takushio2525/2026-hackathon-team23/docs/src/content/docs/intro/overview.md

---
title: プロジェクト概要
description: タクトーンの目的、構成、現在できること
---

## 一言でいうと

**指揮棒を振る速さでテンポを操作し、5台の楽器マイコンとPCで合奏するシステム**です。
音楽経験がなくても、指揮を振るという直感的な操作で演奏に参加できます。

## 現在の構成

- 指揮者 `node_01`：XIAO ESP32-S3 Sense + GY-521（MPU6050）
- 金管 `node_02〜05`：Arduino UNO R4 WiFi × 4
- ドラム `node_06`：Arduino UNO R4 WiFi × 1
- PCアプリ：Processing 4 + Minim
- 曲：かえるのうた（32拍）を4声で輪唱、ドラムは56拍の全サイクルを担当

## できること

1. IMUの向きに依存しにくい拍検出
2. 指揮の拍間隔からBPMを推定し、演奏速度へ反映
3. UDPマルチキャストとマスタ時刻指定による同期演奏
4. 自由演奏と、100 BPMを維持して得点を競うゲームモード
5. 倍音JSONを使った金管の加算合成と、専用ドラム合成
6. 指揮者の状態に追従するメニュー・演奏・結果画面

## 評価と現在地

目標は、楽器間の発音タイミング差を20 ms以内に抑えることです。最終構成では中央値 **7 ms**、平均 **10.8 ms** を確認しました。一方で、デバイス内部の周期的な停止と見られるまれな外れ値（最大65 ms）も確認しています。

通信は「生の遅延が短いか」ではなく、**予約した発音時刻までに届くか**で評価します。予約に間に合わない受信は、対策前の45.4%から最終構成では3.1%まで減りました。詳しい数値と限界は[評価・検証](/guide/verification/)にまとめています。

## 次に読む

- 操作の流れ：[演奏体験と状態遷移](/system/experience/)
- 技術構成：[システム全体](/system/overview/)
- 実際に動かす：[クイックスタート](/intro/quickstart/)
