takushio2525/2026-hackathon-team23/work/shiozawa/work-0422/design_draft/sections/14_limitations.md

# 14. 制限事項・今後の課題

## 14.1 本原案で未確定の項目

実機検証を経ないと値を固定できない項目は、設計書上では「候補 + 推奨 + 初期値」で記し、
実装フェーズで確定させる。確定作業は対応するタスク（第 7.2 章）で実施する。

| 項目 | 初期値 | 確定タイミング | 担当 |
|---|---|---|---|
| IMU サンプリング周波数 | 200 Hz | TP-6 後 | 塩澤 |
| LPF カットオフ（α） | 0.1 | TP-1 前の実機キャリブレーション | 塩澤 |
| 拍検出閾値（g） | 1.8 g | TP-1 | 塩澤 |
| 拍不応期（ms） | 250 ms | TP-1 | 塩澤 |
| BPM EMA α | 0.3 | TP-4 | 塩澤 |
| CTRL 送信周期 | 50 ms (20 Hz) | TP-2, TP-6 | 塩澤 |
| BEAT 冗長化数 | 1（初期） | TP-5 | 塩澤 |
| SelfRun 発動タイムアウト | 1500 ms | TP-5 | 塩澤 |
| WiFi AP（SSID/PASS） | プレースホルダ | 運用フェーズ（チーム合意） | チーム |
| 楽譜データ（具体的内容） | 未作成 | 曲選定後（チーム合意） | チーム |
| PC の IP アドレス | プレースホルダ | 実機合わせ | 塩澤 + 梅澤 |

## 14.2 既知のリスク

| # | リスク | 影響 | 緩和策 |
|---|---|---|---|
| L-1 | IMU 装着方向のばらつきで拍検出が不安定 | 拍検出精度低下 | ノルム方式採用で方向依存を減らす（11.5）。Calibrating 状態で重力方向を学習する拡張余地を残す |
| L-2 | WiFi AP の干渉で遅延増大 | 同期誤差悪化 | 演奏時は 2.4 GHz 帯の干渉の少ない運用を検討。静的 IP オプションも用意（10.3.1） |
| L-3 | パケロス率が想定超過 | 演奏破綻 | BEAT 冗長送信 + SelfRun 自走で救う（10.3.7, 12.4） |
| L-4 | 内蔵 IMU の熱ドリフト | 長時間演奏で閾値ずれ | 演奏は 5 分程度を想定。長時間運用は本プロジェクト対象外 |
| L-5 | UNO R4 WiFi の `WiFiS3` ライブラリ仕様変更 | ビルド失敗 | PlatformIO のバージョンを `firmware/README.md` に固定明記 |
| L-6 | 4 ノード同時結合の環境が揃うまでの試験遅延 | M5 遅延 | T12 / T15 の段階で単体・ペアを先行検証し、リスクを前倒しで潰す |

## 14.3 本設計書のスコープ外 / 今後検討

- **Processing 側の音色合成**（梅澤担当）— NOTE パケット仕様のみ本書で規定
- **楽譜の編曲・選定** — チーム共同で Week 4 までに決定
- **エンタメ要素（LED・指揮棒装飾等）** — 必達機能完了後にチームで検討
- **発表・デモ台本** — 本設計書のスコープ外
- **事後課題（成果報告書）** — プロジェクト終了時に別途作成
