takushio2525/2026-hackathon-team23/meetings/0422_2回/第2回議事録_AI要約byClaude.md

# 第2回ハッカソン議事録 AI要約（Claude 生成）

> **このファイルについて**
> このドキュメントは AI（Claude）が正規議事録 PDF（`23_第2回議事録_24G1075.pdf`）と
> 同ディレクトリの `memo` ファイルを読み込み，内容を解釈して再構成した **要約・補足ドキュメント** です．
> 正規の議事録は PDF 側を参照してください．
> 抜けている決定事項があれば，議事録を直接書き直さず `docs/decisions/` に ADR として残す運用です
> （`meetings/README.md` 参照）．

## 基本情報

- **会議名**: 第2回ハッカソン
- **チーム**: 23班
- **日付**: 2026年4月22日（火）12:00 – 14:00
- **場所**: 7 号館 3 階 732 教室
- **目的**: **案の一本化**
- **記録者**: 地曵 賢人
- **出席者**: 全員出席
  - 24G1038 片岡 聖
  - 24G1075 地曵 賢人
  - 24G1131 御代川 稜
  - 25G1021 梅澤 颯太
  - 25G1053 齋藤 翔太
  - 25G1065 塩澤 匠生

## 会議の位置づけ（AI 解釈）

第1回で「Arduino 5 台で指揮者 + 楽器」という大枠を決めた後，**各メンバーが事前課題として具体案を持ち寄り**，
本会議でそれらを突き合わせて **一本の方針に統合する** ことがゴール．
最終的に以下が確定した：

1. **構成の確定**：指揮棒 + 楽器
2. **エンタメ性の確定**：指揮を振る体験を主軸に置く
3. **目的・ゴールの言語化**：外的要因によらず音楽未経験でも演奏できる
4. **成果物範囲の明確化**：エッジ検出 + UDP 拍送信，同期誤差 20 ms 以内
5. **MOE（有効性指標）の設定**：同期誤差 20 ms 以内 / 音階の正確性
6. **WBS 原案の整理**：担当者を 100 系（入力）/ 200 系（出力）/ 300 系（通信）に分解

---

## 1. 事前課題の共有と構成の確定

各メンバーが持ち寄った「基本構造案」を並べて議論．

### 1-1. 基本構造（持ち寄り案）

| 提案者 | 提案内容 |
|---|---|
| 御代川 | LED マトリクスで音階を表示 |
| 片岡・梅澤・齋藤 | 速度センサを用いた指揮者システム |
| 地曵 | 有線通信 |
| 塩澤 | 1 台指揮棒 + 4 台楽器の構成で IMU でエッジ検出，UDP 通信で同期 |

**→ 決定**: **「指揮棒 + 楽器」の構成で確定**
（= 塩澤案をベースに，他メンバーのアイデアを肉付けしていく方向）

### 1-2. エンターテイメント性

| 提案者 | 提案内容 |
|---|---|
| 塩澤 | ゲーム性を持たせる（例：テンポキープでスコア獲得） |
| 塩澤 | 演奏モードとゲームモードの切り替え |
| 御代川 | 指揮棒を LED 発光させる（加速度で光度の強弱） |

**→ 決定**: **「指揮を振る体験」を主なエンタメ性として据える**．
（ゲームモード等の発展は主軸の上に乗せる拡張として扱う）

---

## 2. 目的とゴールの決定

### 2-1. 目的（Purpose）

各メンバーの言い分を集約：

| 提案者 | 提案した目的 |
|---|---|
| 塩澤 | 演奏に人間が介入する |
| 地曵 | 音楽経験の有無に関係なく容易に演奏（テンポ変更やボリューム増減）できる |
| 梅澤・齋藤 | 時間帯や外音などに作用されず安定して演奏できる |
| 片岡 | 場所にとらわれず，音楽未経験でも演奏できる |

**→ 集約された目的**:
**「外的要因に作用されず，機器さえあれば（音楽未経験でも）演奏できること」**

> 💡 AI 補足: `memo` ファイルには「時間帯や天候やネットワークなどのネット環境がなくても → 明るさなどの条件がいらない」
> という書き込みがあり，**照明条件やネット環境に依存しない設計**が重視されている．
> これは **カメラベースの画像認識を使わない（= IMU ベースにする）** 判断の根拠になっている．

### 2-2. ゴール（Goal）

- ユーザーが指揮を振る**テンポを変えた時に演奏速度も変えられる**，簡単に演奏できること．
- 塩澤の補足：**指揮の振り方が乱雑（どんなモーション）でもテンポを検出できる**．
  **誤差 20 ms 以内なら同期できているとする**．

---

## 3. 成果物の範囲の明確化

プロジェクトの**スコープ定義**．以下 4 点に絞る：

1. **マイコンを振ってエッジ検出**し，**WiFi（UDP）で拍を送信**する．
2. **同期誤差 20 ms 以内**を満たす．
3. **倍音データ**などを元に**根拠を持った音色作り**を行う．
4. **どの方向に振っても拍を検出可能**であること（振り方に依存しない）．

---

## 4. MOE（有効性指標）の設定

システムが目的を達成しているかを測る指標：

| # | MOE | 基準 |
|---|---|---|
| 1 | 同期誤差 | **20 ms 以内** |
| 2 | 音階の正確性 | （基準は今後詳細化） |

> 💡 AI 補足: `memo` には「ユーザーがテンポ変更したことが（システムに）認識されるか」
> 「どんな振り方でも自分の思いどおりになるか（→ 誰かに演奏してもらって感想をもらう）」といった
> **ユーザビリティ観点の検証方法**が示唆されている．V&V 定義の際に取り込みたい．

---

## 5. 次回までの実施内容（次回までの宿題）

- **各担当が，自分の担当箇所の基本設計・詳細設計の原案を作成する**．
- 参考にするのは会議内で共有された **表 1（WBS）**（下記）．

## 6. 次回実施予定

次回（第3回）でやること：

- **FBS, PBS, WBS, MOP, V&V, TPM, 役割分担**のチーム内確認 → 修正 → 確定
- **WBS と役割分担をもとにスケジュール作成**
- **基本設計と詳細設計のレビュー**

---

## 付録 A：WBS 原案（表1 の再掲）

| 時間的フェーズ | 番号 | 要素成果物 | 活動タスク | 担当 |
|---|---|---|---|---|
| **100 入力装置** | 110 | 回路 | 111 回路図の作成 | 齋藤 |
|  |  |  | 112 必要な機材購入 | 梅澤 |
|  |  |  | 113 指揮用と楽器用 Arduino の通信 | 塩澤 |
|  |  |  | 114 Mac と Arduino の通信 | 塩澤 |
|  | 120 | 指揮棒 | 121 加速度センサと Arduino の連携 | 梅澤 |
|  |  |  | 122 加速度のピーク検出 | 齋藤 |
|  |  |  | 123 指揮棒の作成 | 齋藤 |
| **200 出力装置** | 210 | スピーカー | 211 回路の作成 | 塩澤 |
|  |  |  | 212 音の作成 | 塩澤 |
|  |  |  | 213 Processing のコード作成 | 塩澤 |
|  | 220 | 指揮棒の先端 LED | 221 回路図の作成 | 梅澤 |
|  |  |  | 222 LED の入手 | 齋藤 |
|  |  |  | 223 光らせるコードの作成 | 塩澤 |
| **300 通信システム** | 310 | UDP の実装 | 311 コード作成 | 塩澤 |
|  |  |  | 312 UDP の環境テスト | 梅澤 |
|  |  |  | 313 データの送信確認 | 齋藤 |
|  |  |  | 314 遅延の計測 | 梅澤 |

> 💡 AI 観察: **片岡・地曵・御代川の WBS 上の明示的な担当タスクが無い**．
> 第1回で議事録ローテーション（御代川 → 地曵 → 片岡）が決まっていることから，
> 記録・進行管理側に寄っている可能性はあるが，**次回（設計レビュー回）で担当の空白を
> 埋める確認が必要**と思われる．

## 付録 B：図の概要

- **図 1 FBS 原案**: トップに「ハッカソン2」，その下に「Arduino オーケストラ」「指揮棒を振る速度に合わせて
  BPM を変更するシステム」．機能分解として「楽器（パーカッション・金管・木管）」「指揮棒（速度変更・音の大きさ）」
  「旋律（主旋律・リズム）」といった機能が並ぶ．
- **図 2 PBS 原案**: 「Arduino オーケストラ」配下に「出力装置」「入力装置」「通信システム」の 3 系統．
  出力装置 = Processing / スピーカー / LED / 音色作り / 楽譜，入力装置 = 指揮者 / 加速度センサ / 加速度の大きさ / ピークの周期，
  通信システム = 回路 / Arduino / WiFi / UDP．

---

## AI による総括

**第2回で決まった本プロジェクトの輪郭**は以下の 1 行にまとめられる：

> **「指揮棒（加速度センサ付き Arduino）を振ると，UDP で 4 台の楽器 Arduino に拍が送られ，
> 20 ms 以内の同期で BPM が追従するアンサンブル演奏システム」**

残る大きな論点（第3回に持ち越し）は：

1. **役割分担の空白**（片岡・地曵・御代川のタスク配置）
2. **音階の正確性 MOE の具体値**
3. **V&V 計画**（どうやって「どんな振り方でもテンポが取れる」を検証するか）
4. **FBS / PBS / WBS / MOP / TPM の最終版**
5. **全体スケジュール（ガント）の起票**
