takushio2525/2026-hackathon-team23/meetings/0429_3回/事前課題共有/review_mamezi_御代川稜.md

# レビュー: `mamezi_御代川稜.pdf`（ハッカソン 〜計画書と設計書〜）

**評価対象**: `mamezi_御代川稜.pdf`（14 ページ、Version x.x、2026-04-28）
**担当範囲**: WBS 表上では設計フェーズに直接の担当タスクは無い（24G 勢は「議事録持ち回りと 300 テストフェーズ以降の実機検証・発表準備に合流」と `meetings/0422_2回/wbs_table/wbs_table.md` で明記）。本書はその前提のもと、提出用計画書テンプレート（`work/shiozawa/work-0422/提出用計画書/plan_template.tex`）の章立てを丸ごとなぞった個人ドラフトとして提出されている
**評価基準**:
- マネジメント計画書: `references/lectures/ハッカソン２/マネジメント計画書-ルーブリック評価 (1).pdf`（§1〜§6）
- システム設計書: `references/lectures/ハッカソン２/システム設計書-ルーブリック評価 (1).pdf`（§7 で別途評価）
**レビュー作成日**: 2026-04-29

---

## 1. ルーブリック評価サマリ

本書はマネジメント計画書テンプレートの章番号（1.1 概要 / 1.2 スコープ / 1.3 作業計画 / 1.4 V&V / 1.5 資源調達 / 1.6 リスク管理）を **目次・章見出しまでは完全になぞっている** が、**1.1.1〜1.1.3 と参考文献以外、1.2〜1.6 の各節は章タイトルのみで本文が空** という骨格状態にある。第 2 章（基本設計）と第 3 章（詳細設計）は別途記述があるため、各ルーブリック項目の評価は「計画書の本文が空 → D」「設計書側で代替されている → C 救済」の混合になる。

| 評価項目 | 配点 | 評価 | 根拠 |
|---|---|---|---|
| プロジェクトの概要（題目・目的・独自性・参考文献） | 3 | **B (2)** | §1.1.1 題目「指揮用 Arduino から指揮をするオーケストラ」、§1.1.2 目的（外部条件に左右されず音楽未経験でも演奏できる、6 つの課題を箇条書き）、§1.1.3 既存技術（テルミン・Wii Music）と独自性（複数マイコンによる分散演奏）、参考文献 2 件まで揃う。ただし参考文献 [2] Wii Music は公式サイト URL のみで論拠としては薄い |
| 成果物の対象範囲と機能（成果物・対象範囲／非対象範囲・FBS・PBS・対応関係） | 3 | **C (1)** | §1.2.1〜§1.2.5 が **全て章タイトルのみで本文なし**。第2章 §2.1 に FBS 図、第3章 §3.1 に PBS 図と必要機材一覧（表 3.1）はあるが、計画書セクション §1.2 を参照すると空白。FBS と PBS の対応関係も明示なし |
| 作業計画と役割分担（WBS・8/80 ルール・アローダイアグラム・クリティカルパス・スケジュール） | 3 | **D (0)** | §1.3.1 WBS、§1.3.2 アローダイアグラムとクリティカルパス、§1.3.3 役割分担、§1.3.4 ガントチャート、いずれも章タイトルのみで本文なし |
| 検証と妥当性の確認（システム／結合／単体テスト・MOP・TPM） | 3 | **B (2)** | §1.4.1〜§1.4.7（MOE / MOP / システム・結合・単体テスト MOP / TPM）はすべて章タイトルのみだが、第3章 §3.3 で単体（入力／ロジック／出力モジュール別）・結合・タイマ制御・システムテストの方針が記述されている。MOP・TPM の定量値は皆無のため B 止まり |
| 実行可能性と客観性 | 3 | **D (0)** | §1.5 資源・調達管理、§1.6 リスク管理が章タイトルのみで本文なし。スケジュール記述もなく、必要機材表（§3.1 表 3.1）の調達主体・期限も未記述。実機 KXR94-2050 がアナログ出力（5V フルスケール）の問題点（後述）にも触れていない |
| **合計** | 15 | **5 / 15** | テンプレートの **骨格のみで中身が空** という典型的な「下書きの提出」状態。記述された §1.1 と第2章・第3章は B 相当だが、計画書の核（スコープ・WBS・V&V・リスク）が空白なので合計点は伸びない |

**総合評価**: 中位ランク（C〜B 境界）。提出用計画書テンプレートに沿った正しい章立てを採っている点は他の提出物より優れているが、**§1.2〜§1.6 の本文を一切埋めていない** ため、計画書としての主要な評価項目で得点できていない。第3回ミーティングで章タイトルだけ残っている節を埋めれば、合計 11〜12 / 15 まで上げる余地は十分にある。

---

## 2. 良かった点

### 2.1 マネジメント計画書テンプレートの章立てを完全に踏襲している

- 目次（p.3〜p.4）が **§1.1 概要 / §1.1.1 題目 / §1.1.2 目的 / §1.1.3 既存技術と独自性 / §1.2 スコープ / §1.2.1 成果物 / §1.2.2 対象範囲・非対象範囲 / §1.2.3 FBS / §1.2.4 PBS / §1.2.5 FBS と PBS の対応関係 / §1.3 作業計画 / §1.3.1 WBS / §1.3.2 アローダイアグラム / §1.3.3 役割分担 / §1.3.4 ガントチャート / §1.4 V&V / §1.4.1 MOE / §1.4.2〜§1.4.5 各層の MOP / §1.4.6〜§1.4.7 TPM / §1.5 資源・調達管理 / §1.6 リスク管理** と、ルーブリック 5 項目を網羅する正しい章立て。
- 他の事前課題（地曵 PDF / 片岡 PDF）はマネジメント計画書としての章立て自体が無く、本書の構成は最も計画書ルーブリックに対応している。中身を埋めれば最も高得点を狙える土台。

### 2.2 §1.1.2 プロジェクトの目的と課題列挙が具体的

- ADR-0007 の目的「外的要因に作用されず、機器さえあれば（音楽未経験でも）演奏できる」と整合した記述で、6 つの課題（指揮動作の正確検出 / リアルタイム反映 / 誤検出防止 / 経験不問の操作性 / 視覚的状態提示 / 環境非依存）に分解されている。
- 各課題に「なぜなら〜である」と理由付きで書かれている点は、ルーブリック A 要件「技術的・社会的課題が参考文献を交えて十分に記述されている」に近い水準。

### 2.3 §1.1.3 独自性の主張が成立している

- **「複数マイコンによる分散演奏と、身体動作によるリアルタイム指揮制御を両立するシステム」** という独自性の主張は、テルミン（単機・身体動作）／Wii Music（単機・コントローラ動作）と比較して立っており、論理的に矛盾がない。
- 既存技術 2 件（テルミン論文・Wii Music 公式）との対比軸も明示されている。

### 2.4 §3.2.1 関数設計のモジュール分割が EMA と整合

- §3.2.1 表「関数名 / 機能」の `SensorModule:update()` / `TempoModule:update()` / `NetworkModule:update()` / `SoundModule:update()` / `LedModule:update()` / `ModuleTimer:isReady()` / `setup()` / `loop()` という命名は、`firmware/common/lib/` の Embedded-Module-Architecture（ADR-0005）と整合。
- 「保守性・再利用性・役割分担の明確化を目的として、入力・ロジック・出力の 3 フェーズ構成でソフトウェアを設計する。各機能は独立したモジュールとして実装し、共有データを介して連携する。周期処理にはタイマ制御を用い、`delay()` によるブロッキング処理は行わない」（§3.2 冒頭）は、塩澤 PDF §1.2.4 / §2.4.1 と完全に同じ思想。

### 2.5 §3.3 テスト設計が階層化されている

- 単体テスト（§3.3.1）を入力・ロジック・出力の 3 モジュール別に分けて、それぞれにテスト方針（境界値・条件分岐網羅・形式とタイミング検証）を書いている。
- 結合テスト（§3.3.2）／タイマ制御テスト（§3.3.3）／システムテスト（§3.3.4）と階層も適切。`wbs_table.md` の 311-337 と直接マップできる粒度。

---

## 3. 改善・確認すべき点

### 3.1 【最重要】§1.2〜§1.6 の本文が全て空である

本書最大の問題。p.4 を見ると、§1.2 から §1.6 にかけて以下が **章タイトルだけで本文なし**:

- §1.2.1 成果物
- §1.2.2 プロジェクトの対象範囲と非対象範囲
- §1.2.3 機能分解構造 FBS
- §1.2.4 製品分解構造 PBS
- §1.2.5 FBS と PBS の対応関係
- §1.3.1 作業分解構造 WBS と管理番号
- §1.3.2 アローダイアグラムとクリティカルパス
- §1.3.3 役割分担
- §1.3.4 ガントチャート
- §1.4.1 プロジェクトの成果物に対する有効指標 MOE
- §1.4.2 有効指標 MOE に対応する性能指標 MOP
- §1.4.3 システムテストで評価する性能指標 MOP
- §1.4.4 結合テストで評価する性能指標 MOP
- §1.4.5 単体テストで評価する性能指標 MOP
- §1.4.6 プロジェクト中に監視する技術性能指標 TPM
- §1.4.7 プロジェクト中に監視する指標 TPM
- §1.5 資源・調達管理
- §1.6 リスク管理

これは **マネジメント計画書ルーブリック 5 項目のうち 3 項目（成果物の対象範囲・作業計画・実行可能性）の評価軸が事実上書かれていない** ことを意味する。第3回までに最低限以下を埋める必要がある:

| 節 | 埋めるべき内容（最小ライン） |
|---|---|
| §1.2.1 成果物 | リポジトリ / ファームウェア / 報告書 / デモ動画 など、提出物単位の列挙 |
| §1.2.2 対象範囲・非対象範囲 | ADR-0007 の「実装する範囲（4 項目）」をそのまま転記し、非対象（照明同期・スマホ連動など）を併記 |
| §1.2.3 FBS | §2.1 の FBS 図に機能 ID（F1〜）を付与して再掲 |
| §1.2.4 PBS | §3.1 の PBS 図に部品 ID を付与して再掲 |
| §1.2.5 FBS-PBS 対応 | F1 → どの PBS 部品で実現、の表 1 つ |
| §1.3.1 WBS | `meetings/0422_2回/wbs_table/wbs_table.md` の WBS 表をそのまま転記 |
| §1.3.2 アロー / クリティカルパス | 113 → 114-115-116-117 → 121-130 → 200 → 300 のような粗い依存図 1 つ |
| §1.3.3 役割分担 | 24G 勢（議事録 + 300 以降合流）／ 25G 勢（設計・実装）の表 |
| §1.3.4 ガントチャート | 4/15 〜 7 月末までの週単位の予定 |
| §1.4 V&V | ADR-0006 の MOE = 20 ms、塩澤 PDF §1.1.2 の MOP-1〜MOP-8、TP-1〜TP-7 を転記 |
| §1.5 資源・調達 | Arduino UNO R4 WiFi × 5 台、3 軸センサ、PC（Mac）、USB ケーブルの調達主体・期限 |
| §1.6 リスク | WiFi ジッタ・センサ精度・Mac × 4 台の手配難・課題曲未決の 4 つを最低限 |

### 3.2 【重要】参考文献 [2] Wii Music の論拠が弱い

- §1.1.3「Wii Music では、コントローラの動作から拍を検出し、音楽のテンポを制御している」と書かれているが、**Wii Music は実際にはテンポ検出ではなく振り動作のタイミングに合わせて事前に決められた音符を再生する仕組み** で、本書の指揮・テンポ追従とは挙動が異なる。
- 引用 [2] が公式サイト URL のみであることに加え、引用文の事実関係も精査されておらず、ルーブリック A 要件「参考文献を交えながら十分に記述」を満たしにくい。
- 学術論文側（[1] 川合・伊藤「非接触型電子楽器の開発を通じたサウンドデザイン」, 東京工科大学メディア学部, 先端芸術音楽創作学会会報 Vol.14 No.1 pp.14-19, 2022）は適切な引用形式。これに加えて Wii Music の代わりに以下のような既存研究を追加すると独自性の主張がさらに強くなる:
  - VirtualConductor（バーチャル指揮者システム）の論文
  - 加速度センサベースの拍検出に関する MIR 系論文
  - PTP / IEEE 1588 / NTP の時刻同期に関する文献

### 3.3 【重要】§3.1 必要機材表の KXR94-2050 が ADR と整合しない

- 表 3.1「必要機材一覧」で **「3 軸加速度センサ KXR94-2050、1 個」** と記述。
- KXR94-2050 は **アナログ出力（電源 5 V、出力レンジ 0.6V〜4.4V）** の加速度センサで、Arduino の ADC（10bit、0〜5V）に直結する想定。一方、塩澤 PDF §1.3.1 / §2.2 と既存議事録は **MPU6050（I2C 接続、±2g/±4g/±8g/±16g 切替、6 軸 IMU）** を採用している。
- KXR94-2050 を採用するなら以下のリスクを §1.6 に書く必要がある:
  1. **アナログ出力 → ADC 変換のノイズ**（MPU6050 の I2C デジタル出力より精度が劣る）
  2. **3 軸のみ**（角速度ジャイロが無いため、塩澤 PDF §2.4.2.4 の「強い振り検出」フォールバック条件が成立しない）
  3. **ADR-0003「指揮者は IMU でジェスチャ」** と整合させるなら 6 軸が望ましい
- 第3回で「センサは MPU6050 / KXR94-2050 のどちらを採用するか」の合意が必要。
- また数量「1 個」は指揮棒ノード 1 台分のみで、楽器ノード 4 台にはセンサ無し（楽器側は LED マトリクスのみ）という構成として正しいことを明示すべき。

### 3.4 §1.1.1 の題目がルーブリック A 要件にやや届かない

- 題目「**指揮用 Arduino から指揮をするオーケストラ**」は、課題（指揮）と技術（Arduino）と目的（オーケストラ）のキーワードを含んでいる点でルーブリック B 相当。
- ただし「指揮用 Arduino から指揮をする」が同じ語の繰り返しになっており、A 要件「過不足なく的確に表現した題目」としては冗長。
- 例: **「Arduino と加速度センサを用いた指揮ジェスチャによる分散電子オーケストラの実現」** のように、技術（Arduino + 加速度センサ）・課題（指揮ジェスチャ検出）・目的（分散電子オーケストラ）を 1 文で揃えるとルーブリック A に近づく。

### 3.5 §2.1 FBS 図が分解粒度として浅い

- §2.1 の FBS 図は 3 階層（最上位「指揮棒を振る速度に合わせて BPM を変更するシステム」 → 第 2 階層「演奏 / 指揮棒 / 旋律」 → 第 3 階層「金管楽器 / パーカッション / 木管楽器 / 速度変更 / 音の大きさ / 主旋律 / リズム」 → 第 4 階層「同じタイミング / 楽譜を元に演奏」）と分解されているが、以下の問題がある:
  - **「指揮棒」を入力インタフェースと位置づけながら、指揮棒の機能（拍検出・テンポ算出・送信）が分解されていない**
  - **「木管楽器」が登場するが、ADR-0004 / 塩澤 PDF / WBS では金管 + ドラム** で確定済み。木管は範囲外
  - 塩澤 PDF §1.1.1 の F1〜F5（指揮情報抽出 / 同期配信 / 楽譜進行 / 音色合成 / 共通基盤）と粒度が揃わない
- ルーブリック A 要件「FBS と PBS が機能と部品に適切な粒度で分解されており、対応関係が明確に示されている」を満たすには、**機能 ID（F1〜）と部品 ID を付与し、対応表 1 つで一覧化** すべき。

### 3.6 §3.1 PBS 図と FBS 図の対応関係が示されない

- §2.1 FBS 図と §3.1 PBS 図がそれぞれ独立しており、どの機能がどの部品で実現されるかの対応表（FBS-PBS 対応表）が無い。
- ルーブリック A 要件の核は「FBS と PBS の対応関係が明確」なので、表 1 行 = 1 機能の単純なマッピング表を §1.2.5 に追加するだけで C → B / B → A に上がる。

### 3.7 第3章 §3.3「テストの設計」と §1.4 V&V の重複・整合性

- §3.3 単体（入力・ロジック・出力）／結合／タイマ制御／システムの 4 階層は良いが、これらに **対応する MOP（合否基準の数値）が一切ない**。
- 例えば §3.3.4 システムテスト「最終的に実環境においてシステム全体の動作確認を行う。長時間の連続動作による安定性の確認や、入力異常などを想定した異常系テストを実施し、実運用に耐えうることを検証する」は **何分連続動作するか／何 % のパケロスを入れるか** の数値が無い。
- ADR-0006 の MOE = 20 ms、塩澤 PDF §1.1.2 の MOP-1〜MOP-8、`wbs_table.md` の TP-1〜TP-7 を §1.4 に転記すれば一気に B 評価以上になる。

### 3.8 §3.4 AI 利用について — 申告内容の粒度

- 「文章構成、頭の中のアイデアを箇条書きにし、その内容の要約、、や。や語尾の統一のために使用」という記述は、本リポジトリ `work/shiozawa/ai_declaration/` 配下のテンプレに沿って **どのモデル（ChatGPT / Claude）を、どの章のどの粒度の作業で利用したか** まで具体化する必要がある。「、や。の統一」と「文章構成」は介入度が大きく異なるので分けて記述する。

### 3.9 細かい指摘

- p.6 §2.3 状態遷移図 — 図 2.4 のキャプションが「**本プロジェクトのハードウェアの状態遷移図**」となっているが、図の中身はシーケンス図（加速度センサ → 指揮用 Arduino → 楽器用 Arduino → Processing の時系列）に見える。状態遷移とシーケンス図は別物なので、キャプションを「シーケンス図」に直すか、状態遷移図（Initialization / Sync / Ready / Playing / Stop など）を別途追加する。
- p.7 §3.1 「2.1 は本プロジェクトの PBS 図である」 — 図番号が 2.1 と書かれているが、実際の図番号は 3.1。番号誤記。
- p.8 §3.2.1 関数設計表 — `setup()` / `loop()` は Arduino 標準関数だが、`SensorModule:update()` 等の `:` は C++ 構文ではなく `::`（スコープ解決演算子）が正しい。`SensorModule::update()` に修正。
- 表紙の Version `x.x` は提出版なら `0.1` 等の確定値に。

---

## 4. リポジトリ資料との整合性

| 観点 | リポジトリ側 | 本書 | 整合 |
|---|---|---|---|
| プロジェクトの目的 | ADR-0007: 外的要因に作用されず音楽未経験でも演奏できる | §1.1.2 でほぼ同じ記述 | OK |
| 5 台構成 | ADR-0004 ✅ | §3.1 表 3.1 Arduino UNO R4 WiFi × 5 台 | OK |
| 24G 勢の担当範囲 | `wbs_table.md`「議事録 + 300 以降合流」 | 計画書全章を独自に書いた | △ 役割再定義が必要 |
| センサ | ADR-0003 / 塩澤 PDF: MPU6050（I2C・6 軸） | §3.1: KXR94-2050（アナログ・3 軸） | ❌ 不整合 |
| 通信 | ADR-0002 / 塩澤 PDF: UDP マルチキャスト | §2.2 ハードウェア構成図に WiFi 通信記載 / 詳細なし | △ |
| EMA 準拠 | ADR-0005 / `firmware/README.md` | §3.2 冒頭で 3 フェーズ構成 + タイマ制御を明記 | OK |
| §1.2 スコープ | 計画書テンプレ §1.2 を参照 | §1.2 全節タイトルのみ | ❌ 本文なし |
| §1.3 WBS / アロー / 役割 | `wbs_table.md` で詳細 | §1.3 全節タイトルのみ | ❌ 本文なし |
| §1.4 V&V | ADR-0006 MOE / 塩澤 PDF §1.1.2 MOP / WBS TP-1〜TP-7 | §1.4 全節タイトルのみ（§3.3 で部分代替） | ❌ 本文なし |
| §1.5 資源調達 | Mac × 4 台 構成議論中 | §1.5 タイトルのみ | ❌ 本文なし |
| §1.6 リスク | 個別 ADR で散在 | §1.6 タイトルのみ | ❌ 本文なし |

---

## 5. 推奨アクション（第3回ミーティングで決めたいこと）

1. **§1.2〜§1.6 の本文を埋める**（最優先）。表 §3.1 で示した最小ラインに沿って、リポジトリ既決の情報（`wbs_table.md` / ADR-0004〜0007 / 塩澤 PDF §1.1.2 MOP）を転記するだけで、空欄は解消する。これだけで合計 5 → 11〜12 / 15 まで上昇する見込み。
2. **センサの一本化**（MPU6050 / KXR94-2050）。リポジトリと整合させるなら MPU6050、BMI270（地曵 PDF）も含めて第3回で決定。
3. **FBS と PBS に機能 ID / 部品 ID を付与し、§1.2.5 に対応表を 1 枚追加**。これだけで「成果物の対象範囲と機能」が C → B に上がる。
4. **参考文献 [2] Wii Music を除外 or 補強**。事実関係を確認した上で残すか、より直接的な既存研究（PTP 同期や IMU ベースの拍検出）に差し替える。
5. **題目を A 評価相当に書き直す**。例: 「Arduino と加速度センサを用いた指揮ジェスチャによる分散電子オーケストラの実現」。
6. **§3.4 AI 利用申告を `work/shiozawa/ai_declaration/` のテンプレに沿って整形**。提出物としての形式整合性を確保。
7. **24G 勢としての役割再定義**：本書は計画書テンプレートの完全骨格を引いているため、地曵 PDF・片岡 PDF と比べてマネジメント計画書の取りまとめ役（§1.1〜§1.6 を完成させる役割）が最も合いそう。第3回で「マネジメント計画書の編纂は御代川担当」と握れば、本書は完成すれば計画書本体としてそのまま使える。

---

## 6. 総合所見

提出用計画書テンプレートの **章立てを過不足なく踏襲している** 点で、3 つの 24G 勢提出物の中では最もマネジメント計画書ルーブリックに正しく対応している。中身が埋まれば、合計 11〜12 / 15 と十分に B 以上の評価が見込める。

ただし、本書最大の問題は **§1.2〜§1.6 の本文がほぼ全節で空** であること。これは「下書きの章立て骨格を提出した状態」に近く、ルーブリックの「成果物の対象範囲」「作業計画」「実行可能性」3 項目で得点できていない。第 2 章・第 3 章で部分的に補えている内容はあるものの、計画書の核（スコープ・WBS・V&V・リスク）が章タイトルのみという状態は、評価対象としては D 寄りになる。

幸いなことに、空欄を埋める材料はリポジトリにすべて揃っている（`wbs_table.md` / ADR-0004〜0007 / 塩澤 PDF §1.1.2 / `meetings/0422_2回/第2回議事録_AI要約byClaude.md` 等）。第3回までに転記＋整合作業を行うだけで本書は計画書本体として機能する。本書を **チームの計画書本体（v0.1）の母版** として位置づけ、御代川を「マネジメント計画書の編纂責任者」とする運用に倒すのが、本書の構造を最も活かす道筋になる。

---

## 7. システム設計書ルーブリック評価（追加軸）

§1 はマネジメント計画書ルーブリック軸での評価だが、本書は **第 2 章「システムの基本設計」と第 3 章「システムの詳細設計」を含むハイブリッド構成** であるため、システム設計書ルーブリック（5 項目 × 2 点 = 10 点）でも評価する。

### 7.1 評価サマリ

| 評価項目 | 配点 | 評価 | 根拠 |
|---|---|---|---|
| 基本設計: 機能一覧とシステム構成図 | 2 | **C (1)** | §2.1 機能一覧で FBS 図（図 2.1）と本文記述あり。「演奏／指揮棒／旋律」の 3 系統に分け、各下位要素（パーカッション／金管／**木管**／速度変更／音の大きさ／主旋律／リズム）を 1〜2 文で説明。§2.2 システム構成図に図 2.2「ソフトウェアの構成図」と図 2.3「ハードウェアの構成図」の 2 枚あり。一方、**(1) 機能 ID の付与なし、FBS-PBS 対応関係（§1.2.5 が空）なし、(2) 「木管楽器」が ADR-0004 / 塩澤 PDF（金管 + ドラムで確定）と不整合、(3) 図 2.2 のキャプションが「ソフトウェア構成図」だが中身は加速度センサ→指揮棒 Arduino → 楽器 Arduino × 4 → Processing のハードウェア寄りブロック図で、図 2.3 と機能的に重複**。ルーブリック C「機能一覧と簡単な説明文はあるが、多々記載漏れがあり理解が困難、構成図と構成要素の関係も不明瞭」に該当 |
| 基本設計: 操作インターフェースと状態遷移 | 2 | **C (0)** | スイッチ・LED 表示・GUI などの **ユーザインタフェース構成の記述が無い**（部品表の「スピーカー 1 個」のみ）。§2.3「状態遷移図」と称した図 2.4 の実体は **シーケンス図**（加速度センサ → 指揮棒 Arduino → 楽器 Arduino → Processing の時系列メッセージ交換、「スタートメッセージの送信」「演奏開始」「エンドメッセージの送信」「演奏終了」のみ）。Initialization / Sync / Ready / Playing / Stop のような状態定義と遷移条件が無い。図のキャプションも「ハードウェアの状態遷移図」となっており、状態遷移とシーケンス図を混同している。ルーブリック C「ユーザインタフェースが記載されているが記載漏れがあり理解困難、状態遷移も理解困難」に該当 |
| 詳細設計: ハードウェア設計 | 2 | **C (1)** | §3.1 部品一覧（表 3.1）で **型番付き**（Arduino UNO R4 WiFi `ABX00087`×5、3 軸加速度センサ `KXR94-2050`×1、8Ω 1W 丸形スピーカ `20-A GB`×1、USB Type-C 1.0m×4、Mac×1）に列挙されている点は丁寧。一方、**(1) 回路図・ピンアサイン・電源系統・信号レベル（KXR94-2050 のアナログ出力電圧範囲 0.6〜4.4 V）の記述なし、(2) センサと Arduino の接続方法（ADC ピン番号・サンプリング周波数）が未定義、(3) センサが KXR94-2050（アナログ・3 軸）でリポジトリの MPU6050（I2C・6 軸）採用方針と不整合、(4) 数量「1 個」が指揮棒ノード 1 台分のみで、楽器 4 ノードは何も持たない構成として正しいかが書かれていない**。ルーブリック C「部品の一部記載漏れ、回路図も不明確、接続関係や動作も一部不明確」に該当 |
| 詳細設計: ソフトウェア設計 | 2 | **C (1)** | §3.2 で「入力・ロジック・出力の 3 フェーズ構成、共有データ介在、タイマ制御、`delay()` 不使用」の方針が明示され、EMA（ADR-0005）と整合。§3.2.1 で 8 つのモジュール関数（`setup()` / `loop()` / `SensorModule:update()` / `TempoModule:update()` / `NetworkModule:update()` / `SoundModule:update()` / `LedModule:update()` / `ModuleTimer:isReady()`）が表形式で列挙され、各 1 行で機能を説明。一方、**(1) クラス図なし、(2) 関数の引数・戻り値型なし、(3) モジュール間で共有されるデータ構造（共有データ）の仕様が未定義、(4) 状態管理オブジェクトの設計なし、(5) `:` 表記が C++ の `::`（スコープ解決演算子）と不整合**。ルーブリック C「実装に必要な設計が抽象的あるいは記載不足により不十分、実装が困難」に該当 |
| 詳細設計: 処理フローの設計 | 2 | **C (0)** | §3.2 冒頭で「`loop()` 内で入力 → 処理 → 出力の繰り返し実行」「タイマ制御で周期処理」の **方針記述 1 段落のみ**。具体的な処理フロー（センサ値取得 → BPM 算出 → UDP 送信 → 受信 → 発音までの一連の動作、データの受け渡し）が時系列で書かれていない。条件分岐（演奏中／同期失敗時／異常入力時）と例外処理の記述なし。構成要素同士（Arduino 間／Arduino-PC 間）の接続方法は §2.2 のブロック図レベル止まり。§3.3 のテスト設計（単体／結合／タイマ制御／システム）は階層化されているが「処理フロー」とは別物。ルーブリック C〜D 境界。「簡素で条件分岐や処理内容の詳細が不明、構成要素同士の接続方法が不明瞭」に該当 |
| **合計** | 10 | **3 / 10** | 中位〜下位ランク。テンプレート骨格（FBS 図／PBS 図／関数設計表／テスト階層）はあるが、各図表の中身が浅く、図のキャプションと内容が一致しないケアレスミスや、シーケンス図を状態遷移図として提示する根本的な誤りがある |

### 7.2 マネジメント計画書評価との比較

- **マネジメント計画書ルーブリック**: 5 / 15（§1 参照）— テンプレート骨格は最良だが §1.2〜§1.6 が空欄
- **システム設計書ルーブリック**: **3 / 10** — 図表は揃うが中身が浅い

両軸ともに「**形式・骨格は揃うが、各節の中身が薄い**」という共通の弱点が出ている。本書は計画書テンプレートと設計書テンプレートの両方を踏襲しようとして **どちらも本文が浅くなっている** 状態。

### 7.3 システム設計書としての伸ばしどころ

現状 3 / 10 を 6 / 10 以上に引き上げるための具体的アクション:

1. **基本設計: 機能一覧 C → B**（+1）
   - FBS 図に **機能 ID（F1〜）** を付与し、§1.2.5（現状空欄）に FBS-PBS 対応表を追加
   - 「木管楽器」を削除し、ADR-0004 と整合する金管 + ドラム構成に修正
   - 図 2.2 のキャプションを実体（ハード構成図）に合わせる、または中身を本来のソフトウェア構成（モジュール構成・通信スタック）に書き換える
2. **基本設計: 操作インタフェース C → B**（+1）
   - §2.3 を **シーケンス図はそのままで残す** + 状態遷移図（Initialization → Sync → Ready → Playing → Stop の 5 状態と遷移条件）を **別図で追加**
   - 指揮棒の物理ボタン・LED 表示・PC 画面 GUI のユーザ入出力を §2.2 後段に追記
3. **詳細設計: ハードウェア設計 C → B**（+1）
   - センサを **MPU6050** に統一（リポジトリ整合）、ピンアサイン表（VCC/GND/SCL/SDA/INT）を 1 枚追加
   - 楽器ノード 4 台分の構成（センサなし、LED マトリクスのみ）を表 3.1 に明示
4. **詳細設計: ソフトウェア設計 C → B**（+1）
   - 関数の **引数・戻り値型** を §3.2.1 表に追加（地曵 PDF §2.3.3 の粒度に合わせる）
   - モジュール間の共有データ構造（例: `struct SharedState { float bpm; uint64_t t_exec; ... }`）を 1 つ定義
   - クラス図（`SensorModule` → `TempoModule` → `NetworkModule` → `SoundModule` の依存関係）を 1 枚追加
5. **詳細設計: 処理フロー C → B**（+1）
   - §3.2 末尾に処理フロー図を 1 枚追加（地曵 PDF §2.4 の 3 フローを参考に：時刻同期／テンポ制御／予約実行）
   - 条件分岐（同期失敗時 → Sync-Loss 状態へフォールバック等）を文章で 1 段落追加

これらに対応すれば、システム設計書としては **6〜7 / 10** まで上がる余地がある。御代川 PDF が「マネジメント計画書本体の母版」と「システム設計書テンプレートの骨格」を両方持つ強みを活かすなら、**設計書部分は地曵 PDF（B 中心）と統合し、御代川自身は計画書側（§1.1〜§1.6）の編纂に注力する分業** が現実的。
