takushio2525/2026-hackathon-team23/work/shiozawa/01_0421/main.tex

\documentclass[a4paper,12pt,oneside]{jex}

\renewcommand{\baselinestretch}{1.1}
\setlength{\textwidth}{16cm}
\setlength{\textheight}{24cm}
\setlength{\evensidemargin}{0cm}
\setlength{\oddsidemargin}{0cm}
\setlength{\topmargin}{-1.0cm}

\usepackage[dvipdfmx]{graphicx}
\usepackage[dvipdfmx]{xcolor}
\usepackage[cmex10]{amsmath}
\usepackage[deluxe]{otf}
\usepackage{ascmac}
\usepackage{url}

\pagestyle{headings}

\title{
  \bfseries\vskip30pt
  ハッカソン1 事前課題\\
  \Large Arduino オーケストラにおける\\
  指揮者マイコンによるジェスチャ認識\\
  \vspace{1cm}
}

\author{
  \\
  千葉工業大学 情報変革科学部 情報工学科\\
  \\
  \vspace{.5cm}
}

\date{
  \bfseries\Large\vskip10pt
  {\hspace{2cm}}班{\hspace{0.5em}}番{\hspace{0.5em}}号 \underline{\makebox[8cm][c]{第 23 班}} \vskip50pt
  {\hspace{2cm}}学番・氏名 \underline{\makebox[8cm][c]{25G1065塩澤 匠生}} \vskip50pt
  {\hspace{2cm}}提\hspace{2em}出 \underline{\makebox[8cm][c]{2026 年 4 月 21 日}}
}

\begin{document}
\maketitle
\thispagestyle{empty}
\setcounter{tocdepth}{2}
\tableofcontents
\newpage

\pagenumbering{arabic}

\input{sections/01_introduction}
\input{sections/02_proposal}

\bibliographystyle{jplain}
\bibliography{refs}

\end{document}
