takushio2525/2026-hackathon-team23/docs/src/content/docs/index.md

---
title: タクトーン
description: IMUジェスチャーで演奏するArduinoオーケストラの現行仕様書
template: splash
hero:
  tagline: 指揮棒を振ると、5台の楽器マイコンとPCが同期して「かえるのうた」を演奏する。
  actions:
    - text: 発表の要点を見る
      link: /presentation/overview/
      icon: right-arrow
      variant: primary
    - text: 現行仕様を見る
      link: /system/overview/
      icon: right-arrow
      variant: minimal
    - text: 動かしてみる
      link: /intro/quickstart/
      icon: rocket
---

## このサイトについて

千葉工業大学ハッカソン・チーム23の作品 **タクトーン** の仕様と開発手順をまとめたサイトです。
記述対象は現在の本番版である `firmware/production/` と `pc_app/production/` です。

```mermaid
flowchart LR
    C[指揮者<br/>XIAO ESP32-S3 + IMU]
    I[楽器5台<br/>Arduino UNO R4 WiFi]
    P[Processing]
    S[スピーカー]
    C -- CTRL / BEAT<br/>UDP --> I
    I -- NOTE / UI<br/>USB Serial --> P
    P --> S
```

## 迷ったらここから

| 目的 | 読むページ |
|---|---|
| 何を作ったか知る | [プロジェクト概要](/intro/overview/) |
| 成果発表の説明を準備する | [発表の要点](/presentation/overview/) |
| システム全体を理解する | [現行システム](/system/overview/) |
| 実機を動かす | [クイックスタート](/intro/quickstart/) |
| コードを変更する | [開発ガイド](/guide/setup/) |
| 旧版との差を確認する | [バージョン変遷](/history/versions/) |

:::caution[仕様の基準]
このサイト内で食い違いが見つかった場合は、productionのヘッダー・設定・実装コードを優先してください。
ADRは「当時なぜ決めたか」を残す履歴なので、現在の実装と異なる場合があります。
:::
