takushio2525/2026-hackathon-team23/work/shiozawa/01_0421/sections/01_introduction.tex

\section{はじめに}
\label{sec:introduction}

\subsection{社会的背景}
\label{subsec:social_background}

マイコンや組込み機器を用いた合奏，いわゆる「Arduino オーケストラ」のようなシステムでは，複数ノードを機械的に同期させること自体は既存の自動演奏や打ち込み再生で容易に実現できる．しかし，あらかじめ用意したシーケンスを複数台が再生するだけの構成では，演奏中に人間が介入する余地がほとんど残らず，観客にとっても演者にとっても合奏本来の面白さが失われやすい．

合奏が持つ本質的な楽しさは，「自分の身体動作に対して周囲の音が応答する」という双方向性にある．指揮者の動きに奏者が合わせ，奏者同士が互いの音を聴いて微調整する過程こそが合奏体験の中心であり，単純な同期再生ではこの能動的な関与を再現できない．Arduino オーケストラにおいても同様に，機械的な同期の正確さと，人間がリアルタイムに介入できる面白さを両立させる枠組みが求められる．

\subsection{技術的背景}
\label{subsec:technical_background}

近年は，Arduino UNO R4 WiFi~\cite{arduino_uno_r4} に代表されるように，IMU や無線通信を標準搭載したマイコンが安価に入手できる．搭載 IMU としては LSM6DSOX~\cite{lsm6dsox} のような 6 軸センサが一般化しており，加速度・角速度情報から指揮棒の動きのような身体動作を推定することも現実的になっている．このような環境は，個人やハッカソン規模でもマイコンを複数台用いた分散演奏システムを構築できる土台になっている．

一方，合奏においては音のズレに対する人間の知覚が鋭く，アンサンブル精度を保つためには複数ノード間の拍のズレを小さく抑える必要がある．複数のマイコンを束ねて同時に同じ拍で鳴らすには，センサ入力，拍検出，通信の各段階を通じて低遅延かつ同時配信可能な伝送路を確保する必要があり，マイコン側の計算能力だけでなくネットワーク構成の選択が重要になる．

\subsection{既存のシステム}
\label{subsec:existing_systems}

身体動作で合奏を指揮するシステムとしては，家庭用ゲーム機向けの Wii Music~\cite{nintendo_wiimusic} が代表的である．これはコントローラの動作から拍を抽出し，ゲーム機内部の音源のテンポを制御する．同様にコントローラや画像入力から指揮動作を認識するアプリケーションや研究事例はいくつか存在するが，いずれも音の生成は 1 台のホスト機（PC・ゲーム機・スマートフォン）に閉じており，複数の物理ノードに音を分散して鳴らす構成ではない．

他方，マイコンを複数台ネットワーク接続して音を分散出力する作例も見られるが，これらの多くは事前に用意したシーケンスを再生することが中心で，演奏中にリアルタイムで人間が介入する用途を主眼としていない．

以上から，複数マイコンで物理的に音を分散する構成と，リアルタイムに人間が介入できる仕組みを同時に満たす既存例は乏しく，この両立が本テーマの独自性を生む余地となる．

\subsection{問題点}
\label{subsec:problems}

前節の既存システムを踏まえると，複数マイコンの同時演奏を人間の指揮動作で駆動するためには，1 台の指揮ノードから複数の楽器ノードへ拍情報を低遅延かつ同時に配信する手段が鍵となる．しかしマイコンで利用しやすい通信方式には，それぞれ次のような制約がある．

\begin{itemize}
  \item \textbf{CAN}: 同期性に優れるが，各ノードに専用トランシーバ IC と配線が必要で，ハードウェア規模と可搬性に難がある
  \item \textbf{有線シリアル / I2C}: ノード数が増えると 1 対多の配線が煩雑になり，ステージ上での設置性が落ちる
  \item \textbf{Bluetooth Classic / BLE}: 基本が 1 対 1 接続のため，1 台の指揮ノードから複数の楽器ノードへ同時配信する用途には向かない
\end{itemize}

これらに対し，Arduino UNO R4 WiFi~\cite{arduino_uno_r4} は ESP32-S3 を無線コプロセッサとして搭載しており，追加部品ゼロで WiFi に接続できる．WiFi 上で UDP ブロードキャストを用いれば，1 台の送信元から同一サブネット上の全楽器ノードへ単一パケットで同時に拍情報を配信でき，低遅延と 1 対多配信の両立が可能である．したがって本課題では，複数マイコン合奏における 1 対多の低遅延配信を中心課題に据え，WiFi/UDP ブロードキャストを採用する方針を取る．

\subsection{目的}
\label{subsec:purpose}

本稿の目的は，Arduino オーケストラにおいて，演奏の楽しさ（人間による介入の余地）と，複数マイコン間の完全な同期（機械的な拍合わせ）を両立する合奏システムを提案することである．具体的には，指揮者の身体動作をセンサで取り込み，その拍情報を複数の楽器マイコンに同時配信することで，演奏中に指揮者の動きが全体に即時に反映される構成を目指す．

\subsection{主張}
\label{subsec:claim}

我々は，Arduino オーケストラを「指揮者マイコン 1 台と楽器マイコン複数台の 2 層構成」で設計することを主張する．指揮者マイコンは内蔵 IMU で指揮棒の動きを取得して拍・テンポを推定し，WiFi 上の UDP ブロードキャストで楽器マイコン群へ同時配信する．楽器マイコンは受信した拍情報に従って音符を生成・出力する．

この役割分離により，人間による介入は指揮者マイコンが，完全な同期は楽器マイコン群が担う形で実装を分離でき，両者を同時に満たす合奏体験を構築できると考える．
