takushio2525/2026-hackathon-team23/docs/src/content/docs/decisions/0003-conductor-imu.md

---
title: ADR-0003 指揮者マイコンに IMU を搭載しジェスチャで演奏を制御
description: IMUの振り検出で演奏を制御する方針を採用した記録
sidebar:
  order: 3
---

**ステータス**: Accepted
**決定日**: 2026-04-15（第1回ミーティング）
**関連議事録**: リポジトリ内 `meetings/0415_1回/23_第1回議事録_24G1131-1776302030881.pdf` / `meetings/0415_1回/第1回議事録_AI要約byClaude.md`
**補足**: 第2回ミーティング（2026-04-22）で「どの方向に振っても拍を検出可能」「振り方が乱雑でもテンポを検出可能」が成果物範囲として追加確認された（`meetings/0422_2回/第2回議事録_AI要約byClaude.md`）

:::note[現在の実装]
初期案の「Arduino UNO R4 WiFi内蔵IMU」から、**XIAO ESP32-S3 Sense + 外付けGY-521（MPU6050）**へ変更した。
IMUジェスチャで制御するという決定自体は継続している。現行構成は[ハードウェア構成](/system/hardware/)を参照。
:::

## 背景

授業資料で同期の取り方の独創性が評価軸として示されており、ジェスチャ同期は
その一例として明示されている。第1回ミーティングでは塩澤が指揮者 Arduino を
担当し、指揮によってテンポが可変になる方針まで合意していた。

## 決定事項

指揮者マイコン（Arduino UNO R4 WiFi）の **内蔵 IMU** を使い、指揮の動きを
ジェスチャとして取り込んで演奏制御情報に変換する。

具体的な写像アルゴリズム・信号処理・校正手順は、実装フェーズで
[演奏体験と状態遷移](/system/experience/) および [システム全体](/system/overview/) に落とす。

## 理由

- 授業例示の「ジェスチャ同期」に直結する独創性がある
- 振りの大きさ・速さ・細かな振動を使えば、テンポ／強弱／ビブラートといった
  複数の演奏表現を1つの入力デバイスで取れる
- 本体内蔵のため外付け回路が不要で、実装コストが低い
- 評価軸の「エンターテインメント性」にも寄与する

## 代替案と比較

| 案 | 採否 | 理由 |
|---|---|---|
| IMU ジェスチャ | ✅ 採用 | 独創性・表現幅・実装容易 |
| LED 点滅 + 光センサ | ❌ 不採用 | 独創性が弱い・環境光に左右される |
| リズム楽器音で同期 | ❌ 不採用 | 金管構成と合わない |
| ボタン＋つまみ | ❌ 不採用 | 指揮者らしさが出ない |

## 結果・影響

- **ポジティブ**: 独創性・エンタメ性の評価で上振れを狙える
- **ネガティブ / リスク**: ジェスチャ認識の実装難度・誤認識による演奏破綻

## 再検討条件

- ジェスチャ誤認識が実用水準に収まらない場合、補助入力（ボタン等）を併用
