takushio2525/2026-hackathon-team23/docs/src/content/docs/decisions/0004-ensemble-structure.md

---
title: ADR-0004 合奏台数・楽器構成（指揮 1 ＋ 楽器 5）・金管四重奏＋ドラム・輪唱曲
description: ハードウェア台数・楽器構成・曲種・PC 音色合成の役割分担を決める
sidebar:
  order: 4
---

**ステータス**: Accepted（2026-05-21 改訂）
**決定日**: 2026-04-15（第1回ミーティング） / **改訂日**: 2026-05-21
**関連議事録**: リポジトリ内 `meetings/0415_1回/23_第1回議事録_24G1131-1776302030881.pdf` / `meetings/0415_1回/第1回議事録_AI要約byClaude.md`
**補足**: 第2回ミーティング（2026-04-22）で「指揮棒 + 楽器」の構成を正式に再確認（`meetings/0422_2回/23_第2回議事録_24G1075.pdf` / `meetings/0422_2回/第2回議事録_AI要約byClaude.md`）

:::note[現在の実装]
編成はこの改訂内容で実装済み。課題曲は**かえるのうた**、金管4声の開始差は0/8/16/24拍、
ドラムを含む全サイクルは56拍になっている。詳細は[楽譜と輪唱](/system/score/)を参照。
:::

## 背景

授業資料の制約：

- 人数分 − 1 の Arduino を使用する（本チームは 6 名 → 楽器用 Arduino 5 台）
- 各楽器で異なるパートを演奏する
- 最低でも主旋律 3 + リズム 1、輪唱曲を演奏する

## 決定事項

| 項目 | 決定内容 |
|---|---|
| ハードウェア台数 | 指揮者 XIAO ESP32-S3 Sense × **1 台** ＋ 楽器 Arduino UNO R4 WiFi × **5 台** |
| 役割分配 | **指揮者 × 1 + 楽器 × 5**（金管 4 ＋ ドラム 1） |
| 楽器の種類 | **金管楽器**（4 パート）と **ドラム**（1 パート） |
| 曲の種類 | **輪唱曲**（候補は次回決定） |
| 音声出力 | **Processing（PC）側** で音色合成・再生 |

## 理由

- 授業制約「人数分 − 1」に準拠（楽器用 UNO R4 を 5 台で満たす。指揮者は IMU を扱う XIAO ESP32-S3 を別枠で採用、ADR-0003 参照）
- 金管楽器 4 パートと輪唱（多声）の相性が良い
- 金管の倍音構造は他楽器群より Processing での合成が扱いやすい
- リズムを担うドラム 1 パートを加え、合奏に拍の芯を与える
- 音色生成を PC 側に寄せる構成は授業資料の前提と一致

## 未決事項（本 ADR の範囲外）

- 具体的な課題曲の選定
- 5 声の具体的な役割分担（どのマイコンがどの声部か）
- エンタメ要素（LED・可動装置等）の有無

## 結果・影響

- **ポジティブ**: 構成がシンプルで責務分離が明快
- **ネガティブ / リスク**:
  - 金管音色の合成クオリティが評価軸「楽器音らしさ」に直結
  - Processing 担当（梅澤）のタスク密度が上がる

## 改訂履歴

- **2026-04-15（初版）**: 5 台構成（指揮 1 ＋ 楽器 4）・金管四重奏。当初は指揮者・楽器とも Arduino UNO R4 WiFi を想定していた。
- **2026-05-21（改訂）**: 楽器を 5 台（金管 4 ＋ ドラム 1）へ拡張し、全体を 6 台構成とした。リズムを担うドラムを 1 パート追加したことによる。指揮者は IMU を扱う XIAO ESP32-S3 Sense を採用（ADR-0003）、楽器用 Arduino UNO R4 WiFi が授業制約「人数分 − 1 ＝ 5 台」をそのまま満たす形に整理した。中間発表に向けた計画書・設計書（`report/計画書_中間発表/`）の構成に合わせている。
