takushio2525/2026-hackathon-team23/work/shiozawa/work-0422/ai_declaration/HCK02_03/main.tex

\documentclass[a4paper,11pt,dvipdfmx]{jsarticle}

\usepackage[top=25mm,bottom=25mm,left=25mm,right=25mm]{geometry}
\usepackage{amssymb}
\usepackage{listings}
\usepackage{plistings}
\usepackage[dvipdfmx,hidelinks]{hyperref}

\lstset{
  basicstyle=\ttfamily\small,
  frame=single,
  breaklines=true,
  xleftmargin=1em,
  aboveskip=6pt, belowskip=6pt,
  columns=flexible,
}

\newcommand{\cboxon}{$\boxtimes$}
\newcommand{\cboxoff}{$\square$}

\begin{document}

{\LARGE\bfseries 生成AI利用申告書}
\vspace{1em}

\begin{itemize}
  \item 氏名：塩澤 匠生
  \item 学籍番号：25G1065
  \item プログラムファイル名：\texttt{HCK02\_03.ino} / \texttt{HCK02\_03.pde}
  \item 使用したAIツール：Claude Code (Opus 4.7)
\end{itemize}

\section*{1. 何に使ったか}
発展課題は，提出課題2 の Processing プログラムをベースに FFT を加えてスペクトルアナライザにする
課題である．Arduino 側 (\texttt{HCK02\_03.ino}) は提出課題2 の \texttt{HCK02\_02.ino} と
同じコードを流用したので，新たに書く必要があるのは Processing 側 (\texttt{HCK02\_03.pde})
のみだった．授業では Minim の \texttt{FFT} クラスの使い方は扱われていなかったため，
\texttt{HCK02\_02.pde} をベースに FFT スペクトル表示のコード生成を生成AIに依頼した．
最終的には時間波形の描画を削除し，周波数スペクトルのみを画面全体に表示する構成にした．

\section*{2. AIへの指示（プロンプト）}
\begin{lstlisting}
提出課題2 で書いた HCK02_02.pde（マイクの波形を Processing のウィンドウに
描画するプログラム）をベースに、FFT で周波数ごとの強さを
バーグラフで表示するスペクトルアナライザに拡張したいです。
- Arduino 側のコードは HCK02_02.ino をそのまま使うので、
  1 行 1 サンプル ADC 値 (0-1023) が送られてきます
- delayMicroseconds(100) なのでサンプリング周波数は約 5 kHz の想定
- 楽曲再生 (Minim) の部分はそのまま残してください
- 画面全体を使って FFT 結果のバーを表示してください
Minim の FFT クラスを使った、いちばんシンプルな書き方で書いてほしいです。
\end{lstlisting}

\section*{3. AIの出力の使い方}
\begin{itemize}
  \item \cboxoff そのまま使った
  \item \cboxon 一部修正して使った
  \item \cboxoff 参考にしただけ
\end{itemize}
$\rightarrow$ 上で選んだ理由：

提出課題2 の \texttt{HCK02\_02.pde} に対して，FFT 用バッファ・\texttt{fft.forward(...)}
の呼び出し・スペクトルバーの描画が追加された形で出てきた．最初は上段に時間波形・下段に
スペクトルという 2 段構成だったが，波形は提出課題2 と重複するので削除し，
スペクトルバーのみを画面全体に表示する構成にした．

\section*{4. 正しいと確認した方法}
\begin{itemize}
  \item Arduino IDE で \texttt{HCK02\_03.ino} がコンパイルでき，シリアルモニタに
        1 行 1 サンプルで流れることを確認した．
  \item Processing IDE で \texttt{HCK02\_03.pde} を起動し，画面全体に
        周波数スペクトルのバーが描画されることを確認した．
  \item キー \texttt{1} で正弦波を選んでから \texttt{p} キーで楽曲を再生したとき，
        基音にあたる位置のバーが立ち上がることを確認した．
  \item キー \texttt{p} で楽曲を再生してマイクに入力したとき，音に反応してバーが立ち上がる
        様子を観察した．
  \item Arduino 側 \texttt{delayMicroseconds(100)} と Processing 側
        \texttt{SAMPLE\_RATE = 5000.0} が対応していることをコード上で確認した．
\end{itemize}

\section*{5. 問題や間違い}
\begin{itemize}
  \item \cboxoff あった
  \item \cboxon なかった
\end{itemize}

要件をそのまま満たしていたので特に手を入れる必要はなかった．
なお起動直後はバッファがゼロのままなので最初の数フレームはバーがすべて 0 になるが，
これはサンプルが貯まるまでの待ち時間であり異常ではないと理解できた．

\section*{6. 自分で工夫した点}
AI が出したコードは上段に時間波形・下段にスペクトルという 2 段構成だったが，時間波形は
提出課題2 と重複するため \texttt{drawWave()} を削除し，スペクトルバーだけを画面全体に
大きく表示するレイアウトに変更した．

\section*{参考文献}
\begin{itemize}
  \item Arduino Reference: \\
        \url{https://docs.arduino.cc/language-reference/}
  \item Minim Reference: \\
        \url{https://code.compartmental.net/minim/}
\end{itemize}

\end{document}
