takushio2525/2026-hackathon-team23/report/計画書_中間発表/23_計画書・設計書.pdf

2026 年 5 月 22 日 Version 1.0

# ハッカソン 〜計画書と設計書〜

## チーム 23

24G1038 : 片岡 聖
24G1175 : 地曵 賢人
24G1131 : 御代川 稜
25G1021 : 梅澤 颯太
25G1053 : 齋藤 翔太
25G1065 : 塩澤 匠生

目次

第 1 章 | プロジェクトの計画書 ・・・・・・・・・・・・・・・・・・・・・・・・・・・・ | 1
1.1 | プロジェクトの概要・・・・・・・・・・・・・・・・・・・・・・・・・・・・・・ | 1
1.1.1 | プロジェクトの題目 ・・・・・・・・・・・・・・・・・・・・・・・・・・・・ | 1
1.1.2 | プロジェクトの目的 ・・・・・・・・・・・・・・・・・・・・・・・・・・・・ | 1
1.1.3 | 既存の技術とプロジェクトの独自性・・・・・・・・・・・・・・・・・・・ | 2
1.2 | スコープ・マネジメント ・・・・・・・・・・・・・・・・・・・・・・・・・・・ | 2
1.2.1 | 成果物・・・・・・・・・・・・・・・・・・・・・・・・・・・・・・・・・・・・・ | 3
1.2.2 | プロジェクトの対象範囲と非対象範囲 ・・・・・・・・・・・・・・・・・ | 3
1.2.3 | 機能分解構造 FBS・・・・・・・・・・・・・・・・・・・・・・・・・・・・・・ | 4
1.2.4 | 製品分解構造 PBS・・・・・・・・・・・・・・・・・・・・・・・・・・・・・・ | 4
1.2.5 | FBS と PBS の対応関係 ・・・・・・・・・・・・・・・・・・・・・・・・・・ | 5
1.3 | 作業計画・・・・・・・・・・・・・・・・・・・・・・・・・・・・・・・・・・・・・ | 5
1.3.1 | 作業分解構造 WBS と管理番号・・・・・・・・・・・・・・・・・・・・・・ | 5
1.3.2 | アローダイアグラムとクリティカルパス・・・・・・・・・・・・・・・・ | 7
1.3.3 | 役割分担 ・・・・・・・・・・・・・・・・・・・・・・・・・・・・・・・・・・・ | 7
1.3.4 | ガントチャート ・・・・・・・・・・・・・・・・・・・・・・・・・・・・・・・ | 8
1.4 | 検証と妥当性確認: V&V 計画 ・・・・・・・・・・・・・・・・・・・・・・・・ | 9
1.4.1 | プロジェクトの成果物に対する有効指標 MOE ・・・・・・・・・・・・ | 9
1.4.2 | 有効指標 MOE に対応する性能指標 MOP ・・・・・・・・・・・・・・・ | 9
1.4.3 | システムテストで評価する性能指標 MOP ・・・・・・・・・・・・・・・ 10
1.4.4 | 結合テストで評価する性能指標 MOP・・・・・・・・・・・・・・・・・・ 10
1.4.5 | 単体テストで評価する性能指標 MOP・・・・・・・・・・・・・・・・・・ 10
1.4.6 | プロジェクト中に監視する技術性能指標 TPM ・・・・・・・・・・・・ 10
1.4.7 | プロジェクト中に監視する指標 TPM ・・・・・・・・・・・・・・・・・・ 11
1.5 | 資源・調達管理・・・・・・・・・・・・・・・・・・・・・・・・・・・・・・・・・ 11
1.6 | リスク管理 ・・・・・・・・・・・・・・・・・・・・・・・・・・・・・・・・・・・ 11
第 2 章 | システムの基本設計・・・・・・・・・・・・・・・・・・・・・・・・・・・・・・ 13

3

2.1 | 機能一覧・・・・・・・・・・・・・・・・・・・・・・・・・・・・・・・・・・・・・ 13
2.1.1 | 要求一覧 ・・・・・・・・・・・・・・・・・・・・・・・・・・・・・・・・・・・ 13
2.1.2 | 機能分解 ・・・・・・・・・・・・・・・・・・・・・・・・・・・・・・・・・・・ 14
2.2 | システム構成図・・・・・・・・・・・・・・・・・・・・・・・・・・・・・・・・・ 15
2.2.1 | 全体構成 ・・・・・・・・・・・・・・・・・・・・・・・・・・・・・・・・・・・ 15
2.2.2 | ノードとパートの対応 ・・・・・・・・・・・・・・・・・・・・・・・・・・・ 16
2.2.3 | ノードの役割分担・・・・・・・・・・・・・・・・・・・・・・・・・・・・・・ 16
2.2.4 | 演奏中のデータフロー ・・・・・・・・・・・・・・・・・・・・・・・・・・・ 17
2.2.5 | 採用アーキテクチャ（EMA） ・・・・・・・・・・・・・・・・・・・・・・ 17
2.3 | 操作インターフェース設計・・・・・・・・・・・・・・・・・・・・・・・・・・ 18
2.3.1 | ユーザー操作・・・・・・・・・・・・・・・・・・・・・・・・・・・・・・・・・ 18
2.3.2 | LED 表示仕様 ・・・・・・・・・・・・・・・・・・・・・・・・・・・・・・・・ 19
2.3.3 | 通信メッセージ ・・・・・・・・・・・・・・・・・・・・・・・・・・・・・・・ 19
2.4 | 状態遷移図 ・・・・・・・・・・・・・・・・・・・・・・・・・・・・・・・・・・・ 20
2.4.1 | システム全体の動作シーケンス ・・・・・・・・・・・・・・・・・・・・・ 20
2.4.2 | 指揮者ノード（node_01） ・・・・・・・・・・・・・・・・・・・・・・・・ 21
2.4.3 | 楽器ノード（node_02〜06） ・・・・・・・・・・・・・・・・・・・・・・ 22
2.4.4 | PC（Processing） ・・・・・・・・・・・・・・・・・・・・・・・・・・・・・ 22
第 3 章 | システムの詳細設計・・・・・・・・・・・・・・・・・・・・・・・・・・・・・・ 25
3.1 | 部品一覧・・・・・・・・・・・・・・・・・・・・・・・・・・・・・・・・・・・・・ 25
3.2 | ハードウェア設計 ・・・・・・・・・・・・・・・・・・・・・・・・・・・・・・・ 26
3.2.1 | 配線・ピンアサイン ・・・・・・・・・・・・・・・・・・・・・・・・・・・・ 27
3.2.2 | ネットワーク構成・・・・・・・・・・・・・・・・・・・・・・・・・・・・・・ 27
3.3 | ソフトウェア設計 ・・・・・・・・・・・・・・・・・・・・・・・・・・・・・・・ 28
3.3.1 | ファイル構成・・・・・・・・・・・・・・・・・・・・・・・・・・・・・・・・・ 28
3.3.2 | オブジェクト設計（クラス図） ・・・・・・・・・・・・・・・・・・・・・ 29
3.3.3 | 通信パケット設計・・・・・・・・・・・・・・・・・・・・・・・・・・・・・・ 30
3.3.4 | 楽譜データ形式 ・・・・・・・・・・・・・・・・・・・・・・・・・・・・・・・ 32
3.3.5 | 時刻同期方式・・・・・・・・・・・・・・・・・・・・・・・・・・・・・・・・・ 33
3.3.6 | PC 側ソフトウェア（Processing）・・・・・・・・・・・・・・・・・・・ 33
3.3.7 | 画面とゲーム UI の設計 ・・・・・・・・・・・・・・・・・・・・・・・・・・ 35
3.4 | 処理フローの設計 ・・・・・・・・・・・・・・・・・・・・・・・・・・・・・・・ 36

4

3.4.1 | 3 フェーズ実行モデル ・・・・・・・・・・・・・・・・・・・・・・・・・・・ 36
3.4.2 | 指揮者ノードの処理フロー ・・・・・・・・・・・・・・・・・・・・・・・・ 37
3.4.3 | ゲームモードの採点とメトロノームガイド ・・・・・・・・・・・・・・ 37
3.4.4 | 楽器ノードの処理フロー・・・・・・・・・・・・・・・・・・・・・・・・・・ 38
3.5 | テストの設計 ・・・・・・・・・・・・・・・・・・・・・・・・・・・・・・・・・・ 40
3.5.1 | 設計目標値 ・・・・・・・・・・・・・・・・・・・・・・・・・・・・・・・・・・ 41
3.5.2 | 検証の方向性・・・・・・・・・・・・・・・・・・・・・・・・・・・・・・・・・ 41
3.5.3 | 実機検証で確定する仮値・・・・・・・・・・・・・・・・・・・・・・・・・・ 42
第 4 章 | 生成 AI の利用 ・・・・・・・・・・・・・・・・・・・・・・・・・・・・・・・・・ 45

# 第 1 章 プロジェクトの計画書

本章では，本プロジェクトの概要・スコープ・作業計画・検証方針・資源・リスク を示す．本プロジェクトは約 3 か月をかけ，ハードウェア（Arduino）とソフトウェ ア（Processing）を組み合わせた電子オーケストラを構築するものである．チーム 23 では，指揮動作によって楽曲のテンポを操作できる演奏システムを開発する．

## 1.1 プロジェクトの概要

1.1.1 プロジェクトの題目

本プロジェクトの題目は「指揮用 Arduino から指揮をするオーケストラ」である． 指揮者が手に持つ Arduino の動きを起点として，複数の楽器ノードと PC アプリが同 期して合奏する，体験型の電子オーケストラを指す．

1.1.2 プロジェクトの目的

本プロジェクトの目的は，時間帯・天候・通信環境などの外部条件や明るさの制約 に左右されず，音楽経験のない人でも直感的な指揮動作だけで演奏に参加できるシス テムを開発することである．具体的には，指揮棒を振る周期を検出して楽曲のテンポ へ反映し，LED による視覚的演出を加えることで，誰でも楽しめる体験型電子オーケ ストラの実現を目指す．最終的なゴールは，指揮棒を振った際に，振りの周期の速さ に応じてテンポが変化する状態を達成することである．加えて，振りの大きさに応じ て演奏の強弱を変化させる機能を，必達機能の完成後に取り組む発展目標として位置 づける．
さらに本プロジェクトでは，音楽経験のない人でも繰り返し楽しめるよう，2 つの 動作モードを用意する．1 つは指揮者が自由にテンポを操る自由演奏モード，もう 1 つは提示された目標テンポをどれだけ正確に維持できたかを採点するゲームモードで ある．ゲームモードでは曲頭にメトロノームのガイドを目標テンポで提示し，曲の進 行とともにガイドを徐々に弱める．指揮者は記憶を頼りにテンポを維持し，その精度

1

をスコアとして画面に表示する．これにより，ただ演奏するだけでなく「うまく指揮 できたか」を可視化し，挑戦したくなる遊戯性を加える． 本目的の達成には，次の課題を解決する必要がある．

- 指揮動作の安定検出：指揮棒の振りには個人差があり，速さ・大きさ・角度が異 なる．どのような振り方でも安定して動作を検出する必要がある．
- テンポへのリアルタイム反映：指揮棒を振った周期に合わせ，遅延なく自然にテ ンポを変化させる必要がある．反応が遅いと操作感が損なわれる．
- 誤検出の抑制：小さな揺れや不要な動きを指揮動作と誤認するとテンポが乱れる ため，必要な動作だけを判定する仕組みが要る．
- 未経験者でも使える操作性：専門知識がなくても直感的に扱えるよう，簡単な操 作方法と分かりやすいフィードバックを用意する．
- 演奏状態の可視化：現在のテンポや強弱の変化が伝わりにくいと操作しづらいた め，LED 表示などで演奏状態を可視化する．
- 環境条件への非依存：明るさ・時間帯・天候・通信環境に依存せず，屋内外で安 定して使用できる構成とする．

1.1.3 既存の技術とプロジェクトの独自性

既存技術として，テルミンのような非接触型電子楽器や，カメラ・センサを用いて 身体動作を音楽表現へ変換するシステムが存在する [1]．また，Wii Music[2] では， コントローラの動作から拍を検出して音楽のテンポを制御している．分散配置した複 数の機器を同期させて合奏する構成も，ネットワーク演奏の先行研究 [4] に見られ る．しかし，これらの多くは，高い演奏技術を要する，明暗などの環境条件に影響を 受けやすい，専用の演奏装置や据え置きの設備を前提とする，といった制約を持つ． 本プロジェクトの独自性は，これらの要素を組み合わせ直した点にある．複数マイコ ンによる分散演奏を，身体に持った加速度センサだけで操る直感的な指揮制御と結び 付け，明るさや通信環境に左右されない自己完結した構成とすることで，音楽経験の ない人でも環境を選ばず合奏を指揮できる体験を一体で成立させる．個々の技術が既 存であっても，それらをこの形で統合した点に新規性がある．

2

## 1.2 スコープ・マネジメント

1.2.1 成果物

本プロジェクトの成果物を以下に示す．

- オーケストラ実機一式（指揮者ノード 1 台＋楽器ノード 5 台）
- 金管とドラムの音色を合成する Processing プログラム（各楽器ノードに 1 対 1 で接続する 5 台の PC 上で動作）．モード選択・目標テンポ・スコア・結果画面 を表示するゲーム UI を含む
- システム構成図および設計書一式
- 動作確認結果および性能評価資料
- プロジェクト計画書および最終報告書

1.2.2 プロジェクトの対象範囲と非対象範囲

本プロジェクトの対象範囲を以下に示す．

- Arduino を用いた指揮動作検出システムの開発
- 加速度センサによる指揮棒の振り動作の取得
- 振り下ろしの検出と，振り周期に応じた楽曲テンポの制御機能
- 振りの大きさに応じた強弱変化機能（発展目標）
- ハードウェアとソフトウェアを統合したシステム構築
- 自由演奏モードとゲームモードの 2 モード構成，および両モードの選択機能
- ゲームモードにおける目標テンポの提示（メトロノームガイド）とテンポ維持精 度の採点
- システムの動作確認および性能評価

一方，以下の内容は対象外とする．

- プロのオーケストラに匹敵する高精度な指揮解析
- AI を用いた自動指揮認識機能
- 複数人による同時指揮への対応

3

- 市販音楽制作ソフトウェアとの連携
- 楽曲の自動生成機能，および複雑なジェスチャ認識機能

1.2.3 機能分解構造 FBS

本システムが実現すべき機能を階層的に整理した機能分解構造（FBS）を図 1.1 に 示す．最上位の「Arduino オーケストラ」を，指揮解析・同期通信・楽譜進行・音響 合成・ゲーム進行の 5 つの機能群へ分解した．指揮解析は指揮動作の認識から演奏速 度の決定・開始停止・表情抽出までを担い，同期通信は共通時刻の共有・指示の一斉 配信・通信の安定性確保を担う．楽譜進行はテンポ追従再生・パート別演奏制御・発 音タイミング管理を，音響合成は金管楽器音の再現・多重音の発音・演奏状態の可視 化を担う．ゲーム進行はモード選択・目標テンポの提示・テンポ維持の採点を担い， ゲームモードでのみ動作する．

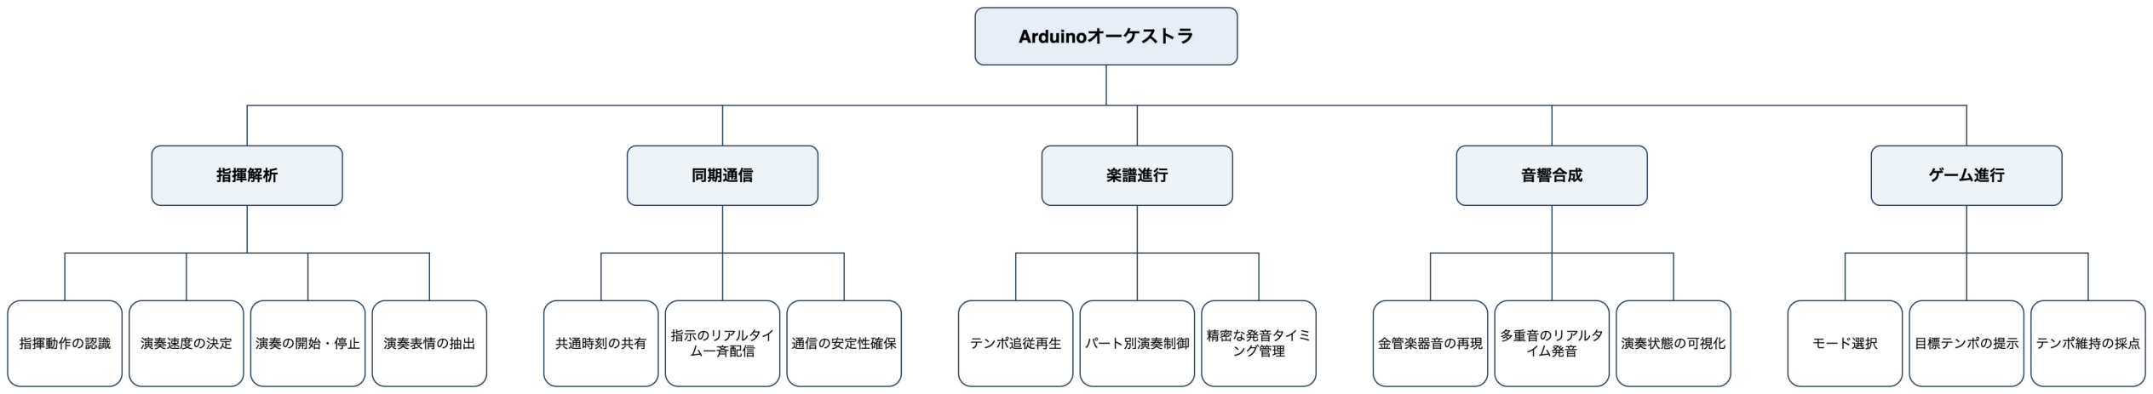
[picture p9: figure]

図 1.1 機能分解構造（FBS）

1.2.4 製品分解構造 PBS

FBS の各機能を実現するために必要な成果物を整理した製品分解構造（PBS）を 図 1.2 に示す．システムを，指揮者ノードユニット・ネットワーク基盤・楽器演奏 ユニット・音響合成アプリケーションの 4 系統へ分解した．指揮者ノードユニット は指揮者用 Arduino と動作解析ファームウェア・コマンド送出モジュール・ゲーム 進行モジュールから成り，ネットワーク基盤は全ノードで共有する通信モジュー ル・共通定義ファイル・API フレームワークから成る．楽器演奏ユニットは楽器用 Arduino と演奏進行エンジン・楽譜データアセットを，音響合成アプリケーションは Processing 音響合成エンジン・ボイスマネージャー・演奏モニタ UI・ゲーム画面 UI を含む．ゲーム進行モジュールは指揮者ノード上で採点とメトロノームガイドを担 い，ゲーム画面 UI は PC 上でモード・スコア・結果を描画する．

4

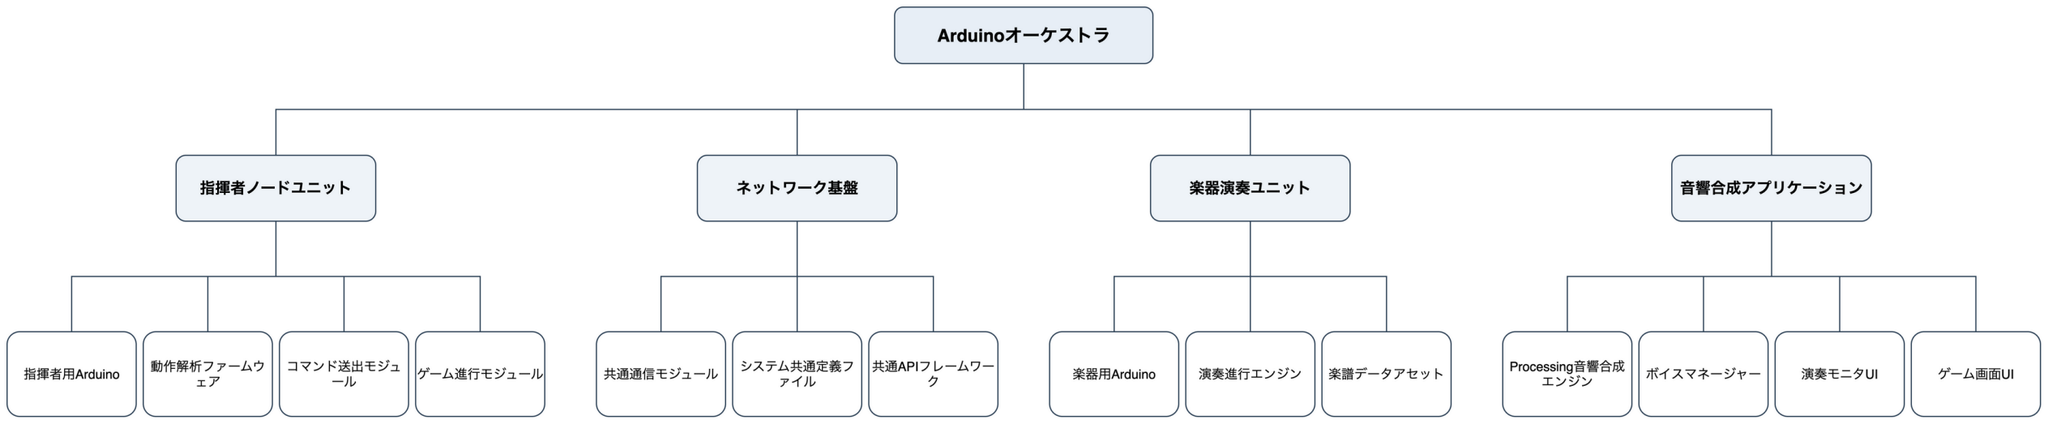
[picture p10: figure]

図 1.2 製品分解構造（PBS）

1.2.5 FBS と PBS の対応関係

FBS はシステムが実現する「機能」を，PBS はそれを実現する「成果物・構成要 素」を表す．両者の主な対応関係を表 1.1 に示す．FBS で定義した各機能群は，PBS のいずれかの成果物系統によって実現される構成となっている．

表 1.1 FBS と PBS の対応関係
FBS（機能群） | 対応する PBS（成果物系統）
指揮解析 | 指揮者ノードユニット（指揮者用 Arduino，動作解析ファームウェ
| ア，コマンド送出モジュール）
同期通信 | ネットワーク基盤（共通通信モジュール，システム共通定義ファイ
| ル，共通 API フレームワーク）
楽譜進行 | 楽器演奏ユニット（楽器用 Arduino，演奏進行エンジン，楽譜データ
| アセット）
音響合成 | 音響合成アプリケーション（Processing 音響合成エンジン，ボイス
| マネージャー，演奏モニタ UI）
ゲーム進行 | 指揮者ノードユニット（ゲーム進行モジュール）および音響合成アプ
| リケーション（ゲーム画面 UI）

## 1.3 作業計画

1.3.1 作業分解構造 WBS と管理番号

本プロジェクトの作業を，設計・製造・テスト・ストレッチ・運用発表の 5 つ のフェーズに分け，要素成果物ごとに管理番号を付して整理した．作業分解構造

5

（WBS）を表 1.2 に示す．番号は，フェーズ（100 番台〜500 番台）と要素成果物 （下 2 桁）の体系で付与している．

表 1.2 作業分解構造（WBS）
番号 要素成果物 | 主なタスク | 担当

100 設計フェーズ（工数目安 3 週間）
110 | 基本設計 | FBS ／ PBS ／ MOE・MOP・TPM の最終化，システ
ムアーキテクチャ・通信プロトコル・楽譜データ形
式・音色合成・動作モードの基本設計

全員

120 | 詳細設計 | 共通層 API・指揮者・楽器の詳細設計，Processing 詳細設計，周波数分析，楽譜データ詳細設計

塩澤，梅澤，
齋藤

200 製造フェーズ（工数目安 2 週間）
210 | 共通層実装 | IModule ／ ModuleTimer 実装，SystemData ／ Pro- jectConfig 整備，OrcNetModule 実装

塩澤

220 | 指揮者ノード | IMU ドライバ，信号前処理，拍検出，テンポ推定， コマンド送出の各モジュール実装
塩澤
230 | 楽器ノード | CTRL ／ BEAT 受信，楽譜進行ロジック，NOTE 送 出，パート別差分適用の実装

塩澤

240 | 楽譜準備 | 課題曲の譜面化（主旋律譜・ドラム譜），輪唱の入り 拍の割り当て，楽譜ヘッダの配列化，ROM 埋め込み 確認

齋藤

250 | Processing 実装 | NOTE 受信，音色合成エンジン，多重発音管理，演 奏画面の描画

梅澤

260 | ゲーム機能 | モード選択の受付，メトロノームガイドのフェード 制御，テンポ維持の採点ロジック，PC 側のモード待 機・スコア・結果画面
塩澤，梅澤

300 テストフェーズ（工数目安 2 週間）
310 | 単体テスト | 共通層・拍検出・楽譜進行・音色生成の単体動作確認 塩澤，梅澤
320 | 結合テスト | 指揮者単体デモ，指揮者・楽器結合，5 ノード同期誤
| | 差計測，全ノード結合 | 塩澤，全員
330 | システムテ
| スト | 拍検出精度，通信遅延，同期誤差，テンポ追従，パ
| | ケットロス耐性，CPU 負荷，起動時間 | 塩澤，全員

400 ストレッチフェーズ（余裕がある場合）
410 | 強弱推定 | velocity 推定アルゴリズム実装，CTRL パケットへの
| | 乗せこみ，強弱制御テスト | 塩澤

500 運用・発表フェーズ
510 | 発表 | 発表準備・デモ調整 | 全員
520 | 報告書 | 成果報告書（個人）の作成 | 全員

6

1.3.2 アローダイアグラムとクリティカルパス

WBS の要素成果物間の先行関係をアローダイアグラムとして図 1.3 に示す．クリ ティカルパスは「110 基本設計 → 120 詳細設計 → 210 共通層実装 → 220 指揮者 ノード → 230 楽器ノード → 310/320 テスト → 330 システムテスト → 510 発表 準備」で，全長は約 8 週間である．240 楽譜準備・250Processing 実装・260 ゲー ム機能は，120 詳細設計の完了後にクリティカルパスと並行して進められ，それぞれ 0.5〜1.0 週のフロート（余裕）を持つため，多少の遅延を吸収できる．なお，410 強 弱推定（発展目標）と 520 成果報告書は，クリティカルパスに関与しないため本図 では省略している．

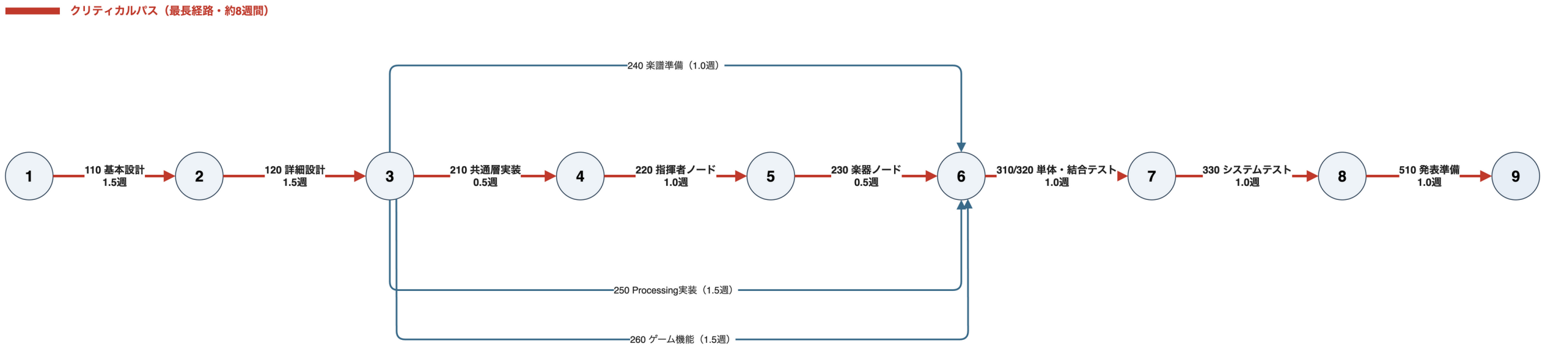
[picture p11: figure]

図 1.3 アローダイアグラムとクリティカルパス

1.3.3 役割分担

チーム 23 は 6 名で構成される．役割分担を表 1.3 に示す．Arduino 系プログラム （指揮者・楽器・共通層）は，モジュール境界をそろえる目的で塩澤が一括して設計・ 実装する．楽譜データは齋藤，Processing による音色合成は梅澤が担当し，御代川・ 地曵・片岡は議事録・計画書編纂・調達を担う．テストフェーズ以降の実機検証およ び発表準備には全員が合流する．

7

表 1.3 チーム 23 の役割分担
メンバー | 学籍番号 | 主な担当
塩澤 匠生 | 25G1065 | Arduino 系プログラム全般（指揮者・楽器・共通層の設計・
| | 実装）
齋藤 翔太 | 25G1053 | 楽譜データ作成・音階生成ロジック・周波数分析
梅澤 颯太 | 25G1021 | Processing による音色合成・演奏再生・UI
御代川 稜 | 24G1131 | 議事録（持ち回り 1 番手），計画書編纂
地曵 賢人 | 24G1175 | 議事録（2 番手），スケジュール管理
片岡 聖 | 24G1038 | 議事録（3 番手），WBS・役割整理，機材調達

1.3.4 ガントチャート

WBS と授業日程に基づくガントチャートを図 1.4 に示す．設計フェーズ（4 月下 旬〜5 月中旬）で FBS・PBS・MOE/MOP/TPM の最終化と基本・詳細設計を行い， 製造フェーズ（5 月下旬〜6 月上旬）で共通層・指揮者・楽器・楽譜・Processing・ ゲーム機能の実装を並行して進める．テストフェーズ（6 月中旬〜下旬）で単体・結 合・システムテストを段階的に実施し，余裕があればストレッチとして強弱推定を追 加する．運用・発表フェーズ（6 月下旬〜7 月）で成果発表会と成果報告書の作成を 行う．240 楽譜準備・250Processing 実装・260 ゲーム機能に余裕時間を持たせ， クリティカルパスの遅延を並列タスクで吸収できる構成とした．

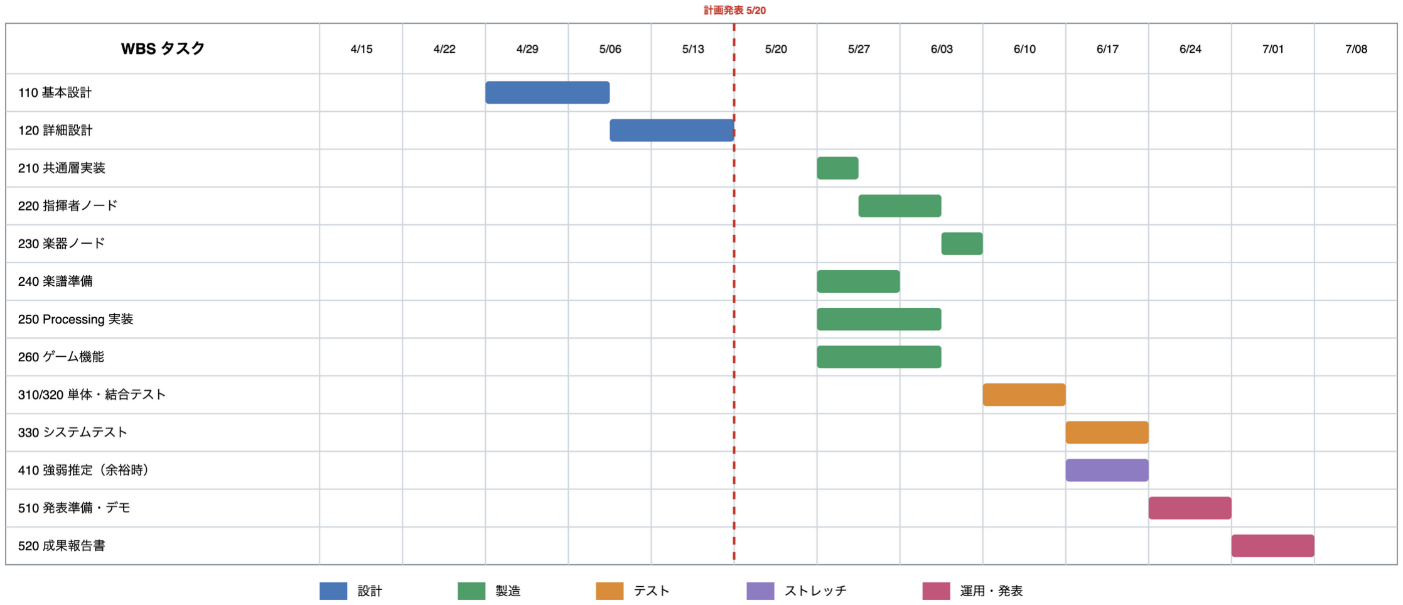
[picture p12: figure]

図 1.4 ガントチャート（WBS と授業日程の対応）

8

## 1.4 検証と妥当性確認: V&V 計画

1.4.1 プロジェクトの成果物に対する有効指標 MOE

有効指標（MOE：Measure of Effectiveness）は，システムが最終的にユーザー （指揮者・聴衆）へ提供する価値を評価する指標である．本プロジェクトでは 3 つの MOE を定め，各テスト階層の性能指標（MOP）の達成を通じて有効性を確立する． MOE と MOP の対応関係および目標値を表 1.4 に示す．

表 1.4 MOE と MOP の対応関係および目標値
性能指標（MOP） | 目標値

MOE 1：音楽的再現性と正確性（単体テスト領域）
拍検出の正確性 | 正解率 ≥ 90%
音階の誤差 | 平均 < 3.6 cent
楽譜との相違 | 誤ノート発音数 0

MOE 2：合奏の一体感とインタラクティブ性（結合テスト領域）
楽器間同期誤差 | ≤ 20 ms
指揮から楽器への通信遅延 | ≤ 30 ms
テンポ追従の遅延 | ≤ 2 拍

MOE 3：システムの堅牢性と実用性（システムテスト領域）
起動時間 | ≤ 5 s
CPU 負荷（入力フェーズ） | ≤ 2 ms
パケットロス耐性 | 演奏継続が可能なレベル

1.4.2 有効指標 MOE に対応する性能指標 MOP

前項の各 MOE に対し，システム全体として達成すべき性能指標を次の通り定め る．これらは特定の検証フェーズに限定されず，成果物が最終的に備えるべき技術的 到達基準である．

- 音楽的品質の達成基準：指揮動作から拍を正確に解析し，楽譜データを正確な ピッチで音響へ変換する精度を主軸に評価する．
- リアルタイム・アンサンブルの達成基準：分散配置した複数ノード間の極小な同 期誤差と，テンポ変化への停滞のない追従性能を主軸に評価する．

9

- 運用プラットフォームの達成基準：限られた計算資源内での処理完結，無線環境 下での通信断耐性，即時稼働を可能にする運用性を主軸に評価する．

1.4.3 システムテストで評価する性能指標 MOP

システムテストでは，パケットロス耐性と CPU 負荷を評価する．パケットロスは， 聴感上の破綻が生じない 5%以内を許容範囲の指標とする．CPU 負荷は，入力フェー ズの処理時間を制御周期内に収めるため，2 ms 以内を指標とする．

1.4.4 結合テストで評価する性能指標 MOP

結合テストでは，ノード間の同期と遅延を評価する．複数の音が一体の合奏に聞こ えるには発音タイミングの一致が要るが，数十ms 程度のずれは聴き手にほぼ気づか れないとされる [3]．これを踏まえ，楽器間の同期誤差はチームでの議論を経て安全 側に定めた目標値 20 ms 以内を指標とする．指揮棒から楽器への通信遅延は 30 ms 以内，テンポ追従の遅延は 2 拍以内を指標とする．

1.4.5 単体テストで評価する性能指標 MOP

単体テストでは，拍検出と音階解析の精度を評価する．拍検出の正確性は 90%以 上を指標とする．音階の誤差は，合成した出力音を録音して周波数分析し，楽譜の ノート番号が指定する平均律の理論音高との差（cent）を測って評価する．許容値 は，高分解能なピッチ抽出法で 3.6 cent 未満の精度が報告されている [6] ことを踏ま え，平均 3.6 cent 未満とする．

1.4.6 プロジェクト中に監視する技術性能指標 TPM

開発期間中，各性能指標の達成見込みを継続的に評価するための技術性能指標 （TPM）として次を監視し，技術的リスクを早期に発見する．

- 同期誤差の推移：目標値 20 ms に対する到達度を監視する．通信プロトコルの 最適化やノード数の増減が生じた際に実測し，目標値からの乖離が 10 ms 以上 となった場合はバッファ制御を再検討する．
- CPU 処理時間のマージン：制御周期 5 ms に対する各タスクの処理時間を監視 する．CPU 負荷が目標値（2 ms）の 80%を超えた段階で，コード最適化とタス ク優先順位の再設計を行う．

10

1.4.7 プロジェクト中に監視する指標 TPM

技術的な数値指標に加え，プロジェクト全体の進捗と資源の健全性を維持するため 次を監視する．

- 機能実装の完了率：WBS に基づく各モジュールの実装進捗を監視する．指揮解 析と通信基盤の統合が遅延した場合は，クリティカルパス上のリスクとして要員 配置やスコープの調整を行う．
- システム稼働の安定度：連続稼働テストにおける意図しないリセットやハング アップの発生頻度を監視し，不安定要素やメモリリークを早期に排除する．

## 1.5 資源・調達管理

本プロジェクトの遂行に必要となるハードウェア資源および開発環境の調達計画を 次に示す．

- ハードウェア資源：楽器ノード用に Arduino UNO R4 WiFi を 5 台，指揮者ノー ド用に XIAO ESP32-S3 Sense を 1 台使用する．さらに，各楽器ノードに 1 対 1 で接続し音色合成を担う PC を 5 台用いる．指揮解析用の IMU センサ，および 音色出力に用いるスピーカーは，チーム内の既存資産と新規調達によって確保済 みである．
- 開発・運用リソース：ソースコード管理に Git を用い，チーム内の並行開発を可 能とする．無線通信は指揮者ノードの SoftAP で完結させ，外部ルーターやテザ リングに依存しない構成とすることで，会場等の通信環境に左右されない安定し た経路を確保する．

## 1.6 リスク管理

各担当箇所の作業日数を長めに見積もり，バッファを設けることで，体調不良や不 具合により作業が滞った場合でも，スケジュール通りへの修正を容易にする．特に， クリティカルパス上にない 240 楽譜準備・250Processing 実装・260 ゲーム機能に 余裕時間を持たせ，クリティカルパスに遅延が生じても並列タスクで吸収できる構成

11

とした．ゲーム機能はコア機能である同期演奏の上に重ねる追加層であり，万一その 実装が遅れても自由演奏モードのみで発表が成立する構成としている．進捗の遅れは 前項の TPM（機能実装の完了率）で早期に検知し，要員配置やスコープの調整で対 応する．

12

# 第 2 章 システムの基本設計

本章では，第 1 章で定めた計画に基づき，Arduino オーケストラの基本設計を示 す．システムは指揮者マイコン 1 台・楽器マイコン 5 台・PC（Processing）5 台で 構成される．指揮者の振りを起点として，楽器マイコンが楽譜を進行させ，各 PC が 音色を合成してスピーカーから出力する．本章では，機能一覧・システム構成図・操 作インターフェース・状態遷移図を順に示す．なお，ファームウェアの設計には組

込み向けの構成手法 Embedded-Module-Architecture（以下 EMA）を全面的に採用 する．
本システムは 2 つの動作モードを持つ．利用者は起動時に，指揮者が自由にテンポ を操る自由演奏モードと，提示された目標テンポをどれだけ正確に維持できたかを採 点するゲームモードのいずれかを選ぶ．モードの選択と採点は指揮者ノードが司り， 楽器ノードの楽譜進行や PC の音色合成はどちらのモードでも共通の仕組みで動く． 両モードの差は，指揮者が目標テンポのガイドを受けるか，そのテンポ維持の精度を 採点・表示するか，の 2 点に閉じる．

## 2.1 機能一覧

2.1.1 要求一覧

本システムが満たすべき要求を表 2.1 に示す．「(S)」は必達機能の完成後に着手す るストレッチ要求である．R-Internal は外部から見えにくいが設計上必要な内部要求 を表す．

13

表 2.1 システムの要求一覧
ID | 要求 | 内容
R-1 | 6 台同期演奏 | 指揮者 1 台と楽器 5 台の計 6 台が，指揮者の拍に合わ
| | せて同期して演奏する
R-2 | 輪唱曲の再生 | 主旋律 4 パート（金管）とリズム 1 パート（ドラム）
| | からなる輪唱曲を演奏する．各パートは入り拍をずら
| | して輪唱とする
R-3 | 可変テンポ追従 | 指揮者の振りの速さの変化に，楽器側のテンポが追従
| | する
R-4 (S) | 強弱制御 | 指揮者の振りの大きさに応じて発音の強弱（velocity）
| | が変化する
R-5 | モード選択 | 起動時に自由演奏モードとゲームモードのいずれかを
| | 選択できる
R-6 | テンポ維持の
| 採点 | ゲームモードで，提示した目標テンポを指揮者がどれ
| | だけ正確に維持できたかを採点し，PC 画面に表示する
R-Internal-1 | 通信の信頼性 | 数%程度のパケットロスが起きても演奏が破綻しない
R-Internal-2 | CPU リソース | 各ノードが IMU サンプリングや UDP 受信を取りこぼ
| | さない処理量に収める
R-Internal-3 | 起動時間 | 電源投入から演奏可能まで，実演のセットアップとし
| | て許容できる数秒に収まる

2.1.2 機能分解

第 1 章の図 1.1 で示した機能分解構造を，実装単位の機能群へさらに分解する．各 機能群と所属ノードを次に示す．

F1 指揮情報抽出（node_01）
IMU6 軸の取得，信号前処理（ローパスフィルタとノルム計算），拍検出（振り下ろ しの検出），テンポ推定（拍間隔から BPM を算出），強弱推定（振幅から velocity を算出，ストレッチ），演奏状態の管理．

F2 指揮情報配信（node_01）

CTRL の送出（BPM・velocity・状態），BEAT の送出（拍トリガ），SoftAP の起 動・維持（指揮者自身がアクセスポイントを兼ね，楽器ノードを収容する）．

F3 楽譜進行（node_02〜06）
CTRL/BEAT の受信，楽譜データの保持（C 配列・パート別），BEAT 同期での音符 進行，NOTE イベントの生成，パート固有ロジック（partId と入り拍の差し替え）．

14

F4 発音情報配信（node_02〜06）

NOTE パケットの生成，専用 PC への USB Serial 送信．

F5 音響合成・演奏画面（PC）
NOTE の受信，倍音構成と ADSR エンベロープによる音色合成，スピーカーへの 出力．あわせて，モード待機・現在モード・目標テンポ・スコア・結果画面の描画 を担う（ゲーム画面の詳細は 3.3.7 節）．

F6 共通基盤（全ノード）

IModule の登録と 3 フェーズループ，ModuleTimer による周期実行，SystemData ／ ProjectConfig への状態・設定の集約，起動シーケンスと診断 LED 表示．

F7 ゲーム進行・採点（node_01）
モード選択の受付，目標テンポの提示（メトロノームガイドの生成とフェード制 御），実振りテンポと目標テンポの誤差集計による採点，モード・目標テンポ・ス コアの CTRL への乗せこみ．ゲームモードでのみ稼働する．

F1〜F4・F6・F7 はファームウェア（指揮者・楽器ノード）が，F5 は PC 側の Processing が担う．ストレッチ機能である F1 の強弱推定は，必達機能の実装完了後 に着手し，初期実装ではインターフェースのみを用意してスタブで通す．分散配置し た複数ノードを 1 つの拍源で同期させる構成は，ネットワーク演奏の先行研究 [4] に も見られる方式である．

## 2.2 システム構成図

2.2.1 全体構成

システムの全体構成を図 2.1 に示す．指揮者ノード node_01 は SoftAP（ESP32-S3 のソフトウェアアクセスポイント）を起動し，楽器ノード node_02〜06 はこれ に STA として接続する．外部ルータやテザリングは不要である．node_01 は CTRL ／ BEAT を UDP マルチキャストで全楽器ノードへ一斉配信する．各楽器ノードは楽 譜を進行させながら発音情報 NOTE を生成し，専用の PC へ USB Serial （1 対 1 接 続）で送信する．PC は NOTE を受け取って音色を合成し，スピーカーから出力す る．通信はノード間（指揮者→楽器）の WiFi UDP と楽器→ PC の USB Serial の二 系統に分離している．

15


図 2.1 システム全体構成（指揮者 1 台＋楽器 5 台＋ PC5 台．実線＝ WiFi UDP マルチキャ スト，破線＝楽器と PC の 1 対 1 USB Serial）

2.2.2 ノードとパートの対応

本システムは課題曲を 5 パートに分けて演奏する．課題曲は，輪唱しやすくテンポ 追従の確認がしやすい「かえるのうた」とする．各楽器ノードの partId・楽器・入り 拍・役割を表 2.2 に示す．金管 4 パートは同じ主旋律を入り拍をずらして演奏するこ とで輪唱を構成し，ドラムは 1 拍ごとのリズム伴奏を担う．

表 2.2 ノードとパートの対応
ノード | partId 楽器 | 入り拍 | 楽譜上の役割
node_02 0x02 | 金管 1 | 0 拍 | 主旋律を曲頭から演奏する
node_03 0x03 | 金管 2 | 4 拍 | 主旋律を 4 拍遅れて演奏する
node_04 0x04 | 金管 3 | 8 拍 | 主旋律を 8 拍遅れて演奏する
node_05 0x05 | 金管 4 | 12 拍 | 主旋律を 12 拍遅れて演奏する
node_06 0x06 | ドラム | 0 拍 | 1 拍ごとのリズム伴奏を演奏する

2.2.3 ノードの役割分担

各ノードと PC の責務を表 2.3 に示す．楽器ノード node_02〜06 のファームウェ アは共通ソースとパート設定の差し替えで構成し（ProjectConfig と楽譜データのみ を差分とする），5 台分の別コードは書き分けない．

16

表 2.3 ノードの役割分担
ノード | 主な責務
指揮者 node_01 | XIAO ESP32-S3 Sense．IMU の読み取りから拍・テンポ・強弱を推定 し，CTRL ／ BEAT を送出する．自身が SoftAP を起動して楽器ノードを 収容する
楽器 node_02〜06 | Arduino UNO R4 WiFi．BEAT に同期して楽譜を進行させ，NOTE を専用 PC へ送出する．金管 4 台とドラム 1 台で構成する
PC （Processing） 5 台 | 楽器ノードごとに 1 台を割り当てる．USB Serial で NOTE を受信し，倍 音と ADSR で音色を合成してスピーカーへ出力する

2.2.4 演奏中のデータフロー

演奏中における 1 拍ぶんの情報の流れを次に示す．

1. IMU（I2C 接続）が node_01 へ加速度・角速度のサンプルを渡す．
2. node_01 内のロジック applyPattern() が，フィルタ・拍検出・テンポ推定を実 行する．
3. 振 り 下 ろ し を 検 出 す る と，node_01 は BEAT（拍 番 号 と マ ス タ 時 刻）を node_02〜06 へ UDP マルチキャストで配信する．
4. 各楽器ノードは受信した BEAT の拍番号から楽譜位置を算出し，発音すべき音符 を決定する．
5. 各楽器ノードは NOTE（音高・強弱・発音長）を専用 PC へ USB Serial で送信 する．
6. 各 PC は NOTE から波形を合成し，スピーカーへ出力する．
7. 以上と並行して，node_01 は 20 Hz で CTRL（BPM・velocity・状態，および ゲームモードではモード・目標テンポ・スコア）を送信し続ける．

17

2.2.5 採用アーキテクチャ（EMA）

全ノードのファームウェアは，組込み向けの構成手法 EMA に準拠する¹）．本シス

テムに適用した EMA の中核ルールを次に示す．バイト単位のパケット定義や具体的 なコードは第 3 章で具体化する．

- IModule インターフェース：全ハードウェアモジュールが，init ／ updateInput

／ updateOutput ／ deinit の 4 メソッドを実装する．

- 3 フェーズ実行モデル：loop() は「入力→ロジック→出力」の順で実行する．
- SystemData 集約：モジュール間で共有する状態を 1 つの構造体に集約し，モ ジュール同士の直接呼び出しを禁止する．
- ProjectConfig 集約：ピン配置・定数・閾値などノード固有の設定を 1 つのヘッ ダに集約する．
- ロジックの位置づけ：拍検出・テンポ推定・楽譜進行のようなハードウェアに触 れない判断ロジックは，モジュールではなくロジック関数 applyPattern() に書く．

## 2.3 操作インターフェース設計

操作インターフェースを，ユーザーが触れる物理インターフェース（指揮棒・LED） と，ノード間・PC 間の通信インターフェース（CTRL ／ BEAT ／ NOTE）の二層に 分けて示す．

2.3.1 ユーザー操作

- 指揮棒：IMU を搭載した指揮者ノード node_01 を指揮棒として手に持ち，通常の 指揮動作（振り下ろし）で操作する．専用のボタン等は持たない．
- 起動順：楽器ノードを先に起動して SoftAP の待機状態にし，その後に指揮者ノー ドを起動する．指揮者の SoftAP 起動で楽器ノードが接続され，指揮者が指揮を 始めると BEAT が流れて演奏が始まる．
- モード選択：起動直後の ModeSelect 状態で動作モードを選ぶ．専用ボタンを持 たないため，選択は単純な規定モーションで行う．既定は自由演奏モードで，指

1） https://github.com/takushio2525/Embedded-Module-Architecture

18

揮棒を大きく 1 回振るとゲームモードに切り替わり，数秒静止すると現在の候補 で確定する．複雑なジェスチャ認識は対象外（第 1 章）であり，振る向きに依存 しない振りの有無だけで判定する．

- キャリブレーション：指揮者ノードは起動後の約 2 秒間，静止時の加速度を平均 して基準値とする．使用者は起動後 2 秒間，腕を自然に下ろして待つだけでよい．
- メトロノームガイド（ゲームモード）：ゲームモードでは，曲頭で目標テンポのガ イドを指揮者へ提示する．ガイドは node_01 の LED 明滅と楽器側 PC のクリッ ク音から成り，曲の進行とともに徐々に弱まって終盤は消える．指揮者は記憶を 頼りに目標テンポを維持する．

2.3.2 LED 表示仕様

各ノードは内蔵 LED の点滅パターンで自身の状態を提示する（表 2.4）．

表 2.4 LED 表示パターン
ノード | 状態 | LED パターン | 意味
node_01 | Idle | 低速点滅（1 Hz） 起動直後・SoftAP 起動前
node_01 | ModeSelect | 2 回点滅の反復 | 動作モードの選択待ち
node_01 | Calibrating | 中速点滅（2 Hz） 静止基準の学習中（2 秒）
node_01 | Conducting | 点灯（ゲーム時 は目標テンポで 明滅） | 通常演奏中．ゲームモードではメトロ ノームガイドを兼ねる
node_01 | Fallback | 高速点滅（5 Hz） IMU または SoftAP の異常
node_02〜06 | Idle | 低速点滅（1 Hz） 起動直後・SoftAP 未接続
node_02〜06 | WaitStart | 中速点滅（2 Hz） SoftAP 接続済・最初の BEAT 待ち
node_02〜06 | Playing | 点灯 | 通常演奏中

2.3.3 通信メッセージ

ノード間および PC との通信には，性質の異なる 3 種類のメッセージを使い分ける （表 2.5）．

19

表 2.5 3 種類の通信メッセージ
種別 | 送信元→宛先 | 経路・送信契機 | 役割
CTRL | node_01 →楽器
| 全台 | WiFi UDP・定期
| | （20 Hz） | BPM・velocity・状態を継続的に同期す
| | | る．ゲームモードではモード・目標テン
| | | ポ・スコアも載せ，楽器ノードが専用
| | | PC へ中継する
BEAT | node_01 →楽器
| 全台 | WiFi UDP・拍検
| | 出時 | 楽譜ポインタを前進させるトリガ

NOTE 楽器ノード→専用

| PC | USB Serial・楽譜
| | イベント発火時 | 発音を PC へ依頼する

CTRL は 20 Hz で定期送信される冪等なメッセージであり，1 つ取りこぼしてもす ぐ次が届くため，パケットロスの影響を受けにくい．BEAT は 1 拍に 1 回送る即時性 重視のメッセージで，確実性を上げるため同じ拍番号を複数回連送し，受信側は拍番 号の重複を排除する．楽器ノードは BEAT が長く届かない間も演奏状態を保持し，次 の BEAT 到来時に自然に再開する（指揮者の不在中に楽器だけが暴走しないよう，仮 想的な拍を内挿して走り続ける方式は採らない）．NOTE は楽器ノードと PC を結ぶ 1 対 1 の USB Serial で送るため，ネットワーク輻輳やパケットロスの心配なく確実 に到達する．バイト単位のパケット定義は第 3 章で示す．

## 2.4 状態遷移図

本節では，まずシステムが 1 曲を演奏するまでのノード間のやりとりを動作シーケ ンスとして示し，続いて各ノードが内部に持つ状態を定義する．状態は SystemData に保持し，ロジック関数 applyPattern() が遷移を判定する．

2.4.1 システム全体の動作シーケンス

起動からモード選択・キャリブレーション・演奏・採点・曲終了までの，ノード間 のやりとりを図 2.2 に示す．指揮者ノードは SoftAP を起動し，楽器ノード 5 台がこ れに接続する．動作モードが確定すると指揮者ノードはキャリブレーションを経て演 奏に入り，拍を検出するたびに CTRL と BEAT を楽器ノードへ配信する．楽器ノード は受信した拍に合わせて楽譜を進め，NOTE を専用 PC へ送って発音させる．ゲーム

20

モードではこれに加え，指揮者ノードがテンポ維持の精度を採点し，CTRL でスコア を PC へ届ける．


図 2.2 システムの動作シーケンス（起動から曲終了まで）

2.4.2 指揮者ノード（node_01）

指揮者ノードがとる状態を表 2.6 に定義する．

21

表 2.6 指揮者ノードの状態定義
状態 | 意味 | 動作
Idle | 起動直後・SoftAP
| 起動前 | IMU の読み取りは動くが拍検出は無効．CTRL ／
| | BEAT は送らない
ModeSelect | 動作モードの選択
| 待ち | 規定モーションでモードを選ぶ．選択中のモードを
| | CTRL で楽器・PC へ伝える．BEAT は送らない
Calibrating | 初期静止状態の学習
| 中（2 秒） | 加速度ノルムの平均を静止基準として記録する
Conducting | 通常演奏中 | 全モジュールが稼働．拍検出時に BEAT を，20 Hz
| | で CTRL を送出する
Fallback | エラー発生時 | CTRL を状態 Fallback で送り続ける．BEAT は停止
| | し，LED を高速点滅する

2.4.3 楽器ノード（node_02〜06）

楽器ノードがとる状態を表 2.7 に定義する．楽器ノード 5 台はいずれも同じ状態 機械で動作する．

表 2.7 楽器ノードの状態定義
状態 | 意味 | 動作
Idle | 起動直後・SoftAP
| 未接続 | 受信モジュールは動くが楽譜進行は無効．SoftAP
| | へ接続できるまでリトライする
WaitStart | SoftAP 接続済・最
| 初の BEAT 待ち | CTRL ／ BEAT を受信し，指揮者との時計オフセッ
| | トの学習を始める
Playing | 通常演奏中 | BEAT 受信ごとに拍番号から楽譜位置を算出して
| | NOTE を送出する．BEAT が長く来なくても Playing
| | に留まり，次の BEAT で自然に再開する

ゲームモードでも楽器ノードの状態機械は変わらない．楽器ノードは受信した CTRL のモード・目標テンポ・スコアをそのまま専用 PC へ中継するだけで，モード による状態分岐を持たない．

2.4.4 PC（Processing）

PC 側の Processing の状態遷移を表 2.8 に示す．Processing は起動後に USB Serial ポートを選んで接続し，楽器ノードが中継する CTRL と NOTE を受信する．各

22

PC は 1 台の楽器ノードと 1 対 1 で接続するため，状態遷移はその 1 台との接続・受 信のみを扱う簡潔な構成となる．ゲームモードでは，CTRL で届くモード・目標テン ポ・スコアに応じて表示画面を切り替える（画面の詳細は 3.3.7 節）．

表 2.8 PC（Processing）の状態定義
状態 | 意味と主な処理
PortSelect | Serial ポートの選択待ち．ポート一覧を表示し，担当者の選択を待つ
ModeWait | 接続済み・モード待機画面．CTRL ／ NOTE の先頭同期を待ち，CTRL で
| モードが確定するまで初期画面を表示する．確定後は現在モード（自由
| 演奏／ゲーム）を画面に出す
Playing | 演奏中．NOTE を復号して音色合成のための発音（Voice）を生成する．
| ゲームモードでは併せて目標テンポ・メトロノーム・スコアを描画する
Result | ゲームモードの曲終了後．最終スコアと評価を結果画面に表示する．自
| 由演奏モードでは経由しない
Muted | 受信は継続し発音のみ停止．新規の発音を作らず，既存の発音を減衰さ
| せる
Error | 接続異常．Serial を閉じ，受信バッファを破棄して警告を表示する

23

# 第 3 章 システムの詳細設計

本章では，第 2 章の基本設計を，実装に着手できる水準まで具体化する．部品構 成・ハードウェア配線・ソフトウェア構造・処理フロー・テスト設計を順に示す．記 述の粒度は「実装方針が伝わること」を主眼とし，全関数・全設定値の網羅ではな く，設計判断の要点と代表値の提示にとどめる．コードのフル実装は本書の対象外と する．

## 3.1 部品一覧

第 1 章の図 1.2 で示した製品分解構造（PBS）を，実体の機材とソフトウェア要素 の単位へ具体化する．ハードウェア構成を表 3.1 に，ソフトウェアの技術スタックを 表 3.2 に示す．PC（Processing）とスピーカーは本書のスコープ外だが，NOTE パ ケットの受信境界として参考に併記する．

25

表 3.1 ハードウェア部品一覧
区分 | 要素 | 数量 備考
指揮者 | XIAO ESP32-S3
| Sense | 1 | ESP32-S3（Xtensa LX7 デュアルコア）．内蔵
| | | WiFi で SoftAP と UDP を直接制御する
指揮者 | MPU6050
| （GY-521） | 1 | 6 軸 IMU．本案件は ±4 g ／ ±2000 dps で使
| | | 用，I2C アドレスは 0x68
指揮者 | 状態 LED | 1 | 基板内蔵の LED_BUILTIN を流用する
楽器 | Arduino UNO R4
| WiFi | 5 | node_02〜06（金管 4 ＋ドラム）．同一ハード
| | | ウェアで SoftAP に STA 接続する
楽器 | 状態 LED | 5 | 基板内蔵の LED_BUILTIN を流用する
ネット ワーク | node_01 の SoftAP
| で兼用 | 0 | 外部ルータ・テザリングは使わない
給電・通信 | USB Type-C ケー
| ブル | 6 | 楽器 5 本は各 PC へ 1 対 1 直結（給電と Serial
| | | を兼用），指揮者 1 本は給電のみ
境界 （参考） | PC（Processing） | 5 | 本書スコープ外．各楽器から NOTE を受信し音
| | | 色を合成する
境界 （参考） | スピーカー | 5 | 本書スコープ外．PC1 台あたり 1 系統

表 3.2 ソフトウェア技術スタック
レイヤ | 採用技術 | 備考
MCU（指揮者） | XIAO ESP32-S3
| Sense | ESP32-S3R8（Xtensa LX7 240 MHz×2）
MCU（楽器） | Arduino UNO R4 WiFi | Renesas RA4M1 に WiFi 担当の ESP32-S3 を
| | 組み合わせた構成
フレームワーク・ 言語 | Arduino framework ／
| C++ | PlatformIO 経由でビルドする
WiFi スタック | WiFi.h（指揮者）／
| WiFiS3（楽器） | SoftAP と UDP マルチキャストを使う
設計パターン | EMA | 全ノードのファームウェアに適用する
共通層 | ModuleCore・
| OrcProtocol・
| OrcNetModule ほか | firmware/common/lib に集約し全ノードで
| | 共有する
PC 側 | Processing 4 | NOTE の受信と音色合成（本書スコープ外）

26

## 3.2 ハードウェア設計

3.2.1 配線・ピンアサイン

指揮者ノード node_01（XIAO ESP32-S3 Sense）は外付けの MPU6050 を I2C で

接続する．XIAO の I2C 既定ピンは SDA=D4（GPIO5），SCL=D5（GPIO6）である． 3.3 V ／ GND を MPU6050 へ給電し，AD0 を GND に落として I2C アドレスを 0x68

に固定する．楽器ノード node_02〜06 （UNO R4 WiFi）は内蔵 LED 以外に外部配 線を要しない．各ノードの配線を表 3.3 に示す．

表 3.3 配線・ピンアサイン
ノード | 用途 | ピン・接続
node_01 | I2C SDA （MPU6050） | D4（GPIO5）
node_01 | I2C SCL （MPU6050） | D5（GPIO6）
node_01 | MPU6050 の電源 | 3.3 V・GND．AD0 を GND に落とし I2C アドレス
| | を 0x68 に固定する
node_01 | 状態 LED | LED_BUILTIN（XIAO のユーザー LED）
node_01 | 給電 | USB Type-C（給電のみ．開発・試験時のみデバッ
| | グ Serial を読む）
node_02〜
06 | 状態 LED | LED_BUILTIN

node_02〜

06 | 給電＋ NOTE 送信 | USB Type-C（各楽器が専用 PC へ 1 対 1 直結．
| | Serial.write で NOTE を出力する）

3.2.2 ネットワーク構成

通 信 は 二 系 統 に 分 離 す る．Arduino 同 士 は WiFi UDP（node_01 が 立 て る

SoftAP 配下）で，Arduino と PC は USB Serial の直結で通信する．node_01

### は WiFi.softAP("OrchestraAP", "orchestra2026") でアクセスポイントを起動し，

node_02〜06 は WiFiS3 で同じ SSID へ STA として接続する．SoftAP の既定アドレ

スは 192.168.4.1，楽器側は内蔵 DHCP で 192.168.4.2 以降を取得する．node_01

は CTRL ／ BEAT を UDP マルチキャスト（239.0.0.1:5001）で全楽器ノードへ一斉

27

配信し，各楽器ノードは発音情報 NOTE を専用 PC のシリアルポートへ書き込む．接 続トポロジは第 2 章の図 2.1 に示したとおりである．
指揮者ノードだけを XIAO ESP32-S3 としたのは，ESP32-S3 を直接制御すると WiFi.softAP() と UDP マルチキャストがネイティブにサポートされ，内蔵 WiFi を別

チップ越しに扱う UNO R4 WiFi よりも SoftAP の制御自由度が高いためである．外 部ルータやテザリングが不要なため，会場 LAN のセキュリティ制限や電波混雑の影 響を受けない利点もある．
なお，WiFi の省電力モードが有効な STA が接続していると，マルチキャストフ レームの配送がビーコン周期ぶん遅れる．これを避けるため楽器ノードの WiFi 省電 力モードは無効化して運用する．無効化できない場合の代替策は，テスト設計（3.5 節）の未確定事項として扱う．

## 3.3 ソフトウェア設計

3.3.1 ファイル構成

firmware/配下は，全ノードで共有する共通層と，ノード別プロジェクトの 2 段構 造とする．EMA に準拠し，PlatformIO の lib_extra_dirs 設定で共通層を全ノード

から参照する．ディレクトリ構成の抜粋を次に示す．

firmware/
|-- common/lib/ | # 全ノード共通（lib_extra_dirs で参照）
| |-- ModuleCore/ | # IModule + ModuleTimer
| |-- OrcProtocol/ | # CTRL/BEAT/NOTE パケット定義
| |-- OrcNetModule/ | # WiFi 接続維持 + UDP 送受信
| |-- StatusLedModule/ # 状態 LED 出力
| `-- SerialDebug/ | # SERIAL_DEBUG 切替のデバッグ出力
|-- node_01/ | # 指揮者ノード
| |-- include/ | # SystemData.h, ProjectConfig.h
| |-- src/ | # main.cpp, applyPattern.cpp
| `-- lib/ | # ImuModule, OrcSenderModule
`-- node_02 〜 node_06/ | # 楽器ノード（金管 4 ＋ドラム．5 台とも同構造）
|-- include/ | # SystemData.h, ProjectConfig.h, score_data.h
|-- src/ | # main.cpp, applyPattern.cpp, score_data.cpp
`-- lib/ | # OrcReceiverModule, NoteSenderModule

28

楽器ノード 5 台は同一コードで動作し，ノード間の差分は ProjectConfig.h（partId・ 入り拍）と score_data.*（楽譜配列）にのみ閉じ込める．ビルド時の SERIAL_DEBUG

フラグで，本番動作（NOTE のバイナリ送信）と開発時（テキストログ出力）を切り 替える．

3.3.2 オブジェクト設計（クラス図）

す べ て の ハ ー ド ウ ェ ア モ ジ ュ ー ル は，EMA の 抽 象 基 底 IModule（init ／

### updateInput ／ updateOutput ／ deinit の 4 メソッド）を継承する．WiFi UDP を扱

う OrcNetModule は共通層に置き，指揮者・楽器の両ノード種で共有する（図 3.1）．

各モジュールの責務を表 3.4 に示す．

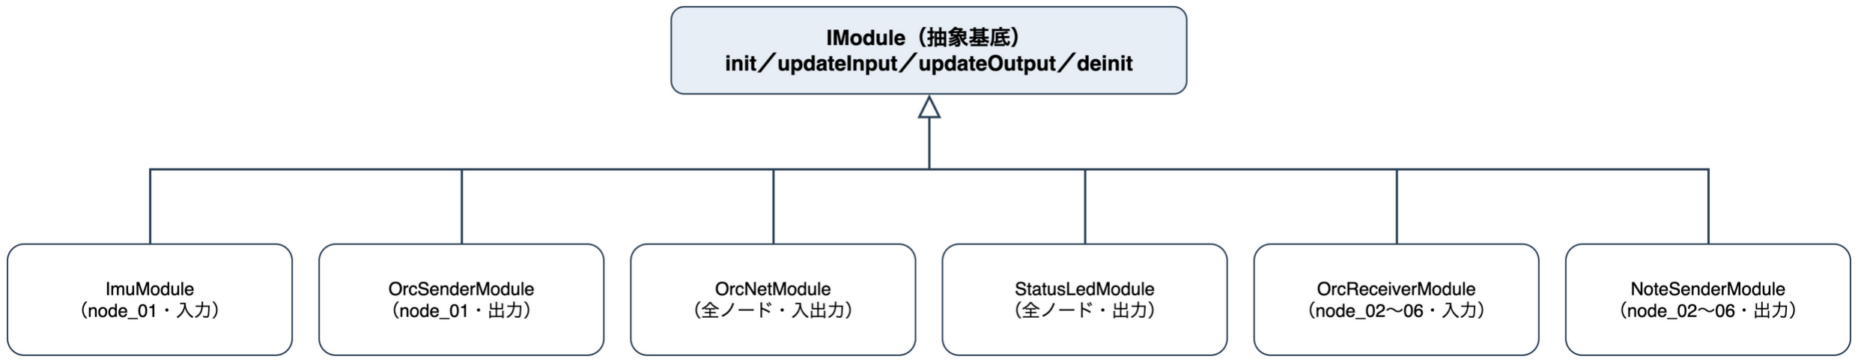
[picture p13: figure]

図 3.1 モジュールのクラス継承関係（各モジュールの所属ノードを併記）

表 3.4 モジュール一覧と責務
モジュール | ノード | 分類 | 責務
ImuModule | node_01 | 入力 | MPU6050（I2C）の 6 軸を読み取る
OrcSenderModule | node_01 | 出力 | CTRL ／ BEAT の送信内容を組み立てる
OrcReceiverModule | node_02〜
| 06 | 入力 | 受信した CTRL ／ BEAT を整形する
NoteSenderModule | node_02〜
| 06 | 出力 | NOTE を USB Serial で PC へ送信する
OrcNetModule | 全ノード | 入出力 | WiFi 接続の維持と UDP の送受信
StatusLedModule | 全ノード | 出力 | 状態に応じた LED の点滅表示

PC 側の Processing は，シリアル入力をフレーム同期して 20 バイトのパケットを 切り出す受信部，Serial スレッドと描画スレッドを分離する受信キュー，発音単位 （Voice）の生成と消音を管理する発音管理部，および画面の描画部から成る．詳細は

3.3.6 節と 3.3.7 節に示す．

29

3.3.3 通信パケット設計

ノード間および PC との通信に用いる 3 種類のパケット（CTRL ／ BEAT ／ NOTE） は，いずれも 20 バイト固定長とする．先頭 12 バイトが全パケット共通のヘッダ （表 3.5），後続 8 バイトが型ごとのペイロード（表 3.6）である．seq や bpmQ8 などの 多バイト数値はリトルエンディアンで配置する．先頭の magic は固定のバイト列とし て定義し，数値ではないためエンディアンの対象外とする．magic は WiFi UDP 上で

はプロトコル識別子，USB Serial 上ではフレーム同期マークを兼ねる．PC 側はバイ ト列を走査し，magic が現れた位置をフレーム先頭とみなして固定 20 バイトを 1 パ

ケットとして読む．

表 3.5 通信パケットの共通ヘッダ（先頭 12 バイト）
オフセット サイズ フィールド | 内容
0 | 2 B | magic | 固定のバイト列 0x4F 0x52（ASCII ”OR”）．バイト列
| | | のためエンディアンの対象外．プロトコル識別子兼
| | | フレーム同期マーク
2 | 1 B | version | プロトコルバージョン（現行 0x01）
3 | 1 B | type | パケット種別（1=CTRL，2=BEAT，3=NOTE）
4 | 4 B | seq | 送信側で単調増加させる連番．パケットロスの検出
| | | に使える
8 | 4 B | times-
| | tampMs | 送信時のマスタ時刻（指揮者の millis()）．楽器側の時
| | | 計同期に使う

30

表 3.6 型別ペイロード（共通ヘッダに続く 8 バイト） オフセット サイズ フィールド 内容

CTRL（type=1）：指揮者→楽器，20 Hz で定期配信
12 | 2 B | bpmQ8 | 演 奏 テ ン ポ． BPM を 8 倍 し た 整 数 （分 解 能
| | | 0.125 BPM．例：120.5 BPM → 964）．両 モ ー ド
| | | とも指揮者の実振り BPM を入れる
14 | 1 B | velocity | 強弱（0–127）．ストレッチ未実装時は固定値 64
15 | 1 B | state | 指揮者の状態（0=Idle，1=Calibrating，2=Conduct-
| | | ing，3=Fallback，4=ModeSelect）
16 | 1 B | mode | 動作モード（0=自由演奏，1=ゲーム）
17 | 2 B | tar-
| | getBpmQ8 | ゲームモードの目標テンポ．bpmQ8 と同じ 8 倍整
| | | 数表現．自由演奏モードでは 0
19 | 1 B | score | ゲームモードの採点値（0–100）．演奏中は途中経
| | | 過，曲終了後は最終スコア．自由演奏モードでは 0

BEAT（type=2）：指揮者→楽器，拍検出時に 2 連送
12 | 2 B | beatNo | 曲頭からの拍番号（巻き戻さず単調増加させる）
14 | 2 B | 予約 | ゼロ埋め
16 | 4 B | playAtMas-
| | terMs | この拍をマスタ時刻の何 ms に発音するかの指定

NOTE（type=3）：楽器→ PC，楽譜イベント発火時に USB Serial で送信
12 | 1 B | partId | 発音元パート（0x02〜0x06．金管 0x02〜0x05，ド
| | | ラム 0x06）
13 | 1 B | noteNumber | MIDI ノート番号（60=C4）．ドラムは GM ドラム
| | | マップとして解釈する
14 | 1 B | velocity | 強弱（0–127）．楽譜値と CTRL 値を合成した後の値
15 | 1 B | gate | 発音種別．現設計では常に1（NoteOn）．0（NoteOff）
| | | は将来拡張用の予約で，現設計では送らない（消音
| | | は PC 側の自動消音による）
16 | 2 B | durationMs | 発音予定の長さ．PC 側の自動消音に使う
18 | 1 B | instrumentId | PC 側で音色定義（音色 JSON）を選ぶ番号
19 | 1 B | 予約 | ゼロ埋め

CTRL パケットの mode・targetBpmQ8・score はゲームモード用の項目であり，現

行の試作版ファームウェアではゼロ埋めの予約領域である．ゲームモードの実装に 伴って有効化する．

31

3.3.4 楽譜データ形式

楽譜は ScoreEvent 構造体の配列 kScore[] としてプログラムメモリに埋め込み，

SD カード等の外部ストレージは使わない．1 イベントが 1 拍に対応し，曲頭から休 符込みで時系列順に並べる．各フィールドを表 3.7 に示す．テンポは楽譜に持たせ ず，CTRL で届く BPM から実時間へ変換する．

表 3.7 ScoreEvent（楽譜 1 イベント）のフィールド
フィールド | 型 | 意味
beatAt | uint16 | 何拍目かを示す参考値．発火条件には使わず，楽譜を読
| | みやすくするための冗長情報
noteNumber | uint8 | MIDI ノート番号．0 は休符
velocity | uint8 | 楽譜上の強さ（0–127）．CTRL の velocity と乗算合成
| | する
durationQ8 | uint16 | 発音長．1 拍の 1/256 単位で表す（256=1 拍，128=8 分
| | 音符）
flags | uint8 | bit0=NoteOn ／ bit1=NoteOff（拡張用）／ bit2=休符
sub 系 | uint8 ／
| uint16 | 細分音符（拍頭からずれて鳴る 2 音目）の音高・強さ・
| | オフセット・長さ．8 分音符などの表現に使う

発音長は，CTRL で届く BPM から durationMs = (60000/BPM)×(durationQ8/256) で実時間に換算する．楽譜は拍単位で記録するため，テンポが変わっても配列を書き 換える必要はない．
楽 譜 上 の 発 火 位 置 は，受 信 し た BEAT の beatNo か ら idx = (beatNo − 1 −

headRestBeats) mod kScoreLength で算出する（beatNo は 1 始まりのため −1 で 0 始まりに直し，headRestBeats はそのパートが演奏に入るまでの先頭休符の拍数）．

剰余演算により曲末から曲頭へ自動でループ再生される．各楽器ノードの partId と 入り拍は第 2 章の表 2.2 に示したとおりで，ファームウェアはこれらと楽譜配列だけ を差し替える．NoteOff パケットは送らず，PC 側が durationMs を読み取って自動消

音する．これは，Arduino 側から NoteOff を送る方式では USB Serial のバッファリ ングにより「音が鳴りっぱなし」になりやすいためである．

32

3.3.5 時刻同期方式

WiFi UDP マルチキャストの到達時刻には数ms〜十数ms のばらつき（ジッタ）が 乗る．これをそのまま発音に使うと楽器間の同期が運任せになる．本設計では，この ジッタを時計同期の誤差に押し付けることで，楽器間の相対的な発音タイミングを小 さく抑える．
中核となる考え方は，指揮者ノード（SoftAP）の millis() をマスタ時刻として全 ノードで共有することである．BEAT は「マスタ時刻 playAtMasterMs に発音せよ」と

いう未来時刻の指定として送る．楽器は自分の時計をマスタ時刻に変換するオフセッ トを学習し，変換後の時刻が指定時刻に達した瞬間に発音する．WiFi の到達時刻が ばらついても，全楽器が共通のマスタ時刻に揃うため発音タイミングは合致する． オフセットの推定には，共通ヘッダの timestampMs を用いる．楽器は CTRL ／

BEAT を受信するたびに「送信時のマスタ時刻と自時計の差」を 1 サンプルとして取 り出し，係数 0.10 の指数移動平均で平滑化する．CTRL が 20 Hz で常時流れるため， 数発でオフセットは収束する．

### 指揮者は BEAT 送出時に playAtMasterMs = masterNow + beatLookaheadMs（仮値

50 ms）を載せる．楽器は，指定時刻が未来なら到達まで待機し，受信が遅れて指定 時刻を過ぎていても捨てずに即発音する．指定時刻を過ぎたものを捨てる方式は， 通信のリトライや起動直後に「音が鳴らない」原因になりやすいためである．代わ りに BEAT を 2 連送し，どれか 1 発が指定時刻前に届けば発音が揃う構成とする． beatLookaheadMs は振り下ろしから発音までの固定遅延としてそのまま乗るが，映像

に対し音が遅れる方向のずれは許容されやすく，本用途では受け入れる．

3.3.6 PC 側ソフトウェア（Processing）

PC は楽器ノードごとに 1 台を割り当て，USB Serial で届くパケットを受け取って 音色を合成し，スピーカーへ出力する．実装言語は Processing 4 とし，現行の試作 版で動作している音色合成プログラムを原型として，本番では 1 台の PC が 1 台の楽 器を受け持つ．受信から発音までを，フレーム同期・受信キュー・発音管理・音色合 成の各段で設計し，音色定義は外部ファイルへ分離する． シリアル受信とフレーム同期：楽器ノードは 20 バイト固定長のパケットを USB Serial へ流す．Serial はバイトストリームでパケット境界を持たないため，受信側は 先頭 2 バイトの magic（バイト列0x4F 0x52）をフレーム同期マークとして走査する．

33 magic が現れた位置をフレーム先頭とみなして固定 20 バイトを 1 パケットとして取 り出し，途中でズレても次の magic で再同期する．切り出したパケットは type で振

り分け，NOTE は発音処理へ，ゲームモードで楽器ノードが中継する CTRL はモー ド・目標テンポ・スコアの更新へ回す．1 台の PC に複数の楽器ノードをつないで試 験できるよう，フレーム同期の状態はポートごとに独立して持つ． Serial スレッドの分離と受信キュー：Processing では，シリアル受信イベントが Serial スレッドで，画面描画が描画スレッドで動く．Serial スレッドから直接発音を 操作すると描画スレッドと競合し，音切れやイベントの取りこぼしを招く．そこで Serial スレッドは 20 バイトが揃ったパケットをスレッドセーフな受信キューへ積む だけにとどめ，発音処理は描画スレッドが毎フレームの冒頭でキューを空にしてまと めて行う．発音に関わる処理を描画スレッド 1 か所へ集約することで，タイミングに 敏感なボイス操作の競合を構造的に避ける．
発音（Voice）の管理：NOTE 1 件につき発音単位（Voice）を 1 つ生成する．各 Voice は durationMs から自動消音の時刻を持ち，到達したらリリースへ移って減衰

後に破棄する．楽器ノードは NoteOff を送らない設計のため，消音はこの PC 側の自 動消音に一本化される．同時発音数には上限（仮値 24）を設け，超過時は最も古い 発音を強制的にリリースして処理の破綻を防ぐ．輪唱では複数声部が重なって鳴るた め，このポリフォニックな発音管理が前提となる．
音色合成：NOTE の noteNumber を周波数へ変換し，倍音を重ねた波形に ADSR エ

ンベロープを掛けて 1 音を合成する．倍音加算合成に加え，倍音周波数を整数比から 少しずらす非調和性，ビブラート・トレモロ，スペクトル整形ノイズを重ねて実楽器 に近い音を作る．金管音色の合成パラメータの初期値を表 3.8 に示す．

表 3.8 金管音色の合成パラメータ（初期値）
要素 | 初期値と方針
倍音構成 | 基音から第 7 倍音までを重ねる．振幅比は 1.00 ／ 0.70 ／ 0.50 ／
| 0.30 ／ 0.20 ／ 0.10 ／ 0.05
ADSR エンベ ロープ | Attack 20 ms ／ Decay 40 ms ／ Sustain 0.75 ／ Release 60 ms．
| Sustain は velocity でスケールする
ドラム音色 | 金管とは別に短い減衰音として合成し，noteNumber で Kick ／ Snare
| ／ Hi-hat 風に切り替える

34

音色定義の外部化：音色は 1 楽器 1 ファイルの JSON として data/配下に外部化す る．楽器ノードが送る instrumentId は，data/内の JSON をファイル名昇順に並べた

ときの番号に対応する．倍音構成・エンベロープ・ノイズ・ビブラートといった合成 パラメータを JSON 側へ追い出すことで，楽器の追加・差し替えをファイルの増減だ けで行え，Processing 本体のコードは変更しなくてよい．音色そのものの解析・調 整は，別途用意する音色解析用の環境で行う．

3.3.7 画面とゲーム UI の設計

PC の画面は，演奏のモニタリングとゲームの進行表示を兼ねる．第 2 章の表 2.8 に示した PC の状態に対応して，モード待機・演奏・結果の 3 系統の画面を切り替え る．ゲーム関連の表示に必要なモード・目標テンポ・スコアは，楽器ノードが中継す る CTRL から得る．現行の試作版では PC は NOTE だけを受け取るが，ゲームモー ドでは楽器ノードが受信した CTRL を専用 PC へも転送し，PC は CTRL の mode・ targetBpmQ8・score を読んで画面へ反映する．新しいパケット種別や Serial の追加

配線は要らない．
モード待機画面（ModeWait）：起動して Serial ポートに接続した直後の初期画面． 指揮者が動作モードを選んでいる間に表示し，操作の案内（自由演奏が既定で，大き く 1 回振るとゲームモード，数秒静止で確定）と，CTRL で届いた選択中のモードを 示す．指揮者が Conducting へ入って演奏が始まると演奏画面へ移る． 演奏画面（Playing）：演奏中の主画面．両モード共通の演奏モニタとして，受信状 況・声部ごとの直近の NOTE・出力波形・読み込み済みの音色定義一覧・Serial ポー トの一覧を表示する．ゲームモードではこれに加えて，現在モード・目標テンポ・メ トロノーム・現在スコアを重ねて表示する．自由演奏モードではゲーム用の表示要素 は出さない．
メトロノーム表示：ゲームモードの演奏画面では，目標テンポ（targetBpmQ8）に

合わせてメトロノームを描画し，クリック音を鳴らす．これは指揮者ノードの LED 明滅とともに，目標テンポを指揮者へ提示するガイドの一部である．ガイドの強度は 曲の経過に対する固定のスケジュールで 1.0 から 0 へ減衰させる．フェードのスケ ジュールは指揮者ノードと PC で共通の規則とするため，強度を通信で送る必要はな く，PC は自分の進行位置から強度を再現できる（採点とガイドの考え方は 3.4 節で 述べる）．曲の前半はメトロノームを濃く，終盤は薄く，最後は消す．

35

結果画面（Result）：ゲームモードで 1 曲を終えると結果画面へ移り，CTRL の score が示す最終スコア（0–100）と簡単な評価を表示する．自由演奏モードはこの

画面を経由しない．結果画面からは次の曲・モード選択へ戻れるようにする．各画面 の主な表示要素を表 3.9 にまとめる．

表 3.9 PC（Processing）の画面と表示要素
画面 | 対応する状態 主な表示要素
モード待機画面 | ModeWait | モード選択の操作案内，選択中のモード，接続中のポート
演奏画面 （共通） | Playing | 受信状況，声部ごとの直近 NOTE，出力波形，音色定義
| | 一覧，ポート一覧
演奏画面 （ゲーム） | Playing | 上記に加え，現在モード・目標テンポ・メトロノーム・現
| | 在スコア
結果画面 | Result | 最終スコア（0–100）と評価，次の曲・モード選択への
| | 導線

## 3.4 処理フローの設計

3.4.1 3 フェーズ実行モデル

全ノード共通で，loop() は「入力→ロジック→出力」の 3 フェーズを毎周期この 順で実行する（表 3.10）．入力モジュールは SystemData へ書き込み，出力モジュー ルはこれを読み取る．モジュール同士の直接呼び出しは禁止し，結合は SystemData の一点に閉じる．OrcNetModule は入力・出力の両配列に登録し，「入力フェーズで先

に受信し，出力フェーズの最後で送信する」よう配列順で制御する．

表 3.10 loop() の 3 フェーズ実行順序
フェーズ | 処理内容
1. 入力 | 入力モジュールを順に updateInput() で呼ぶ．センサ値や UDP 受信結
| 果が SystemData に書き込まれる
2. ロジック | applyPattern() を 1 度呼ぶ．フィルタ・拍検出・状態遷移・楽譜進行は
| すべてここに集約する
3. 出力 | 出力モジュールを順に updateOutput() で呼ぶ．LED 表示・UDP 送信・
| Serial 送出が反映される

36

3.4.2 指揮者ノードの処理フロー

指揮者ノードのロジック applyPattern() は，毎周期おおむね次の順で処理する．

1. 信号前処理：IMU の加速度を一次ローパスフィルタ（係数 0.10）で平滑化し，ノ ルムを計算する．キャリブレーション中に採った静止時ノルムを差し引き，振り の強さを表す動加速度を得る．
2. 拍検出：動加速度から振り下ろしを検出する（次段落）．
3. テンポ推定：拍間隔から瞬時 BPM を求め，指数移動平均（係数 0.30）で平滑化 する．40〜240 BPM の範囲にクランプする．
4. 状態遷移：Idle → ModeSelect → Calibrating → Conducting と進み，IMU また は WiFi の異常で Fallback へ落ちる．ModeSelect では規定モーションを判定し て動作モードを確定する．
5. 採点（ゲームモードのみ）：ゲームモードのとき，検出した拍間隔と目標拍間隔 の誤差を集計してスコアを更新する（次項）．
6. 出力反映：状態に応じて LED の点滅を設定し，CTRL ／ BEAT の送信内容を組 み立てる．CTRL にはモード・目標テンポ・スコアも載せる．ゲームモードの Conducting 時は LED の明滅でメトロノームガイドを兼ねる．

拍検出では，単純なピーク閾値判定だと「ピーク後の発火で振りと音がずれる」「振 り戻しを 2 拍目に拾う」「軽い揺れで誤発火する」といった問題が出る．これを構造 的に避けるため，ゲート式ステートマシン（Idle ／ Armed の 2 状態）を用いる．動 加速度ノルムが閾値（1.20 g）を超えると Armed に入り，Armed 中だけ動加速度を 時間積分して擬似的な振りの経路長を求める．経路長が 0.20 m に達した瞬間に拍を 発火するため，ピークを待たず早期に発火でき，振りと音のずれが小さい．発火後は 350 ms の不応期を設け，振り戻しの誤検出を防ぐ．判定をスカラーの動加速度ノル ムで行うため，振る向き（縦・横・斜め）にほとんど依存しない．閾値 1.20 g・経路 長 0.20 m・不応期 350 ms は設計上の初期値であり，実機計測で振り方の個人差に 合わせて再調整する．
出力では，拍を検出した周期に BEAT を送信予約し，playAtMasterMs に発音指定

時刻を載せる．CTRL は 20 Hz の頻度で常時送信予約する．実際の UDP 送信は，出 力フェーズ後段の OrcNetModule が担当する．

37

3.4.3 ゲームモードの採点とメトロノームガイド

ゲームモードでは，指揮者が目標テンポをどれだけ正確に維持できたかを指揮者 ノードが採点する．目標テンポは 1 曲につき 1 つ固定で与え，演奏テンポ（CTRL の bpmQ8）は両モードとも指揮者の実振り BPM のまま変えない．目標テンポは採点と

ガイドの基準としてのみ用いるため，楽器ノードの楽譜進行ロジックはモードを意識 せずに動く．
メトロノームガイド：曲頭では，目標テンポを刻むガイドを指揮者へ提示する．ガ イドは node_01 の LED 明滅と楽器側 PC のクリック音から成る．ガイドの強度は曲 の経過に対してあらかじめ定めたスケジュールで 1.0 から 0 へ減衰させ，曲の前半は ガイドあり，終盤はガイドなしとする．フェードのスケジュールは 1 曲を通して固定 であり，node_01 と PC はそれぞれ同じ規則でガイド強度を再現できるため，強度を 通信で送る必要はない．指揮者は終盤，記憶を頼りに目標テンポを維持する． 採点：各拍で，実際の振り間隔と目標拍間隔（60000/目標 BPM ms）との差の絶対 値を誤差とする．誤差はそのまま足し込まず，その拍でのガイド強度が低いほど大き な重みを掛けて集計する．ガイドが濃い曲頭の乱れは軽い減点に，ガイドが消えた終 盤の乱れは重い減点にすることで，自力でテンポを保つ難所を厚く評価する．集計し た重み付き誤差を 0–100 のスコアへ写像し，CTRL の score フィールドへ毎周期載

せる．楽器ノードはこれを専用 PC へ中継し，PC が演奏中のスコアと曲終了後の結 果画面を描画する（PC 側の画面設計は 3.3.7 節に示す）．

3.4.4 楽器ノードの処理フロー

楽器ノードのロジック applyPattern() は，受信した BEAT を起点に次の処理を行

う．このうち楽譜進行と NOTE 送信の主経路を図 3.2 に示す．

1. 時計同期：受信した CTRL ／ BEAT の timestampMs と自時計の差を，指数移動平

均（係数 0.10）で平滑化し，マスタ時刻へのオフセットを更新し続ける．

2. 状態遷移：WiFi 接続で WaitStart へ，最初の BEAT 受信で Playing へ遷移する．
3. 発音判定：保留中の BEAT について，発音指定時刻 playAtMasterMs をマスタ時

刻が過ぎたら発火する．受信が遅れて指定時刻を過ぎていても捨てずに即発火 する．

38

4. 楽譜進行：発火した BEAT の beatNo から楽譜位置を算出する．入り拍に達して

いなければ何も鳴らさない（輪唱の入り待ち）．BEAT を取りこぼしても，次の BEAT の beatNo から算出される位置が正しいため自己修復する．これは，弾き

飛ばしを含む演奏にも追従できる楽譜追跡の考え方 [5] と同様に，拍番号を曲頭 からの絶対位置として扱うことで取りこぼしを後続へ波及させない設計である．

5. 音符生成：その位置が休符でなければ，楽譜 velocity と CTRL velocity を乗算合 成し，NOTE の発音情報を組み立てる．
6. 出 力 反 映：状 態 に 応 じ て LED を 更 新 す る．NOTE は 出 力 フ ェ ー ズ で NoteSenderModule が 20 バイトのバイナリとして Serial へ送出する．

39


図 3.2 楽器ノードの楽譜進行と NOTE 送信の処理フロー

40

## 3.5 テストの設計

本節では，設計が満たすべき数値目標と，それを段階的に確認する検証の方向性， および実機検証で詰める仮値を示す．具体的な試験ケースや計測手順は実装フェーズ で確定する．

3.5.1 設計目標値

本システムの設計が狙う数値目標を表 3.11 に示す．これらは「テストの合否基準」 ではなく，設計判断の前提として置いた値であり，実機計測で再調整する想定で ある．

表 3.11 設計目標値
項目 | 目標値 | 根拠・位置づけ
楽器間の同期誤差 | ≤ 20 ms | チームで議論して定めた有効性指標．数十ms 程度
| | のずれは聴き手にほぼ気づかれないという知見から
| | 安全側に設定した
拍検出の正解率 | ≥ 90 % | 定速指揮時に演奏が破綻しない実用水準として置
| | いた
テンポ追従の遅延 | ≤ 2 拍 | 人間の演奏者が BPM 変化に追従するのと同等を最低
| | 水準とした
入力フェーズの CPU 時間 | ≤ 2 ms | IMU を約 200 Hz（制御周期 5 ms）で取りこぼさず読
| | むには，入力・ロジック・出力の 3 フェーズの合計
| | を 5 ms 以内に収める必要がある．入力フェーズはそ
| | の一部として 2 ms を上限の目安とする
起動時間 | ≤ 5 s | WiFi 接続・DHCP に 2〜3 秒，キャリブレーションに
| | 2 秒を見込む
強弱制御（スト レッチ） | 3 段階以上 | p ／ mf ／ f の 3 段階で初級〜中級曲のダイナミクス
| | を再現する

3.5.2 検証の方向性

設計の妥当性は，実装後に「単体→結合→実機」の 3 段階で確認していく方針と する．

41

- 単体：判断ロジックを IModule 派生ではなく applyPattern() 関数に書くため， SystemData をテスト側で組み立てて関数を呼ぶだけで，拍検出・テンポ推定・楽

譜進行・時計同期のロジックを切り出して確認できる．パケットのシリアライズ もバイト列のラウンドトリップで確認する．

- 結合：指揮者ノード単体→指揮者＋楽器 1 台→指揮者＋楽器 5 台，と接続規模を 段階的に広げ，BEAT 受信から NOTE 出力までの経路と，5 台の発音タイミング差 を確認する．
- 実機：全ノードと PC で実音を再生し，指揮の速度・振幅を変えたときのテンポ追 従と強弱の挙動を，聴感と計測の両面で確認する．BEAT を意図的に一部破棄した 条件での演奏継続もこの段階で確認する．PC 側の Processing は，ビルド確認・ NOTE 復号・自動消音・同時発音数の上限などを個別に確認する．

3.5.3 実機検証で確定する仮値

設計値のうち，実機での段階的な結合確認で詰めるもの，および楽譜・音色の仕様 確定を待って実装するものを表 3.12 に示す．

表 3.12 実機検証で確定する主な仮値・未確定事項
項目 | 現状と確定の見極め
BEAT の連送回数 | 仮値 2 連送．結合確認でパケットロスと同期誤差を見て 1〜3 連送で
| 調整する
lookahead 時間 | 仮値 50 ms．振り→音の体感遅延と，遠い楽器の到達率を見て 30〜
| 80 ms で調整する
時計同期の平滑化 係数 | 仮値 0.10．オフセットの収束時間と定常ジッタを見て 0.05〜0.20 で
| 調整する
片道遅延の系統差 | 5 台でほぼ同程度と仮定し補正なし．系統差が無視できなければ往復
| 測定で各台を較正する
WiFi の STA 省電 力モード | 無効化して運用する．無効化できない場合は lookahead を拡大して配
| 送遅延を吸収する
WiFi チャネル | 仮値 6．会場の電波状況を調査して空きチャネルへ変更する
強弱推定（スト レッチ） | 現状は velocity 固定 64 のスタブ．必達機能の完成後に振り幅→
| velocity の写像を実装する
ドラムパート （node_06） | 金管と同じ ScoreEvent で実装する．noteNumber は GM ドラムマッ
| プに固定する

42

## 参考文献

[1] 川合雄佑，伊藤彰教，「非接触型電子楽器の開発を通じたサウンドデザイ ン」，東京工科大学メディア学部，先端芸術音楽創作学会会報，Vol. 14, No. 1,

pp. 14–19, 2022.

### [2] 任天堂株式会社，「Wii Music 公式サイト」，https://www.nintendo.co.jp/wii/

r64j/index.html，2008（2026-04-28 (https://www.nintendo.co.jp/wii/r64j/index.html) 閲覧）.

[3] 河瀬諭，「合奏における演奏者間コミュニケーション――タイミング調整とそ

の手がかり――」，心理学評論，Vol. 57, No. 4, pp. 495–510, 2014.
[4] 久松剛，「分散環境におけるフィードバックを用いたオーケストラ演奏機構の 構築」，慶應義塾大学 環境情報学部 卒業論文，2003.
[5] 中村栄太，武田晴登，山本龍一，齋藤康之，酒向慎司，嵯峨山茂樹，「任意箇所 への弾き直し・弾き飛ばしを含む演奏に追従可能な楽譜追跡と自動伴奏」，情

報処理学会論文誌，Vol. 54, No. 4, pp. 1338–1349, 2013.
[6] 竹内英世，梅崎太造，保黒政大，「カラオケ採点用の高分解能ピッチ抽出法」，

電気学会論文誌 C，Vol. 129, No. 10, pp. 1889–1901, 2009.

43

# 第 4 章 生成 AI の利用

本書（計画書・設計書）の執筆にあたり，生成 AI として Claude（Anthropic）を 補助的に利用した．提出規約上，本書について生成 AI 利用申告書の提出が明示的に 求められているわけではないが，透明性のため，利用の範囲をここに簡潔に記して おく．
利用方法は対話を通じた共同執筆である．章立て・図表の構成・文章表現の選び方 や，記述の重複や冗長の整理について生成 AI と繰り返し議論し，提案された文案を 著者が精査・修正・取捨選択しながら本書の形にまとめた．設計判断そのもの，すな わちピン配置・通信プロトコル・状態遷移・採点方式などの技術的内容は，著者が自 ら設計・検証したものを正としており，AI の出力をそのまま採用した箇所はない． AI の出力に対しては，本プロジェクトで全ノードに採用した構成手法 Embedded-

Module-Architecture（EMA）の方針，および Arduino ／ ESP32 の実装制約と整合 するかを著者自身がレビューし，事実誤認や設計と食い違う記述は都度書き換えた． 本書に残る記述の妥当性および誤りの責任は，すべて著者が負う．

45
