takushio2525/2026-hackathon-team23/meetings/0415_1回/23_第1回議事録_24G1131-1776302030881.pdf

# 2026年度 第1回ハッカソン議事録

チーム番号 | 23
チームメンバー | 片岡聖，地曵賢人，御代川稜，梅澤颯太，齋藤翔太，塩澤匠生，
チーム学籍番号 | 24G1038，24G1175，24G1131，25G1021，25G1053，25G11065
| 2026 年 4 月 15 日

## 1 目標設定

Arduino を 5 つ使う．そのため，1 つは指揮者として使用して他は楽器を 4 つで使用．

→指揮によっては倍速になる．

→できたら，大きさやビブラートにも着手する．

ここしかない独創性がある！

楽器は金管楽器

通信方法は UDP にす．去年の関根先生の案から，誤差がたくさんでたら変更も視野にいれる．

→独自のプロトコルを開発する．

## 2 役割担当

ドレミファソラシドなどの音階は斎藤．

Procession は梅澤．

指揮者用の Arduino は塩澤．

議事録担当は御代川→地曵→片岡の順で回していく．
