takushio2525/2026-hackathon-team23/work/saito/week1/事前課題.pdf

# 6 軸慣性センサを用いた直感的な指揮システムの提案

25G1053 齋藤翔太

2026 年 4 月 21 日

## 1 社会的背景と技術的課題

近年，DTM（デスクトップミュージック）の普及により，作曲，編曲，録音，編集，ミキシング， マスタリングまでの音楽制作全般が個人のコンピュータ上で誰でも行えるようになったが，一方 で，人間らしいテンポの揺らぎや，微妙な音の強弱などの「人間らしさ」を表現することが難しい． そのような「人間らしさ」を表現する方法の一つとして，身体動作による音楽表現がある．身体 動作によって直接楽器を演奏できる仕組みは，個人の演奏の幅を広げる可能性を大いに秘めてい る．しかし，身体動作を音楽表現に変換には，精度やコストなどの技術的な課題は多い．

## 2 既存のシステム

既存技術として，テルミンやセンサを用いた身体動作を音楽表現に変換するシステムがある．

1. テルミン：楽器の 2 本のアンテナから発する電波を，演奏者が手を近づけたり遠ざけたりする 動きにより，音程・ボリュームを変化させることで，手を触れずに演奏する非接触楽器である

[1]．
2. カメラを用いたシステム：カメラで身体動作を捉え，画像処理技術を用いて音楽表現に変換す るシステムである [2]．

しかし，これらの楽器やシステムには，演奏技術の高さや，明暗などの環境条件に影響されるなど の課題がある．

## 3 提案するアイディア

そこで，6 軸センサを用いた身体動作を音楽表現に変換し，指揮者の動きに合わせて音楽のテン ポや強弱を変化させるシステムを提案する．6 軸センサと通信用 Arduino を組み合わせた指揮棒の 用い，振る大きさによって強弱を，振る速さによってテンポを変化させる．このシステムは，セン

1

サを用いることで，演奏者の動きを高精度に捉えることができ，環境条件の影響を受けにくいとい う利点がある．さらに，指揮者の動きに合わせて音楽のテンポや強弱を変化させることで，演奏者 の表現力を高めることができる．提案する指揮システムは，演奏用 Arduino4 台とセンサを組み合 わせて構築する．通信には UDP を用い，センサからのデータをリアルタイムで音楽表現に変換す ることで，演奏用 Arduino が即座に反応できるようにする．

## 参考文献

[1] テルミン研究所, テルミンとは？, https://thereminlab.com/whatstheremin/.
[2] Semi-Conductor,Experiments | with | Google,https://experiments.withgoogle.com/

semi-conductor.

2
