takushio2525/2026-hackathon-team23/work/shiozawa/work-0525/作業ログ0525/事前課題提出（25G1065：塩澤匠生）.pdf

# 作業ログ

報告者：塩澤 匠生

報告日：2026 年 5 月 25 日

プロジェクト名：タクトーン IMU ジェスチャーで奏でる Arduino オーケストラ

## 1. 進捗サマリー（要約）

- 全体進捗率：25%（基礎技術検証フェーズの途中．4 ノード同期試験でパケロスが顕在化し停滞）
- マイルストーン達成状況：
- IMU モーション取得・回路結線・WiFi UDP 通信：達成
- 4 ノード同期試験（test v1）：未達（時刻同期は到達したがパケロスにより安定発音に至らず，進捗

70%）

- 主要成果：
- 指揮者ノード（XIAO ESP32-S3 Sense + GY-521 IMU）で振り下ろしによる拍検出を実装
- 自前プロトコル（CTRL ／ BEAT ／ NOTE の 3 種パケット）を WiFi UDP マルチキャストで配信
- マスタクロック方式＋ EMA 時計同期で楽器間の時刻ズレを実用範囲に収束
- 重大課題（影響度：高）：
- [UDP マルチキャストのパケロスにより，楽器ノードへの NOTE ／ BEAT が一部到達せず，4 ノード

同期試験で発音が抜ける／拍が遅れる症状が発生．マルチキャストは ACK と再送が無いため，シー ケンス番号付与＋同一パケットの連送，もしくは NOTE のユニキャスト分離で吸収する方針を検討中 （未解決・対応中）]

## 2. 作業ログ（詳細トラッキング）

作業項目 | 開始日 | 予定完了日 | 状態 | 進捗 | 依存関係・ブ
| | | | | ロッカー

コメント

IMU モーション
取得
2026-04-29 | 2026-05-05 | 完了 | 100% | なし | GY-521 を I2C 接
続し加速度ピーク
から振り下ろしを
検出
回路結線・動作確
認
2026-04-29 | 2026-05-06 | 完了 | 100% | 部材調達 | XIAO の D4 ／ D5
を SDA ／ SCL に
割当，AD0=GND
で I2C アドレスを

0x68 固定

WiFi UDP 通信 | 2026-05-03 | 2026-05-10 | 完了 | 100% | IMU 完了 | SoftAP | 起 動 ，

239.0.0.1:5001 マ
ル チ キ ャ ス ト で

CTRL ／ BEAT
／ NOTE を配信
4 ノード同期試験

（test v1）

2026-05-10 | 2026-05-31 | 進行中 | 70% | WiFi 完了 | マスタクロック方
式＋ EMA で時刻
ズレは収束したが，
パケロスにより安
定発音に至らず停
| | | | | | 滞
パケロス計測・対
策
2026-05-22 | 2026-05-31 | 進行中 | 30% | 同期試験継続 | シーケンス番号と
受信ログで欠落率
を計測，連送／ユニ
キャスト分離の有
効性を検証中

## 3. 課題管理

課題 | 発生原因 | 影 響
度

優 先
度
対策 | 期限 | 状態

UDP マルチキャス
トのパケロス

802.11 マルチキャス

トは Basic Rate（低
レート）でブロード
キャストされ ACK・
再送が無いため，SoftAP 配下で楽器ノー
ド数が増えるとパケ
ットの取りこぼしが
発生する．4 ノード
同期試験で NOTE
／ BEAT の欠落と
して顕在化
高 | 高 | シーケンス番号を付
| | 与し同一パケットを
| | 2～3 回連送，受信側
| | で重複排除．効果が
| | 薄ければ NOTE を
| | 楽器ごとのユニキャ
| | ストへ分離する案を
| | 検討
2026-05-31 | 対応中

WiFi 到達時刻のば
らつき

無線到達時刻が数十
ms 単位でばらつく
ため，楽器ごとに発
音が前後して聞こえ
る
中 | 中 | マスタクロック方式
| | （指揮者の millis() を
| | 共有）と EMA 時計
| | 同期で吸収．BEAT
| | に発音目標時刻を載
| | せて送出
2026-05-18 | 解決

XIAO 内 蔵 LED
の極性

GPIO21 が active
LOW であり，HIGH
書き込みで消灯する
低 | 低 | 設 | 定 | で

activeLow=true を
指定し，コード側は
論理レベルで扱う

2026-05-10 解決

※影響度＝プロジェクトへのインパクト

※優先度＝対応の緊急性

## 4. AI 利用状況と検証 (再現性重視)

### 4.1 利用内容

- 利用目的：パケロス対策の方針検討，UDP 信頼化手法の整理，ESP32 SoftAP のマルチキャスト挙動の 確認
- 入力（プロンプト要旨）：
- [802.11 マルチキャスト／ブロードキャストが Basic Rate で送出される件と，SoftAP 配下での取り こぼし傾向の整理]
- [UDP 上で簡易な信頼性を持たせる方式の比較（シーケンス＋連送，選択的再送，FEC）]
- [NOTE のように欠落が即音抜けにつながるパケットを，ユニキャストへ分離した場合の負荷見積もり]

- 出力概要：
- [マルチキャストは ACK が無く，SoftAP では送出レートが Basic Rate に固定されるため，RSSI が 低い端末ほど取りこぼしが出やすいとの説明]
- [「全パケットを 2～3 回連送＋シーケンス番号で重複排除」が最も実装コストが低い，との整理]
- [NOTE のみユニキャスト化する場合，楽器ノードの IP 取得と送信先テーブルが必要となり，CTRL ／ BEAT はマルチキャスト維持が現実的，との示唆]

### 4.2 検証方法

※第三者が再現できるレベルで記述

- 検証手法：
- [各楽器ノードでシーケンス番号と受信時刻をシリアル経由で記録し，欠落率と欠落タイミングを集計]
- [連送あり／なしで欠落率を比較し，可聴な音抜けが残るかを実演で確認]
- 検証手順：
1. node 01 で CTRL ／ BEAT ／ NOTE にシーケンス番号を付与し，4 ノード同期試験を 60 秒間連 続で実行する
2. node 02 ／ 03 ／ 04 の受信側で，種別ごとに受信シーケンスをシリアルへログ出力する
3. ログを Python で集計し，欠落数・欠落位置・RSSI との相関を表に整理する
4. 同一パケットの 2 回連送を有効化し，同じ手順で欠落率を再計測する
5. Mac 上の Processing で発音される音の抜けを聴感でも確認する

### 4.3 ファクトチェック結果

- 一致点：
- [マルチキャストが Basic Rate で送出され，SoftAP 配下の端末では取りこぼしが起きやすい点は Espressif の説明や一般的な WiFi の挙動と整合]
- [「シーケンス番号＋連送」によるパケロス吸収は LAN 上の合奏／同期演奏系の事例でも採用例があ り，実装容易性が高い]
- 不一致・疑義：
- [AI 出力には「マルチキャスト送出レートを 802.11g/n の上位に固定する」案もあったが，ESP-IDF 経由で確実に変更できる API が見当たらず，実機での再現性が担保できないため不採用]
- [FEC（Reed-Solomon 等）は実装負荷の割に得られる効果が連送と大差ない見積もりとなったため不 採用]
- 最終判断：
- 採用（シーケンス番号付与＋同一パケットを 2～3 回連送，受信側で重複排除．効果が不足する場合の み NOTE をユニキャスト分離）
- 根拠：
- [実機計測で欠落率と聴感の双方を確認したうえで採用判断する．結果は ADR-0007 に明文化する]

## 5. 次回計画

- 目標：
- [シーケンス番号＋同一パケットの連送をプロトコルに組み込み，4 ノード同期試験で安定発音に到達 させる]
- [対策が固まった段階で本番想定構成（楽器 5 台，金管 4 ＋ドラム）でも同等の安定性が得られるか確 認する]
- 達成基準：
- [4 ノード構成で NOTE の欠落率 1% 未満（連送有効化後）]
- [30 秒以上の連続送出で，PC 側の発音に欠落が認められない]
- 期限：
- [2026 年 5 月末を目安に対策実装と再計測，6 月以降は本番想定構成（楽器 5 台）の準備に移行]

## 6. その他

- [同期誤差（時刻ズレ）とパケロス（パケットの取りこぼし）は別問題として切り分ける．前者は EMA で 吸収済，後者はアプリケーション層の対策が必要]
- [楽器ノードのシリアルは NOTE バイナリパケットを PC 側 Processing へ流すため SERIAL DEBUG=0 を既定とする．パケロス計測時のみ一時的に有効化する]
- [実機未テストのファームウェアに対する机上修正は同期挙動を逆転させるリスクがあるため，必ず実機書

き込みでの確認を経て取り込む]

## 7. 付録

- 添付資料：
- ソースコード：firmware/test v1/（node 01～node 04 と共通ライブラリ common/）
- PC 側アプリ：pc app/test v1/orchestra player/（MIDI 風発音）
- GitHub リポジトリ：https://github.com/takushio2525/2026-hackathon-team23
- 設計判断記録：ADR-0002（プロトコル選定），ADR-0003（IMU 採用），ADR-0006（同期誤差 20 ms），ADR-0007（パケロス対策方針／起票予定）
- リポジトリ閲覧の要検討事項：
- [上記 GitHub リポジトリは現在プライベート設定のため，TA・教員など第三者からは閲覧できない． 採点・レビューを成立させるには以下のいずれかの対応が必要]
- [案 A：個人情報・授業内情報が含まれることを承知のうえでパブリックリポジトリへ変更する]
- [案 B：採点用アカウントを共同開発者（Collaborator）として招待し，プライベート設定のまま閲覧

権限を付与する]

- 添付範囲：
- 差分（test v1 の 4 ノード同期試験までを実装し，パケロス対応に入った直近時点のスナップショット）
