takushio2525/2026-hackathon-team23/work/shiozawa/work-0422/提出用計画書/plan_template.pdf

2026 年 4 月 29 日 Version 0.1

# Arduino

# オーケストラ

# 〜計画書と設計書〜

## チーム 23

25G1065 : 塩澤 匠生

目次

第 1 章 | システムの基本設計・・・・・・・・・・・・・・・・・・・・・・・・・・・・・・・・・・ | 1
1.1 | 機能一覧・・・・・・・・・・・・・・・・・・・・・・・・・・・・・・・・・・・・・・・・・ | 1
1.1.1 | 機能分解（FBS） ・・・・・・・・・・・・・・・・・・・・・・・・・・・・・・・・・・ | 1
1.1.2 | 機能と性能指標（MOP）の対応 ・・・・・・・・・・・・・・・・・・・・・・・・・ | 2
1.1.3 | 各 MOP 目標値の根拠 ・・・・・・・・・・・・・・・・・・・・・・・・・・・・・・・ | 2
1.2 | システム構成図・・・・・・・・・・・・・・・・・・・・・・・・・・・・・・・・・・・・・ | 4
1.2.1 | 全体ブロック図 ・・・・・・・・・・・・・・・・・・・・・・・・・・・・・・・・・・・ | 4
1.2.2 | ノード役割分担 ・・・・・・・・・・・・・・・・・・・・・・・・・・・・・・・・・・・ | 4
1.2.3 | データフロー・・・・・・・・・・・・・・・・・・・・・・・・・・・・・・・・・・・・・ | 5
1.2.4 | 採用アーキテクチャ（EMA）の方針 ・・・・・・・・・・・・・・・・・・・・・・ | 6
1.3 | 操作インターフェース設計・・・・・・・・・・・・・・・・・・・・・・・・・・・・・・ | 6
1.3.1 | ユーザー操作・・・・・・・・・・・・・・・・・・・・・・・・・・・・・・・・・・・・・ | 6
1.3.2 | LED 表示仕様 ・・・・・・・・・・・・・・・・・・・・・・・・・・・・・・・・・・・・ | 6
1.3.3 | 通信プロトコル方針（CTRL / BEAT / NOTE）・・・・・・・・・・・・・・・・ | 7
1.3.4 | 通信方式（WiFi UDP + USB Serial の二系統）・・・・・・・・・・・・・・・・ | 8
1.3.5 | パケロス・ジッタ対策 ・・・・・・・・・・・・・・・・・・・・・・・・・・・・・・・ | 9
1.4 | 状態遷移図 ・・・・・・・・・・・・・・・・・・・・・・・・・・・・・・・・・・・・・・・ | 9
1.4.1 | 指揮者ノード（node_01） ・・・・・・・・・・・・・・・・・・・・・・・・・・・・ | 9
1.4.2 | 楽器ノード（node_02〜05） ・・・・・・・・・・・・・・・・・・・・・・・・・・ | 10
第 2 章 | システムの詳細設計・・・・・・・・・・・・・・・・・・・・・・・・・・・・・・・・・・ | 13
2.1 | 部品一覧・・・・・・・・・・・・・・・・・・・・・・・・・・・・・・・・・・・・・・・・・ | 13
2.2 | ハードウェア設計 ・・・・・・・・・・・・・・・・・・・・・・・・・・・・・・・・・・・ | 15
2.2.1 | 配線・ピン ・・・・・・・・・・・・・・・・・・・・・・・・・・・・・・・・・・・・・・ | 15
2.2.2 | ネットワーク構成・・・・・・・・・・・・・・・・・・・・・・・・・・・・・・・・・・ | 15
2.2.3 | 物理配置 ・・・・・・・・・・・・・・・・・・・・・・・・・・・・・・・・・・・・・・・ | 16
2.3 | ソフトウェア設計 ・・・・・・・・・・・・・・・・・・・・・・・・・・・・・・・・・・・ | 16
2.3.1 | ファイル構成・・・・・・・・・・・・・・・・・・・・・・・・・・・・・・・・・・・・・ | 16
2.3.2 | オブジェクト設計（クラス図） ・・・・・・・・・・・・・・・・・・・・・・・・・ | 17
2.3.3 | 関数設計 ・・・・・・・・・・・・・・・・・・・・・・・・・・・・・・・・・・・・・・・ | 18
2.4 | 処理フローの設計 ・・・・・・・・・・・・・・・・・・・・・・・・・・・・・・・・・・・ | 26
2.4.1 | 共通: 3 フェーズ実行モデル ・・・・・・・・・・・・・・・・・・・・・・・・・・・ | 26

2.4.2 | 指揮者ノード（node_01） ・・・・・・・・・・・・・・・・・・・・・・・・・・・・ | 26
2.4.3 | 楽器ノード（node_02–05） ・・・・・・・・・・・・・・・・・・・・・・・・・・・ | 30
2.5 | テストの設計 ・・・・・・・・・・・・・・・・・・・・・・・・・・・・・・・・・・・・・・ | 35
2.5.1 | 試験戦略（単体 → 結合 → システム）・・・・・・・・・・・・・・・・・・・・・ | 35
2.5.2 | 試験項目（TPM）・・・・・・・・・・・・・・・・・・・・・・・・・・・・・・・・・・ | 36
2.5.3 | 要求 → 検証の対応 ・・・・・・・・・・・・・・・・・・・・・・・・・・・・・・・・・ | 37
2.5.4 | 実機検証で確定する未確定事項 ・・・・・・・・・・・・・・・・・・・・・・・・・ | 38
第 3 章 | 生成 AI の利用について・・・・・・・・・・・・・・・・・・・・・・・・・・・・・・・・ | 41
第 4 章 | 参考文献・・・・・・・・・・・・・・・・・・・・・・・・・・・・・・・・・・・・・・・・・ | 43

# 第 1 章 システムの基本設計

本章では，「Arduino オーケストラ」（指揮者ノード 1 + 楽器ノード 4 の計 5 ノード）の うち塩澤担当範囲（指揮者ノード node_01 と楽器ノード node_02〜node_05 のファーム ウェア）を対象に，システム全体の機能・構成・操作インターフェース・状態遷移を基本 設計レベルでまとめる．楽器構成は 金管 3 + ドラム 1 とし，各楽器ノードは専用の Mac （Processing 実行）と 1 対 1 で USB 接続される．Mac 側の音色合成・スピーカ出力（梅 澤担当）は本章のスコープ外で，データ受け渡し境界（NOTE パケット）のみを定義する． 通信は ノード間（指揮者 → 楽器）= WiFi UDP マルチキャスト，Arduino–Mac 間（楽器 → 各 Mac）= USB Serial（UART, Serial.write）の二系統に分離した構成を採る．

ファームウェアの設計原則は，外部 OSS であり著者本人が公開している Embedded-Module-Architecture（以下 EMA）¹）に全面準拠する．EMA の中核ルール（IModule イン ターフェース，3 フェーズループ，SystemData と ProjectConfig の集約）は §1.2 で位置づ

けを示し，第 2 章で具体化する．

## 1.1 機能一覧

ファームウェア全体を機能分解構造（FBS）で整理する．本書スコープは Arduino 系のみ であり，楽器音色や発表準備などチーム全体側の要素は含めない．

1.1.1 機能分解（FBS）

F1. 指揮情報抽出（node_01） F1.1 IMU 6 軸の取得，F1.2 信号前処理（IIR LPF + ノル ム），F1.3 拍検出（振り下ろしピーク），F1.4 テンポ推定（拍間隔→ BPM），F1.5 強弱 推定（振幅→ velocity，ストレッチ），F1.6 演奏状態管理．

F2. 指揮情報配信（node_01） F2.1 CTRL 送出（BPM・velocity・state），F2.2 BEAT 送 出（拍トリガ），F2.3 SoftAP 起動・維持（自身がアクセスポイントを兼ね，楽器ノード を収容）．

F3. 楽譜進行（node_02〜05） F3.1 CTRL/BEAT 受信，F3.2 楽譜データ保持（C 配列・ パート別），F3.3 BEAT 同期での音符進行，F3.4 NOTE イベント生成，F3.5 パート固

### 有ロジック（partId・startBeatNo）．

F4. 発音情報配信（node_02〜05 → PC） F4.1 NOTE パケット生成，F4.2 Processing への USB Serial 送信（Serial.write()，CDC 1:1 接続）．

1） https://github.com/takushio2525/Embedded-Module-Architecture

F5. 共通基盤（全ノード） F5.1 IModule 登録・3 フェーズループ，F5.2 ModuleTimer によ

### る周期実行，F5.3 SystemData/ProjectConfig 集約，F5.4 起動シーケンス・診断 LED，

F5.5 init 失敗リトライ・パケロス時のフォールバック．

ストレッチ機能（F1.5 強弱推定）は必達機能の実装完了後に着手する．詳細設計ではイ ンターフェースだけ用意し，初期実装ではスタブで通す構成にする．

1.1.2 機能と性能指標（MOP）の対応

各機能に対する性能指標を表 1.1 に示す．目標値は原案段階のたたき台であり，実機計測 後に第 2.5 節で再調整する．

表 1.1: 機能と性能指標の対応

ID | 指標 | 目標値
MOP-1 | 楽器間 同期誤差（4 ノードの発音タイミ
| ング差） | ≤ 30 ms
MOP-2 | 指揮 → 楽器 通信遅延（送信〜受信） | ≤ 10 ms
MOP-3 | 拍検出 正解率（定速指揮時） | ≥ 90 %
MOP-4 | テンポ追従 遅延（BPM 階段変化への追従） ≤ 2 拍
MOP-5 | パケロス耐性（聴感破綻なし） | 5 % パケロス
MOP-6 | 入力フェーズ CPU 時間（1 周期） | ≤ 2 ms
MOP-7 | 起動時間（電源投入 → 演奏可能） | ≤ 5 s
MOP-8 | 強弱制御 分解能（ストレッチ） | 3 段階以上（p/mf/f）

1.1.3 各 MOP 目標値の根拠

各 MOP の数値は，演奏体験として「合っている／追従している」と感じられる水準と，

採用ハードウェア（XIAO ESP32-S3 Sense + MPU6050，SoftAP+UDP マルチキャスト） で達成可能と見込まれる水準の，両者が成立する範囲で設定した．以下に MOP ごとの根拠 を示す．

MOP-1（楽器間 同期誤差 ≤ 30 ms） 合奏における演奏者間タイミング調整の心理学的研

究をまとめた河瀬 [1] は，Rasch (1979) や Keller & Appel (2010) などの先行研究を 引いて，「演奏者どうしのズレが数 10 ms 程度ならば，演奏者・聴き手ともズレている とは感じない」一方で 100 ms を超えると合っていないと判断されることを整理して

いる．本システムは同一 SoftAP 配下の LAN 内通信で物理距離由来の遅延は無視でき るため，「数 10 ms」の上端を採って 30 ms を目標値とする．
MOP-2（通信遅延 ≤ 10 ms） 本 シ ス テ ム で は BEAT 受 信 後 に 楽 器 ノ ー ド が playAtMasterMs ま で 保 持 し て 発 音 す る マ ス タ ク ロ ッ ク 方 式（§2.3.3.6）を 採 る

ため，通信遅延そのものは MOP-1（同期誤差）にほぼ吸収される．したがって MOP-2 は MOP-1 の許容範囲（30 ms）の 1/3 程度を割り当てた設計マージンとして 10 ms を採る．広帯域ネットワークを用いた遠隔同時音楽演奏の実験 [2] でも，演奏が破綻し ない通信遅延の上限は楽曲・テンポ依存ながら十数 ms 〜数十 ms オーダーに収まるこ とが報告されており，ESP32 + UDP マルチキャストによる同 LAN 内通信は十分この 範囲に入る．
MOP-3（拍検出 正解率 ≥ 90 %） 加速度ベースの指揮ジェスチャ認識は，HMM とファ ジィ推論を組み合わせたマルチモーダル指揮シミュレータの先行研究 [3] で既に実用域 の認識精度が示されている．新山王 [4] による指揮基本動作の分析でも，熟達者と初心 者で打点の特徴差が定量化されており，加速度ノルム閾値による振り下ろし検出は実装 容易性の高い手法として裏づけられる．本ハッカソンでは演奏破綻を起こさない実用水 準として，IR/分類器評価で「実用域」とされる 90 % を目標にした． MOP-4（テンポ追従 ≤ 2 拍） 指揮基本動作の分析 [4] が示すとおり，指揮の打点と拍点 の関係から人間の指揮者・演奏者は 1–2 拍以内でテンポ変化を追従する．本システム はこの「人間と同等の追従感」を最低水準とし，BPM 推定に EMA（指数移動平均）を 用いるため，2 拍以内で目標 BPM の許容誤差に収まる設計とした．
MOP-5（5 % パケロス下で聴感破綻なし） ITU-T 勧告 Y.1541 の日本語版である TTC 標 準 JT-Y1541 [5] は，IP ベースサービスの品質クラスごとにパケットロス率の目標値 を規定しており，最も厳しいクラス 0 （リアルタイム高品質）でロス率 1 × 10⁻³（0.1 %），順次クラス 1 / 2 / 3 で同値，クラス 4 で 1×10⁻³，クラス 5（規格外・通常通信） では未規定としている．家庭用 IP 通信の実観測ベースの解説 [6] でもロス率 1 % 以下 が良好，3 % 超で不具合が顕在化，10 % 超でストレスを感じる水準とまとめられてお り，無線 LAN ではマルチキャストの取りこぼしが有線より有意に多い [7]．本システム は BEAT 連送（beatRedundancy）と SelfRun フォールバックでパケロスを吸収する設

計であり，試験条件としては「規格目標を 1 桁以上上回る悪化条件でも演奏破綻しない こと」を確認する意味で 5 % を採用する．

MOP-6（入力フェーズ CPU 時間 ≤ 2 ms） MPU6050 の I2C サンプリングを 200 Hz（周 期 5 ms）で行う設計のため，EMA の 3 フェーズ実行モデル（入力 → applyPattern()

→ 出力）の各フェーズ平均が 5/3 ≈ 1.7 ms 以内に収まる必要がある．入力フェーズに 2 ms 以下の制約を置けば，残り 3 ms をロジックと出力に割り当てて 5 ms 周期を破 綻なく回せる．数値は文献ではなく，サンプリング周波数とループ周期から導出した実 時間制約である．

MOP-7（起動時間 ≤ 5 s） この値は外部文献ではなく設計上の見積もりとユーザー体験の 経験則から定めた．ESP32 系における SoftAP 起動・STA 接続・初期 DHCP 等で 2–3 秒，指揮者ノードの Calibrating（重力オフセット学習）に 2 秒を要する想定で，合計 5 秒以内に最初の CTRL を送出する．実演前のセットアップ時間としてユーザーが「い つ振り始めてよいか」を判断できる範囲はおよそ 5 秒以内であり，体験面の閾値とも整 合する．本値は §2.5.4（実機で確定する仮値）に従い実測で再調整する． MOP-8（強弱 3 段階以上） 西洋音楽の強弱記号体系では p（ピアノ＝弱く）／ mf（メゾ フォルテ＝やや強く）／ f（フォルテ＝強く）が広く用いられる基本単位であり（楽典 の周知事項），3 段階あれば多くの初級〜中級曲のダイナミクス指示を最低限再現でき る．ストレッチ機能（F1.5）の初期実装としてこの 3 段階分離を達成水準と置く．

## 1.2 システム構成図

1.2.1 全体ブロック図

5 ノードと Mac × 4 の関係を図 1.1 に示す．指揮者 node_01 自身が SoftAP（ESP32-S3 のソフトウェア AP）を立て，楽器 node_02〜05 は STA としてこれに接続する．外部 ルータやスマホテザリングは不要．node_01 は CTRL/BEAT を UDP マルチキャスト で送 信し，node_02〜05 はそれぞれグループに join して受信する．各楽器は楽譜を進行させ ながら NOTE を USB Serial（Serial.write）で専用 Mac（1 対 1 接続） へ送信する．

Arduino–Mac 間は WiFi を介さず，給電と Serial 通信を兼ねた USB 接続で直結する．

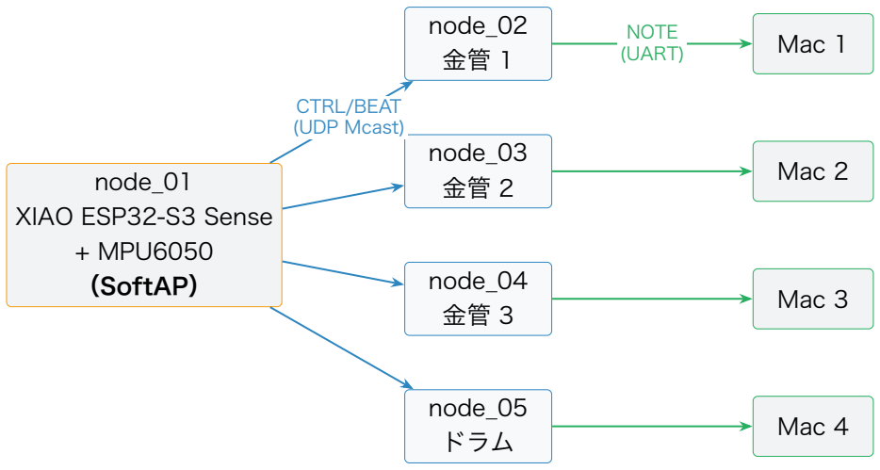
[picture p38: figure]
node_02 金管 1; node_03 金管 2; node_04 金管 3; node_05 ドラム; node_01 XIAO ESP32-S3 Sense + MPU6050 （SoftAP）; Mac 1; Mac 2; Mac 3; Mac 4; CTRL/BEAT (UDP Mcast); NOTE (UART)

図 1.1 全体ブロック図（指揮者 node_01 が SoftAP を兼ね，楽器 4 台が STA 接続．楽器 → Mac は 1 対 1 USB Serial）

1.2.2 ノード役割分担

各ノードの責務とコード担当者を表 1.2 に示す．node_02〜05 の Arduino コードは 共 通ソース + パート設定差し替え（ProjectConfig と楽譜データのみ差分）で構成し，4 台分

の別コードは書き分けない（§2.4.3）．

表 1.2: ノード役割分担

ノード | 物理配置 | 主な責務 | コード担当

node_01 指 揮 者 の 手・ 指

| 揮棒 | MPU6050 読み取り → 拍・テンポ・
| | 強弱推定 → CTRL/BEAT 送出．自身
| | が SoftAP を起動し楽器を収容 | 塩澤
node_02 金管 1 | BEAT 同期で楽譜進行 → NOTE 送出
| （金管 1 パート）

塩澤

node_03 金管 2 | BEAT 同期で楽譜進行 → NOTE 送出
| （金管 2 パート）

塩澤

node_04 金管 3 | BEAT 同期で楽譜進行 → NOTE 送出
| （金管 3 パート）

塩澤

node_05 ドラム | BEAT 同期で楽譜進行 → NOTE 送出
| （ドラム）

塩澤

Mac × 4 楽器ごとに 1 台 | UART で NOTE を受信 → 倍音・ADSR
| 調整 → 波形生成 → 内蔵スピーカ出力

梅澤（参考）

1.2.3 データフロー

演奏中の 1 拍ぶんの情報の流れを擬似シーケンスで示す．

1 拍ぶんのデータフロー（演奏中）

(1) MPU6050（I2C）→ node_01: 加速度・角速度サンプル（200 Hz）．
(2) node_01 内: applyPattern() がフィルタ・拍検出・テンポ推定を実行．
(3) 振 り 下 ろ し を 検 出: node_01（SoftAP）→ node_02〜05 に BEAT （beatNo,

### timestampMs）を UDP マルチキャスト．

(4) node_02〜05 内: 楽譜ポインタ前進 → NoteOn フラグ設定．

### (5) node_02〜05 → 各 Mac（1 対 1）: NOTE （noteNumber, velocity, durationMs） を USB Serial（Serial.write）で送信．

(6) 並行して node_01 は 20 Hz で CTRL（BPM・velocity・state）を同じマルチキャ ストグループへ送信し続ける．

1.2.4 採用アーキテクチャ（EMA）の方針

全 5 ノードのファームウェアは EMA に準拠する．EMA の中核ルールを本ハッカソンに 当てはめた要旨を以下に示す．バイト単位のパケット定義や具体コードは第 2 章で示す．

### - IModule インターフェース: 全ハードウェアモジュールが init() / updateInput() / updateOutput() / deinit() の 4 メソッドを実装する．

- 3 フェーズ実行モデル: loop() は「入力 → ロジック applyPattern() → 出力」の順で

必ず実行する．
- SystemData 集約: モジュール間共有状態を一元化する構造体．モジュール同士の直接呼

び出しは禁止．

### - ProjectConfig 集約: 各モジュールの設定を{MODULE}_CONFIG インスタンスとして 1

ヘッダに集約．
- 判断ロジックの位置づけ: 拍検出・テンポ推定・楽譜進行のような「ハードウェアに触 れない判断ロジック」は IModule の派生にせず，applyPattern() 関数内に書く．

## 1.3 操作インターフェース設計

本節では「操作インターフェース」を，ユーザーが触れる物理 IF（指揮棒・LED）とノー ド間／ PC 間の通信プロトコル IF（CTRL/BEAT/NOTE）の二層に分けて定義する．通信は

Arduino–Arduino 間 = WiFi UDP，Arduino–PC 間 = USB Serial の二系統に分け，それ ぞれ役割と性質が異なる．バイト単位のパケットレイアウトは §2.3.3 で具体化する．

1.3.1 ユーザー操作

- 指揮棒（指揮者）: MPU6050 を搭載した node_01（XIAO ESP32-S3 Sense）を指揮 棒として手に持ち，通常の指揮動作（4 拍子・3 拍子の振り下ろし）で操作する．特別 なボタン等は持たない．
- 起動順: 楽器ノード（node_02〜05）を先に起動し（Idle 状態で SoftAP を待機），その 後に指揮者ノード（node_01）を起動する．指揮者の SoftAP 起動で楽器が WaitStart に遷移し，指揮者の Conducting 入りで BEAT が流れ始めて楽器が Playing に遷移する．
- Calibrating: 指揮者ノードは起動後，最初の 2 秒間に静止姿勢を学習して重力オフ セットを記録する．使用者は単に「起動後 2 秒間，腕を自然に下ろした状態で待つ」だ けでよい．

1.3.2 LED 表示仕様

各ノードは内蔵 LED（LED_BUILTIN）の点滅パターンで状態を提示する（表 1.3）．点滅周
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
