takushio2525/2026-hackathon-team23/work/shiozawa/work-0422/提出用計画書/25g1065.pdf

2026 年 4 月 29 日 Version 0.1

# Arduino

# オーケストラ

# 〜計画書と設計書〜

## チーム 23

25G1065 : 塩澤 匠生

目次

# 第 1 章 システムの基本設計

本章では，「Arduino オーケストラ」（指揮者ノード 1 + 楽器ノード 4 の計 5 ノード）の うち塩澤担当範囲（指揮者ノード node_01 と楽器ノード node_02〜node_05 のファーム ウェア）を対象に，システム全体の機能・構成・操作インターフェース・状態遷移を基本 設計レベルでまとめる．楽器構成は 金管 3 + ドラム 1 とし，各楽器ノードは専用の Mac （Processing 実行）と 1 対 1 で USB 接続される．Mac 側の音色合成・スピーカ出力（梅 澤担当）は本章のスコープ外で，データ受け渡し境界（NOTE パケット）のみを定義する． 通信は ノード間（指揮者 → 楽器）= WiFi UDP マルチキャスト，Arduino–Mac 間（楽器 → 各 Mac）= USB Serial（UART, Serial.write）の二系統に分離した構成を採る．

ファームウェアの設計原則は，外部 OSS であり著者本人が公開している Embedded-Module-Architecture（以下 EMA）¹）に全面準拠する．EMA の中核ルール（IModule イン ターフェース，3 フェーズループ，SystemData と ProjectConfig の集約）は §?? で位置づ

けを示し，第 ?? 章で具体化する．

## 1.1 機能一覧

ファームウェア全体を機能分解構造（FBS）で整理する．本書スコープは Arduino 系のみ であり，楽器音色や発表準備などチーム全体側の要素は含めない．

1.1.1 機能分解（FBS）

F1. 指揮情報抽出（node_01） F1.1 IMU 6 軸の取得，F1.2 信号前処理（IIR LPF + ノル ム），F1.3 拍検出（振り下ろしピーク），F1.4 テンポ推定（拍間隔→ BPM），F1.5 強弱 推定（振幅→ velocity，ストレッチ），F1.6 演奏状態管理．

F2. 指揮情報配信（node_01） F2.1 CTRL 送出（BPM・velocity・state），F2.2 BEAT 送 出（拍トリガ），F2.3 SoftAP 起動・維持（自身がアクセスポイントを兼ね，楽器ノード を収容）．

F3. 楽譜進行（node_02〜05） F3.1 CTRL/BEAT 受信，F3.2 楽譜データ保持（C 配列・ パート別），F3.3 BEAT 同期での音符進行，F3.4 NOTE イベント生成，F3.5 パート固

### 有ロジック（partId・startBeatNo）．

F4. 発音情報配信（node_02〜05 → PC） F4.1 NOTE パケット生成，F4.2 Processing への USB Serial 送信（Serial.write()，CDC 1:1 接続）．

1） https://github.com/takushio2525/Embedded-Module-Architecture

F5. 共通基盤（全ノード） F5.1 IModule 登録・3 フェーズループ，F5.2 ModuleTimer によ
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
