takushio2525/2026-hackathon-team23/work/umezawa/hck/week2/事前課題設計_10点仕様書案/事前課題.pdf

# チーム 23 ハッカソン 1

# Processing 音源サブシステム

# 基本設計・詳細設計 仕様書

### 梅澤颯太（学籍番号：25G1021）

2026 年 4 月 29 日 改訂案

目次

1 | 基本設計：機能一覧とシステム構成図 | 3
2 | 基本設計：操作インターフェースと状態遷移 | 4
3 | 詳細設計：ハードウェア設計 | 6
4 | 詳細設計：ソフトウェア設計 | 7
5 | 詳細設計：処理フローの設計 | 10
6 | 検証計画 | 12

7 | 今後の実装順序 | 13
8 | 生成 AI の利用について | 13

## 1 基本設計：機能一覧とシステム構成図
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
