takushio2525/2026-hackathon-team23/report/計画書結合/hard.png

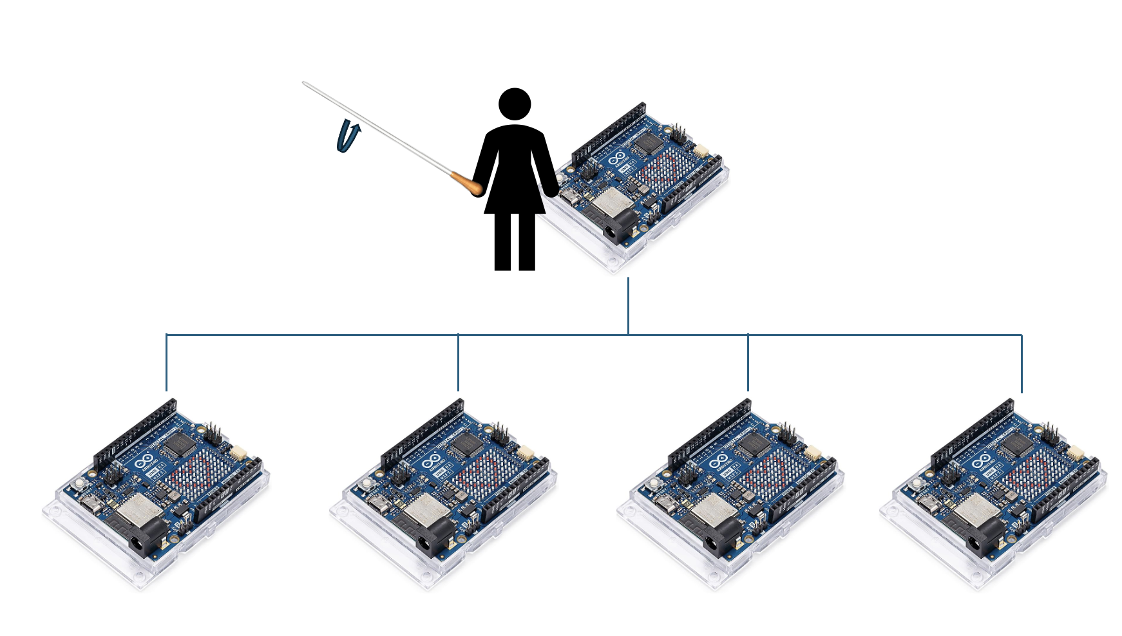
report/計画書結合/hard.png
