takushio2525/2026-hackathon-team23/work/shiozawa/最終報告書/fig/mop2_pitch_error.png

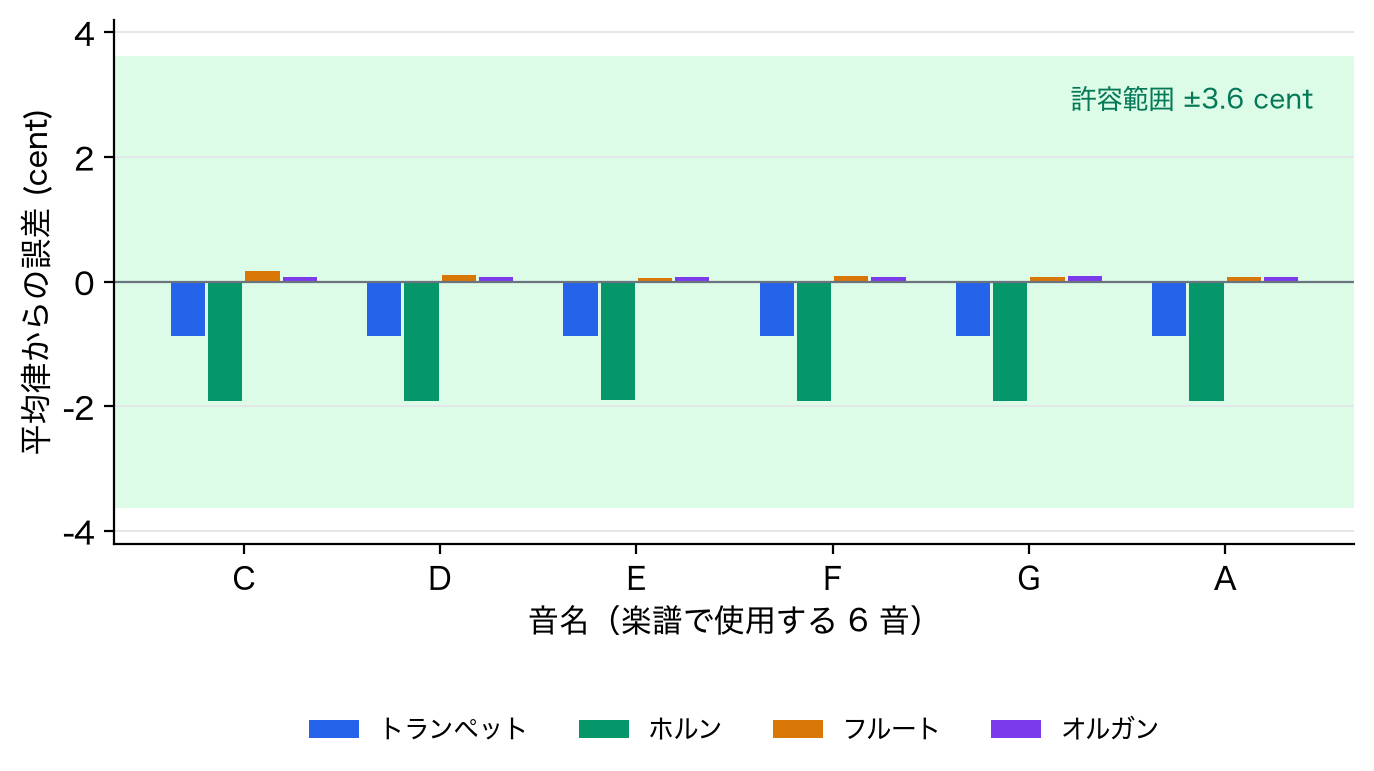
work/shiozawa/最終報告書/fig/mop2_pitch_error.png
