takushio2525/2026-hackathon-team23/work/shiozawa/最終報告書/fig/mop5_burst_interval.png

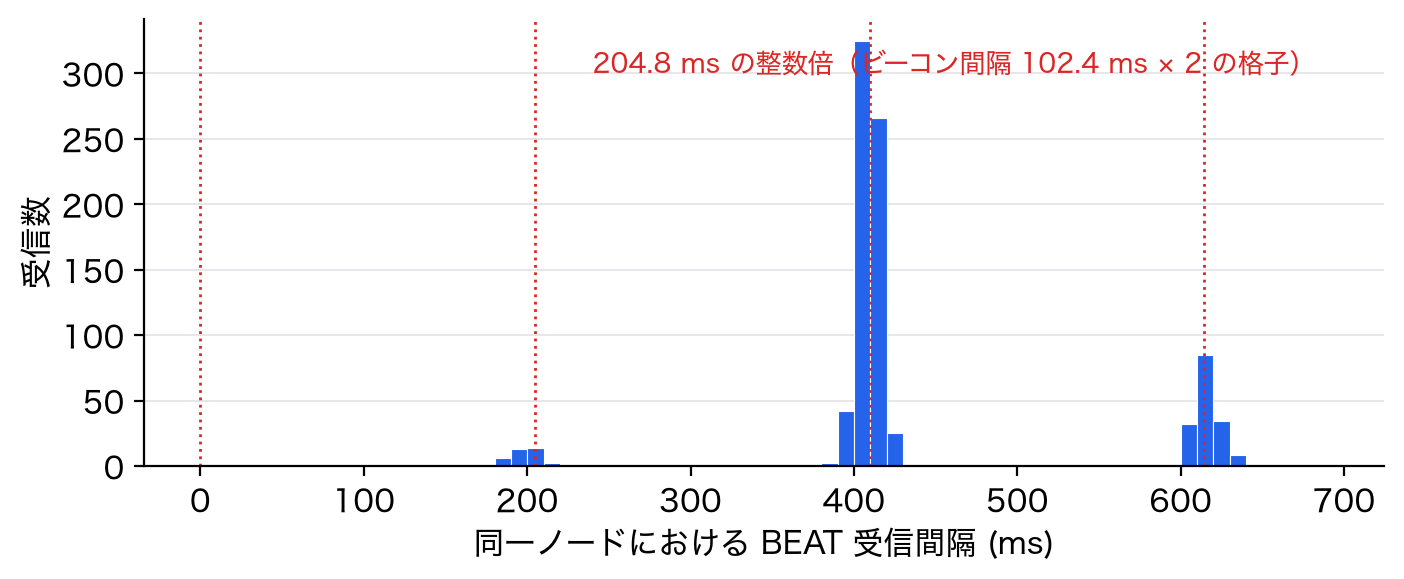
work/shiozawa/最終報告書/fig/mop5_burst_interval.png
