takushio2525/2026-hackathon-team23/work/shiozawa/最終報告書/fig/mop5_jitter_absorption.png

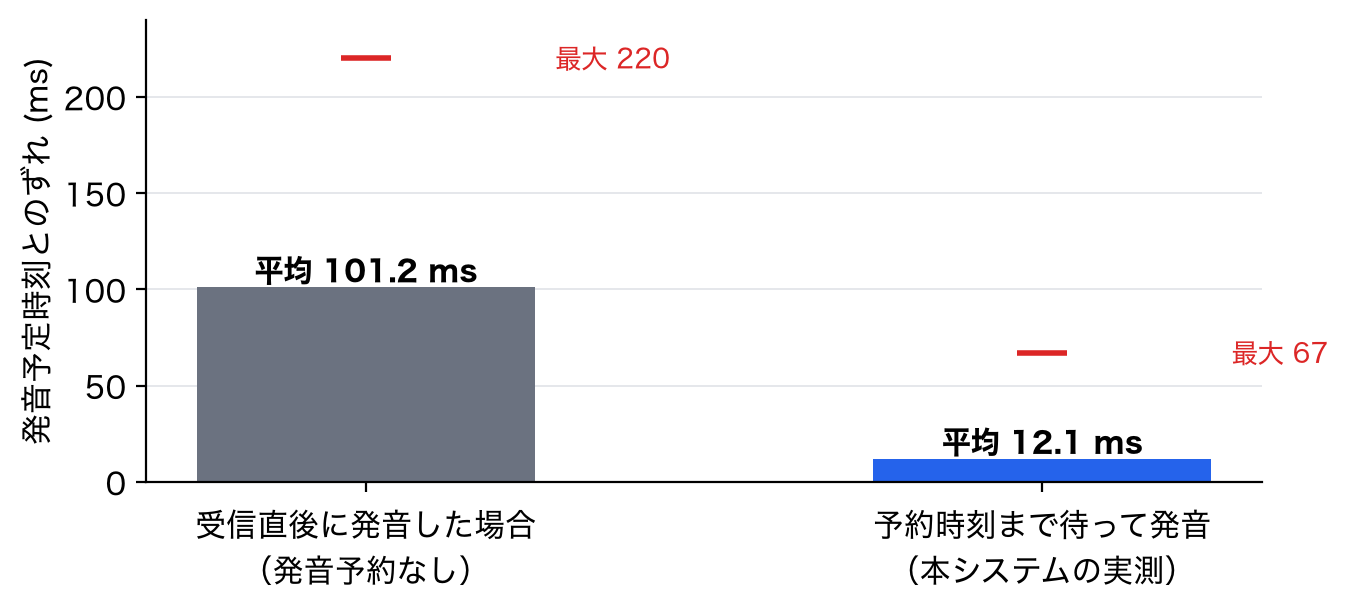
work/shiozawa/最終報告書/fig/mop5_jitter_absorption.png
