takushio2525/2026-hackathon-team23/work/shiozawa/最終報告書/fig/mop6_tempo_track.png

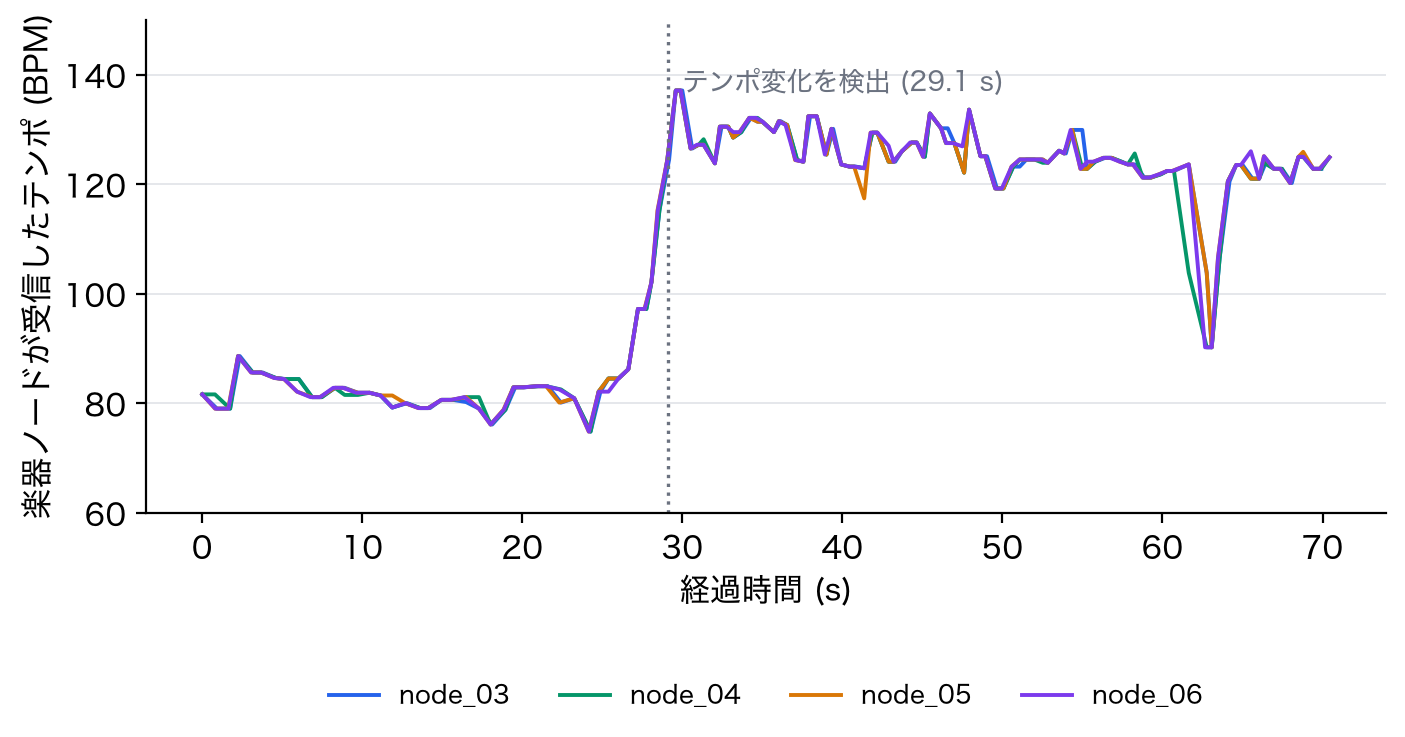
work/shiozawa/最終報告書/fig/mop6_tempo_track.png
