takushio2525/2026-hackathon-team23/hardware/parts_list.md

# 部品表

実験で使用する部品の一覧。購入品・実験室貸出品を分けて管理する。

## 購入予定 / 購入済み

| # | 部品名 | 型番 | 個数 | 単価 | 合計 | 用途 | 備考 |
|---|---|---|---|---|---|---|---|
| 1 | - | - | - | - | - | - | - |

## 実験室貸出

| # | 部品名 | 型番 | 個数 | 貸出元 | 返却期限 | 備考 |
|---|---|---|---|---|---|---|
| 1 | - | - | - | - | - | - |

## 合計金額

未確定
