takushio2525/2026-hackathon-team23/work/shiozawa/最終報告書/fig/conductor-board-solder.png

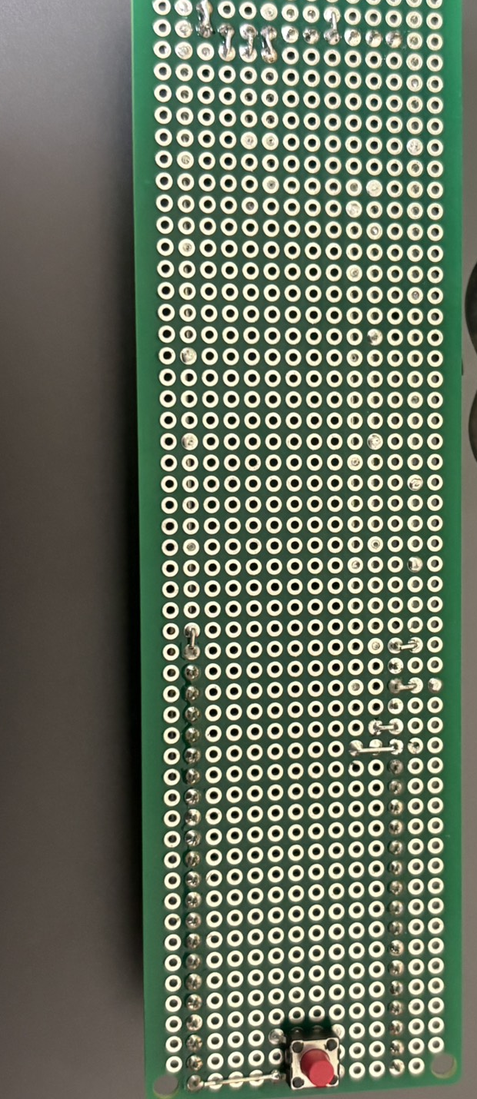
work/shiozawa/最終報告書/fig/conductor-board-solder.png
