takushio2525/2026-hackathon-team23/tools/verification/results/MOP45_latency_investigation_20260710.md

# MOP4/MOP5 通信遅延計測の調査レポート — 2026-07-10

対象: `MOP_REPORT_20260709.md` の MOP4（楽器間同期誤差）/ MOP5（楽器間到着ずれ）の計測パイプラインと公表値の信頼性。
背景: 別 AI（Codex）が「計測パイプラインに欠陥がある」とする調査メモを `.agent/activeContext.md` に残したため、その検算・公表値の出所解明・今後の対応方針の提示を行った。**本調査はログ・CSV の再集計のみで、コード変更は一切していない。**

## 結論サマリ

1. **Codex の指摘 5 件は全件おおむね正しい**（詳細は §2）。うち「CSV 再集計 平均 2586.3ms」は完全一致で再現した。
2. **レポート公表値の出所を完全特定した**。7/9 の MOP4（平均14.3 / p50=13 / p95=28 / 最大35ms、157拍、20ms 超 26 件）と MOP5（全ペア平均6.8 / p50=5 / p95=18 / 最大35ms、node_05–06）は、`logs/test_20260709_234302.log` の **EVT BEAT 行の `ahead` 値**から算出されたもの（MOP4 = 同一拍の ahead のノード間レンジ、MOP5 = ahead のノードペア差）で、**全統計量が再計算と一致**する。レポートの「計測方式: NOTE_ON の PC タイムスタンプベース」「データ: `results/mop4/20260709_233957.csv`」という記載は**両方とも事実と異なる**。
3. コミット `7973294` で改修された NOTE_ON ベースのスクリプト（`mop4_sync_error.py` / `mop5_comm_delay.py`）の実出力は**平均 2586.3ms / 最大 5263.3ms という破綻値**（`results/mop4/20260709_233957_summary.txt` に記録済み）で、計測系として成立していない。
4. 公表値（ahead ベース）は「BEAT 受信時点の各ノード推定マスタ時計のずれ＋到着差」であり、発音時刻差そのものではないが、**水準としては概ね妥当**。発火時刻のより直接的な推定（device_t + EMA offset）では p50=8ms / p95≈30ms / **最大 61ms** となり、「最大 35ms」は上限保証にならない。
5. **新発見**: beatLookahead=45ms の発音予約は **53% の拍で間に合っていない**（BEAT 受信時点で既に予定時刻超過、遅れは p95=91ms / 最大 116ms）。到着ジッタが全ノード共通（マルチキャスト）のため同期自体は保たれており、聴感上の問題が出なかったのはこのため。
6. 計画書の MOP5「指揮から楽器への通信遅延 ≤30ms」（`report/計画書_中間発表/23_計画書・設計書.tex:341`）は**現在も未検証**。7/9 レポートは指標自体を「楽器間到着ずれ」に置き換えており、絶対片道遅延は現行の片方向同期では原理的に測れない。

## 1. 調査方法

- 全数値は本調査で CSV・ログから再集計した（既存レポート値・Codex 値の双方を検算対象とした）。
- 使用データ: `results/mop4/20260709_233957.csv`（290 行）、`results/mop5/20260702_211028.csv`（1179 行）、`logs/test_20260709_234302.log`（5966 行、SERIAL_DEBUG=1 の 6 ノード同時ログ）、各 summary。
- 集計スクリプトはセッションの scratchpad に置き、リポジトリには含めていない。主要な集計は §5 の付録に方式を明記した（同方式で再現可能）。

## 2. Codex 主張の検算結果

| # | Codex の主張 | 判定 | 根拠（本調査の再集計） |
|---|---|---|---|
| 1 | `mop5_comm_delay.py` は指揮→楽器の通信遅延ではなく MOP4 と同じ NOTE_ON の PC 受信時刻差を集計 | **正しい** | コード読解で確認。`mop5_comm_delay.py:82-133` は `mop4_sync_error.py:82-136` と同一のデータ（NOTE_ON の pc_ts）を取り、集計だけ最大差→ペア差に変えている。計画書定義（通信遅延 ≤30ms）とは別の量 |
| 2 | 「直前の EVT BEAT を NOTE_ON に紐付ける」方式は beatNo を誤対応させる | **正しい** | 7/9 ログで NOTE_ON→紐付け EVT BEAT の間隔は p50=93ms だが p95=622ms / 最大 822ms（拍間隔 ~490ms 超＝誤対応確定）。seq が連続なのに紐付け beatNo が進まない/戻る事例 101 件。誤りの機構は Codex の記述（受信の前後でログ順逆転）より多面的（§3.2） |
| 3 | 7/9 MOP4 CSV を現行スクリプトで集計すると平均 2586.3ms / 最大 5263.3ms でレポートと不一致 | **正しい（完全一致）** | 本調査の再集計: n=85 拍、平均 2586.3 / p50 2545.3 / p95 4829.4 / 最大 5263.3ms。コミット済みの `results/mop4/20260709_233957_summary.txt` 自体が同値を記録している |
| 4 | 7/2 MOP_TEST=5 は M5I 二重記録（239行/120拍）。ahead は EMA オフセット依存で主に遅延変動しか表さない | **正しい** | `results/mop5/20260702_211028.csv` 再集計: node_03〜06 は各 239 行 / ユニーク 120 拍（119 拍が二重）。node_02 のみ 103 行（main.cpp に M5I 出力が無いため単独記録）。出力箇所は `OrcReceiverModule.cpp:130` と `node_03〜06/src/main.cpp:190` の 2 箇所。EMA が平均遅延を吸収する構造（`OrcReceiverModule.cpp:18-43`、サンプル= `timestampMs − millis()`）もコードで確認 |
| 5 | debug log の補助再評価（device_t + 近傍 EMA offset）で推定発火差 p50=8ms / p95=28ms / 最大61ms | **正しい（再現成功）** | N1 拍への紐付け + NOTE_ON の `t=`（millis）+ 直近 status 行の `off=` で再計算: p50=8.0 / p95=29.5 / 最大 61.0ms（n=138 拍）。Codex 値とほぼ一致 |
| 6 | node_02〜06 `platformio.ini` の SERIAL_DEBUG=1 はユーザー変更として維持 | 確認済み | `git diff` で 5 ファイルとも `-DSERIAL_DEBUG=0` → `=1` のみの変更。未コミットのまま維持（本調査でも触れていない） |

## 3. レポート公表値の出所解明

### 3.1 公表値は ahead ベースで完全再現できる

`logs/test_20260709_234302.log` の楽器側 `[Nx EVT BEAT] ... ahead=<ms>` 行（各ノード 157 拍、初回受信のみ）から:

- **MOP4 = 同一拍の ahead のノード間レンジ**: n=157、平均 **14.3** / p50 **13.0** / p95 **28.0** / 最大 **35** ms、20ms 超 **26** 件 → レポート記載（14.3 / 13 / 28 / 35、26/157）と**全一致**
- **MOP5 = 同一拍の ahead のノードペア差**: 全ペア n=1570、平均 **6.8** / p50 **5.0** / p95 **18.0** / 最大 **35** ms、最大は **node_05–node_06** ペア → レポート記載（6.8 / 5 / 18 / 35、node_05–06）と**全一致**

つまり 7/9 の公表値は、レポートに書かれた「NOTE_ON の PC タイムスタンプベース」ではなく、**7/2 と同じ ahead（デバイス時計）ベース**で算出されている。実際、7/2 の MOP4 も旧スクリプトが `localMasterMs = playAt − ahead` の同一拍ノード間レンジを取っており（旧 `mop4_sync_error.py`、コミット `7973294` 以前）、playAt は全ノード共通なので**数学的に同じ量**である。したがってレポートの 7/2→7/9 比較表（14.1→14.3 等）は、結果的には方式が揃った公正な比較になっている。

### 3.2 一方、改修スクリプト（NOTE_ON ベース）の実出力は破綻している

コミット `7973294`（7/9 23:01）で MOP4/MOP5 スクリプトは NOTE_ON の PC タイムスタンプ方式に改修されたが、その直後の実測（23:39〜）の出力は使い物になっていない。

- `results/mop4/20260709_233957_summary.txt`: 平均 2586.3ms / 最大 5263.3ms / FAIL（ノード別偏差 node_06 +1644.1ms など）
- 原因（コード読解）:
  1. **ライブ計測の逐次ブロッキングポーリング**: `mop4_sync_error.py:99-105` は 6 ポートを for 文で 1 行ずつ読む。`common.py:131` の `timeout=0.1` により、無データのポートで最大 100ms ずつ順にブロックするため、受信タイムスタンプ `pc_ts = time.time()`（読み出し時刻）が実到着から最大数百 ms〜秒単位で遅れる。バックログが溜まるほど遅れが累積する（node_06 = 毎拍発音するドラムで偏差最大、と整合）
  2. **`--log` 解析モードは形式不一致で全滅**: `mop4_sync_error.py:154` は行をタブで分割するが、`serial_logger.py:72` は**スペース区切り**（`ts port text`）で書く。このため既存ログを `--log` で解析すると pc_ts が取れず NOTE_ON が全て捨てられ、結果ゼロ件になる
  3. **NOTE_ON のノードプレフィックスが全ノード `[N2` 固定**: `NoteSenderModule.cpp:63` が共通ライブラリ内で `"[N2 NOTE_ON ]"` をハードコードしており、行頭プレフィックスからノード判定できない（part= フィールドのみ有効）
  4. **直前 EVT BEAT 紐付けの誤対応**: §2 主張 2 の通り
- `mop_graphs.py` の `graph_mop4()` も同じ CSV から再計算する構造（`mop_graphs.py:148-177`）で、さらに 1 台のみの拍を誤差 0 として混ぜるため（`:173`）、平均を実態より下げる。なおコミット済みの `results/graphs/mop4_sync_error.png` / `mop5_comm_delay.png` は 23:01 時点の生成で **7/2 データ**（最大29.0/平均14.1/121拍、最大37.0/平均5.4/4162サンプル）を描いており、7/9 公表値とも別物

### 3.3 レポート記載の問題点まとめ

| レポートの記載 | 事実 |
|---|---|
| MOP4「計測方式: NOTE_ON の PC タイムスタンプベース」（`MOP_REPORT_20260709.md:49`） | 実際は EVT BEAT `ahead` のノード間レンジ（デバイス時計ベース） |
| MOP4「データ: `results/mop4/20260709_233957.csv`」（`:56`） | この CSV の集計は平均 2586.3ms で公表値と無関係。実データ源は `logs/test_20260709_234302.log` |
| MOP5「7/2 は ahead ベースで過大、7/9 は NOTE_ON ベースに改修」（`:78`） | 7/9 公表値も ahead ベース。なお 7/2 MOP5 の「平均 42.6ms」は `delay = lookahead − ahead` の絶対値解釈で、EMA が平均遅延を吸収するため絶対遅延としては解釈できない（この点の指摘自体は正しいが、7/9 も同じ ahead 由来） |
| MOP5 の指標「楽器間到着ずれ ≤30ms」 | 計画書の MOP5 は「指揮から楽器への通信遅延 ≤30ms」。指標が無断で置き換わっており、通信遅延は未検証のまま |

## 4. 計測手法・公表値の総合評価

### 4.1 ahead レンジ（公表値）は何を測っているか

`ahead = playAtMasterMs − (millis() + offsetMs)` を BEAT 初回受信時に計算した値（`node_0X/src/main.cpp:91-101`）。同一拍では playAt が全ノード共通なので、ノード間レンジ = 「各ノードの (受信時刻 + 推定クロックオフセット誤差) のばらつき」。

- USB シリアル遅延は乗らない（デバイス側で計算された値）。この点で NOTE_ON PC タイムスタンプ方式より筋が良い
- ただし「発音時刻の楽器間差」そのものではない。ahead>0 の拍では発音はスケジュール発火（差はクロック誤差のみ）、ahead<0 の拍では到着即発火（差は到着差）になるため、ahead レンジは発音差のやや保守的（大きめ）な代理指標
- 発音時刻をより直接推定する device_t + EMA offset 方式（Codex 方式の再現）では p50=8 / p95≈30 / 最大 61ms。オフセットを別時刻の status 行から取るため数 ms の推定誤差を含むが、「**最大 35ms**」を上限として断定できないことは確実

### 4.2 USB タイムスタンプ方式（改修スクリプトの方式）は原理的に不適

同一拍の楽器 EVT BEAT（デバイス時計上はほぼ同時受信）の PC 受信時刻スプレッドを雑音フロアとして実測すると、**平均 19.6 / p95 29.0 / 最大 35.4ms**（スレッド化された serial_logger のログでも）。目標値 20ms と同桁の雑音が乗るため、ログ収集をスレッド化しても NOTE_ON PC タイムスタンプ方式で MOP4 を判定するのは不適切。逐次ポーリングのライブ計測（現行スクリプト）では前述の通り秒オーダーまで破綻する。

### 4.3 新発見: 45ms lookahead は半数の拍で間に合っていない

7/9 ログの全 785 サンプル（157 拍 × 5 ノード）で、BEAT 初回受信時点の遅れ `lateMs = max(0, −ahead)` は:

- **遅刻 419/785 件（53%）**、遅れの p95 = 91ms、最大 116ms
- ahead は全ノードほぼ共通に振れる（拍ごとのノード平均の SD ≈ 52ms、振れ幅 −110〜+84ms）。共通モードなので**同期は壊れない**（全員一緒に遅れて発火する）。マルチキャストは単一無線フレームを全ノードが同時受信するため、と整合する
- 振れの周期・幅は SoftAP のマルチキャスト配送（DTIM ビーコン間隔 ~100ms でのバッファリング）と整合するが、確定には至っていない
- 理論上 ahead の平均は lookahead の 45ms 付近になるはずだが、実測平均は −9.6ms（7/2 の M5I データでも ≈ +2ms）で、**約 45〜55ms の系統シフトが未解明**。EMA オフセットが平均遅延を吸収する構造（サンプル = `timestampMs − millis()`、`OrcReceiverModule.cpp:18-43`）だけでは説明が付かず、追加調査（B 案の lateMs 計測）が必要

これは「発表で問題なかった」事実と両立する: 発音の同時性（楽器間）は保たれ、犠牲になっているのは指揮棒→発音の絶対レイテンシ（最大 ~160ms = lookahead 45 + 遅れ 116）と拍ごとの揺らぎであり、単独では知覚されにくい。

### 4.4 公表値はどこまで信用できるか（見解）

- **信用できる**: 「楽器間の相対ずれの中央値は十数 ms で、目標 20ms の水準感の中にある」という定性的結論。ahead レンジ（p50=13）と発火差推定（p50=8）が独立にこれを支持する
- **信用できない**: (a)「最大 35ms」という上限（発火差推定の最大は 61ms、かつ計測時間は約 80 秒 × 1 回のみ）、(b)「計測方式: NOTE_ON の PC タイムスタンプベース」という方法記述、(c) MOP4 の出典 CSV、(d) MOP5 を「指揮→楽器通信遅延」の検証と見なすこと（未検証）
- **条件付き**: FAIL（受け入れ）という判定自体は維持可能。ただし根拠数値の出典と方式の記述を訂正し、上限断定を避けた表現に直す必要がある
- 補足: 7/9 の計測は SERIAL_DEBUG=1（NOTE バイナリ送信を抑止しテキストを流すモード、`NoteSenderModule.cpp:61-71`）で行われており、本番構成（バイナリ送信 + Processing 発音）そのものの計測ではない点も最終レポートでは明記すべき

## 5. 今後の対応方針

### A. 最終レポートの記述修正のみ（コード変更なし）— **推奨・必須**

- 内容: §3.3 の 4 点を訂正。MOP4 の方式を「EVT BEAT ahead のノード間レンジ（デバイス時計ベース、7/2 と同方式）」、出典を `logs/test_20260709_234302.log` に改める。最大値は「35ms（ahead レンジ）、発火差推定では最大 61ms 程度まで幅がある」と併記。MOP5 は「計画書定義の通信遅延は未検証、楽器間相対ずれに指標を変更した」ことを明示
- 期待効果: 振り返り・最終レポートの数値が検証可能になり、7/2 比較の整合も取れる
- 工数: 本レポートを根拠に文章修正のみ（~1 時間）。**7/15 までに確実に実施可能**

### B. 再計測(ソフト変更要): Codex 提案の専用ログ + lateMs 計測

- 内容: Codex 提案どおり (1) 発火箇所で `beatNo, playAtMasterMs, millis(), offsetMs, localMasterAtFire` を 1 行出力し、`localMasterAtFire` のノード間レンジで MOP4 を確定、(2) BEAT 受信時と発火時の `lateMs` を専用モードで集計して「45ms 予約に間に合うか」を定量化、(3) M5I 出力を共通モジュールか main の一方に統一、(4) `analyze_log` の区切り文字を `serial_logger.py` の形式（スペース区切り）に合わせる
- 評価: 提案は妥当。特に (1) は USB 雑音とログ紐付け誤りを同時に排除する正攻法で、(2) は §4.3 の未解明シフトの解明にも直結する
- 期待効果: MOP4 の確定値（推定でなく実測）と lookahead 設計の検証
- 工数: ファーム数行 + スクリプト修正で半日、実機 6 台での再計測 1 時間程度。**7/15 までに実施可能だが実機アクセスとメンバー時間に依存**。実施する場合も「実機未テストコードへの介入禁止」ルールに従いユーザー主導で
- 位置づけ: 任意。振り返りの説得力を上げたい場合のみ

### C. ハード計測: GPIO トグル + ロジックアナライザ / 往復同期 (ping/ACK)

- 内容: 送信・受信で GPIO をトグルして外部計測器で絶対片道遅延を測る、または往復時刻同期を実装して計画書 MOP5（通信遅延 ≤30ms）を検証する
- 評価: 絶対片道遅延の検証にはこれしかない（Codex の指摘どおり片方向同期では原理的に不可能）
- 工数: 機材・配線・ファーム改修で数日。**7/15 までは非現実的**。最終レポートには「片道遅延の実測は将来課題」と明記することを推奨

**推奨**: A を必須で実施（本レポートがその根拠資料）。B は時間が許せば (2) lateMs 計測を最優先で 1 項目だけでも実施（未解明の系統シフトと lookahead 妥当性が同時に判る）。C は将来課題として記載に留める。

## 付録: 検算の方式と主要数値

すべて `logs/test_20260709_234302.log`（行形式 `pc_ts port text`）と各 CSV から Python 標準ライブラリで再集計。

| 検算項目 | 方式 | 結果 |
|---|---|---|
| MOP4 CSV 再集計 | `mop4_sync_error.py` の report_results と同一ロジックを `20260709_233957.csv` に適用 | n=85、平均 2586.3 / p50 2545.3 / p95 4829.4 / 最大 5263.3ms（summary と一致） |
| MOP4 公表値の再現 | 同一拍の楽器 EVT BEAT `ahead`（初回受信）のノード間レンジ | n=157、平均 14.3 / p50 13.0 / p95 28.0 / 最大 35ms、20ms 超 26 件（レポートと全一致） |
| MOP5 公表値の再現 | 同上 ahead のノードペア差（10 ペア × 157 拍） | n=1570、平均 6.8 / p50 5.0 / p95 18.0 / 最大 35ms（node_05–06）（レポートと全一致） |
| 発火差推定（Codex 主張 5） | NOTE_ON の `t=`（millis）+ 直近 status 行 `off=` でマスタ時計系へ写像、直前 N1 拍でグルーピング | n=138、平均 11.0 / p50 8.0 / p95 29.5 / 最大 61.0ms |
| USB 雑音フロア | 同一拍の楽器 EVT BEAT の PC 受信時刻スプレッド（5 台揃った拍） | n=157、平均 19.6 / p50 19.8 / p95 29.0 / 最大 35.4ms |
| lateMs（予約遅れ） | `max(0, −ahead)`、全ノード合算 | 785 件中 419 件（53%）が遅刻、平均 27.4 / p95 91.0 / 最大 116ms |
| 紐付け誤対応 | NOTE_ON→紐付け EVT BEAT の間隔と、seq 連続時の beatNo 単調性 | 間隔 p50 92.7 / p95 621.6 / 最大 821.7ms、単調性違反 101 件 |
| M5I 二重記録 | `20260702_211028.csv` の (node, beatNo) 出現回数 | node_03〜06: 各 239 行 / 120 拍（119 拍が二重）、node_02: 103 行（単独） |

関連ファイル: `tools/verification/scripts/{mop4_sync_error,mop5_comm_delay,mop_graphs,serial_logger,common,analyze}.py`、`firmware/production/common/lib/{NoteSenderModule,OrcReceiverModule}/`、`firmware/production/node_01/lib/OrcSenderModule/OrcSenderModule.cpp`、`firmware/production/node_0X/src/main.cpp`
