takushio2525/2026-hackathon-team23/work/shiozawa/template/sections/05_evaluation.tex

\chapter{評価}
\label{ch:evaluation}

\section{定量評価}

\subsection{評価項目1（プレースホルダ）}
% プロジェクトの目標に対応する定量指標を記述する（処理時間・精度・誤差など）

\subsection{評価項目2（プレースホルダ）}
% 2つ目の定量指標（必要に応じて）

\section{定性評価}

\subsection{ユーザ体験}
% デモ・アンケート・ヒアリング結果などを記述する

\subsection{完成度}
% 当初の目標に対してどこまで達成できたかを記述する
