takushio2525/2026-hackathon-team23/work/umezawa/hck/week3/orchestra_processing_test/orchestra_processing_log_20260511_021505.csv

millis | event | seq | timestampMs | partId | noteNumber | velocity | gate | durationMs
20362 | serial_connected_/dev/cu.debug-console
103131 | voice_on_0x05_36_100_550
103671 | voice_on_0x05_36_100_550
104171 | voice_on_0x05_36_100_550
104255 | voice_on_0x05_36_100_550
104671 | voice_on_0x05_36_100_550
104855 | voice_on_0x05_36_100_550
105022 | voice_on_0x05_36_100_550
105188 | voice_on_0x05_36_100_550
107240 | voice_on_0x05_36_100_550
107556 | voice_on_0x05_36_100_550
107756 | voice_on_0x05_36_100_550
107889 | voice_on_0x05_36_100_550
108056 | voice_on_0x05_36_100_550
108206 | voice_on_0x05_36_100_550
108989 | voice_on_0x02_60_100_550
109988 | voice_on_0x02_60_100_550
110689 | voice_on_0x03_64_100_550
111439 | voice_on_0x04_68_100_550
112089 | voice_on_0x05_36_100_550
112572 | voice_on_0x05_36_100_550
112972 | voice_on_0x05_36_100_550
113156 | voice_on_0x05_36_100_550
113356 | voice_on_0x05_36_100_550
113739 | voice_on_0x02_60_100_550
114006 | voice_on_0x02_60_100_550
114190 | voice_on_0x02_60_100_550
114539 | voice_on_0x02_60_100_550
116289 | voice_on_0x02_60_100_550
118943 | voice_on_0x02_60_100_550
136216 | voice_on_0x02_60_100_550
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
