takushio2525/2026-hackathon-team23/tools/verification/results/graphs/mop1_beat_detection.png

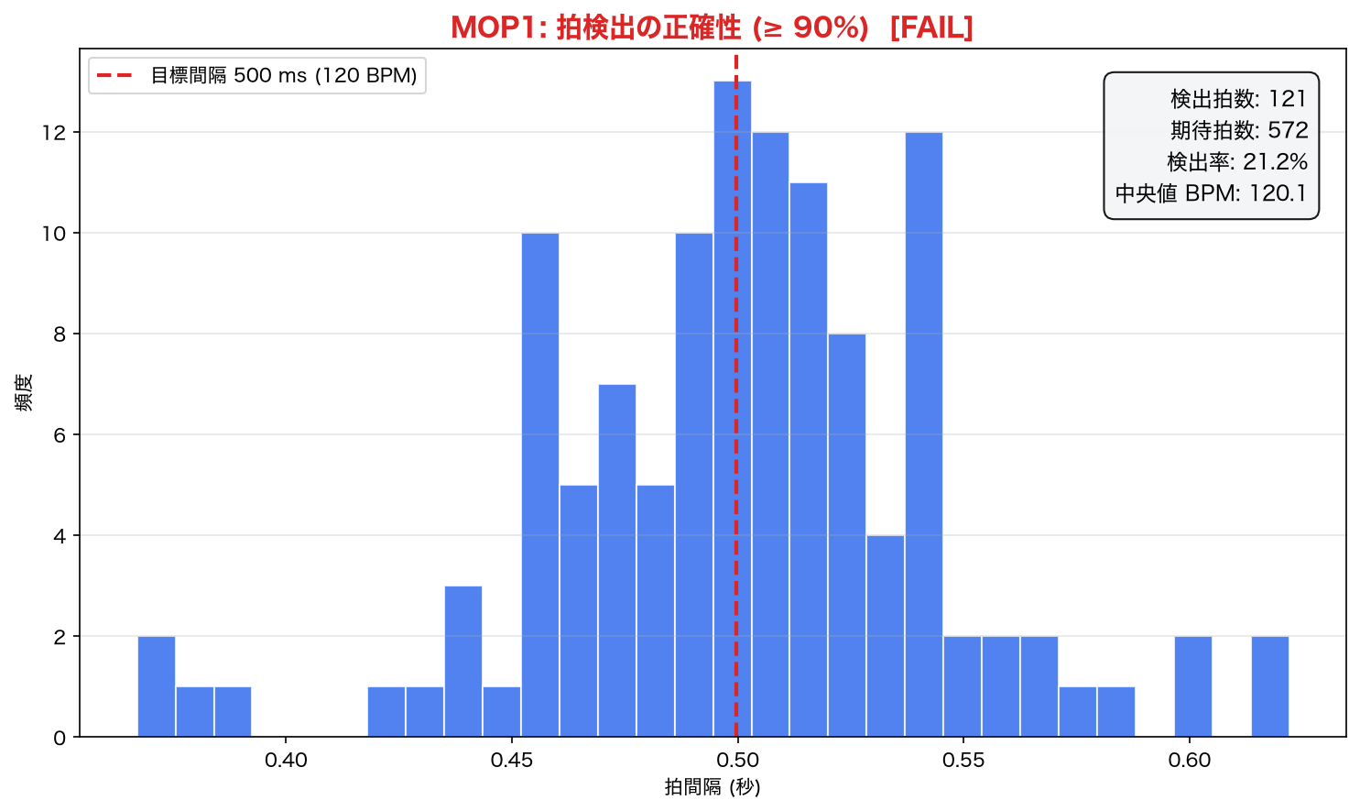
tools/verification/results/graphs/mop1_beat_detection.png
