takushio2525/2026-hackathon-team23/tools/verification/results/graphs/mop4_sync_error.png

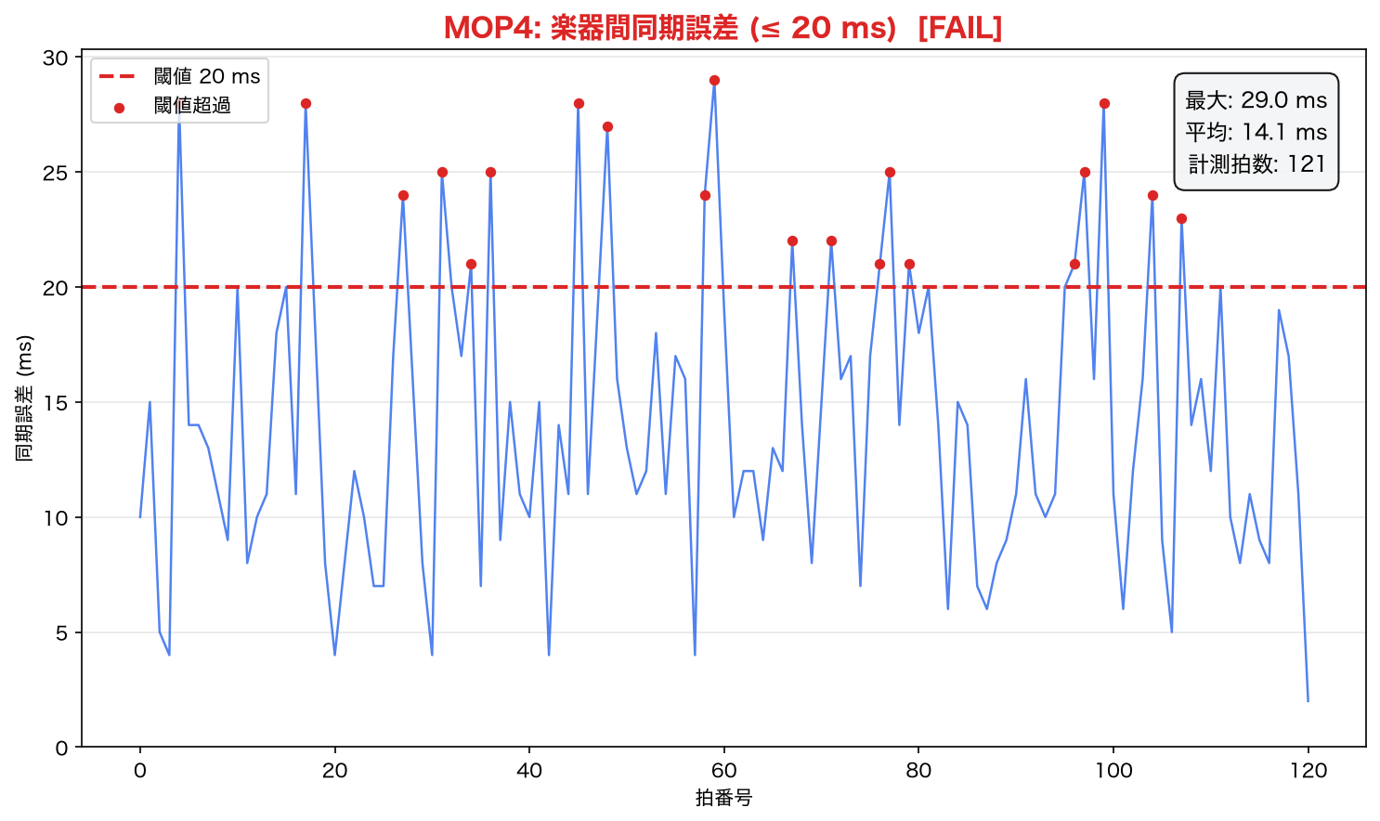
tools/verification/results/graphs/mop4_sync_error.png
