takushio2525/2026-hackathon-team23/tools/verification/results/graphs/mop5_comm_delay.png

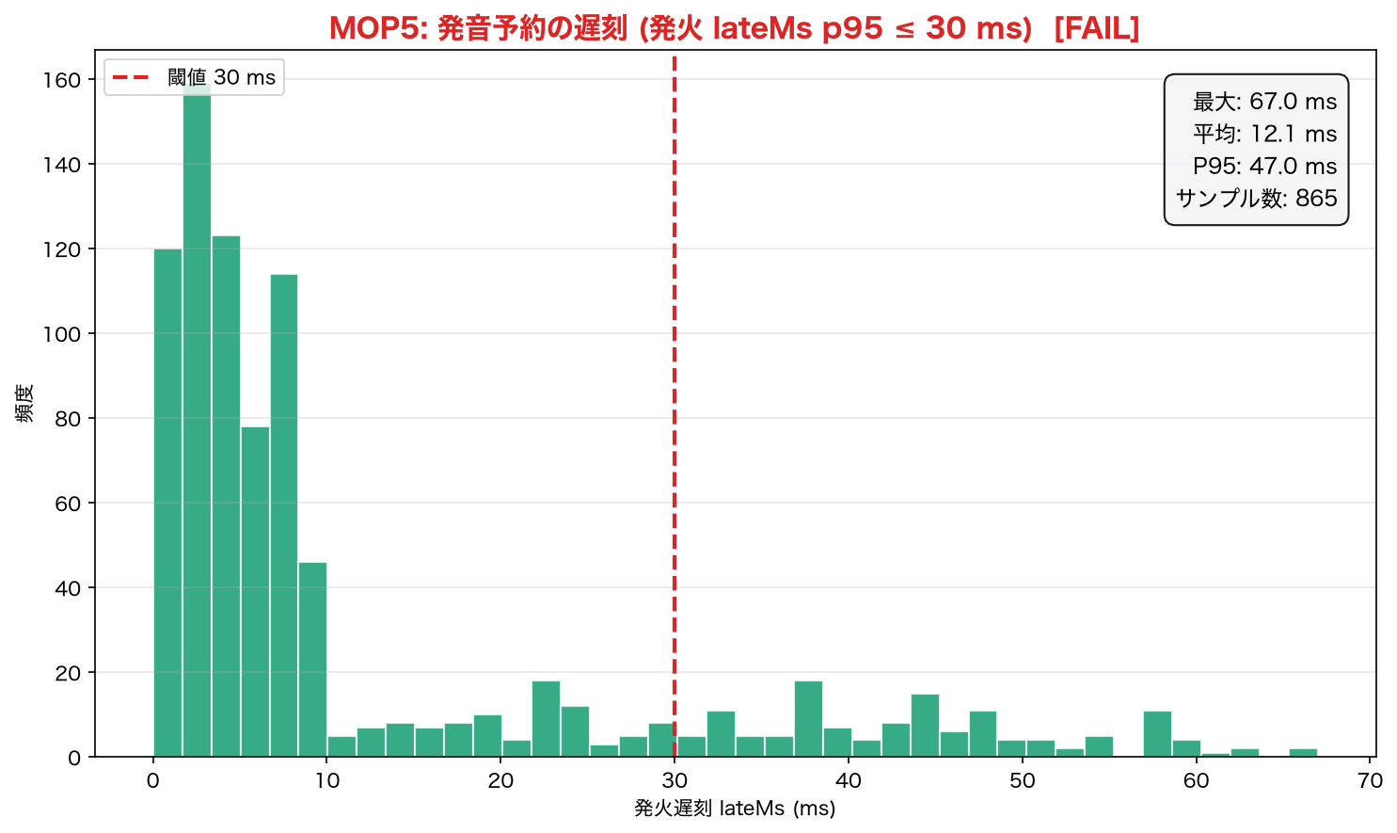
tools/verification/results/graphs/mop5_comm_delay.png
