takushio2525/2026-hackathon-team23/tools/verification/results/graphs/mop5_fire_delay_by_node.png

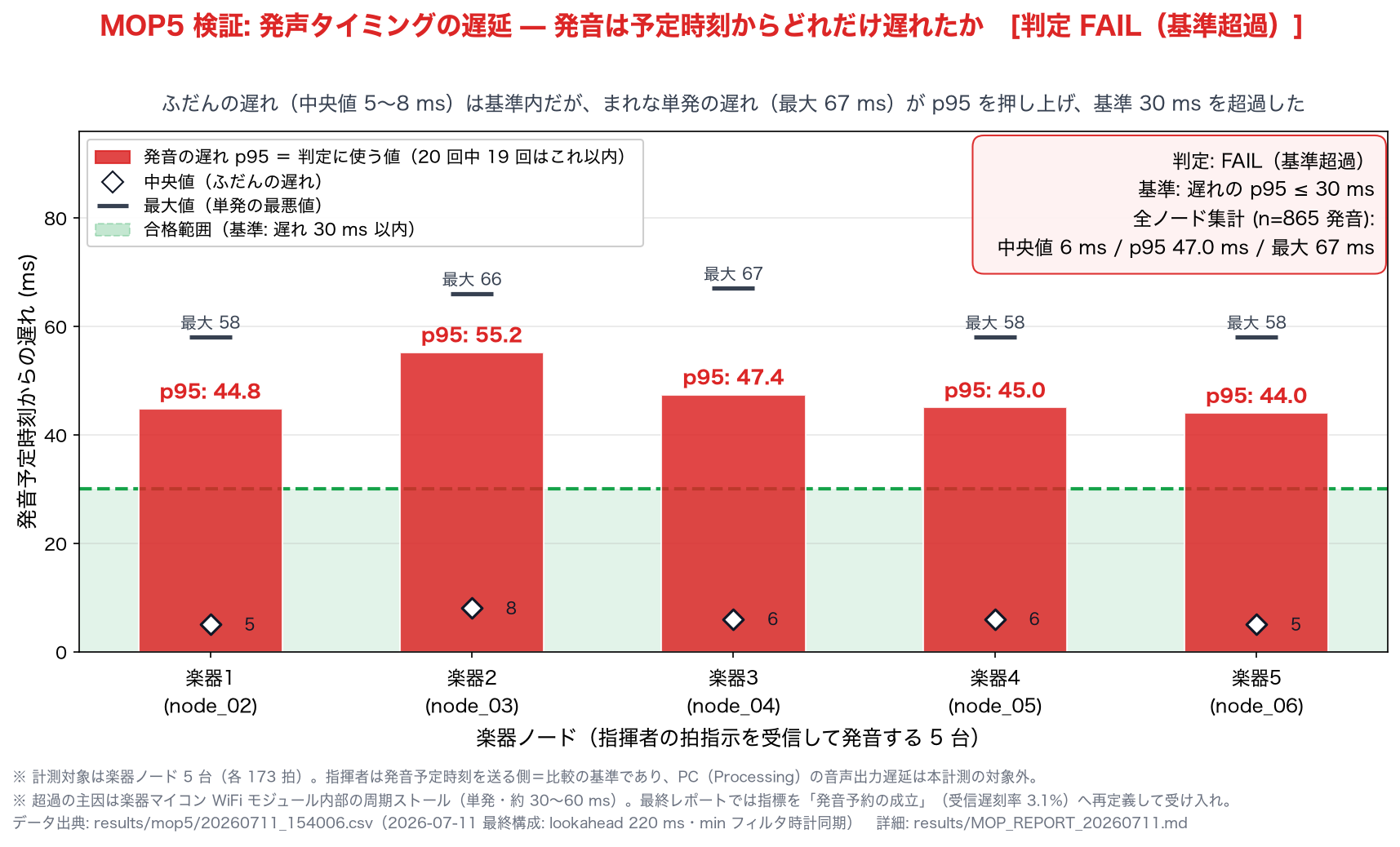
tools/verification/results/graphs/mop5_fire_delay_by_node.png
