takushio2525/2026-hackathon-team23/tools/verification/results/graphs/mop6_tempo_track.png

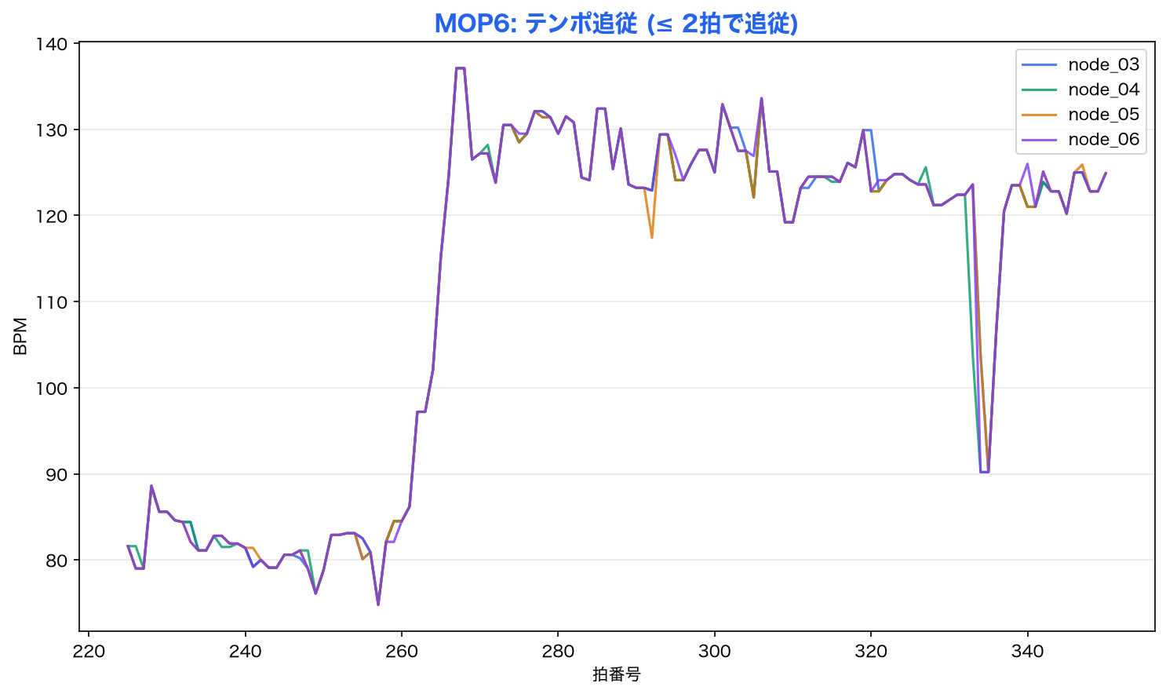
tools/verification/results/graphs/mop6_tempo_track.png
