takushio2525/2026-hackathon-team23/tools/verification/results/graphs/mop7_startup.png

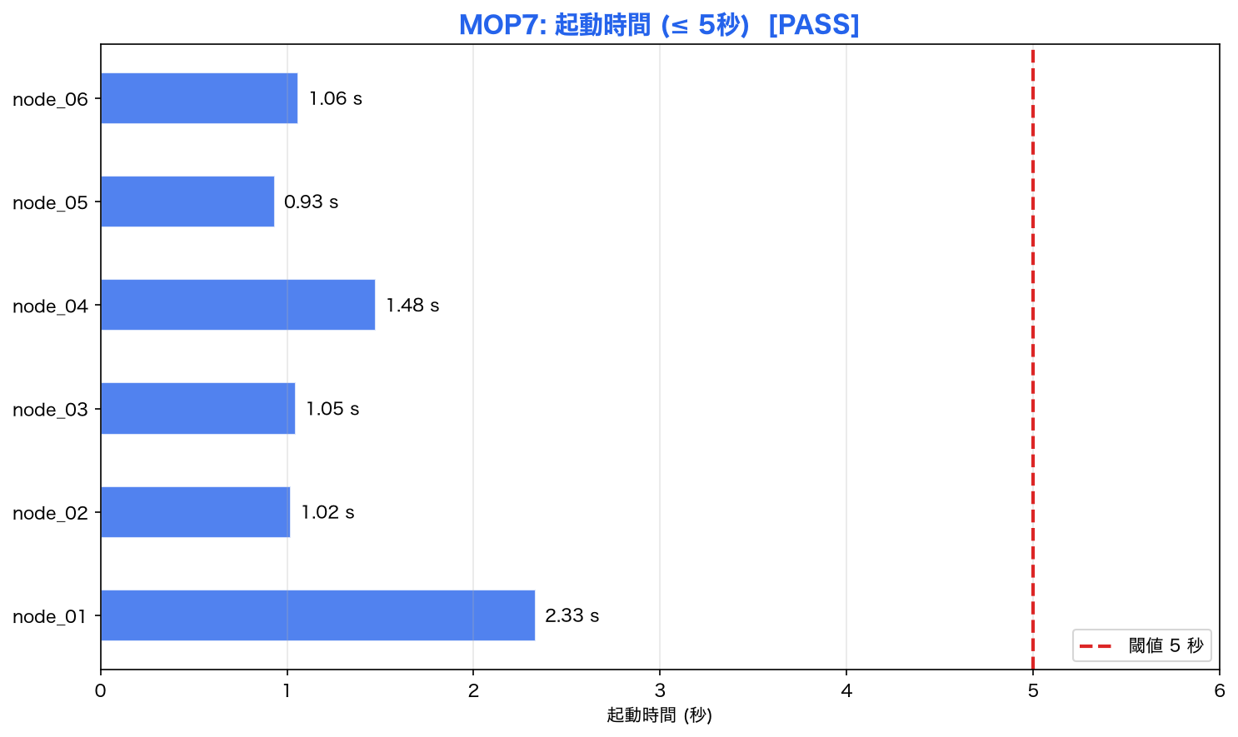
tools/verification/results/graphs/mop7_startup.png
