takushio2525/2026-hackathon-team23/tools/verification/results/graphs/mop8_cpu_load.png

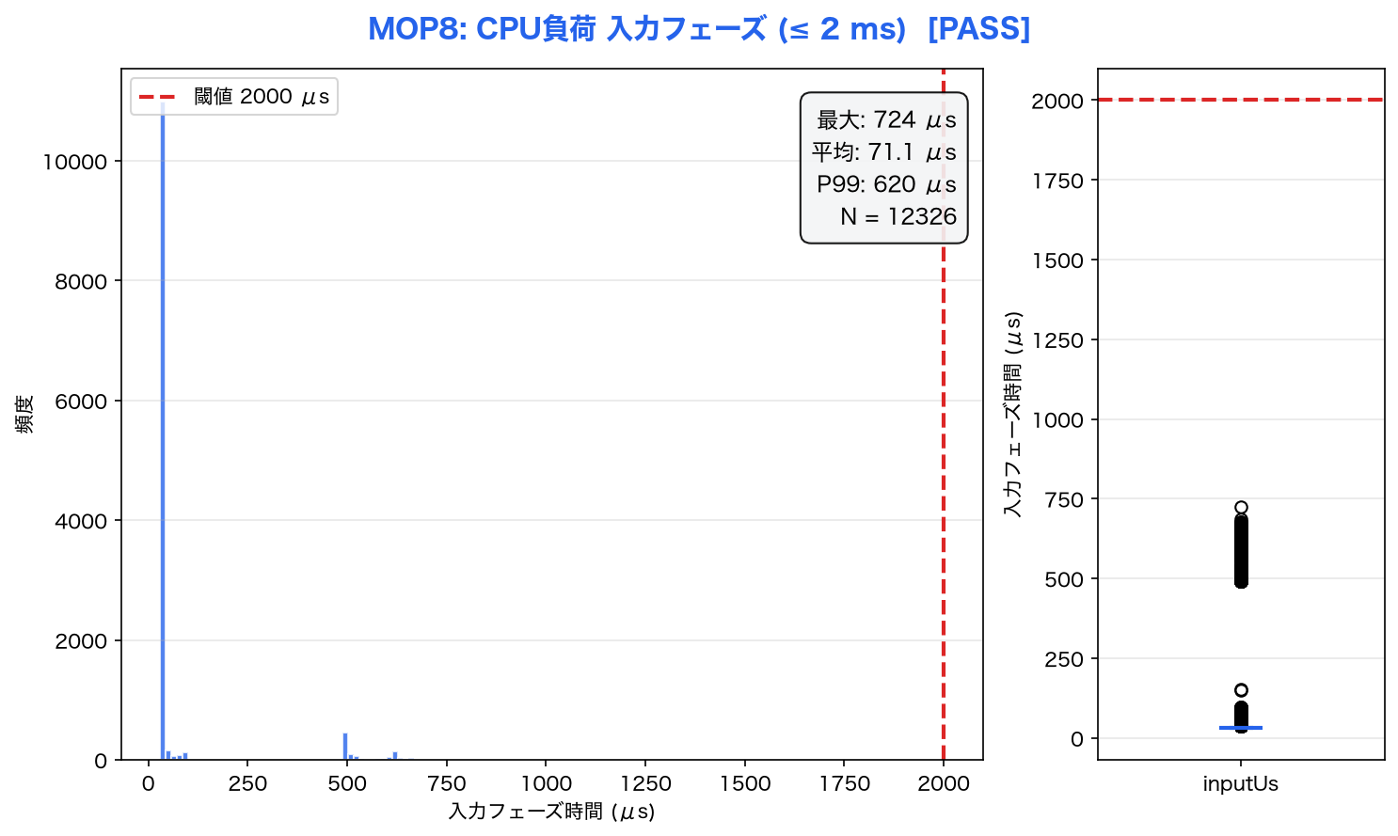
tools/verification/results/graphs/mop8_cpu_load.png
