takushio2525/2026-hackathon-team23/tools/verification/results/graphs/mop9_packet_loss.png

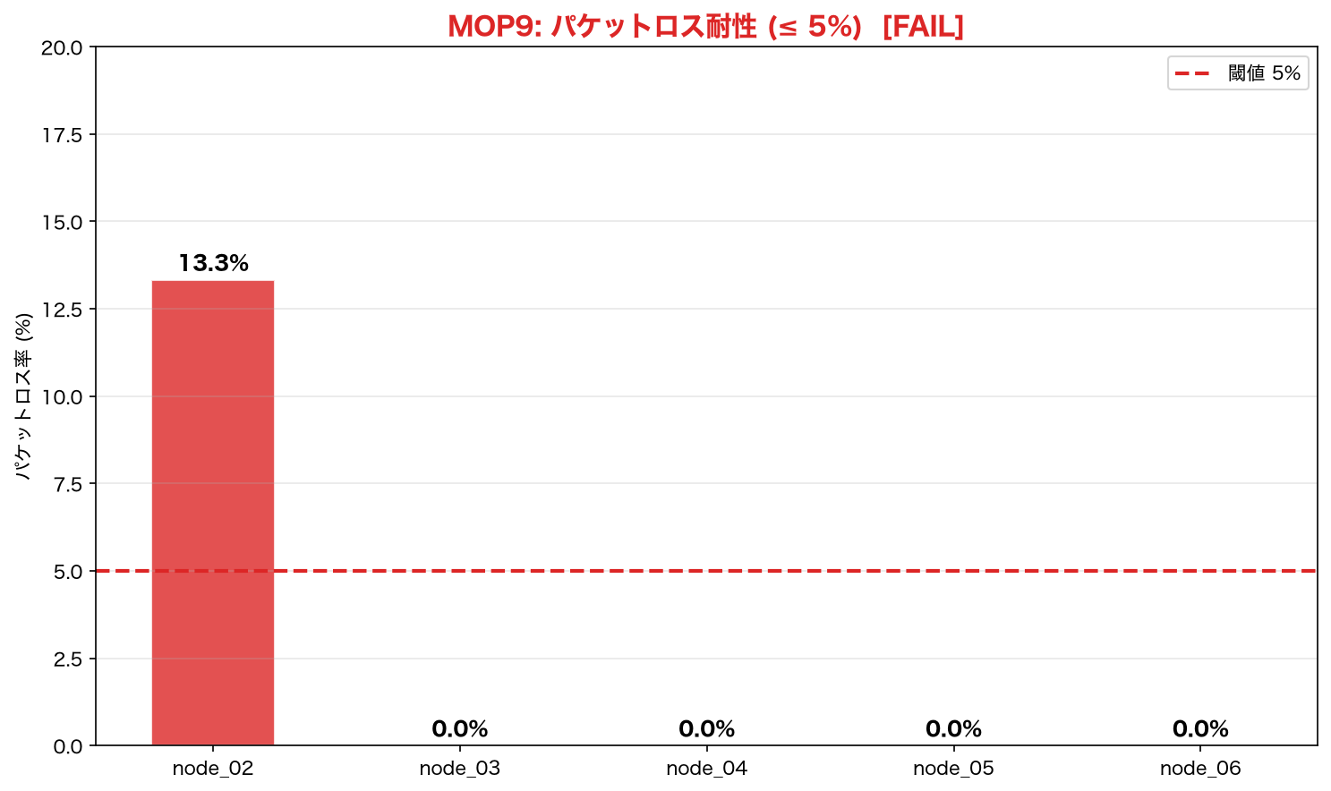
tools/verification/results/graphs/mop9_packet_loss.png
