takushio2525/2026-hackathon-team23/docs/src/content/docs/history/roles.md

---
title: チーム役割
description: チーム23の担当記録
---

| メンバー | 主担当 |
|---|---|
| 塩澤匠生 | Arduinoファームウェア、通信、同期、ゲームロジック |
| 齋藤翔太 | 楽譜データ、音階・音色の検討 |
| 梅澤颯太 | Processing、音色合成、演奏再生 |
| 御代川稜 | 議事録、実機検証、発表準備 |
| 地曵賢人 | 議事録、実機検証、発表準備 |
| 片岡聖 | 議事録、実機検証、発表準備 |

Arduino側は共通モジュールとノード差分を揃えるため、塩澤が通貫して設計・実装する方針でした。
楽譜とProcessingは通信パケットを境界に連携します。

このページは担当履歴です。現在の作業者や提出担当は、最新の議事録とGit履歴も確認してください。
