takushio2525/2026-hackathon-team23/docs/src/content/docs/presentation/faq.md

---
title: 想定問答と答え方
description: 成果発表で聞かれやすい質問に、根拠と限界を添えて答えるためのメモ
---

## 答え方の型

質問には、**結論 → 根拠 → 限界と次の対策**の順で答えます。できていないことを隠すより、測定して原因を切り分けたことを示す方が、設計と検証の信頼性を伝えられます。

:::tip[迷ったときの一文]
「実測ではここまで確認できています。一方でこの限界も見つかったため、原因と次の対策を整理しています。」
:::

## 作品と構成

### Q. これは何をする作品ですか？

**短く答える**：指揮棒を振ると、5台の楽器マイコンとPCが「かえるのうた」を合奏する作品です。

**補足するなら**：振る間隔からテンポを読み、金管4声とドラムを同期させます。自由に演奏するモードと、100 BPMを維持するゲームモードがあります。

### Q. なぜ楽器を5台に分けるのですか？

**短く答える**：複数の独立した楽器が、同じ指揮に合わせてそろうこと自体を体験にしたかったためです。

**根拠**：各UNO R4 WiFiが別の声部を担当し、PCには音符だけを送ります。楽器が増えるほど「同時に鳴らす」難しさが見えるため、同期方式を検証する題材にもなります。

### Q. なぜPCも使うのですか？

**短く答える**：マイコンは指揮と同期に集中し、PCは音作りと画面表示に集中する役割分担です。

**補足するなら**：PCはProcessingで金管の加算合成とドラム音を作るため、音色をJSONで入れ替えられます。

## 同期と通信

### Q. Wi-Fiなのに、どうして同時に鳴るのですか？

**短く答える**：受信した瞬間に鳴らさず、「同じ未来の時刻に鳴る」という予約を全楽器に渡すからです。

**根拠**：指揮者は拍を220 ms先の予定時刻付きで4回送ります。楽器は指揮者との時計差を推定し、その予定時刻まで待ってからPCへ音符を送ります。

**限界も伝える**：予約に間に合わない受信は最終構成で3.1%あり、完全なゼロではありません。ただし最大33 msの遅着は即時発音で回復し、欠音を避けています。

### Q. なぜTCPではなくUDPですか？

**短く答える**：拍は「古いものを確実に待つ」より、「次の拍をすぐ全員へ知らせる」ことが大切だからです。

**補足するなら**：UDPは複数の楽器へ一斉送信できます。落ちる可能性には、同じBEATを4回送ることと、楽器側で重複発音しない仕組みで対応しています。

### Q. 220 msの遅れは、操作感を悪くしませんか？

**短く答える**：指揮から音までには約220 msの一定の遅れが入りますが、楽器同士のずれを減らすために選んだ値です。

**根拠**：このWi-Fi環境では、マルチキャストが約205 ms周期でまとめて届く現象を実測しました。短い予約時間では、到着時刻のばらつきがそのまま演奏のずれになりました。

**言い換え**：「小さいがばらつく遅れ」より、「一定で予測できる遅れ」を選んで合奏を安定させました。

### Q. 時計はどのように合わせていますか？

**短く答える**：最近2秒間で最も早く届いた信号を基準に、通信待ちの影響が小さい時計差を使います。

**補足するなら**：平均を取る旧方式では、遅れて届いた信号の影響を受けました。最小遅延に近いサンプルを選ぶ方式に変え、予約が間に合わない割合を改善しました。

## 評価と限界

### Q. 「20 ms以内」と言いながら最大65 msなのはなぜですか？

**短く答える**：通常は中央値7 ms、平均10.8 msでそろいましたが、173拍中16拍（9.2%）には、デバイス内部の周期的な停止と見られる外れ値がありました。

**根拠**：同一拍における最速・最遅の楽器の発火時刻を、デバイス側で測りました。最大値だけを判定に使う当初の基準ではFAILですが、実演ではずれの指摘はなく、外れ値の原因と計測手段を残しています。

**避ける表現**：「20 msを達成しました」。代わりに「中央値7 msで、まれな外れ値の原因も特定しました」と答えます。

### Q. 通信遅延30 msの目標を変えたのは、都合のよい変更ではありませんか？

**短く答える**：当初の指標が、予約発音という設計と合っていないことを実測で確認したためです。

**根拠**：片道の生の配送遅延はこの環境で0〜約205 msにばらつき、しかも片方向の時計同期だけでは厳密に分離できません。一方、演奏品質に直接効くのは「予約時刻までに届くか」です。その指標では遅刻率を45.4%から3.1%へ改善できました。

**次の対策**：次回は、設計段階で「何を保証したいか」に対応する指標を先に定義します。

### Q. 何を測定して、どこまで信用できますか？

**短く答える**：拍検出、楽譜、同期、予約の成立、テンポ追従、起動、入力処理、パケット欠落を実機ログで測りました。

**根拠**：最終構成では拍検出100%、楽譜誤り0、パケット欠落0%を確認しています。同期はPCに届いた時刻ではなく、各楽器が発火した時点の推定マスタ時刻で測り直しました。

**限界も伝える**：音程のcent単位の録音検証（MOP2）は未検証です。また、絶対的な片道遅延を厳密に測るにはGPIOとロジックアナライザが必要です。

### Q. 今後は何を改善しますか？

**短く答える**：Wi-Fiモジュール由来と見られる周期ストールの根本対策と、音程の録音評価を進めます。

**補足するなら**：ストールの粒度を記録する計測を用意済みです。次回は、外れ値に強い分位点や超過率を使った評価基準も最初から設計します。

## 深掘りされたときの資料

- 同期の仕組みと設定値：[同期方式](/system/synchronization/)
- 最終結果と測定方法：[評価・検証](/guide/verification/)
- 数式を含む詳細：[時刻同期メカニズム](/deep-dive/time-sync/)
