takushio2525/2026-hackathon-team23/docs/src/content/docs/history/schedule.md

---
title: 授業・開発スケジュール
description: 2026年度ハッカソンの進行記録
---

| 日付 | 主な内容 |
|---|---|
| 2026-04-08 | チーム分け |
| 2026-04-15 | キックオフ、UDP・IMU方針 |
| 2026-04-22 | 目的、ゴール、役割分担 |
| 2026-04-29〜05-06 | 基本設計・詳細設計 |
| 2026-05-13 | 計画書・設計の確定 |
| 2026-05-20 | プロジェクト計画発表 |
| 2026-05-20〜06-17 | 実装・結合・調整 |
| 2026-06-24 | システム評価 |
| 2026-07-01 | 台風による休講（成果発表を延期） |
| 2026-07-08 | 成果発表 |
| 2026-07-15 | 振り返り・報告書修正 |

詳細な合意事項は`meetings/`、提出資料は`report/`、実装の確定状態はGit履歴を参照してください。
このページの日付は授業計画の記録であり、現在の作業期限を自動更新するものではありません。
