takushio2525/2026-hackathon-team23/work/umezawa/hck/week7/worklog_25G1021.pdf

# 作業ログ

報告者：梅澤颯太

報告日：2026 年 6 月 16 日

プロジェクト名：タクトーン～IMU ジェスチャーで奏でる Arduino オーケストラ～

## 1. 進捗サマリー（要約）

- 全体進捗率：95%
- マイルストーン達成状況：ガントチャートに載っている個人のタスクは全て完了
- 主要成果：
- 指揮棒側を 3D プリンタで作成するため，3D モデリングソフトの操作練習を行った．
- MOP 検証方法について，既存の目標値に対してどのような手順で確認するかを検討した．
- 課題：
- 指揮棒側の形状はまだ練習段階であり，さらに実際の部品寸法を検討する必要がある．
- MOP 検証方法は検討を始めた段階であり，実機で測定する項目と記録方法を具体化する必要がある．

### 1.1 ガントチャート

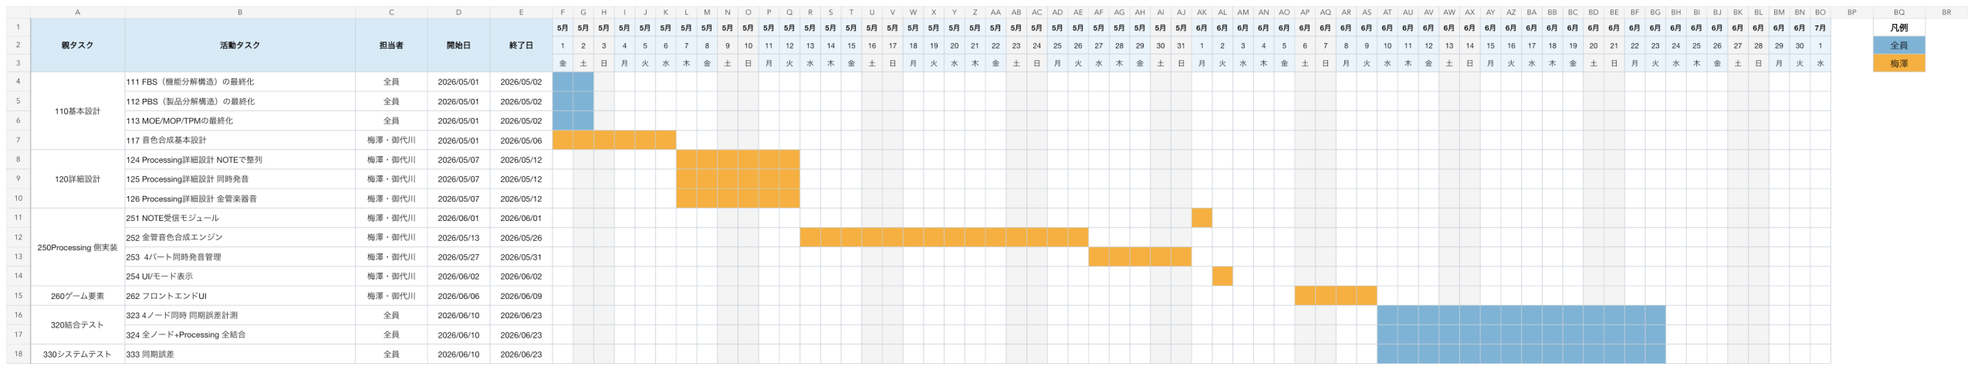
[picture p76: figure]

図 1 全体のガントチャート

## 2. 作業ログ（詳細トラッキング）

日付 | 作業時間 | 作業内容 | 成果・メモ
2026/06/14 | 1.5h | 指揮棒側を 3D プリンタで作るため
| | のモデリング練習を行った． | 3D モデリングソフトの基本操作を
| | | 確認し，指揮棒側の外装や保持部を
| | | 作るために必要な形状作成の流れ
| | | を練習した．
2026/06/16 | 10min | MOP 検証方法の検討を行った． | 同期誤差，通信遅延，拍検出精度な
| | | どの MOP について，実機で確認す
| | | る際にどのような測定項目が必要
| | | かを整理した．

## 3. 課題管理

課題 | 発生原因 | 影響度 | 優先度 | 対策 | 期限 | 状態
指揮棒側モデルの具 体化 | 今 回 は モ デ リ
| ン グ 練 習 が 中
| 心であり，実際
| に 3D プリンタ
| で 出 力 す る モ
| デ ル ま で は 作
| 成していない．
中 | 中 | 実 際 に 使 う 部
| | 品 の 寸 法 を 確
| | 認 し ，持 ち や
| | す さ と 内 部 ス
| | ペ ー ス を 考 慮
| | し た モ デ ル を
| | 作成する．
次回以降 | 対応予定

MOP 検証方法の具体
化

今 回 は 検 証 方
法 の 検 討 に と
どまり，実機で
の 測 定 手 順 や
記 録 形 式 ま で
は 確 定 し て い
ない．
中 | 中 | MOP ごとに測
| | 定対象，使用機
| | 材，記録項目，
| | 合 否 基 準 を 表
| | に整理する．
実機検証前 | 対応中

## 4. AI 利用状況と検証（再現性重視）

### 4.1 利用内容

- 利用目的：作業ログ文章の作成補助，MOP 検証方法の整理補助
- 入力（プロンプト要旨）：
- 以前の作業ログを参考に今週分の作業ログを作成するよう依頼した．
- 今週の作業として，指揮棒側を 3D プリンタで作るためのモデリング練習を 1 時間半行ったこと，MOP 検証方法を 10 分程度検討したことを伝えた．
- 出力概要：
- 以前の作業ログ形式に合わせて，進捗サマリー，作業ログ，課題管理，AI 利用状況，次回計画の文章 を作成した．
- ガントチャート上の個人のタスクが完了していることと，今週行った追加作業を分けて整理できた．

### 4.2 検証方法

- 検証手法：
- 作業ログの内容が実際の作業内容と一致しているかを確認する．

- 検証手順：
1. 生成されたものを実際の作業内容と照らし合わせる．

### 4.3 ファクトチェック結果

- 一致点：
- 記載されていることは全て一致していた．
- 不一致・疑義：
- なし
- 最終判断：
- レポート本文として採用する．
- 根拠：
- 実際の作業内容を正確に反映しているため．

## 5. 次回計画

- 目標：
- 指揮棒側の 3D プリンタ出力に向けて，実際の部品寸法を反映したモデルを作成する．
- MOP 検証を，実機で実行できるようにする．
- 達成基準：
- 指揮棒側モデルについて，指揮棒として違和感のない形になっていること．
- MOP 検証に基づいて，実機での測定項目と記録方法が確定していること．
- 期限：
- 次回作業時

## 6. その他

- ガントチャートに載っているタスクは完了したため，今週は発表に向けた外装検討と検証方法の整理を 行った．
- 3D プリンタで指揮棒側を作る場合，電子部品の寸法だけでなく，配線の逃げや持ったときの安定性も考慮

する必要がある．

## 7. 付録

無し
