takushio2525/2026-hackathon-team23/work/umezawa/hck/week8/worklog_25G1021.pdf

# 作業ログ

報告者：梅澤颯太

報告日：2026 年 6 月 23 日

プロジェクト名：タクトーン～IMU ジェスチャーで奏でる Arduino オーケストラ～

## 1. 進捗サマリー（要約）

- 全体進捗率：95%
- マイルストーン達成状況：ガントチャートに載っている個人のタスクは全て完了
- 主要成果：
- 指揮棒側の 3D プリンタ出力に向けて，基本形状を作成した．
- 部品を収めるための寸法と外形を調整し，出力前の試作モデルを完成させた．
- 課題：
- 試作モデルは未出力であり，実物での寸法，部品の収まり，持ちやすさを確認する必要がある．
- 3D プリンタ出力後に問題が見つかった場合は，配線の逃げや固定方法を含めてモデルを修正する必要

がある．

### 1.1 ガントチャート


図 1 全体のガントチャート

## 2. 作業ログ（詳細トラッキング）

日付 | 作業時間 | 作業内容 | 成果・メモ
2026/06/21 | 1.5h | 指揮棒側の 3D モデルの基本形状を
| | 作成した． | 前回のモデリング練習をもとに，指
| | | 揮棒として使用する外装の基本形
| | | 状を作成し，部品を収める位置と全
| | | 体の大きさを検討した．
2026/06/23 | 1h | 3D モデルの寸法と形状を調整し
| | た． | 部品の収まりと持ちやすさを考慮
| | | して寸法と外形を調整し，3D プリ
| | | ンタで出力する前段階の試作モデ
| | | ルを完成させた．

## 3. 課題管理

課題 | 発生原因 | 影響度 | 優先度 | 対策 | 期限 | 状態
試作モデルの出力確 認 | 現時点では 3D
| モ デ ル 上 で の
| 確認のみで，3D
| プ リ ン タ に よ
| る 出 力 を 行 っ
| ていない．
高 | 高 | 試 作 モ デ ル を
| | 出力し，寸法，
| | 強度，部品の収
| | ま り を 確 認 す
| | る．
次回作業時 | 対応予定

持ちやすさと配線ス
ペースの確認

画 面 上 で は 実
際 に 握 っ た と
きの感覚や，配
線 を 通 し た 際
の 余 裕 を 確 認
できない．
中 | 中 | 出 力 し た 試 作
| | 品 へ 部 品 を 仮
| | 配置し，持ちや
| | す さ と 配 線 の
| | 逃 げ を 確 認 し
| | て 必 要 箇 所 を
| | 修正する．
実機組立前 | 対応予定

## 4. AI 利用状況と検証（再現性重視）

### 4.1 利用内容

- 利用目的：作業ログ文章の作成補助
- 入力（プロンプト要旨）：
- 前週の作業ログを参考に，同じ構成で今週分の作業ログを作成するよう依頼した．
- 6 月 21 日に 1 時間 30 分かけて指揮棒の基本形状を作成し，6 月 23 日に 1 時間かけて寸法と形状を調 整して試作モデルを完成させたことを伝えた．
- 出力概要：

- 前週の形式に合わせて，進捗サマリー，作業ログ，課題管理，AI 利用状況，次回計画の文章を作成した．
- 3D モデルの作成段階と，出力後に確認すべき課題を分けて整理できた．

### 4.2 検証方法

- 検証手法：
- 作業ログに記載された日付，作業時間，作業内容が実際の作業と一致しているかを確認する．
- 試作モデルを実物として完成したものと誤解させる表現がないかを確認する．
- 検証手順：
1. 6 月 21 日と 6 月 23 日の作業内容を生成された文章と照らし合わせる．
2. 作業時間の合計が 2 時間 30 分であることを確認する．
3. 成果が 3D プリンタ出力前の試作モデルであることを確認する．

### 4.3 ファクトチェック結果

- 一致点：
- 日付，作業時間，基本形状の作成，寸法と形状の調整，試作モデルの完成について，実際の作業内容と 一致していた．
- 不一致・疑義：
- なし
- 最終判断：
- レポート本文として採用する．
- 根拠：
- 実際の作業内容と作業時間を正確に反映し，未実施の 3D プリンタ出力を次回課題として区別している ため．

## 5. 次回計画

- 目標：
- 完成した試作モデルを 3D プリンタで出力する．
- 出力した試作品に電子部品を仮配置し，寸法と持ちやすさを確認する．
- 達成基準：
- 3D プリンタでモデルを正常に出力できること．
- 電子部品と配線を収められ，指揮棒として無理なく持てる形状であること．
- 問題が見つかった場合に，修正箇所を具体的に整理できること．
- 期限：
- 次回作業時 | 3

## 6. その他

- 今週は前週に行ったモデリング練習をもとに，実際の指揮棒用試作モデルを作成した．
- 3D プリンタ出力後は，モデル上の寸法だけでなく，部品の固定，配線の取り回し，握ったときの安定性を 確認する必要がある．

## 7. 付録

無し
