takushio2525/2026-hackathon-team23/work/umezawa/hck/week5/worklog_25G1021.pdf

# 作業ログ

報告者：梅澤颯太

報告日：2026 年 5 月 26 日

プロジェクト名：タクトーン～IMU ジェスチャーで奏でる Arduino オーケストラ～

## 1. 進捗サマリー（要約）

- 全体進捗率：40%
- マイルストーン達成状況：達成
- 主要成果：
- 252「金管音色合成エンジン」の楽器音を合成して鳴らす部分を仮作成した．
- 倍音構成と ADSR による金管風音色の実装を行った．
- 課題：
- NOTE 受信モジュールとの結合確認は，6 月 1 日の同モジュール実装後に次工程として扱う．

### 1.1 ガントチャート


図 1 全体のガントチャート

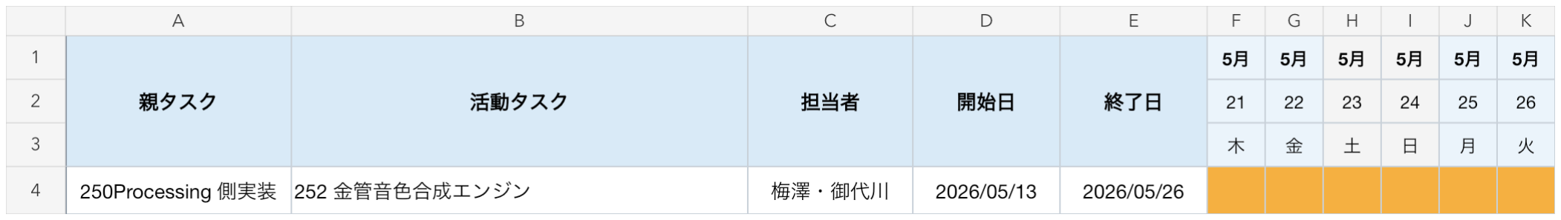
[picture p78: figure]

図 2 今週のガントチャート

## 2. 作業ログ（詳細トラッキング）

日付 | 作業時間 | 作業内容 | 成果・メモ
2026/05/24 | 2h | 金管音色合成エンジンを仮作成し
| | た． | 楽器音を合成して鳴らす部分を作
| | | り，倍音構成と ADSR を用いた音
| | | 色合成の基本方針を整理した．
2026/05/25 | 2.5h | 倍音構成と ADSR による金管風音
| | 色を実装した． | 金管風音色を鳴らすための初期実
| | | 装を行い，今週のガントチャート上
| | | の作業範囲を完了した．

## 3. 課題管理

課題 | 発生原因 | 影響度 | 優先度 | 対策 | 期限 | 状態
NOTE 受信モジュール との結合確認 | 今 週 は 音 色 合
| 成 エ ン ジ ン の
| 仮 作 成 と 音 色
| 作 成 を 対 象 と
| し ，受 信 モ ジ
| ュ ー ル は 次 工
| 程 で 実 装 予 定
| のため．
中 | 中 | 6 月 1 日 に
| | NOTE 受信モジ
| | ュ ー ル を 実 装
| | した後，音色合
| | 成 エ ン ジ ン へ
| | 接 続 し て 確 認
| | する．

2026/06/01
以降

未対応

## 4. AI 利用状況と検証（再現性重視）

### 4.1 利用内容

- 利用目的：設計整理，実装方針の確認，作業ログ文章の整理
- 入力（プロンプト要旨）：
- 倍音構成，ADSR の考え方，Processing での音色合成実装の整理について質問した．
- 出力概要：
- 金管楽器らしい音色を作るための倍音比率，ADSR 設定，Processing 上での実装方針を整理できた．

### 4.2 検証方法

- 検証手法：
- Processing で実際に音を鳴らし，意図した楽器音として聞こえるかを確認する．
- 参照資料：

- これまでの設計資料，AI から得た倍音構成・ADSR に関する整理結果．
- 検証手順：
1. 倍音構成と ADSR 値をもとに，金管風音色の初期実装を作成する．
2. Processing で音を鳴らし，音量，立ち上がり，余韻が確認できるかを聴感で確認する．

### 4.3 ファクトチェック結果

- 一致点：
- 金管音色は倍音構成と ADSR の立ち上がり・減衰で印象が変わるという方針は，これまでの設計方針 と整合している．
- 不一致・疑義：
- 実際の楽器音として十分自然かどうかは，聴感確認と今後の結合確認で追加検証が必要である．
- 最終判断：
- 採用
- 根拠：
- 今週の目的は金管音色合成エンジンの仮作成であり，倍音構成と ADSR による金管風音色を鳴らせる 状態まで進めたため．

## 5. 次回計画

- 目標：
- NOTE 受信モジュールを実装し，受信した音情報を音色合成エンジンへ渡せるようにする．
- 達成基準：
- NOTE 受信後に，金管風音色を選択して鳴らせる状態にする．
- 期限：
- 2026/06/01

## 6. その他

- 今週は音色合成エンジン単体の作業を対象としたため，NOTE 受信モジュールとの結合確認は次回以降に実 施する．

## 7. 付録

無し
