takushio2525/2026-hackathon-team23/work/shiozawa/最終報告書/fig/conductor-circuit-kicad.pdf

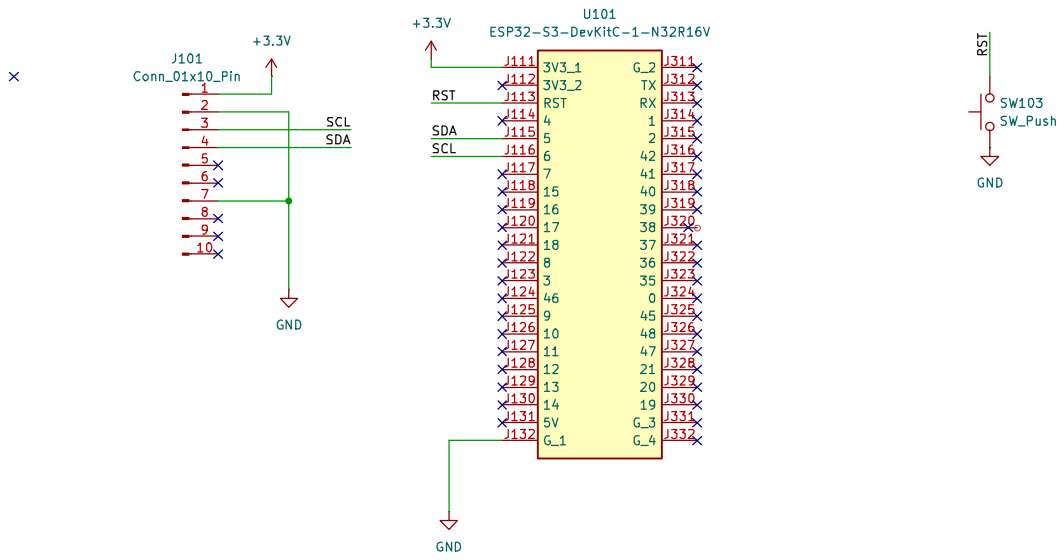
[picture p79: page 1]
