takushio2525/2026-hackathon-team23/hardware/baton/baton.kicad_sch

## KiCad design hardware/baton/baton.kicad_sch (2026-06-17)

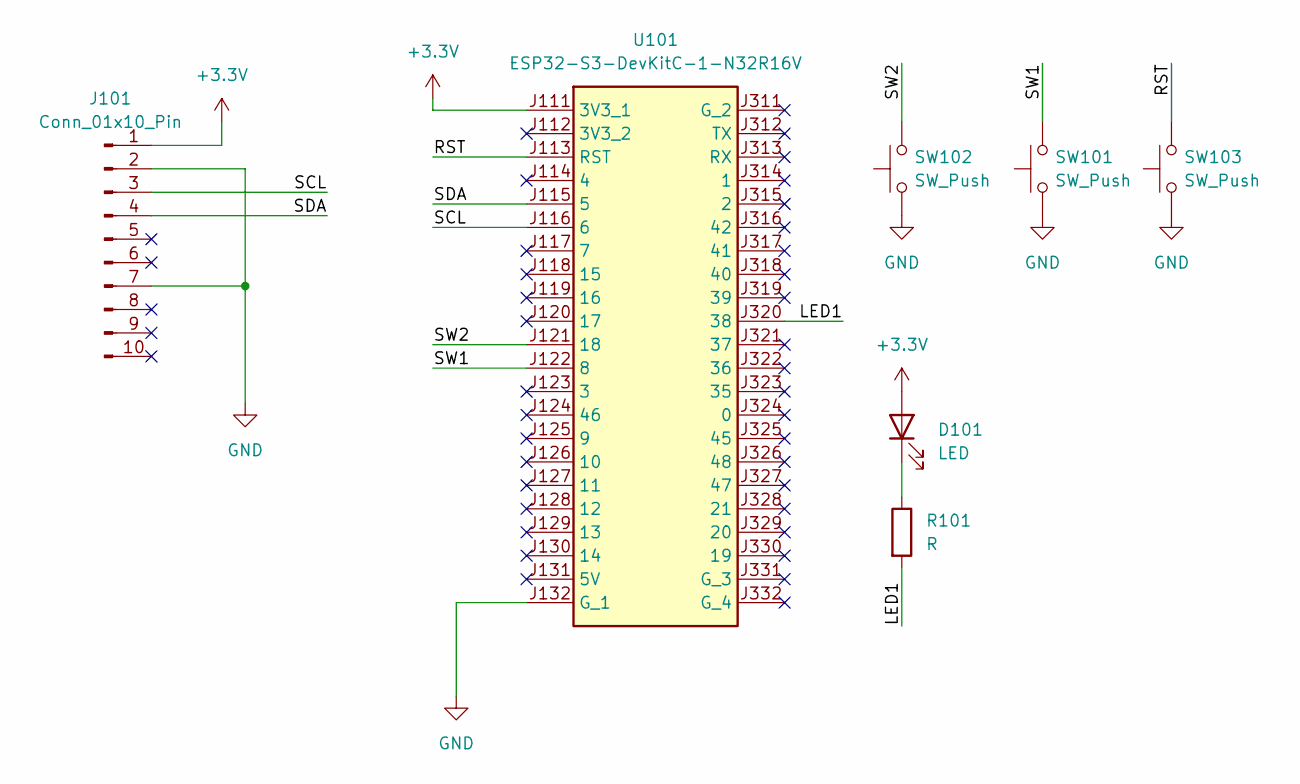
[picture p80: schematic baton.kicad_sch]

Parts:
D101: LED; LED_D3.0mm_Clear
J101: Conn_01x10_Pin; PinHeader_1x10_P2.54mm_Vertical
R101: R; R_Axial_DIN0207_L6.3mm_D2.5mm_P7.62mm_Horizontal
SW101, SW102, SW103: SW_Push; SW_PUSH_6mm
U101: ESP32-S3-DevKitC-1-N32R16V; ESP32S3DevKitC1N32R16V; Manufacturer_Part_Number ESP32-S3-DevKitC-1-N32R16V; Mouser Part Number 356-32S3DKTC1N32R16V

Connections:
+3.3V: D101.2 (A), J101.1, U101.J111 (3V3_1)
GND: J101.2, J101.7, SW101.1, SW102.1, SW103.1, U101.J132 (G_1)
LED1: R101.2, U101.J320 (38)
unnamed: D101.1 (K), R101.1
RST: SW103.2, U101.J113 (RST)
SCL: J101.3, U101.J116 (6)
SDA: J101.4, U101.J115 (5)
SW1: SW101.2, U101.J122 (8)
SW2: SW102.2, U101.J121 (18)
