takushio2525/2026-hackathon-team23/firmware/production/node_01/include/ProjectConfig.h

// Build / Upload / Monitor (run from project root):
//   pio run -d firmware/production/node_01
//   pio run -d firmware/production/node_01 -t upload
//   pio device monitor -d firmware/production/node_01
//
// 指揮者ノード node_01 のピン/定数/閾値を一元管理
// 具体値はこの 1 ファイルでだけ管理し、モジュール本体にはハードコードしない
#pragma once
#include <Arduino.h>
#include <IPAddress.h>

#include "OrcNetModule.h"
#include "StatusLedModule.h"
#include "ImuModule.h"
#include "OrcSenderModule.h"

// XIAO ESP32-S3 Sense の I2C 既定ピン (D4=GPIO5, D5=GPIO6)
constexpr uint8_t I2C_SDA_PIN = 5;
constexpr uint8_t I2C_SCL_PIN = 6;

inline const ImuConfig IMU_CONFIG = {
    /*address=*/          0x68,
    /*sampleIntervalMs=*/ 5,
    /*accelRangeG=*/      4,
    /*gyroRangeDps=*/     2000,
};

inline const OrcNetConfig ORC_NET_CONFIG = {
    /*mode=*/                WifiMode::SoftAp,
    /*ssid=*/                "OrchestraAP",
    /*pass=*/                "orchestra2026",
    /*multicastIp=*/         IPAddress(239, 0, 0, 1),
    /*udpPort=*/             5001,
    /*channel=*/             6,
    /*reconnectIntervalMs=*/ 2000,
    /*beatGapMs=*/           2,    // 連送 4 発を 2ms 間隔で時間分散し radio のまとめ落ちを軽減
};

inline const OrcSenderConfig ORC_SENDER_CONFIG = {
    /*ctrlIntervalMs=*/  50,   // 20 Hz
    /*beatRedundancy=*/  4,    // 同一 BEAT を 4 連送 (旧 2 だが ESP32-S3 SoftAP の radio ロス対策。連送間隔は OrcNetModule の beatGapMs で設定)
    /*beatLookaheadMs=*/ 220,  // playAtMasterMs = masterNow + 220 ms。
                               // SoftAP のマルチキャストが STA 省電力の DTIM バッファリングで
                               // 204.8ms (ビーコン 102.4ms × 2) 周期のバースト配送になり、
                               // BEAT が最大 ~205ms 遅れて届く実測に基づく暫定値
                               // (tools/verification/results/MOP5_systematic_shift_analysis_20260710.md §3/§8 案1)。
                               // 旧 45ms では 発火遅刻 真値 p95 ≈145ms と構造的に不足していた。
                               // 代償: 指揮→発音の固定遅延が ~220ms (120BPM で約半拍)。
                               // OrcNetModule の SoftAP ビーコン間隔短縮 (バースト周期 ~51ms 化) の
                               // 効果を実測で確認できたら 70ms 程度まで短縮可。
};

inline const StatusLedConfig STATUS_LED_CONFIG = {
    /*pin=*/             LED_BUILTIN,   // XIAO ESP32-S3 では GPIO21 (User LED)
    /*blinkIntervalMs=*/ 500,
    /*activeLow=*/       true,          // XIAO ESP32-S3 の User LED は LOW で点灯
};

// applyPattern() のロジック係数
namespace logic_params {
    constexpr float    LPF_ALPHA               = 0.10f;
    // 拍検出閾値 (Armed 突入トリガ): 動加速度ノルム dynNorm (= LPF 後の加速度
    // ノルム − キャリブ済み静止ノルム ≒1g) がこれを超えたら拍候補とみなす。
    // 姿勢非依存のスカラー量で、重力相当は引かれているので純粋な振りの加速度
    // 強度で判定する。振り下ろし加速のピーク値を狙う。
    // 経緯: 仕様書の 1.8g は重力込み前提で届かず、0.8g では小さい揺れで誤検出
    // (= 勝手に進む) したため中間の 1.2g に調整。
    // 注意: ノルム差なので重力に直交する向きの振りは過小評価される
    // (|g + a| − |g| = sqrt(1 + a²) − 1 < a)。実機で取りこぼし/誤検出が出たら
    // 1.0〜1.4 の範囲で再調整する。
    constexpr float    BEAT_DYN_THRESHOLD_G    = 1.20f;
    // 不応期: 1 振りの中で「振り下ろし -> 振り戻し」の両方を 2 拍として
    // 拾わないために必要。350 ms = 約 170 BPM 上限。普通の指揮なら十分。
    constexpr uint32_t BEAT_REFRACTORY_MS      = 350;
    // 振り終わり (リリース) 判定: 以下の OR でリリースと見なす。
    //   (a) 動加速度が BEAT_RELEASE_G 未満 (= 完全停止)
    //   (b) 動加速度が Armed 中ピークの BEAT_RELEASE_RATIO 未満
    //       (= ピークアウト後、相対的に十分減衰)
    // 連続スイングだと dynNorm が 0 まで落ちきらないので、(b) で拾う。
    constexpr float    BEAT_RELEASE_G          = 0.20f;
    constexpr float    BEAT_RELEASE_RATIO      = 0.40f;
    // Armed 突入直後の単発ノイズで誤リリースしないための最低保持時間。
    constexpr uint32_t BEAT_ARMED_MIN_HOLD_MS  = 50;
    // リリース判定デバウンス: (releaseAbs || releaseRatio) が連続して
    // この時間以上成立したら真のリリースと見なす。振り途中の一瞬の dynNorm
    // dip で Armed を抜けて再 Armed→再発火するのを防ぐ。
    // 5ms 周期 IMU で 8 サンプル分。短すぎると効かず、長すぎるとリリースが
    // 遅れて連続スイングのテンポが乱れる。
    constexpr uint32_t BEAT_RELEASE_HOLD_MS    = 40;
    // Armed が長引いたら強制終了。普通の振り下ろしは 200〜500 ms 程度。
    // タイムアウトでも path/refractory を満たせば拍として採用する (取りこぼし防止)。
    constexpr uint32_t BEAT_ARMED_TIMEOUT_MS   = 800;
    // 早期発火の閾値 (= "swing intensity" の最低ライン)。
    // Armed セッション中、擬似経路長 sPathLen がこの値に達した瞬間に拍を発火
    // する。本振りなら Armed 突入から ~150 ms 程度で到達するため、振りと
    // 音がほぼ同時に感じられる。
    // 0.10 では軽い振れ (peak 1.3 g 程度) でも 100 ms で蓄積して誤発火した
    // ため 0.20 に引き上げ。
    // 1 Armed セッションに 1 回しか発火しない & 発火後も Armed を維持して
    // リリース/timeout を待つため、同じ振り中に二重発火しない。連続スイング
    // で「発火→即 Idle→再 Arm→refractory 境界で再発火」という連続発火
    // ループも構造的に発生しない。
    constexpr float    BEAT_FIRE_PATH_M        = 0.20f;
    // g -> m/s^2 変換係数 (ISO 標準重力)
    constexpr float    GRAVITY_MS2             = 9.80665f;
    constexpr float    BPM_EMA_ALPHA           = 0.30f;
    constexpr float    BPM_MIN                 = 40.0f;
    constexpr float    BPM_MAX                 = 240.0f;
    constexpr uint32_t CALIBRATION_MS          = 2000;
    constexpr uint32_t IMU_TIMEOUT_MS          = 200;
    // LED 点滅周期
    constexpr uint16_t LED_IDLE_MS             = 1000;  // 1 Hz
    constexpr uint16_t LED_CALIBRATING_MS      = 500;   // 2 Hz
    constexpr uint16_t LED_FALLBACK_MS         = 200;   // 5 Hz
    constexpr uint16_t LED_MENU_MS             = 300;   // メニュー中 (約 1.7 Hz)
    constexpr uint16_t LED_RESULT_MS           = 120;   // 結果表示中 (速い点滅で完了を示す)

    // ── production ゲームモード: IMU メニューナビ (重力基準の縦/横判定) ──
    // 加速度の遅い LPF で重力ベクトルを推定し、振り加速度 (accLpf − 推定重力) を
    // 「重力軸成分」と「水平面成分」に分解して判定する。センサに取り付け角度が
    // ついていても「地面に対して垂直に振れば縦 (決定) / 水平に振れば横 (カーソル)」
    // になる。旧方式のセンサ軸直読み (NAV_LR_AXIS/NAV_UD_AXIS) は取り付け角度で
    // 破綻したため廃止。
    constexpr float    NAV_SWING_THRESHOLD_G   = 1.00f; // ナビ振り検出しきい値 (拍検出 1.20g より低め)
    constexpr float    NAV_RELEASE_G           = 0.30f; // ナビゲート解放 (1 振り=1 操作にするため)
    constexpr uint32_t NAV_REFRACTORY_MS       = 400;   // ナビ不応期 (誤連打防止)
    // 縦/横の判定窓: Armed 突入からこの時間、重力軸/水平面の両成分を積算し、
    // 窓終了かリリース (dynNorm < NAV_RELEASE_G) の早い方で 1 回だけ判定・発火する。
    // 瞬時値判定だと振り始めの向きの暴れを拾うため、窓積算で振り全体の支配方向を見る。
    constexpr uint32_t NAV_DECISION_WINDOW_MS  = 250;
    // 縦 (決定) と判定する優勢比: vertAccum >= horizAccum × この値 で縦。
    // 上げるほど縦判定が厳しくなる (横に寄る)。1.0 = 単純比較。
    constexpr float    NAV_VERT_DOMINANCE      = 0.55f;
    // 横振りのカーソル移動方向の符号。実機で「右に振ったのに左へ動く」なら -1.0 に反転。
    constexpr float    NAV_LR_SIGN             = 1.0f;
    // 重力推定 LPF: accLpf をさらに遅い LPF に通す (5ms 周期 α=0.01 で時定数 ≈0.5s)。
    // dynNorm が NAV_GRAV_FREEZE_G 以上の間 (振り中) は更新を凍結し、
    // 振り加速度が重力推定へ漏れ込むのを防ぐ。
    constexpr float    NAV_GRAV_LPF_ALPHA      = 0.01f;
    constexpr float    NAV_GRAV_FREEZE_G       = 0.30f;
    constexpr uint8_t  MENU_ITEM_COUNT         = 2;     // メニュー項目数 (0=自由演奏 / 1=ゲーム)

    // ── production: 状態遷移直後のデッドタイム (ジェスチャ/拍検出の不感時間) ──
    // 遷移を起こした振りの残り (惰性・戻し) を次状態の入力として拾わないための時間。
    //   Menu→Conducting: メニュー決定の縦振りが演奏の 1 拍目として誤検出される
    //   Conducting→Result: 最後の音符の振りが Result の縦振り操作として誤検出され
    //                      点数を見る前に Menu へ戻ってしまう
    // を防ぐ。全状態遷移に一律で適用する (Fallback 復帰直後の誤検出も同時に防げる)。
    // 実機で「待たされ感」が強ければ 500〜800ms へ詰める。
    constexpr uint32_t STATE_TRANSITION_DEADTIME_MS = 600;

    // ── production ゲームモード: ゲーム進行・採点・ガイドフェード ──
    // 全パートが演奏を完了するまで = CANON_CYCLE_BEATS (56 拍) をゲーム 1 セッションとする。
    // 最終声部 (node_05, headRestBeats=24) は拍 25 から演奏を開始し拍 56 で完了する。
    constexpr uint16_t GAME_LENGTH_BEATS       = 56;
    constexpr uint8_t  GAME_TARGET_BPM         = 100;   // 目標テンポ (固定・設定値)
    // メトロノームガイド強度の固定スケジュール (経過拍ベース):
    //   beat <  FULL          : 強度 1.0 (はっきり刻む)
    //   FULL <= beat <  ZERO  : 1.0→0 へ線形フェード
    //   beat >= ZERO          : 強度 0   (ガイドなし・記憶で維持)
    // 採点重み = 1 - 強度 (ガイドが薄い/無い区間ほど重く配点)。
    constexpr uint16_t GAME_GUIDE_FULL_BEATS   = 16;
    constexpr uint16_t GAME_GUIDE_ZERO_BEATS   = 32;
    // 採点の許容誤差比: 拍間隔誤差が目標拍間隔のこの割合に達したら 0 点。0.5 = 半拍ずれで 0 点。
    constexpr float    GAME_SCORE_TOLERANCE_RATIO = 0.5f;
}
