takushio2525/2026-hackathon-team23/firmware/production/node_02/src/applyPattern.cpp

// Build / Upload / Monitor (run from project root):
//   pio run -d firmware/production/node_02
//   pio run -d firmware/production/node_02 -t upload
//   pio device monitor -d firmware/production/node_02
//
// 楽器ノード (輪唱の 1 声部) の判断ロジック
// 設計方針: BPM はあくまで補助 (durationMs 計算で使用)。score の進行は
// 「指揮者の拍番号 firedBeatNo」で決める。輪唱は headRestBeats だけ頭の拍を
// 読み飛ばしてから kScore[0] を鳴らし始める (声部ごとにずれて入る)。
// 周回は CANON_CYCLE_BEATS (曲長 + 最終声部の遅延) のサイクル窓で管理し、
// 最終声部 (node_05) が 1 周を終えるまで先頭声部は次の周回を始めない。
// 拍番号駆動なので、Processing をいつ起動しても「曲の現在位置」から自然に鳴る。
//
// 処理フロー:
//   1. 時計オフセット更新 (受信側で済 — Receiver が data.sync を更新)
//   2. 演奏状態遷移 (Idle -> WaitStart -> Playing)
//   3. 保留 BEAT のキューイング (受信側で済 — data.receiver.pending)
//   4. マスタ時刻判定 (発音粒度)
//   5. 楽譜進行: firedBeatNo と headRestBeats から kScore のインデックスを算出して発火
//   6. velocity 合成 (fireScoreEvent 内)
#include <Arduino.h>

#include "SystemData.h"
#include "ProjectConfig.h"
#include "SerialDebug.h"
#include "MopTest.h"
#include "score_data.h"

namespace {

// durationQ8 を ms に変換 (Q8: 256 = 1 拍)
// BPM は CTRL から受け取った参考値。NoteOff の予定時刻計算に使う補助。
uint16_t durationQ8ToMs(uint16_t durationQ8, float bpm) {
    const float beats = (float)durationQ8 / 256.0f;
    const float ms = beats * 60000.0f / (bpm < 10.0f ? logic_params::DEFAULT_BPM : bpm);
    return (uint16_t)(ms > 60000.0f ? 60000.0f : ms);
}

// 楽譜の 1 イベントを発火 (NoteOn 予約のみ)。
// 消音は Processing 側が NotePacket.durationMs から自動で行うため、ここでは
// noteIsSounding 等の追跡は不要。
// 細分音符 (subNote != 0) があれば、現在 BPM から ms を計算して予約スロットに積む。
void fireScoreEvent(SystemData& data, const ScoreEvent& ev, uint32_t now) {
    const bool isRest = (ev.flags & 0x04) != 0 || ev.noteNumber == 0;
    if (!isRest) {
        // velocity 合成: score × ctrl / 127
        uint16_t v = ((uint16_t)ev.velocity * (uint16_t)data.ctrl.velocity) / 127;
        if (v > 127) v = 127;

        const uint16_t durMs = durationQ8ToMs(ev.durationQ8, data.ctrl.bpm);
        data.noteOut.noteNumber = ev.noteNumber;
        data.noteOut.velocity   = (uint8_t)v;
        data.noteOut.durationMs = durMs;
        data.noteOut.pendingOn  = true;
    }

    // 細分音符の予約 (拍頭から subOffsetQ8/256 拍ぶん遅らせて発火)
    if (ev.subNote != 0) {
        const float bpm = (data.ctrl.bpm >= 1.0f) ? data.ctrl.bpm
                                                  : logic_params::DEFAULT_BPM;
        const float beats = (float)ev.subOffsetQ8 / 256.0f;
        const uint32_t subDelayMs = (uint32_t)(beats * 60000.0f / bpm);
        data.score.pendingSub          = true;
        data.score.pendingSubAtMs      = now + subDelayMs;
        data.score.pendingSubNote      = ev.subNote;
        data.score.pendingSubVelocity  = ev.subVelocity;
        data.score.pendingSubDurationMs = durationQ8ToMs(ev.subDurationQ8, bpm);
    }
}

// 予約された細分音符の時刻が来ていれば NoteOn を出す。
// applyPattern の先頭で呼び、楽譜進行 (4 分 BEAT 受信) と同一ループに重ならないようにする。
// noteOutSub (専用スロット) に書く。noteOut (メイン) とは独立なので、
// 同一ループ反復で fireScoreEvent が noteOut を書いても衝突しない。
void firePendingSub(SystemData& data, uint32_t now) {
    if (!data.score.pendingSub) return;
    if ((int32_t)(now - data.score.pendingSubAtMs) < 0) return;

    uint16_t v = ((uint16_t)data.score.pendingSubVelocity *
                  (uint16_t)data.ctrl.velocity) / 127;
    if (v > 127) v = 127;
    data.noteOutSub.noteNumber = data.score.pendingSubNote;
    data.noteOutSub.velocity   = (uint8_t)v;
    data.noteOutSub.durationMs = data.score.pendingSubDurationMs;
    data.noteOutSub.pendingOn  = true;
    DBG_PRINTF("[SUB] note=%u vel=%u dur=%u delay=%lu now=%lu\n",
               (unsigned)data.score.pendingSubNote,
               (unsigned)v,
               (unsigned)data.score.pendingSubDurationMs,
               (unsigned long)(now - data.score.pendingSubAtMs),
               (unsigned long)now);
    data.score.pendingSub = false;
}

void updatePerformerLed(SystemData& data) {
    using namespace logic_params;
    switch (data.performer.state) {
        case PerformerState::Idle:
            data.led.solidOn = false;
            data.led.blinkIntervalMs = LED_IDLE_MS;
            break;
        case PerformerState::WaitStart:
            data.led.solidOn = false;
            data.led.blinkIntervalMs = LED_WAIT_START_MS;
            break;
        case PerformerState::Playing:
            data.led.solidOn = true;
            break;
    }
}

uint32_t sLastBeatRecvMs = 0;

}  // namespace

void applyPattern(SystemData& data) {
    using namespace logic_params;
    const uint32_t now = millis();

    // 0. 予約された細分音符 (8 分音符等) の発火判定。
    //    前ループまでに fireScoreEvent から積まれた予約が、現時刻に達していれば発音する。
    firePendingSub(data, now);

    // 2. 演奏状態遷移 (Idle -> WaitStart -> Playing)
    // Playing への遷移条件は「最初の BEAT を受信した」だけ (sync.converged 待ちで
    // 鳴らない症状を避ける)。輪唱の「頭の休符」は Playing には入ってから headRestBeats
    // ぶん拍を消費する形で表すので、ここでは入り拍を待たない。
    switch (data.performer.state) {
        case PerformerState::Idle:
            if (data.orcNet.wifiConnected) {
                data.performer.state = PerformerState::WaitStart;
            }
            break;
        case PerformerState::WaitStart:
            if (data.receiver.hasFirstBeat) {
                data.performer.state = PerformerState::Playing;
            }
            // リセット復帰: BEAT 未受信でも CTRL が Conducting (state==2) なら
            // Playing に合流する。次の BEAT が来るまで鳴らないが、到着時に即発音できる。
            else if (data.ctrl.state == 2 && data.ctrl.lastReceivedMs > 0) {
                data.performer.state = PerformerState::Playing;
                sLastBeatRecvMs = now;
            }
            break;
        case PerformerState::Playing:
            // 指揮者からの BEAT が 10 秒以上途絶えたら待機に戻して LED を点滅に切り替える
            if (sLastBeatRecvMs > 0 && (now - sLastBeatRecvMs) > 10000) {
                data.performer.state = PerformerState::WaitStart;
                data.receiver.hasFirstBeat = false;
                sLastBeatRecvMs = 0;
            }
            break;
    }

    // 4. 発音判定: マスタ時刻 playAtMasterMs に揃えて発火する (本来の同期設計)。
    //   targetLocalMs = playAtMasterMs - sync.offsetMs (マスタ時刻 → 自分のローカル ms)
    //   - waitMs <= 0 (既に到来 or 受信遅延): 即発火 (期限切れでも捨てない。捨てると鳴らなくなる)
    //   - waitMs >  0: この周期は何もしない。次ループで再評価し時刻到来したら発火する
    // 各スレーブが同じ playAtMasterMs に対してそれぞれの sync.offsetMs を引いて
    // 待つため、複数スレーブの発音はマスタ時刻基準で自然に揃う。
    // 旧即発火版は受信遅延ぶんスレーブ間でズレていたが、本実装ではそのズレが消える。
    bool     fired       = false;
    uint16_t firedBeatNo = 0;   // 発火した拍の指揮者拍番号 (1 始まり)
    if (data.performer.state == PerformerState::Playing &&
        data.receiver.pending.valid) {
        const int32_t targetLocalMs =
            (int32_t)data.receiver.pending.playAtMasterMs - data.sync.offsetMs;
        const int32_t waitMs = targetLocalMs - (int32_t)now;
        if (waitMs <= 0) {
            fired       = true;
            firedBeatNo = data.receiver.pending.beatNo;
#if MOP_TEST == 4 || MOP_TEST == 5
            // MOP4/MOP5: 発火時記録 (発音予約が実際に発火した瞬間のデバイス側計測)。
            // localMasterMs = 発火時点の推定マスタ時刻。同一 beatNo の localMasterMs の
            // ノード間レンジが MOP4 (楽器間同期誤差)、playAtMasterMs に対する遅刻
            // lateMs = max(0, localMasterMs - playAtMasterMs) が MOP5 (予約遅刻)。
            // USB 受信時刻に依存しない。集計は tools/verification/scripts/ の
            // mop4_sync_error.py / mop5_comm_delay.py。
            {
                const uint32_t localMasterMs = now + (uint32_t)data.sync.offsetMs;
                mop_test::mprintf("M45F,%u,%u,%lu,%lu,%ld,%lu\n",
                                  (unsigned)ORC_RECEIVER_CONFIG.partId,
                                  (unsigned)firedBeatNo,
                                  (unsigned long)data.receiver.pending.playAtMasterMs,
                                  (unsigned long)now,
                                  (long)data.sync.offsetMs,
                                  (unsigned long)localMasterMs);
            }
#endif
            data.receiver.pending.valid = false;
            sLastBeatRecvMs = now;
        }
        // waitMs > 0: 次ループで再評価 (pending は valid のまま残す)
    }

    // 5. 楽譜進行: 指揮者拍番号 firedBeatNo から自分の楽譜インデックスを算出する。
    //   輪唱サイクル方式 (4 声対応): cyclePos = (firedBeatNo - 1) % CANON_CYCLE_BEATS
    //     cyclePos <  headRestBeats             : 自分の入り前 (頭の休符) → 鳴らさない
    //     headRest <= cyclePos < headRest+曲長  : local = cyclePos - headRestBeats で発火
    //     cyclePos >= headRest+曲長             : 自分の 1 周は終了 → サイクル末尾まで休む
    //   サイクル長 56 拍 = 曲長 32 + 最終声部 (node_05, headRest=24) の遅延。全声部が
    //   同じ周期を共有するため、最終声部が 1 周を終えるまで先頭声部は次の周回を
    //   始めない (旧 % kScoreLength 方式は各声部が勝手に周回し輪唱の終端が崩れた)。
    // 拍番号で引くので、Processing をいつ起動しても曲の現在位置から鳴り始める。
    // 拍が一つ飛んでも firedBeatNo に追随するだけでズレが残らない (自己補正)。
    if (fired && kScoreLength > 0) {
        const uint32_t cyclePos =
            (uint32_t)(firedBeatNo - 1) % (uint32_t)CANON_CYCLE_BEATS;
        const int32_t local =
            (int32_t)cyclePos - (int32_t)ORC_RECEIVER_CONFIG.headRestBeats;
        if (local >= 0 && (uint32_t)local < (uint32_t)kScoreLength) {
            fireScoreEvent(data, kScore[local], now);
            data.score.currentEventIndex = (uint16_t)local;   // 診断ログ用
        }
    }

    // (NoteOff 判定はない: 消音は Processing 側が NotePacket.durationMs から自動で行う。)

    // LED
    updatePerformerLed(data);
}
