takushio2525/2026-hackathon-team23/work/umezawa/hck/week1/HCK01_01/HCK01_01.pde

import ddf.minim.*;
import ddf.minim.ugens.*;

Minim minim;
AudioOutput out;
Waveform currentWaveform ; // 音色格納用変数

// 各音の高さ
String [] melody = {
    "A4", "A#4", "B4", "C5", "C#5", "D5", "D#5", "E5", "F5", "F#5", "G5", "G#5", "A5"
};

// 各音の長さ（拍）
float [] duration = {
  0.9f, 0.9f, 0.9f, 0.9f, 0.9f, 0.9f, 0.9f, 0.9f, 0.9f, 0.9f, 0.9f, 0.9f, 0.9f
};

// 各音の開始位置
float [] startTime = {
  0.0f, 1.0f, 2.0f, 3.0, 4.0, 5.0, 6.0, 7.0, 8.0, 9.0, 10, 11, 12
};

// 音色を変更するためにInstrument インタフェースを実装する
class HackInstrument implements Instrument 
{
  Oscil wave ;
  Line ampEnv ;
  float maxAmp ;
  
  
  HackInstrument ( float frequency , float maxAmp , Waveform wf )
  { // Os c ilを使って音信号を作成（周波数, 振幅, 音色）
    wave = new Oscil ( frequency , 0, wf );
    // 引数で渡された最大振幅をクラスの変数に代入
    this . maxAmp = maxAmp ;
    // 振幅変調を与える（初期値は1 から0 への減衰）
    ampEnv = new Line ( );
    // 作成した音信号を振幅変調の出力に送る
    ampEnv . patch ( wave . amplitude );
  }
  
  // コールバック関数：再生開始
  void noteOn ( float duration )
  { // 振幅変調の開始（長さ，開始時の振幅，終了時の振幅）
    ampEnv . activate ( duration , this .maxAmp , 0);
    // 音の再生
    wave . patch ( out );
  }

  // コールバック関数：再生停止
  void noteOff ()
  { // 再生の停止
    wave . unpatch ( out );
  }
}

void setup()
{
  size(512, 200);
  minim = new Minim(this);
  out = minim.getLineOut();
  out.setTempo ( 120 );
  currentWaveform = Waves . SINE ;
}

void playSong () {
  out. pauseNotes ();
  // 繰り返し処理を使って異なる音を追加
  for (int i = 0; i < melody . length ; i++) {
    out. playNote ( startTime [i], duration [i],
      new HackInstrument ( Frequency . ofPitch ( melody [i] ). asHz (),
        0.5f, currentWaveform ));
  }
  // 再生
  out. resumeNotes ();
}

void draw ()
{
  background (0);
  stroke (255);
  
  for (int i = 0; i < out. bufferSize () - 1; i++)
  {
    line ( i, 50 - out. left .get(i)*50 , i+1, 50 - out. left .get(i +1)*50 );
    line ( i, 150 - out. right .get(i)*50 , i+1, 150 - out. right .get(i +1)*50 ); 
  }
}

void keyPressed() {
  switch (key)
  {
   case '1':
      // 正弦波
      currentWaveform = Waves . SINE ;
      break ;
    case '2':
      // 三角波
      currentWaveform = Waves . TRIANGLE ;
      break ;
    case '3':
      // のこぎり波
      currentWaveform = Waves .SAW;
      break ;
    case '4':
      // 矩形波
      currentWaveform = Waves . SQUARE ;
      break ;
    case '5':
      // 倍音の振幅値を指定した自作の音色
      currentWaveform = WavetableGenerator . gen10 (
        4096 , // サンプルサイズ（2 の倍数で）
        new float[] { 1.0f, 0.45f, 0.20f, 0.10f, 0.05f } // 各倍音の振幅値
        );
      break ;
    case 'p':
      // 作成した信号を出力
      playSong ();
      break ;
    default : break ;
  }
}
