takushio2525/2026-hackathon-team23/firmware/production/node_02/include/ProjectConfig.h

// Build / Upload / Monitor (run from project root):
//   pio run -d firmware/production/node_02
//   pio run -d firmware/production/node_02 -t upload
//   pio device monitor -d firmware/production/node_02
//
// 楽器ノード node_02 — 輪唱「かえるのうた」の声部 1 (先頭から入る / 楽器番号 0)
// node_02〜05 で差分はこのファイルだけ (楽譜 score_data.* は 4 台とも同一)。
//   node_02: partId=0x02  headRestBeats=0   instrumentId=0 (トランペット)
//   node_03: partId=0x03  headRestBeats=8   instrumentId=1 (ホルン)
//   node_04: partId=0x04  headRestBeats=16  instrumentId=2 (トロンボーン)
//   node_05: partId=0x05  headRestBeats=24  instrumentId=3 (チューバ)
#pragma once
#include <Arduino.h>
#include <IPAddress.h>

#include "OrcNetModule.h"
#include "OrcReceiverModule.h"
#include "NoteSenderModule.h"
#include "StatusLedModule.h"
#include "UiRelayModule.h"

inline const OrcNetConfig ORC_NET_CONFIG = {
    /*mode=*/                WifiMode::Sta,
    /*ssid=*/                "OrchestraAP",
    /*pass=*/                "orchestra2026",
    /*multicastIp=*/         IPAddress(239, 0, 0, 1),
    /*udpPort=*/             5001,
    /*channel=*/             6,
    /*reconnectIntervalMs=*/ 2000,
    /*beatGapMs=*/           0,    // Sta 側は送信しないので未使用 (送信側 node_01 のみ意味を持つ)
};

inline const OrcReceiverConfig ORC_RECEIVER_CONFIG = {
    /*partId=*/                0x02,    // 輪唱 声部 1
    /*headRestBeats=*/         0,       // 先頭から入る (頭の休符なし)
    /*clockSyncWindowMs=*/     2000,    // min フィルタ窓長: バースト配送 (204.8ms 周期) ~10 回ぶん。
                                        // 旧 EMA は推定時計が真値より 40〜55ms 遅れていた
                                        // (MOP5_systematic_shift_analysis_20260710.md §4/§8 案4)
    /*clockSyncMinSamples=*/   5,
    /*clockSyncSnapThresholdMs=*/ 1000,  // 指揮者リセット (マスタ時計巻き戻り) を 1 パケットで追従。正常遅延 (数十 ms) では届かない
    /*loopIntervalMs=*/        2,       // 旧 5 ms → 2 ms (発音判定ジッタ最大 5 ms → 2 ms)
};

inline const NoteSenderConfig NOTE_SENDER_CONFIG = {
    /*baudRate=*/     115200,
    /*partId=*/       0x02,
    /*instrumentId=*/ 0,             // PC 側で読み込んだ楽器定義 (data/*.json) の何番目を使うか
};

// production ゲームモード: 指揮者の UI 状態 (mode/画面/カーソル/score) を PC へ中継する設定。
// node_02 = メイン操作 UI が付く PC。「変化時のみ + minIntervalMs 上限 + heartbeat 保険」で送る。
// Menu/Result では操作時のみ、Conducting 中は bpmQ8 変化時のみで、いずれも低頻度
// (+1s heartbeat)。node_03/04 はアナライザのため載せない。
inline const UiRelayConfig UI_RELAY_CONFIG = {
    /*partId=*/        0x02,
    /*minIntervalMs=*/ 33,     // 変化送出の最小間隔 (BPM 表示の追従を滑らかにする上限 30Hz)
    /*heartbeatMs=*/   1000,   // 無変化でも 1s ごとに 1 発 (PC 途中接続でも状態を拾える)
};

inline const StatusLedConfig STATUS_LED_CONFIG = {
    /*pin=*/             LED_BUILTIN,
    /*blinkIntervalMs=*/ 500,
    /*activeLow=*/       false,    // UNO R4 WiFi の LED_BUILTIN は HIGH で点灯
};

namespace logic_params {
    constexpr uint16_t LED_IDLE_MS       = 1000;
    constexpr uint16_t LED_WAIT_START_MS = 500;
    constexpr float    DEFAULT_BPM = 100.0f;   // CTRL 未受信時の発音長計算に使う既定テンポ
    // 輪唱サイクル長 [拍] = 曲長 32 拍 + 最終声部 (node_05) の入り遅れ 24 拍。
    // 全声部がこの周期を共有することで「最終声部が 1 周を終えるまで先頭声部が
    // 次の周回を始めない」という輪唱の終端が成立する。score_data.cpp の曲長や
    // 各ノードの headRestBeats (0/8/16/24) を変えるときは、必ず 4 ノードすべてで
    // この値を揃えて再計算すること (ずれると声部間の周回がぶつかる)。
    constexpr uint16_t CANON_CYCLE_BEATS = 56;
}
