takushio2525/2026-hackathon-team23/firmware/production/node_06/src/score_data.cpp

// Build / Upload / Monitor (run from project root):
//   pio run -d firmware/production/node_06
//   pio run -d firmware/production/node_06 -t upload
//   pio device monitor -d firmware/production/node_06
//
// ドラム楽譜 — 56 拍分 (輪唱サイクル全体を担当)。
// 齋藤版 week10 (kaeru_score_week10_adjusted) の createDrumScore() を静的配列に展開。
//
// GM ドラムマップ: 36=キック, 38=スネア, 42=ハイハット, 49=クラッシュ
// 4/4 拍子パターン: 1・3 拍目キック / 2・4 拍目スネア。
// 各声部の入り (0/8/16/24 拍) と最終拍 (55) はクラッシュ + キック同時打ち。
// velocity: 強拍キック=86 / 弱拍キック=78 / スネア=74 / クラッシュ=84(入り),92(最終)
//
// {beatAt(参考値), noteNumber, velocity, durationQ8(256=1拍),
//  flags(bit0=NoteOn / bit2=休符), subNote, subVelocity, subOffsetQ8, subDurationQ8}
#include "score_data.h"

const ScoreEvent kScore[] = {
    // ── 小節 1 (拍 0-3) ──
    // 拍  0: 声部1入り → クラッシュ + キック
    {  1, 49, 84, 256, 0x01, 36, 82, 0, 256 },
    // 拍  1: スネア
    {  2, 38, 74, 256, 0x01, 0, 0, 0, 0 },
    // 拍  2: キック (弱拍)
    {  3, 36, 78, 256, 0x01, 0, 0, 0, 0 },
    // 拍  3: スネア
    {  4, 38, 74, 256, 0x01, 0, 0, 0, 0 },
    // ── 小節 2 (拍 4-7) ──
    // 拍  4: キック (強拍)
    {  5, 36, 86, 256, 0x01, 0, 0, 0, 0 },
    // 拍  5: スネア
    {  6, 38, 74, 256, 0x01, 0, 0, 0, 0 },
    // 拍  6: キック (弱拍)
    {  7, 36, 78, 256, 0x01, 0, 0, 0, 0 },
    // 拍  7: スネア
    {  8, 38, 74, 256, 0x01, 0, 0, 0, 0 },
    // ── 小節 3 (拍 8-11) ──
    // 拍  8: 声部2入り → クラッシュ + キック
    {  9, 49, 84, 256, 0x01, 36, 82, 0, 256 },
    // 拍  9: スネア
    { 10, 38, 74, 256, 0x01, 0, 0, 0, 0 },
    // 拍 10: キック (弱拍)
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
    // 拍 53: スネア
    { 54, 38, 74, 256, 0x01, 0, 0, 0, 0 },
    // 拍 54: キック (弱拍)
    { 55, 36, 78, 256, 0x01, 0, 0, 0, 0 },
    // 拍 55: 最終拍 → クラッシュ + キック
    { 56, 49, 92, 256, 0x01, 36, 86, 0, 256 },
};

const size_t kScoreLength = sizeof(kScore) / sizeof(kScore[0]);
