takushio2525/2026-hackathon-team23/firmware/production/node_02/src/score_data.cpp

// Build / Upload / Monitor (run from project root):
//   pio run -d firmware/production/node_02
//   pio run -d firmware/production/node_02 -t upload
//   pio device monitor -d firmware/production/node_02
//
// 輪唱用の楽譜 — 「かえるのうた」(C major, 32 拍 = 4 フレーズ)。
// 全声部 (node_02〜05) で同一。
//
//   フレーズ 1 (拍 1-8):  ド レ ミ ファ ミ レ ドー     (かえるの うたが)
//   フレーズ 2 (拍 9-16): ミ ファ ソ ラ ソ ファ ミー   (きこえて くるよ)
//   フレーズ 3 (拍 17-24): ド 休 ド 休 ド 休 ド 休     (グワッ グワッ グワッ グワッ)
//   フレーズ 4 (拍 25-32): ドドレレミミファファ ミ レ ドー (ゲロゲロゲロゲロ グワッグワッグワッ)
//
// 1 周 = 32 拍。kScoreLength = 32。周回は applyPattern が輪唱サイクル
// (CANON_CYCLE_BEATS = 56 拍 = 曲長 32 + 最終声部の遅延 24) の窓方式で管理し、
// 最終声部 (node_05) が 1 周を終えるまで先頭声部は次の周回を始めない。
//
// 1 拍 = 1 ScoreEvent。指揮者の BEAT を 1 個受けるたびにインデックスを 1 個進める。
// 4 分音符は durationQ8=240 (≒0.94 拍ぶん鳴らして残りは隙間)。
// 2 分音符は durationQ8=480 (≒1.9 拍) を 1 行に書き、続く 1 拍は休符 (flags bit2)。
// 8 分音符は subNote で拍の後半に発火 (subOffsetQ8=128 = 0.5拍後、subDurationQ8=128)。
//
// 輪唱は ProjectConfig.h の headRestBeats で声部ごとに頭をずらす (node_02=0,
// node_03=8, node_04=16, node_05=24 拍)。1 周 32 拍に対して 8 拍 (1 フレーズ) ずつ
// ずれて 4 声が入り、4 フレーズの重なりで立体的な輪唱になる。
//
// {beatAt(参考値), noteNumber(0=休符), velocity, durationQ8(256=1拍),
//  flags(bit0=NoteOn / bit2=休符), subNote, subVelocity, subOffsetQ8, subDurationQ8}
#include "score_data.h"

// MIDI: C4=60 D4=62 E4=64 F4=65 G4=67 A4=69
// ベロシティは齋藤版 (week9) に合わせフレーズごとに変化させている:
//   フレーズ1=96, フレーズ2=92, フレーズ3=90, フレーズ4=96 (終止音のみ100)
const ScoreEvent kScore[] = {
    // フレーズ 1 (拍 1-8): ド レ ミ ファ ミ レ ドー  (「かーえーるーのー うーたーがー」)
    {  1, 60, 96, 240, 0x01, 0, 0, 0, 0 },  // ド  C4
    {  2, 62, 96, 240, 0x01, 0, 0, 0, 0 },  // レ  D4
    {  3, 64, 96, 240, 0x01, 0, 0, 0, 0 },  // ミ  E4
    {  4, 65, 96, 240, 0x01, 0, 0, 0, 0 },  // ファ F4
    {  5, 64, 96, 240, 0x01, 0, 0, 0, 0 },  // ミ  E4
    {  6, 62, 96, 240, 0x01, 0, 0, 0, 0 },  // レ  D4
    {  7, 60, 96, 480, 0x01, 0, 0, 0, 0 },  // ドー C4 (2 拍)
    {  8,  0,   0,   0, 0x04, 0, 0, 0, 0 },  //      (タイの続き)
    // フレーズ 2 (拍 9-16): ミ ファ ソ ラ ソ ファ ミー (「きーこーえーてー くーるーよー」)
    {  9, 64, 92, 240, 0x01, 0, 0, 0, 0 },  // ミ  E4
    { 10, 65, 92, 240, 0x01, 0, 0, 0, 0 },  // ファ F4
    { 11, 67, 92, 240, 0x01, 0, 0, 0, 0 },  // ソ  G4
    { 12, 69, 92, 240, 0x01, 0, 0, 0, 0 },  // ラ  A4
    { 13, 67, 92, 240, 0x01, 0, 0, 0, 0 },  // ソ  G4
    { 14, 65, 92, 240, 0x01, 0, 0, 0, 0 },  // ファ F4
    { 15, 64, 96, 480, 0x01, 0, 0, 0, 0 },  // ミー E4 (2 拍)
    { 16,  0,   0,   0, 0x04, 0, 0, 0, 0 },  //      (タイの続き)
    // フレーズ 3 (拍 17-24): ド 休 ド 休 ド 休 ド 休  (「グワッ グワッ グワッ グワッ」)
    // 4 分音符 + 4 分休符の繰り返し。短めの durationQ8=128 でスタッカート感を出す。
    { 17, 60, 90, 128, 0x01, 0, 0, 0, 0 },  // グワッ C4 (短い 4 分)
    { 18,  0,   0,   0, 0x04, 0, 0, 0, 0 },  //       (休符)
    { 19, 60, 90, 128, 0x01, 0, 0, 0, 0 },  // グワッ C4
    { 20,  0,   0,   0, 0x04, 0, 0, 0, 0 },  //       (休符)
    { 21, 60, 90, 128, 0x01, 0, 0, 0, 0 },  // グワッ C4
    { 22,  0,   0,   0, 0x04, 0, 0, 0, 0 },  //       (休符)
    { 23, 60, 90, 128, 0x01, 0, 0, 0, 0 },  // グワッ C4
    { 24,  0,   0,   0, 0x04, 0, 0, 0, 0 },  //       (休符)
    // フレーズ 4 (拍 25-32): ドドレレミミファファ ミ レ ドー
    // (「ゲロゲロゲロゲロ グワッグワッグワッ」)
    // 8 分音符ペア (上行): C4C4 D4D4 E4E4 F4F4 → 下行: E4 D4 C4ー
    { 25, 60, 96, 128, 0x01, 60, 96, 128, 128 },  // ドド C4×2 (8分)
    { 26, 62, 96, 128, 0x01, 62, 96, 128, 128 },  // レレ D4×2 (8分)
    { 27, 64, 96, 128, 0x01, 64, 96, 128, 128 },  // ミミ E4×2 (8分)
    { 28, 65, 96, 128, 0x01, 65, 96, 128, 128 },  // ファファ F4×2 (8分)
    { 29, 64, 96, 240, 0x01,  0,   0,   0,   0 },  // ミ  E4 (4分)
    { 30, 62, 96, 240, 0x01,  0,   0,   0,   0 },  // レ  D4 (4分)
    { 31, 60, 100, 480, 0x01,  0,   0,   0,   0 },  // ドー C4 (2 拍、終止音)
    { 32,  0,   0,   0, 0x04,  0,   0,   0,   0 },  //      (タイの続き)
};

const size_t kScoreLength = sizeof(kScore) / sizeof(kScore[0]);
