takushio2525/2026-hackathon-team23/firmware/production/node_01/include/SystemData.h

// Build / Upload / Monitor (run from project root):
//   pio run -d firmware/production/node_01
//   pio run -d firmware/production/node_01 -t upload
//   pio device monitor -d firmware/production/node_01
//
// 指揮者ノードの全モジュール共有データを集約
// EMA 規約: モジュール間は SystemData のフィールド経由でのみ通信する
#pragma once
#include <Arduino.h>

#include "OrcNetModule.h"      // OrcNetData
#include "StatusLedModule.h"   // StatusLedData
#include "ImuModule.h"         // ImuData
#include "OrcSenderModule.h"   // OrcSenderData

enum class ConductorState : uint8_t {
    Idle        = 0,
    Calibrating = 1,
    Conducting  = 2,
    Fallback    = 3,
    Menu        = 4,   // production: IMU ナビでモード選択中 (拍検出は止める)
    Result      = 5,   // production: ゲーム結果表示中 (得点を凍結・縦振りで Menu へ)
};

struct BeatLogicData {
    bool     event = false;        // 今周期で拍を検出したか (送信側がクリア)
    uint16_t beatNo = 0;
    uint32_t lastBeatMs = 0;
    uint32_t playAtMasterMs = 0;
    // 前回拍からの経路長 (= |v| の時間積分, m 単位)。拍検出の AND ゲート用。
    // 拍確定 / 状態遷移などでゼロリセットされる。
    float    pathLenM = 0.0f;
    // デバッグ可視化用: 拍検出ゲートの状態と Armed 中の dynNorm 最大値。
    uint8_t  gateState = 0;        // 0 = Idle, 1 = Armed
    float    armedPeakDyn = 0.0f;
};

struct TempoLogicData {
    // 初期テンポは 100 BPM。最初の 1 拍 (= 1 音目) はまだ拍間隔が取れないので
    // この値で CTRL を送る。2 拍目で「1 拍目→2 拍目」の間隔からそのまま簡易テンポ
    // を確定し、以降は拍ごとに EMA で随時補正していく (applyPattern.cpp 参照)。
    float    bpm = 100.0f;
    uint32_t nextBeatPredictedMs = 0;
    uint8_t  velocity = 64;        // ストレッチ未実装時は固定 64
};

struct CalibrationData {
    bool     done = false;
    uint32_t startMs = 0;
    uint32_t sampleCount = 0;
    // 停止時の加速度ノルムの累積。軸ごとの重力ベクトルではなくスカラー 1 個だけ持つ。
    // 平均すると姿勢に依らない「静止ノルム ≒ 重力 1g」になる。
    float    accumNorm = 0.0f;
    float    gravityMag = 0.0f;   // 確定値 = accumNorm / sampleCount (≒ 1g)
};

struct ConductorStateData {
    ConductorState state = ConductorState::Idle;
};

// production ゲームモードの司令塔状態。CTRL 予約バイト (mode/navCursor/targetBpm/score) の源。
// 詳細設計は .agent/production-game-design.md。
struct GameData {
    uint8_t  mode = 0;            // 0=自由演奏 / 1=ゲーム
    uint8_t  navCursor = 0;       // メニューカーソル位置 0..MENU_ITEM_COUNT-1
    uint8_t  targetBpm = 0;       // ゲーム目標テンポ (生 BPM, 0=未設定/自由演奏)
    uint8_t  score = 0xFF;        // 得点 0-100 (0xFF=採点中/未確定)
    uint16_t gameBeatCount = 0;   // ゲーム開始からの経過拍数 (採点・ガイドフェード・終了判定に使う)
    // 採点累積: ガイド強度で重み付けした拍間隔誤差の総和とその重み総和。
    // ゲーム終了時に avgErr = errAccum / weightAccum を 0-100 へ写像する。
    float    scoreErrAccum = 0.0f;
    float    scoreWeightAccum = 0.0f;
};

struct SystemData {
    ImuData             imu;
    OrcNetData          orcNet;
    OrcSenderData       sender;
    StatusLedData       led;
    BeatLogicData       beat;
    TempoLogicData      tempo;
    CalibrationData     calibration;
    ConductorStateData  conductor;
    GameData            game;       // production: ゲームモード状態
};
