takushio2525/2026-hackathon-team23/(commit log)

2026-04-16 [機能追加] 参考資料フォルダ references/ を新設（授業資料の共有用）
    Arduino オーケストラプロジェクトで使用する外部資料（授業資料・データ
    シート等）を集約するため references/ を新設。その配下に授業資料専用の
    lectures/ サブフォルダを配置し、命名規則と著作権上の注意を README に
    明記した。ルート README のディレクトリ構成表にも追記。
2026-04-17 [機能追加] 授業資料（ハッカソン1 ガイダンス・キックオフ・全体PDF）を配置
    references/lectures/ に第1回授業で配布された3点のPDFを追加。チーム内
    共有用。リポジトリは Private のため著作物コミットの問題なし。
2026-04-17 [機能追加] 第1回議事録PDFを追加し、markdownテンプレを廃止
    チームの議事録担当が作成した第1回議事録PDFを meetings/ に追加。
    本チームは PDF を正規議事録とする運用に統一するため、テンプレ的に
    配置されていた markdown 議事録（2026-04-15_kickoff.md）を削除し、
    meetings/README.md の運用説明も PDF ベースに書き換えた。
2026-04-17 [機能追加] Arduinoオーケストラ プロジェクト仕様の先読みドラフトを作成
    第1回ミーティング後の決定事項とユーザー追加方針（指揮マイコンへの
    IMU搭載）を踏まえ、第3週の設計書原案提出に備えて以下を先行整備した。
    - ルートREADMEに本チーム情報セクションを追記（テンプレ説明は維持）
    - docs/overview.md：テーマ・目標・評価軸・スケジュール
    - docs/roles.md：役割分担（確定／未決）
    - docs/design/architecture.md：指揮1+楽器4+PCの全体構成
    - docs/design/protocol.md：UDP独自プロトコル（CTRL/BEAT/NOTE）の実仕様化
    - docs/design/conductor_ge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
2026-04-17 [ドキュメント] 設計ドキュメントを方針レベルに抑え、細部は実装フェーズに後回し
    第1回時点で未合意の具体仕様（パケット構造・IP/ポート・信号処理アルゴリズム・
    C構造体・tick 解像度など）を各ドキュメントから削除し、いまの議論段階に
    ふさわしい「方針と未決事項」ベースに書き直した。data_flow.md は
    architecture.md に吸収させて削除。
2026-04-17 [機能追加] VSCode に Processing スケッチ実行タスクを追加
    processing-java を呼び出して現在のスケッチフォルダを実行するビルドタスク。
    .pde を開いた状態で Run タスクを起動すると、そのスケッチがそのまま走る。
2026-04-17 [スタイル] example_sketch のウィンドウ幅を 1000 に拡大
    動作確認用に横長の表示領域が欲しかったため。高さは 360 のまま。
2026-04-17 [ドキュメント] CLAUDE.md に AI 補助作業の Git ワークフロー規定を追加
    変更ごとのブランチ運用、プル→コミット→プッシュの標準フロー、
    AI が編集していない手動変更の扱い方（確認→別コミット→プッシュ）を明文化。
2026-04-17 [改善] VSCode推奨拡張にProcessing関連を追加しtasks.jsonを削除
    Luke-zhang-04.processing-vscode のワンクリック実行に置き換えるため、
    自前の processing-java タスク定義を撤去。
    構文ハイライト用に tobiah.language-pde も併せて追加。
2026-04-17 [ドキュメント] 軽微な変更はmain直コミットを許容するようGitルールを緩和
    大規模/衝突可能性あり/要レビュー の変更だけをブランチ必須とし、
    それ以外はmain直コミットを明示的にOKにした。
2026-04-20 [改善] チームメンバーの役割に楽器コードの記載を削除
2026-04-21 [ドキュメント] ファームウェアのコーディング方針として Embedded-Module-Architecture 準拠を明文化
    複数メンバーでの分担開発に備え、Arduino 側コードは塩澤の既存リファレンス
    実装（Embedded-Module-Architecture）に従う方針を決定。ADR-0005 を新規追加
    し、firmware/README.md と docs/design/architecture.md にも同方針を記載。
2026-04-21 [リファクタ] 報告書テンプレートを template ディレクトリに整理
2026-04-21 [ドキュメント] 塩澤個人用の報告書テンプレートを複製
    report/template/ の内容を report/shiozawa/template/ に複製し、
    個人用の週次課題・事前課題のコピー元として配置する。
2026-04-21 [ドキュメント] ハッカソン1 事前課題(4/21) の初稿を作成
    塩澤担当分(指揮者マイコンのIMUジェスチャ認識)の事前課題として、
    社会的背景・技術的背景・既存システム・自身のアイディアの検討を記述。
    参考文献は refs.bib に整理し、コンパイル済み PDF を同梱。
2026-04-21 [ドキュメント] 事前課題の章構成を簡潔化し背景はチーム協議後へ先送り
    参考PDFに準拠した4章構成(はじめに/提案手法/実現可能性評価/おわりに)へ
    刷新。社会的背景・問題点・目的の本文はチーム協議(2026-04-22)後に記述する
    ためプレースホルダー化した。
2026-04-21 [ドキュメント] 事前課題の社会的背景・問題点・目的の初稿を執筆
    合奏体験のハードルと，単純な自動同期では人間が能動的に関与する
    楽しさが失われる点を社会的背景として整理。技術的側面（CAN の回路
    要求・1 対 1 通信の制約）は問題点に統合した。次回チーム協議で調整
    する余地を残すため，おわりにの前置きも更新。
2026-04-21 [スタイル] 事前課題の句読点を「，．」に統一
    「，」と「。」が混在していたため，全角欧文スタイルの「，．」に
    揃える．
2026-04-21 [ドキュメント] 事前課題を IMU/WiFi 技術選定中心の章立てに全面改訂
    Arduino オーケストラ文脈に沿って社会的背景を書き直し，
    技術的背景と既存システムの章を新設．WiFi/UDP ブロードキャスト
    採用理由を問題点の主題に据え，提案手法に IMU ジェスチャ取得と
    WiFi/UDP 配信のサブセクションを追加．実現可能性評価章と
    おわりに章は削除．参考文献リストを main.tex に組み込み．
2026-04-21 [ドキュメント] 事前課題の Markdown 太字を除去し参考文献を日本語・データシートに限定
    本文に残っていた ** 太字記法（LaTeX では機能しない）をすべて除去．
    発表時の突っ込まれリスクを下げるため，参考文献は UNO R4 WiFi 製品
    ページ・LSM6DSOX データシート・Wii Music 公式・Embedded-Module-
    Architecture の 4 件に絞り，英語論文や個人ブログへの引用は本文から外した．
2026-04-21 [ドキュメント] 事前課題の提出日を 2025 年表記に固定し任天堂文献の URL を差し替え
    \today による和暦表記をやめ，表紙の提出日を「2025 年 4 月 21 日」
    固定に変更．任天堂 Wii Music 公式の参考文献は旧 URL（rmjj）が
    リンク切れだったため，現行の r64j パスへ差し替え．閲覧日も
    2025-04-21 に統一．
2026-04-21 [修正] 事前課題の提出日・閲覧日を 2026 年に訂正
    前コミットで誤って 2025 年表記にしていた提出日と閲覧日を
    正しい 2026-04-21 に修正．意図は和暦 (\today) を西暦固定に
    することだけだったが，年を書き誤っていた．
2026-04-21 [ドキュメント] 事前課題から自リポジトリへの参考文献を削除し本文表現を一般化
    参考文献に自身の GitHub リポジトリを載せるのを避けるため，
    Embedded-Module-Architecture の \cite と bib エントリを削除．
    処理方針の記述は「入力・ロジック・出力のモジュール境界を
    明確にする設計方針」と一般化した表現に書き換え．
2026-04-21 [リファクタ] 事前課題の未使用パッケージ・未参照 bib エントリを削除
    TeX ソース提出に向け，main.tex のプリアンブルを実際に使う 6 パッケージ
    （graphicx, xcolor, amsmath, otf, ascmac, url）に絞り，refs.bib も本文
    で引用する 3 エントリのみに整理．
2026-04-21 [ドキュメント] イントロダクションセクションから事前課題の説明文を削除
2026-04-22 [ドキュメント] 事前課題の最終版 PDF と提出用 ZIP を追加
    main.pdf を最新コンパイル結果に更新し，提出用にまとめた PDF と ZIP を同梱．
2026-04-22 [ドキュメント] メモファイルを新規作成
2026-04-22 [ドキュメント] テスト
2026-04-22 [ドキュメント] メモファイルの「目的」と「ゴール」セクションのタイトルを追加
2026-04-22 [ドキュメント] 音楽再生機能を追加し、メインスケッチを設定
2026-04-22 [ドキュメント] 音声分析用の新しいノートブックを追加
2026-04-22 [ドキュメント] 音声分析用のノートブックを作成し、グラフ描画機能を追加
2026-04-22 [ドキュメント] 成果物の範囲を明確化し、指揮者のエッジ検出と音の解析について追記
2026-04-22 第二回議事録追加
2026-04-23 [追加] LED制御とシリアル通信機能を持つ新しいスケッチを追加
2026-04-23 [追加] 塩澤個人の授業課題フォルダの追加
2026-04-23 [ドキュメント] Git 基本操作解説と merge 運用ルールを CONTRIBUTING に追加
    push/pull/merge の概念と使い分けを §2 に新設し、main の取り込みは
    merge を使う（rebase は使わない）チーム方針を明文化。章番号の繰り下げと
    内部リンクも整合修正。
2026-04-23 [改善] VSCode プロジェクト設定に Git 自動 fetch と衝突防止系オプションを追加
    チーム全員で autofetch / pullBeforeCheckout / smart commit 無効化を揃え、
    ローカル/リモート乖離や誤ステージングによる事故を減らす。
2026-04-23 [ドキュメント] 第1回/第2回議事録のフォルダ整理と AI 要約 Markdown を追加
    - meetings/0415_1回/ を新設し第1回議事録 PDF を移動（第2回の 0422_2回/ と構成を揃える）
    - 各フォルダに Claude が生成した要約 Markdown（第N回議事録_AI要約byClaude.md）を追加
    - 目的・ゴール・決定事項・WBS を再構成し，ファイル名で AI 生成物であることが分かるようにした
    - meetings/README.md をフォルダ構成の変更に合わせて更新
    https://claude.ai/code/session_01Svq5h3aSJFgZHPjtm5yXK6
2026-04-23 [ドキュメント] ADR を第2回ミーティング結果に合わせて更新・新規追加
    - ADR-0002/0003/0004: 議事録の格納先変更（meetings/0415_1回/ 配下）に追従し，
    第2回で再確認・具体化された点を「補足」として追記
    - ADR-0005: 決定の場（会議ベースではなく第1回〜第2回の間にリポジトリ上で確定）を明記
    - ADR-0006（新規）: MOE「同期誤差 20ms 以内」「音階の正確性」を第2回ミーティングで採用
    - ADR-0007（新規）: 目的・ゴール・成果物範囲・エンタメ主軸を第2回ミーティングで確定
    各 ADR に「決定日」と「どの回のミーティングで決定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
2026-04-23 [リファクタ] 塩澤個人の作業ディレクトリを firmware/ から work/ へ移動
    個人ワークはファームウェアビルド対象外なので、
    専用の work/ ディレクトリに分離する。
2026-04-23 [追加] 講義資料 PDF を追加（HCK1_02 演習、生成AI利用申告書テンプレート）
2026-04-23 [機能追加] 生成AI利用申告書テンプレート (LaTeX) を追加
    ハッカソン1 提出課題で求められる生成AI利用申告書を、塩澤個人作業用に
    LaTeX 軽量テンプレートとして新設。work/shiozawa/ai_declaration/template/
    を原本とし、課題ごとにコピーして埋める運用。
    - グローバル規約のカラーパレット（headerblue/accentblue 等）と
    tcolorbox スタイル、改ページ制御、plistings を踏襲
    - 基本情報 + 6項目（チェックボックス付き）+ 参考文献 の構成
    - Docker latexmk でエラーゼロ・PDF 生成を確認済み
    - .gitignore に ai_declaration 配下の main.pdf 除外を追記
    Co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
2026-04-23 [機能追加] 課題1用 生成AI利用申告書を作成（一部プレースホルダ）
    提出課題1 (HCK02_01.ino) 向けに、template からコピーして本文を埋めた
    申告書を追加。実機テストが必要な2項目（正しいと確認した方法／問題や
    間違い）は TODO マーカーを残し、実機テスト後に塩澤さんが埋める運用。
    - 例題2 (work3.ino) の診断内容・採用した修正方針・自分で判断した箇所
    を章立てで記述
    - 実際にAIへ送ったプロンプトを原文で引用
    - TODOマクロを警告色で表示し、未記入箇所が一目でわかるように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
2026-04-23 [修正] 課題1 HCK02_01.ino: ボーレート115200・ラベル英字化・コメント強化
    シリアルプロッタで波形が安定して見えるようにする調整。
    - BAUD を 921600 → 115200（Arduino IDE プロッタの取りこぼし対策）
    - シリアル出力ラベルを日本語から英字 (signal/ref_hi/ref_lo) へ
    （環境依存の文字化け回避）
    - 参照電圧を #define VREF に抜き出し、UNO (5.0V) / XIAO (3.3V) で
    1行書き換えるだけで切替できる形に
    - 冒頭コメントに「例題2 からの主な変更点」サマリを追加、
    各処理の WHY をコメントに強化
    ※実機テスト（Arduino + マイク回路）は未実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
    [HCK02_01.ino]
2026-04-23 [修正] 課題1: 未検証の .ino 変更を巻き戻し、申告書を現状コードに同期
    先のコミット fa6ddce で .ino に入れた修正（BAUD 115200・ラベル英字化・
    VREF 定数化・冒頭サマリコメント）は実機で確認していない状態だったため、
    塩澤さんの手元版に戻す。申告書側も「採用した」「保留中」の区別を
    現状コードと一致させる。
    - HCK02_01.ino: BAUD=921600、日本語ラベル、参照電圧3.3V ハードコードの
    塩澤版に復元
    - ai_declaration/HCK02_01/main.tex:
    - 3項「採用した」: 実測値出力撤去 / EWMA 動的DC除去 / 2kHz 固定の3点のみ
    - 3項「保留中」: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
    [HCK02_01.ino]
2026-04-23 [修正] 課題1: 未検証の .ino 変更を巻き戻し、申告書を現状コードに同期
    先のコミット aea8f16 で .ino に入れた修正（BAUD 115200・ラベル英字化・
    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
    [HCK02_01.ino]
2026-04-23 [スタイル] 生成AI利用申告書を講義PDFテンプレートと一致するシンプルな体裁に変更
    tcolorbox・色付き見出し・ヘッダー／フッター等の装飾を撤去し、
    jsarticle 素の番号付きセクションと箇条書きだけで構成するようにした。
    template/ と HCK02_01/ 双方に適用、内容（塩澤さんの記述）は維持。
2026-04-23 [修正] HCK02_01.ino を work3.ino 初期状態に巻き戻し
    フィルタ検討のため、未検証の EWMA 実装をすべて取り除き、
    work3.ino と同一の RAW 表示コードに戻す。
    [HCK02_01.ino]
2026-04-23 [改善] 課題1: 等間隔サンプリング＋整数3系列出力で表示密度を確保
    Processing 生成の sin 波が「とんがって」見える原因は、Serial
    出力のラベル込みで 1 ループ約 45 バイト → 実効 2.3 kHz と
    遅く、440 Hz 入力で周期あたり 5 点しか取れていなかったこと。
    対処として以下を実施：
    - ラベルを削除し、整数 3 系列（生値、上限 1023、下限 0）のみ出力
    → 約 13 バイト → 理論 7.7 kHz
    - micros() ベースの等間隔サンプリング（周期 150 µs）を導入
    → 440 Hz で約 15 点/周期、261 Hz で約 25 点/周期を確保
    - プロッタ Y 軸を 0〜1023 に固定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
2026-04-24 [リファクタ] work/shiozawa 配下を日付ベースに再編＆README/.gitignore を同期
    - work/shiozawa/01/ → work-0415/ にリネーム
    - ai_declaration/template/ → ai_declaration_template/ に1階層上げ（原本テンプレート）
    - ai_declaration/HCK02_01/ → work-0422/ai_declation/HCK02_01/ へ移動
    - 新規: work-0422/HCK02_01.zip（提出用ZIP）
    - ai_declaration_template/README.md を新構成に合わせて全面改訂
    - .gitignore を新パス（ai_declaration_template/ と work/shiozawa/**/ai_declation(ai_declaration)/）に対応
2026-04-24 [修正] フォルダ名の typo を修正: ai_declation → ai_declaration
    - work/shiozawa/work-0422/ai_declation/ を ai_declaration/ にリネーム
    - README.md の参照パスを ai_declaration/ に修正
    - .gitignore から typo 綴り（ai_declation）の除外行を削除
2026-04-24 [ドキュメント] 課題1 生成AI利用申告書を現コード(等間隔・整数3系列)に全面書き直し
    HCK02_01.ino が d290fd4 で「等間隔サンプリング＋整数3系列出力」に変わったため、
    EWMA/DCオフセット除去前提だった旧内容を実装に合わせて全面刷新。プロンプト・採用理由・
    工夫点・検証予定を現コード(micros busy-wait / SAMPLE_US=150 / ガイド線 0,1023)に揃えた。
2026-04-24 [ドキュメント] 課題1 生成AI利用申告書を現コード(等間隔・整数3系列)に全面書き直し
    HCK02_01.ino が ca57036 で「等間隔サンプリング＋整数3系列出力」に変わったため、
    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
2026-04-24 [機能追加] 課題2: Arduinoマイク入力+Processing 楽曲再生と波形描画
    - HCK02_02.ino: HCK02_01 のサンプリング設定 (921600bps, 150us,
    10bit ADC) を踏襲し、Processing が受信しやすい単一整数+改行
    フォーマットに変更
    - HCK02_02.pde: HCK01_03 の楽曲再生 (melody / waveform / keyPressed)
    を流用しつつ、シリアル経由のマイク ADC 値を循環バッファで
    スクロール描画。上段に楽曲 L/R、下段にマイク波形
    - ai_declaration/HCK02_02/main.tex: 課題2 用の生成AI利用申告書
    - HCK02_02.zip: 提出用アーカイブ (HCK02_02.ino/.pde/.pdf)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
2026-04-24 [ドキュメント] CLAUDE.md に tex 自動コンパイル＋生成PDFコミットの運用ルールを追記
    全 .tex プロジェクト共通の運用として、Docker latexmk でのエラーゼロ確認と、
    生成された PDF を .tex と同一コミットに含めることを明文化。提出物 PDF が
    リポジトリに無いとレビュー相手が確認できないため。
2026-04-24 [ドキュメント] 生成 PDF をリポジトリ追跡対象に変更＋既存PDFを追加
    CLAUDE.md 新ルール（tex 編集時は PDF も同コミットに含める）を実効化するため、
    .gitignore から PDF 除外ルール 3 本（report/, ai_declaration_template/, ai_declaration/**/
    main.pdf）を削除。あわせて、ルール適用対象の既存 PDF 2 本（申告書テンプレ、課題1申告書）
    をリポジトリに登録。HCK02_02 の PDF は別作業なので本コミットには含めない。
2026-04-24 [ドキュメント] HCK02_02 プロジェクト用の main.pdf を追加
2026-04-24 [機能追加] 発展課題: ProcessingマイクFFTスペクトルアナライザと申告書
    Arduino側はHCK02_02と同じ等間隔サンプリング(150µs/6.67kHz)で1行1サンプル送信。
    Processing側はminimのFFT(1024点/Hamming窓)でシリアル受信サンプルを解析し、
    時間波形+スペクトル(横軸Hz/縦軸dB)を上下2段で描画。楽曲再生キーバインドも継承。
2026-04-24 [ドキュメント] 役割分担を担当拡大に合わせて更新: Arduino系全般を塩澤担当に
    第2回ミーティング（2026-04-22）の合意を反映。塩澤担当を指揮者マイコン（node_01）のみから
    Arduino 系プログラム全般（node_01〜05）に拡大し、楽器ノードのコーディング担当「未決」を解消。
    齋藤の「音階生成」は楽譜データ作成・ロジック検討に再配置し、Arduino 実装は塩澤と連携する形に調整。
2026-04-24 [機能追加] ハッカソン1 事前課題: 基本設計・詳細設計 原案（Markdown版）
    2026-04-29 締切の個人事前課題「担当箇所の基本設計・詳細設計 原案作成」の下書き。
    Embedded-Module-Architecture に準拠した第I部 基本設計（概要/背景/目的/FBS・PBS・MOP/
    アーキ/共通I/F/WBS）と第II部 詳細設計（ファイル構成/技術スタック/共通層API/
    node_01 指揮者/node_02〜05 楽器/V&V・TPM/制限事項）を章ごとに sections/ に分割して配置。
    TeX 化・PDF 化は内容合意後の別フェーズで実施する。
2026-04-24 [ドキュメント] EMA 参照資料を architecture_reference/ に取り込み
    塩澤担当の Arduino 系ファームウェア（firmware/ 配下）が全面採用している
    Embedded-Module-Architecture（https://github.com/takushio2525/Embedded-Module-Architecture）の
    正本資料（ARCHITECTURE.md / CLAUDE.md / 教科書・実装ガイド・設計仕様書 PDF）を
    work/shiozawa/work-0422/architecture_reference/ にスナップショットとして取り込み、
    出典・取り込み日・編集禁止である旨を各ファイル冒頭に明記。
    design_draft 各章および後続の report/ TeX から本フォルダを正本として参照する。
    上流が更新されたら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
2026-04-24 [改善] design_draft 各章を EMA 正本仕様に整合（v0.3）
    work/shiozawa/work-0422/design_draft の各章に旧仕様（IModule の
    setup()/update()、SystemData/ProjectConfig 単一構造体、src/ 直下配置 等）が
    残っていたのを、Embedded-Module-Architecture（EMA）の正本仕様に整合：
    - IModule の 4 メソッド init / updateInput / updateOutput / deinit
    - inputModules[] / outputModules[] の 2 配列 + applyPattern() 関数
    - SystemData は {Module}Data フィールド集約、ProjectConfig は
    {Module}Config {MODULE}_CONFIG インスタンス集約
    - include/SystemData.h / include/ProjectConfig.h（src/ から移動）
    - platformio.ini の build_flags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
2026-04-24 プロジェクト計画性利用シートの追加
2026-04-24 間違えて削除してしまったので再追加
2026-04-25 [ドキュメント] 計画書テンプレート（LuaLaTeX/jlreq）を追加
    ハッカソン1の計画書用テンプレート一式を report/計画書テンプレート/ に追加。
    plan_template.tex は LuaLaTeX 専用なので、ファイル冒頭に
    "% !TEX program = lualatex" を付与し、VS Code (LaTeX Workshop) からも
    ローカル lualatex でビルドされるようにした。
2026-04-25 [改善] LaTeX Workshop で pLaTeX/LuaLaTeX を magic comment で自動切替
    これまで pLaTeX 用 latexmk のみ定義していたため、LuaLaTeX を使う
    plan_template.tex を VS Code から保存ビルドできなかった。
    tools に latexmk-platex / latexmk-lualatex の 2 つを定義し、recipes 名を
    それぞれ "platex" / "lualatex" に揃えた上で forceRecipeUsage を false に
    することで、ファイル冒頭の "% !TEX program = lualatex" でレシピを
    自動選択できるようにした。magic comment が無いファイルはデフォルト
    (先頭 = platex) で従来どおりビルドされる。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
2026-04-25 [改善] .gitignore で report 配下の生成 PDF をすべて除外
    これまで report/main.pdf のみを除外していたが、サブディレクトリ
    （例: report/計画書テンプレート/plan_template.pdf）の生成物は
    追跡対象になってしまっていた。報告書系 PDF は手元コンパイルで
    確認する運用なので、report/**/*.pdf でまとめて除外する。
2026-04-25 [改善] HCK02_01/02/03 のコード（.ino, .pde）を必要最低限の素朴な書き方に統一
    例題2 をベースに、シリアルプロッタの Y 軸固定用ガイドや delay(1) の素直な
    サンプリングで揃えた。Processing 側は循環バッファでの波形描画と、Minim FFT
    による線形振幅・単色バーのスペアナにし、講義要件に対する最小実装に絞った。
    凝った最適化（micros() ラップアラウンド対策、dB 変換、Hamming 窓、色相マップ
    など）は外し、各行を自分の言葉で説明できる粒度に揃えている。
2026-04-25 [ドキュメント] HCK02_01/02/03 の生成AI利用申告書をテンプレ準拠で書き直し
    講義配布の「生成AI利用申告書テンプレート.pdf」に沿って 6 項目 + 参考文献の
    素直な構成に揃え、装飾的なスタイルや TODO・回りくどい言い回しを排除。簡素化
    した HCK02_01/02/03 のコードと整合する内容（delay(1) サンプリング、線形振幅
    スペアナ等）に書き換え、PDF も同コミットで再生成した。
2026-04-25 [リファクタ] work-0422 周辺のディレクトリ整理と授業資料追加
    - report/shiozawa/01_0421/, template/ を work/shiozawa/ 配下へ移動
    （提出物と作業ファイルの置き場を work/ 系に集約）
    - HCK02_02_processing/, HCK02_03_processing/ の旧 .pde を削除し、
    HCK02_02/, HCK02_03/ 配下の最新版に統合
    - 古い提出 zip (HCK02_01.zip, HCK02_02.zip, 事前課題提出.zip) を削除
    - 計画書テンプレート PDF を report/ と work/shiozawa/ に追加
    - 第2回授業資料 HCK1_02.pdf を references/lectures/ に追加
2026-04-25 [改善] HCK02_02 マイク波形を横に引き伸ばして詰まり解消
    画面幅 800 サンプルぶん描画して波形が密集していたため、
    表示サンプル数を VISIBLE_SAMPLES=80 に絞り、横方向に等間隔へ
    引き伸ばす描画に変更。
2026-04-25 [改善] HCK02_02 受信バッファと表示範囲を分離して波形描画を整理
    直近の修正ではバッファ自体を縮めてサンプルを捨てていたが、
    受信バッファ BUFFER_SIZE=4000 はそのまま保持し、描画時に
    最新 VIEW_SAMPLES=80 個だけを画面幅に引き伸ばす方式へ変更。
    データを捨てずに画面表示量だけを制限する形に直した。
    [HCK02_02.pde]
2026-04-25 [修正] HCK02_02 サンプリングを 6.6kHz busy-wait に戻して波形のガビガビを解消
    acd0a35 で .ino を delay(1)=1kHz の素朴版に書き直したため、
    440Hz のサイン波が Nyquist ぎりぎり（約2.3点/サイクル）でしか
    取れず、Processing 側で再生中の波形がガビガビになっていた。
    - .ino: 9868aba 時点の while busy-wait 方式（150µs 周期 ≒ 6.6kHz）
    に戻す。実機で動作実績ありの版。
    - .pde: VIEW_SAMPLES を 80 → 200 に調整（6.6kHz と組み合わせて
    画面に映る時間を約 30ms ぶんに）。
    [HCK02_02.ino, HCK02_02.pde]
2026-04-25 [修正] HCK02_02 サンプリングを 6.6kHz busy-wait に戻して波形のガビガビを解消
    fb9e238 で .ino を delay(1)=1kHz の素朴版に書き直したため、
    - .ino: d2cc271 時点の while busy-wait 方式（150µs 周期 ≒ 6.6kHz）
    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
    [HCK02_02.ino, HCK02_02.pde]
2026-04-25 [修正] HCK02_02.ino を delay(1) 版に戻す
    直前のコミットで .ino を while busy-wait の 6.6kHz 版に
    戻したが、ユーザー側で .ino の delay(1) 版を正としたいと
    判断があったため、acd0a35 時点の素朴な記述に戻す。
    [HCK02_02.ino]
2026-04-25 [修正] HCK02_02.ino を delay(1) 版に戻す
    判断があったため、fb9e238 時点の素朴な記述に戻す。
    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
    [HCK02_02.ino]
2026-04-25 [修正] HCK02_01/02/03 を素朴な書き方に戻し delayMicroseconds(100) で約5kHzサンプリングに
    acd0a35 時点の素朴版（delay 系の単純ループ）に揃え直し、ディレイのみ
    delay(1) から delayMicroseconds(100) に短縮した。HCK02_03.pde の
    SAMPLE_RATE も 1000 → 5000 に追従。
    [HCK02_01.ino, HCK02_02.ino, HCK02_02.pde, HCK02_03.ino, HCK02_03.pde]
2026-04-25 [修正] HCK02_01/02/03 を素朴な書き方に戻し delayMicroseconds(100) で約5kHzサンプリングに
    fb9e238 時点の素朴版（delay 系の単純ループ）に揃え直し、ディレイのみ
    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
    [HCK02_01.ino, HCK02_02.ino, HCK02_02.pde, HCK02_03.ino, HCK02_03.pde]
2026-04-25 [改善] HCK02_02.pde 表示サンプル数を絞り画面に約6周期だけ描画
    DISPLAY_SAMPLES=160 で直近サンプルのみを画面幅に引き伸ばし、
    波形が詰まりすぎていた表示をゆったり見えるよう調整。
2026-04-25 [改善] HCK02_02.pde 表示サンプル数を160から60に変更し、波形の描画をより滑らかに
2026-04-25 [ドキュメント] HCK02_01 申告書 ツール表記・文量・参考文献を整理
    実際は GPT 未使用のため使用 AI ツールを Claude Code のみに修正。各項を冗長な部分を
    削って短くし、参考文献は Arduino 日本語リファレンス（武蔵野電波）のみに絞った。
    レイアウトを詰めて 1 ページに収納。
2026-04-25 [ドキュメント] HCK02_01/02/03 申告書を講義HCK1_02の例題に対応した書き直しに変更
    授業（HCK1_02）で例題1/例題2 を実施し、宿題（HCK1_02_ex）が出された前提
    を踏まえ、各課題で「AI で解決すべき内容」を実装の本筋に合わせて整理し直す。
    あわせて氏名を「塩澤 匠生」に統一。
    - HCK02_01: 例題2 の波形が正弦波に見えない問題（サンプリング周期不足 +
    Plotter の縦軸自動スケーリング + ラベル列汚染）への対処を中心に
    - HCK02_02: 例題1 の Serial.write/serialEvent では扱わなかった「サンプル
    連続送信 + 循環バッファでの波形描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
2026-04-25 [ドキュメント] HCK02_01 申告書 AI相談の本筋を「シリアル出力の文字数がループ周期を支配」に修正
    例題2 の配布コードが遅いのは delay(1) より「日本語ラベル4つの Serial.print」が
    ボトルネックだった、という実際の経緯に申告書を合わせる。
2026-04-26 [機能追加] HCK02_mic_sim マイク入力擬似シリアル出力テストプログラムを追加
    マイク故障時でも HCK02_02.pde / HCK02_03.pde を動かせるよう、
    playSong() と同じメロディを Arduino 内部で合成し 0〜1023 を 921600 baud で出力する代替スケッチ。
    内部時刻はサンプル番号÷SAMPLE_RATE で進めるので FFT のピーク位置が正しく出る。
2026-04-26 [ドキュメント] HCK02_01 申告書 work3.ino に存在しない delay(1) 等の記述を実態に即して書き直し
    - 例題2 のコード（work3.ino）には delay(1) も analogRead 100μs の記述根拠も無いため、
    AI が示したとされるボトルネック説明から該当箇所を削除し、日本語ラベル（UTF-8 で 1 文字
    3 バイト）の総バイト数を主因とする説明に置き換え
    - 検証方法をスマホのチューナーアプリ再生から、Processing 側の HCK02_02.pde を再生して
    受信する形に修正
    - 再現実験の記述を「ラベルと delay(1) を順番に外す」から「Serial.print の日本語ラベル行を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
2026-04-26 [修正] HCK02_02.pde シリアルポート名をローカル環境の現状に合わせて更新
    Arduino を別の USB ポート / 別個体に差し替えた際の /dev/cu.usbmodem* の値変更に追従。
    [HCK02_02.pde]
2026-04-26 [改善] LaTeX Workshop の編集時自動コンパイルを無効化
    autoBuild.run を onFileChange から never に変更。
    .tex 編集のたびに走るビルドを止め、Docker での明示的コンパイル運用に統一する。
2026-04-26 [機能追加] HCK02_mic_sim_kanji 漢字ラベル付き擬似シリアル出力テストプログラムを追加
    HCK02_mic_sim.ino の比較版。t を micros() から直接取り、漢字ラベル付きで
    Serial.println することで「送信時間がループ周期を支配 → t がガタつき波形が崩れる」
    様子を Serial Plotter / FFT で観察するためのデモ。
2026-04-26 [ドキュメント] HCK02_01 申告書を簡潔化し実態に合わせて整理
    プロンプト記述・AIの活用区分・問題有無の判定・工夫点・参考文献を、
    実際の作業内容に即して短くまとめ直した。
2026-04-26 [機能追加] work3_sim work3.ino の擬似マイクシミュレータを追加
    work3.ino の analogRead(A0) を micros() 基準 440Hz sin 波生成に置き換え、
    それ以降の電圧換算と漢字ラベル付きシリアル出力は work3.ino と同一構成にした。
    マイクなしでも漢字ラベル送信が支配的な状況下での波形崩れを再現するテスト用。
2026-04-26 [スタイル] HCK02_01 申告書の句読点を ，． に統一
    本文中の 、。 をすべて 全角の ，． に置換．
    既存の line 80 が ，． を使っていたため，読点・句点表記を全文で揃えた．
    PDF も再ビルドして同梱．
2026-04-26 [改善] work3_sim 漢字ラベルを廃しシリアル出力を生値1本に絞る
    HCK02_01 申告書「4. 正しいと確認した方法」で説明している再現実験の確定形．
    "実測値:" など日本語ラベルの Serial.print をすべてコメントアウトし，
    Serial.println(d) の生値のみを送信する状態にした．
    ループ送信バイト数を最小化し，波形が滑らかに見えることを確認するための構成．
2026-04-26 [改善] シリアル出力の日本語ラベルを削除し、送信データ量を削減
2026-04-26 [ドキュメント] HCK02_02 申告書を「そのまま使った」方針に簡潔化し句読点を ，． に統一
    出力波形の確認とコード理解を行った旨に書き換え、AI ツールを Opus のみに整理。
    問題・工夫点は「特になし」とし、生成 PDF も同コミットに含める。
2026-04-26 [ドキュメント] HCK02_02 申告書を課題1からの続き感に書き直し検証もシリアルプロッタ比較に変更
    Arduino 側は課題1 のコードから上下の固定線を消すだけで AI に相談していない
    旨を明記し、Processing 側は AI 出力をほぼそのまま使った構成として整理。
    検証も「予想と一致したか」ではなく「Serial Plotter と同じように波形が
    見えているか」の比較に書き換え、生成 PDF も同コミットに含める。
2026-04-26 [ドキュメント] HCK02_02 申告書 プロンプトを Processing 側のみ尋ねる形に修正し本文と整合
    本文では Arduino 側は課題1 の延長で AI に相談していない旨を明記しているのに
    対し、プロンプトが Arduino 側の送り方も尋ねる形になっていて矛盾していた。
    プロンプトを「課題1 で 1 行 1 サンプル送るところまでは済んでいる前提で
    Processing 側の受信・描画を尋ねる」形に書き換え、生成 PDF も同コミットに含める。
2026-04-26 [ドキュメント] HCK02_03 申告書を全面書き直し Processing コードのみ AI 生成の構成に整理
    Arduino 側は HCK02_02.ino をそのまま流用，Processing 側のみ FFT 表示を追加した実態に合わせ，
    プロンプト・「そのまま使った」方針・FFT 周りの理解（正規化／SAMPLE_RATE／ナイキスト）を整理．
    使用 AI ツールを Claude Code (Opus 4.7) のみに統一し，句読点も ，． に揃えた．
2026-04-26 [改善] 参考文献のArduinoリファレンスをURLのみの形式に修正
2026-04-27 [ドキュメント] 作業ブランチに未取り込みだった計画書テンプレートを復元
    origin/main の f02d8dd で追加された TeX/sty 一式が
    shio-arduino-work-0422 にマージ未到達で欠落していたため、
    hack-cover.sty / hack-fonts.sty / plan_template.tex を main から取得し、
    plan_template.pdf も再コンパイルして同コミットに同梱。
2026-04-27 [ドキュメント] HCK02_01 申告書 自分で工夫した点にガイド線出力を追記
    電圧変換削除に加えて、Serial Plotter の Y 軸を固定する
    0/1023 ガイド線出力も自分の工夫として明記するため。
2026-04-27 [ドキュメント] HCK02_02 申告書 AI関与範囲を ino/pde/楽曲再生で分けて記述
    本文では Arduino 側は AI 不使用、楽曲再生は前回課題流用と
    書いていたのに、チェック欄が「そのまま使った」になっており
    食い違っていたため「一部修正して使った」に変更し整合させた。
    あわせて第6項に DISPLAY_SAMPLES 調整の工夫を追記。
2026-04-27 [改善] HCK02_03 FFT入力を時系列順コピーに変更し申告書も簡潔化
    FFT 入力を serialEvent でリングバッファに書き込んでいたため、
    fft.forward() 呼び出し時に書き込み位置で時系列が不連続になっていた。
    draw() 冒頭で samples の最新 FFT_SIZE 個を時系列順に並べ直してから
    渡す形に変更。あわせて申告書を簡潔化し、第4項を実機確認できた範囲
    (正弦波の基音/楽曲再生時の反応) に絞り、第6項に理解確認の工夫を
    明記、参考文献に Arduino Reference を追加。
2026-04-27 [ドキュメント] WBS再設計提案書を新規作成（議事録表1を授業資料形式へ再構成）
    議事録 表1 の WBS が「時間的フェーズ」を PBS と重複させる構造になっており、
    授業資料の正解形式（設計→製造→テスト の工程軸）と乖離していたため、
    チームレビュー材料として独立 LaTeX プロジェクト（wbs_proposal/）で再設計案を作成。
2026-04-27 [ドキュメント] WBS表のみのミニマル版（wbs_table）を新規作成
    議事録表1と同じ5列・multirow構造で、新WBSの内容のみを1PDFに
    出力する最小LaTeXプロジェクト。wbs_proposal/と内容は同じだが、
    こちらは表のみを見たい用途（章立て・対応表・工数集計なし）で、
    チーム共有時に議事録表1と並べて見比べるのに使う。
    プリアンブルは jlreq(article) + luatexja-fontspec + multirow の
    最小構成、フォントは Hiragino Kaku Gothic ProN（Mac 標準）。
2026-04-27 [ドキュメント] wbs_table を TeX から Markdown 1 表に差し替え
    活動タスク 51 行が LaTeX 出力では複数ページに分かれて
    議事録 表1 のような「一覧表」として読めなかったため、
    README.md に 1 つの Markdown 表として統合した。
    multirow は Markdown では使えないので、時間的フェーズ・番号・
    要素成果物を各行に繰り返す形にして、GitHub 上で
    スクロール 1 本で全 WBS が見られるようにする。
    内容（5 フェーズ・51 タスク・担当配分）は wbs_proposal/ と同一。
2026-04-27 [改善] wbs_table 表を HTML rowspan 形式にして区切りを強調
    Markdown 標準表ではセル結合できず、フェーズ・要素成果物列で同じ値が縦に並ぶと境界が見づらかったため、議事録 表1 と同じ縦結合形式に変更。
2026-04-27 [ドキュメント] wbs_table に基本設計・詳細設計の分担抜粋を追加
    第3回ミーティング前に各自が持ち寄る設計タスク（114-117, 121-125 の 9 件、111-113 のチーム合意形成タスクは除外）を担当者別に整理した共有用ファイル。README からも導線を追加。
2026-04-27 [改善] wbs_table 124/125 の詳細設計タスクに具体項目を追加
    124 に Python で実音源を FFT して倍音・ADSR を取得する任意タスク（余裕があれば）、125 にテンポ・音程・拍のフォーマットと Arduino 側から Processing へ送る音楽データ仕様の検討項目を追記。
2026-04-27 [改善] wbs_table 124/125 を 124-130 に分割し梅澤・齋藤の詳細設計を細分化
    塩澤 121-123 と粒度を揃えるため、Processing 詳細設計（旧 124）を 124-127（127 は Python 実音源解析の任意タスク）、楽譜データ詳細設計（旧 125）を 128-130 に分割。120 詳細設計の rowspan を 5→10 に更新。
2026-04-27 [改善] wbs_table 116/117/124-130 を初心者向けの平易な日本語に書き換え
    齋藤・梅澤分のタスク表記を平易化（例：ボイス管理→「4 種類の楽器パートを同時に鳴らす管理」、ADSR→「音の立ち上がり・伸び・余韻のカーブ」、FFT→「周波数分解」）。塩澤分（114/115/121-123）は技術用語のまま維持。
2026-04-27 [新規] 計画書テンプレート用の LaTeX スタイルファイルを追加
2026-04-27 軽微な修正
2026-04-27 コミット
2026-04-27 [改善] HCK02_03 波形表示の水平・垂直レイアウトを拡大
    直近256サンプルをウィンドウ幅に引き伸ばし描画、
    上下領域の比率を height 比率ベースに変更して波形を見やすくした。
2026-04-27 [修正] HCK02_03 波形描画にサンプル間線形補間を追加しガタつきを解消
    256→900px への引き伸ばしで int 切り捨てにより階段状になっていた問題を
    lerp で滑らかに補間するよう修正。
    [HCK02_03.pde]
2026-04-27 [改善] HCK02_03 波形を1サンプル=1ピクセルの等倍描画に変更し滑らかスクロール化
    WAVE_SHOW による引き伸ばし描画では 1フレームあたりの更新割合が大きく
    波形がカクカク飛んでいた。バッファ全体（width=900）を等倍で描くことで
    更新割合を ~9%/frame に抑え、押し出されるような滑らかなスクロールを実現。
2026-04-27 [改善] HCK02_02/03 を最小構成に簡素化
    - 音色を基本4種(SINE/TRIANGLE/SAW/SQUARE)に絞り、randomNOddHarms/gen10を削除
    - 音符ごとのmaxAmp配列を廃止し固定振幅に統一
    - HackInstrument → SimpleInstrument にリネーム・簡素化
    - HCK02_03 のスペクトル表示からHz目盛りを削除
    - 冗長なコメントを整理
2026-04-27 [改善] HCK02_03 時間波形表示を削除しスペクトルのみの構成に変更
2026-04-27 [改善] work3_sim を音階巡回シミュレータに変更
    スペクトラムアナライザの検証用に、440Hz固定だった sin 波生成を
    2秒ごとにド〜ド（C4〜C5）を順に切り替える構成に変更。
2026-04-27 不要な出力削除
2026-04-27 [ドキュメント] HCK02_01/02/03 申告書を実機確認内容と整合化し HCK02_0X.pdf を同梱
    - HCK02_03 第4項のキー操作記述をコードと整合化(1キーで音色選択 → pキーで再生)
    - HCK02_01/02 第5項の確認内容をテンプレ要求に合わせて追記
    - 提出ファイル名規約に合わせて main.pdf を HCK02_0X.pdf 名で同梱
2026-04-27 [ドキュメント] 提出用計画書 第2章・第3章を執筆（塩澤担当範囲, EMA準拠）
    事前課題（HCK1, 4/29 提出）の基本設計・詳細設計たたき台。
    WBS タスク 114/115/121/122/123 を網羅し，design_draft の内容を
    LaTeX 化したうえでプリアンブル拡張・PDF 生成までを 1 コミットに含める。
2026-04-27 [ドキュメント] HCK02_03 工夫点セクションのコード解説を簡素化
    drawWave 削除の理由説明（正規化・サンプルレート対応・ナイキスト周波数）の
    箇条書きを削除し，レイアウト変更だけを残して提出版を短く整える．
2026-04-27 [改善] 提出用計画書 楽器→PC 通信を UDP から USB Serial に変更
    PC--Arduino 間は Serial.write で通信する仕様変更を反映．ノード間
    （CTRL/BEAT）は WiFi UDP のまま，NoteSenderModule を新設して NOTE を
    USB Serial で直送する二系統構成に書き換え，PDF を再生成．
2026-04-27 [改善] 提出用計画書 公式構成図に整合（PC×4・1対1 USB・UDP Mcast）
    チーム23 の progFocus 構成図に従い，PC を 4 台（楽器ノード → Mac は
    1 対 1 USB Serial 直結）に変更，指揮者 → 楽器は UDP マルチキャスト
    （仮 239.0.0.1:5001）に統一，楽器名を金管 1/2/3 + ドラムに確定．
2026-04-27 [修正] F4.2 を USB Serial 送信に修正（旧 UDP ユニキャスト記述の取りこぼし）
    機能一覧の F4.2 が旧仕様「Processing への UDP ユニキャスト送信」のままに
    なっていたのを，現仕様の USB Serial（Serial.write，CDC 1:1 接続）に整合化．
2026-04-27 [改善] node_01 を SoftAP 兼用にしてネットワーク構成を簡素化
    外部 WiFi AP（スマホテザリング・専用ルータ）を廃止し，指揮者ノード
    node_01 自身が ESP32-S3 の SoftAP を立てて楽器ノードを収容する構成に
    変更．会場 LAN のセキュリティ制限や電波混雑の影響を受けず，部品数
    （PBS）も削減できる．
    主な変更点:
    - 全体ブロック図: 独立した「WiFi AP」ボックスを削除し，node_01 を
    SoftAP として描画
    - 通信方式テーブル: WiFi モード行を SoftAP/STA に書換え，IP 割当は
    SoftAP 既定（192.168.4.1〜5）に変更
    - PBS: P2 ネットワークの「ロー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
2026-04-28 [改善] 指揮者ノードを XIAO ESP32-S3 Sense + MPU6050 に変更
    UNO R4 WiFi の WiFiS3 が AT bridge 経由で SoftAP + UDP マルチキャストの
    信頼性に懸念があったため，指揮者ノード node_01 だけを ESP32-S3 直制御の
    XIAO ESP32-S3 Sense に置き換える．EMA の HW 局在化により楽器ノード
    （02-05 = UNO R4 WiFi のまま）への影響はゼロ．
    - §2.2.1 全体ブロック図: node_01 ラベルを「XIAO ESP32-S3 Sense + MPU6050
    （SoftAP）」に
    - §2.2.2 ノード役割表: 指揮者の責務に「自身が SoftAP を起動」を明示
    - §2.2.3 データフロー: 「内蔵 IMU」→「MPU6050（I2C）」
    - §2.3.1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
2026-04-28 [修正] 提出用計画書 第2-3章の致命的な誤りと表紙メタを修正
    - CTRL/BEAT ペイロード長表記を「16 バイト」→「20 バイト」に訂正
    （ヘッダ12B + ペイロード8B = 20B が設計の前提。NOTE と整合）
    - TP-2 通信遅延の測定手順を時計同期不要なループバック方式に変更
    （旧手順は node_01 / node_02 の millis() 同期前提で物理的に成立しない）
    - 加速度ノルム閾値の TBD 表値を 1.5 g → 1.80 g に揃え本文と整合
    - 表紙メタを塩澤の確定値で更新（題目=Arduino オーケストラ, チーム=チーム23,
    25G勢3名の学番・氏名, 24G勢3名は「（仮）」で残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
2026-04-28 [修正] 提出用計画書 第1章「プロジェクトの計画書」を削除
    今週の事前課題は「担当箇所の基本設計・詳細設計の原案作成」のみで，
    第1章（プロジェクト題目・FBS/PBS/WBS・MOE/MOP/TPM・資源・リスク管理）
    は今回の提出対象外であるため章ごと削除．これに伴い章番号が繰り上がり，
    基本設計が第1章・詳細設計が第2章となる．label の被参照はゼロのため
    波及なし．\setcounter{page}{1} は新しい第1章へ移設．
2026-04-28 [改善] 提出用計画書 マスタクロック方式と未来時刻指定を導入
    楽器間同期誤差を WiFi 到達ジッタから切り離すため，BEAT を「マスタ時刻
    play_at_master_ms に発音せよ」という未来時刻指定方式に変更．指揮者ノードの
    millis() を全ノードのマスタ時刻と定義し，楽器は CTRL の timestamp_ms から
    EMA でオフセットを学習する．
    - §3.4.3 OrcProtocol: BEAT ペイロードを phase_q8 → play_at_master_ms に
    変更（uint32_t）．共通ヘッダ timestamp_ms をマスタ時刻と再定義
    - §3.4.3 マスタクロック方式と時刻同期 のサブサブセクションを新設．
    オフセ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
2026-04-28 [改善] 提出用計画書 描画崩れ・矛盾・EMA非整合を徹底修正
    描画: 全体ブロック図/状態遷移2図/クラス図のラベル位置・余白を調整し
    ページ外への見切れを解消．CTRL/BEAT/NOTE apibox のタイトル切れを修正
    （短いタイトル + 説明分離）．技術スタック・ピンアサイン・モジュール一覧
    ・試験項目・未確定事項の表幅を再設計し，geometry / tabcolsep /
    emergencystretch / L{} 列で longtable の overfull を抑制．
    整合: snake_case のフィールド名を CamelCase に統一（timestampMs,
    beatNo, playAtMasterMs, masterNow, partId, noteNumber, durationMs,
    bpmQ8）．図1.2 の遷移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
2026-04-28 [改善] 提出用計画書 詳細設計をAPIリファレンス風に書き換え
    ソフトウェア設計・処理フローの設計セクションで lstlisting に直接 C++
    コードを貼り付けていた箇所を、Renesas FSP 風のメンバ表・設定値表・
    処理フロー箇条書きに置き換え。関数名／フィールド名／役割を中心に
    記述し、厳密な型表記は省略した。
2026-04-28 [改善] 提出用計画書 末尾に生成AIの利用について章を追加
    Claude Opus と対話しながら執筆した旨を，提出規約上の必須項目では
    ないものの透明性のため簡潔に明記。設計値・コード例の責任は著者が
    負うことを併せて記載。
2026-04-28 [ドキュメント] progFocus 設計ノートと AI 編集ルールを追加
    ハッカソンチーム23 の構成（ノード19・接続15）を progFocus からエクス
    ポートしたものと、AI が同形式を解析・編集するためのルール集を保管。
2026-04-28 [改善] 提出用計画書 状態遷移の矛盾解消と未定義語「穴N対策」除去
    楽器ノードの状態遷移図と本文・表で時計同期収束の扱いが食い違っていた
    矛盾を解消。指揮者の状態遷移文も「WiFi接続完了」→「SoftAP起動完了」
    に統一。設計時の内部メモが残っていた「穴1〜3対策」を全箇所削除。
2026-04-28 [改善] 提出用計画書 提出前最終チェックで3点の整合性を修正
    - MOP-1 の指標を「BEAT 受信時刻差」から「発音タイミング差」へ訂正．
    設計の中核がマスタクロック方式であり TP-3 の検証方法とも整合させる
    - ユーザー操作の起動順記述を訂正．楽器ノードは先に起動した時点では
    Idle（SoftAP 待ち）であり，指揮者の SoftAP 起動で WaitStart に
    遷移する流れを明示
    - tab:state-conductor の Conducting 行に混入していた句点「。」を
    「．」に統一
2026-04-29 PDFコンパイル
2026-04-29 [ドキュメント] WBS 表（再設計版）をチーム共有用に meetings/0422_2回/ へ複製
    work/shiozawa/work-0422/wbs_table/ を meetings/0422_2回/wbs_table/ にコピーし、
    チーム全員が議事録 PDF と同階層から辿れるようにした。
    コピー先からの相対パス（議事録 PDF / wbs_proposal / 提出用計画書）を修正し、
    meetings/README.md の構成表にも 1 行追加して見つけやすくした。
2026-04-29 [改善] WBS 表をリネーム
2026-04-29 事前課題共有追加
2026-04-29 事前課題のPDFファイルの追加
2026-04-29 齋藤追加
2026-04-29 事前課題共有
2026-04-29 マネジメント用pdfmamezi_御代川稜 を事前課題共有に追加
2026-04-29 pdf追加
2026-04-29 担当者名を「梅澤」から「斎藤」に変更
2026-04-29 授業資料調整
2026-04-29 期限列をタスク表に追加
2026-04-29 [ドキュメント] 第3回事前課題3本のルーブリック評価レビューを追加
    塩澤・齋藤・梅澤の事前課題PDFをシステム設計書ルーブリックで評価し、
    ADRおよび他メンバー成果物との整合性チェック結果をまとめた。
    第3回ミーティングでの合意事項候補（同期誤差基準・PC構成・楽譜データ仕様・
    楽器構成）を抽出。
2026-04-29 ハッカソン追加
2026-04-29 [追加] ガントチャートの記入例を作成
2026-04-29 ガントチャートの全体スケジュールを修正し、WBSのリンクを更新
2026-04-29 FBS/PBS図の追加
2026-04-29 [ドキュメント] 計画書のMOP目標値に根拠サブセクションと日本語参考文献を追加
    各MOP（同期誤差/通信遅延/拍検出/テンポ追従/パケロス/CPU時間/起動時間/強弱段階）の
    数値根拠を，合奏知覚閾値・DTM推奨レイテンシ・指揮ジェスチャ認識の先行研究・
    無線LANのパケロス品質基準などのネット閲覧可能な日本語文献を引用しつつ整理した．
    TPM側の合否基準もMOP根拠と同源である旨を注記し，巻末にthebibliography章を新設．
2026-04-29 [ドキュメント] MOP根拠の参考文献を学術論文・公式勧告に置き換え
    個人ブログ・Wikipedia 等の信頼度の弱い文献を，査読論文（河瀬 心理学評論 2014）と
    ITU-T 勧告 Y.1541 の日本語標準（TTC JT-Y1541）に置き換え．
    MOP-7（起動時間）と MOP-8（強弱段階）は出典の質が確保できないため，
    本文側で「設計見積もり」「楽典の周知事項」と書き換えて引用を外した．
2026-04-29 [ドキュメント] 第3回事前課題 24G勢3本の計画書ルーブリック評価レビューを追加
    地曵・御代川・片岡の3名のPDFをマネジメント計画書ルーブリックで評価。
    24G勢はWBS上「議事録持ち回り＋300テスト以降合流」の前提で、
    計画書骨格(御代川)・WBS改訂(片岡)・システム設計(地曵)の3本を
    1本の計画書本体へ統合する方向の推奨アクションをまとめた。
2026-04-29 pdf更新
2026-04-29 [ドキュメント] 24G勢3本にシステム設計書ルーブリック評価を追記
    地曵・御代川・片岡の3名のレビューファイルへ、システム設計書ルーブリック
    （基本設計2項目+詳細設計3項目, 計10点）軸での評価を§7として追加。
    - 地曵 6/10（B中心）: 状態遷移とクラス・関数粒度が評価点
    - 御代川 3/10（C中心）: テンプレート骨格はあるが図表の中身が浅い
    - 片岡 0/10（D中心）: 設計書ではなく WBS見直しメモのため対象外
    第3回ミーティングで「設計書は地曵PDFに統合」「御代川は計画書本体の編纂に
    注力」「片岡はWBS改訂・300テス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
2026-04-29 Implement code changes to enhance functionality and improve performance
    [ガントチャーver1ト.xlsx]
2026-04-29 議事録のtexファイルを追加
2026-05-02 [リファクタ] firmware と pc_app を production/test の 2 層構成に再編
    仕様書「Arduino オーケストラ計画書」(meetings/0429_3回/事前課題共有/
    arduino_塩澤.pdf) の準拠実装をテスト用としてリポジトリに同居させるため、
    既存の素テンプレートを production/ 配下に退避する。新規実装は test/ 配下に
    別途追加する。
    - firmware/{common, node_01..05, README.md} を firmware/production/ へ移動
    - pc_app/{example_sketch, processing_test, README.md} を pc_app/production/ へ移動
    ファイル内容の変更はなく rename のみ。後続コミットで test/ 配下に仕様準拠の
    実装と新しいトップ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
2026-05-02 [機能追加] firmware/test/common 共通層 (EMA + 通信プロトコル) を実装
    仕様書 §2.3.3 (通信パケット定義) と §2.3.3.4 (OrcNetModule API) に準拠した
    共通層ライブラリを firmware/test/common/lib/ に追加。test/ 配下の全ノードが
    lib_extra_dirs = ../common/lib で参照する。
    - ModuleCore/ IModule 抽象基底 + ModuleTimer (EMA 流用)
    - OrcProtocol/ CTRL/BEAT/NOTE 共通の 20 B 固定パケット (magic=0x4F52)
    - OrcNetModule/ WiFi UDP マルチキャスト送受信。SoftAp / Sta を切替
    ESP32-S3 (Arduino-ESP32) と UNO R4 WiFi (WiFiS3) の両対応
    - StatusLedModule/ 状態に応じた LED 点滅 (両ノード種で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
2026-05-02 [機能追加] firmware/test/node_01 指揮者ノード (ESP32-S3 Sense + GY-521) を実装
    仕様書 §2.4.2 (指揮者ノードの処理フロー) に完全準拠。XIAO ESP32-S3 Sense と
    GY-521 (= MPU6050 ブレイクアウト) を I2C で接続し、振り下ろしを検出して
    CTRL/BEAT を WiFi UDP マルチキャストで楽器ノードへ配信する。
    主な内容:
    - ImuModule: MPU6050 を Wire 直叩きで burst read (依存ライブラリゼロ)。
    ±4 g / ±2000 dps、200 Hz サンプリング
    - OrcSenderModule: data.beat.event を見て BeatPacket、ctrlTimer 経過で
    CtrlPacket を組み立て、data.orcNet.pendingXxx に積む (送信は OrcNetModule)
    - applyPattern(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
2026-05-02 [機能追加] firmware/test/node_02 楽器1 (金管1) ノードを実装
    仕様書 §2.4.3 (楽器ノードの処理フロー) に完全準拠。Arduino UNO R4 WiFi で
    node_01 SoftAP に STA 接続し、CTRL/BEAT を受信してマスタ時刻同期で楽譜進行、
    NOTE を USB Serial (1 対 1 接続の Mac) に送出する。partId=0x02, startBeatNo=0。
    - OrcReceiverModule: 受信した CTRL/BEAT の header.timestampMs から
    EMA (α=0.10) で時計オフセットを学習。BEAT は beatNo 重複排除のうえ
    PendingBeat キューに積む
    - NoteSenderModule: data.noteOut.pendingOn/pendingOff を見て NotePacket を
    組み立て、Serial.write() で 20 B を一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
2026-05-02 [機能追加] pc_app/test に Processing 音再生スケッチを実装
    仕様書 §2.3.3.5 (NoteSenderModule API) と Mac 側の責務 (倍音・ADSR 調整 →
    波形生成 → 内蔵スピーカ出力) の受け側を最小限実装した検証用スケッチ。
    orchestra_player/orchestra_player.pde:
    - USB Serial を開き、magic 0x4F52 (リトルエンディアンで 0x52 0x4F) で
    フレーム同期。20 B たまったら 1 パケットとして処理
    - type=3 (NOTE) を受けたら gate=1 で発音、gate=0 で消音
    - noteNumber を MIDI 周波数に変換し Minim でサイン波 + 線形 ADSR を再生
    - 同時複数声部対応 (partId+noteNumber キーで Voice 管理)
    - type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
2026-05-02 [ドキュメント] README/CLAUDE.md/ADR-0005 を production/test 2 層構成に追従
    ディレクトリ再編に伴い、各種参照とビルド手順を更新。
    - firmware/README.md (新規): production/test の役割分担、test 版の構成・
    共通層・役割分担表・仕様の核 (WiFi/パケット/MOP) を記載
    - pc_app/README.md (新規): production/test の役割分担を記載
    - README.md (ルート): 「手元でのビルド」セクションのコマンド例を
    test/node_01 と production/node_01 の 2 通りに更新
    - CLAUDE.md: ファームウェアのビルドコマンドを test/production の 2 通りに更新
    - docs/decisions/0005: 適用範囲を test/ 配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
2026-05-02 [ドキュメント] 各ソースファイル先頭にプロジェクトルートからの PIO ビルドコマンドを追記
    `cd` せずプロジェクトルートに居たままビルド/書き込み/シリアルモニタが
    できるよう、`pio run -d <project_dir>` 形式のコマンドを各ファイル先頭に
    コメントで明示する。エディタでファイルを開いた瞬間にコマンドが分かる導線。
    対象:
    - firmware/test/common/lib/ (両ノード共有: node_01 / node_02 のコマンド併記)
    - firmware/test/node_01/ (指揮者ノード用コマンド)
    - firmware/test/node_02/ (楽器 1 用コマンド)
    - firmware/production/node_01..05/ (素テン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
2026-05-02 [修正] PlatformIO の include path 解決を直接 -I 指定で安定化
    ImuModule.cpp が include/SystemData.h を経由して OrcNetModule.h を読む
    ところで「fatal error: OrcNetModule.h: No such file or directory」が出ていた。
    原因: PlatformIO の Library Dependency Finder (chain モード既定) は、
    各 lib/<Module>/ ライブラリから include/ 経由で別 library のヘッダを
    辿る依存を解決できない。
    対応: 両ノードの platformio.ini で
    - build_flags に common/lib/ の各サブディレクトリを -I で明示
    - lib_ldf_mode = deep+ で再帰スキャンも有効化
    の二段構えにして include 解決を確実にする。
    Co-Aut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
2026-05-02 [修正] node_01 の espressif32 プラットフォームを 6.10.0 に固定
    ビルド時に「fatal error: Network.h: No such file or directory」が
    WiFi ライブラリの内部で連発していた。
    原因: 最新の platform-espressif32 (>=51.x) は Arduino-ESP32 v3.x にアップ
    グレードされており、新規導入された Network ライブラリへの依存を持つ。
    PlatformIO の Library Dependency Finder が Network を WiFi の依存として
    解決しきれず、ビルドが破綻する既知の互換性問題。
    対応: platform = espressif32@6.10.0 に固定する。Arduino-ESP32 v2.0.17 で
    Network.h を要求しない構成。今回必要な WiFi.softAP / WiFiU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
2026-05-02 [改善] node_01 の USB CDC を常時有効化し BOOT ボタンなしで書き込み可能に
    ARDUINO_USB_MODE=1 と ARDUINO_USB_CDC_ON_BOOT=1 を build_flags に追加。
    XIAO ESP32-S3 Sense を USB Type-C で挿しただけで、
    1. BOOT ボタンを押さずに pio run -t upload で書き込みできる
    2. 書き込み完了後に自動リセットしてユーザコードが立ち上がる
    3. そのまま Serial が USB CDC として使える (pio device monitor 即接続)
    の三つが成立する。
    合わせて monitor_dtr=0 / monitor_rts=0 を指定し、シリアルモニタや
    Processing が後からポートを開いてもボードが勝手にリセットされないよ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
2026-05-02 [改善] node_01 のフラッシュ書き込みを USB JTAG (esp-builtin) 経由に変更
    XIAO ESP32-S3 の RESET 回路は esptool の DTR/RTS 自動リセットを拾い切れず、
    ARDUINO_USB_CDC_ON_BOOT=1 を入れても毎回 BOOT ボタン操作が必要だった。
    upload_protocol = esp-builtin に切り替えて、ESP32-S3 内蔵の USB Serial/JTAG
    コントローラ経由で直接フラッシュに書き込む。これでファームウェアの動作状態に
    関係なく BOOT / RESET ボタンなしで書き込める。
    トレードオフ: esptool より少し遅い (10–30 秒) が、ボタン操作不要の確実性を
    取る。書き込み後の自動起動は ARDUINO_USB_C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
2026-05-02 [ドキュメント] esp-builtin upload_protocol のコメントを「外部 JTAG 不要」と明記
    upload_protocol = esp-builtin の挙動が「外部 JTAG プローブを使うもの」と
    誤解されないよう、コメントを書き直した。実際には ESP32-S3 内蔵の USB
    Serial/JTAG コントローラを使うため、USB Type-C 1 本で完結する。
    設定値そのものは変更していない (a73b004 と同等)。
2026-05-02 [ドキュメント] esp-builtin upload_protocol のコメントを「外部 JTAG 不要」と明記
    設定値そのものは変更していない (5dcf8bb と同等)。
    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
2026-05-02 [機能追加] firmware/test に SERIAL_DEBUG フラグとシリアル可視化を追加
    node_01/02 双方の挙動を pio device monitor で確認できるようにする。
    共通 SerialDebug.h で DBG_PRINTF 等のマクロを切替え、SERIAL_DEBUG=1 時は
    node_01 が状態/IMU/拍/送信統計、node_02 が状態/同期/CTRL/BEAT/NOTE を
    人間可読テキストで出力。node_02 はバイナリ NotePacket を抑止し
    Processing 連携時は -DSERIAL_DEBUG=0 に切替える運用とする。
2026-05-02 [改善] node_01 拍検出を重力補正後の動加速度で判定し dump にピーク値を追加
    ログから「振っても n が 1.80 g に届かず beatNo=0」が判明。
    原因は重力1gが下駄として乗ったまま判定していたため。
    - ImuData に dynAcc/dynNorm (= LPF後 - キャリブ重力) を追加
    - applyPattern が dynNorm を計算し、拍判定をこの値で行う
    - 閾値を BEAT_ACCEL_THRESHOLD_G=1.80g (重力込) から
    BEAT_DYN_THRESHOLD_G=0.80g (動加速度) にリネーム+変更
    - main.cpp の 200ms dump に peakRaw / peakDyn (区間内最大) を追加し、
    スポット値で見逃すピークを可視化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
2026-05-02 [改善] node_01 拍検出閾値を動加速度 0.80g→1.20g (中間値) に調整
    0.80g では小さい揺れでも誤検出して「勝手に進む」状態だった。
    重力込み 1.80g (旧値) は姿勢により動加速度 0.9〜1.5g 相当、
    その中央付近の 1.20g を新閾値とする。
2026-05-02 [改善] pc_app/test: orchestra_player の対象シリアルポートをポート名指定に変更
    SERIAL_PORT_INDEX=0 だと Mac で /dev/cu.Bluetooth-Incoming-Port が選ばれて
    データが流れなかった。SERIAL_PORT_NAME を新設してポート名で直接開き、空のときだけ
    SERIAL_PORT_INDEX にフォールバックする。
2026-05-02 [改善] firmware/test: SERIAL_DEBUG を 0 に戻し Processing 連携用バイナリ送信を有効化
    実機での動作確認 (モーション検出・WiFi 接続) が完了したのでデバッグテキスト出力を
    無効化。node_02 の NoteSenderModule が 20B バイナリ NotePacket を Serial に流すように
    戻し、Processing 側 (orchestra_player) との連携テストへ移行する。
2026-05-02 [追加] firmware/test: PlatformIO 自動生成の .vscode/.gitignore と extensions.json を追加
    PlatformIO IDE が VSCode 起動時に作るローカル絶対パス入りの c_cpp_properties.json
    と launch.json は .gitignore で除外し、共有して問題ない PlatformIO 推奨拡張
    (extensions.json) と .gitignore 自身のみコミットする。
2026-05-02 [修正] orchestra_player を同パートでモノフォニック化、release を非同期 unpatch に変更
    triggerNoteOff が note 番号一致でしか効かないため、firmware 側で NoteOff
    パケットが落ちると古い Voice が patch されたまま残り、複数音が重なって
    「1音ずつ鳴らない」状態になっていた。NoteOn のたびに同 partId の既発音を
    release するモノフォニック動作に変更。あわせて release が即 unpatch で
    60ms フェードアウトが効いていなかったため、振幅線だけ落として draw() の
    reaper で時間経過後に unpatch するようにした。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
2026-05-02 [修正] node_02 NoteSender: Serial.write の直後に flush() を呼んで USB CDC バッファを即吐き
    UNO R4 WiFi の USB CDC は 20B 程度の小さい書き込みを内部で束ねるため、
    Processing 側に NotePacket がまとめて届いていた (UNO の TX LED が振るたびに
    点滅しないことから判明)。flush() で毎回明示的に送出させ、発音が即時反映
    されるようにする。
2026-05-02 [機能追加] orchestra_player に LOOP 再生モードを追加 (キー l/s で切替)
    ハードウェア接続がなくても音側だけ確認できるよう、内蔵メロディ
    「ドレミファミレド」を BPM 120 で自動再生する LOOP モードを追加。
    起動時は LOOP モード。'l' で LOOP、's' で SERIAL に切替可能。
    SERIAL モード時のみ NotePacket の NoteOn/NoteOff を発音に反映する。
2026-05-02 [改善] node_02 から SelfRun (BPM 自走) を削除し、純粋な「BEAT 駆動」進行に変更
    ユーザーの想定する動作「1 振り = 1 BEAT = score 1 拍進める。BPM はあくまで
    補助 (8 分音符の細分化や durationMs 計算用)」に合わせるため、楽器ノードから
    BPM 起点の自走ロジックを取り除く。
    - PerformerState: { Idle, WaitStart, Playing, SelfRun } → { Idle, WaitStart, Playing }
    - ScoreProgressData から virtualBeatNo / virtualBeatNextMs を削除
    - applyPattern: SelfRun への遷移と仮想 BEAT 内挿を削除。Playing 中に
    保留 BEAT が来たときだけ score を進める
    - ProjectConfig: beatTimeoutMs / LED_SELF_RU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
2026-05-02 [改善] node_01 拍検出をヒステリシス付き立ち上がりエッジ検出に変更
    単純な「dynNorm > 1.20g + refractory 250ms」だと、1 振りの過渡振動や
    静止時の微小ドリフトで複数 BEAT が連発し、Processing 側で「ずっと音が
    流れる」状態になっていた。
    新ロジック: dynNorm が LO=0.40g 未満に一度戻ってから HI=1.20g を
    超えた瞬間にだけ 1 BEAT 発火。これで「振り下ろし1回 = BEAT 1個」を
    構造的に保証する。refractory 250ms は連発抑制の保険として残す。
    合わせて armed フラグを SystemData.beat に出し、SERIAL_DEBUG 周期
    ダンプの "arm=" で現在の発火可否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
2026-05-02 [改善] node_01 拍検出を「重力方向に射影した動加速度の負ピーク」検出に変更
    ノルムだけで判定していたとき、振り下ろしと振り戻し (振り上げ) のどちらも
    大きいノルムを示すため 1 振りで 2 BEAT 出ていた (ログで確認: 振り戻し
    フェーズに dyn=1.43 等のピークが頻出)。また LO=0.40 だと振り続ける間
    arm が 0 から戻れない区間ができ、復帰タイミングで BEAT がバースト
    する症状もあった。
    新ロジック:
    - Calibrating 完了時に重力方向の単位ベクトル sGravityUnit を確定
    - dynAlongG = dynAcc・gravityUnit が大きく負 (= 重力と逆向きの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
2026-05-02 [修正] node_01 Conducting 遷移直後に余分な BEAT が 1 発出る問題
    Calibrating 中にユーザーが動かしていると LPF 内部に動きの余韻が残った
    状態で Conducting に遷移し、直後の dynAcc が大きく負方向に振れて
    arm=true から即発火していた。
    Conducting 遷移時に sBeatArmed=false にリセットし、|alongG| が LO 未満に
    戻る (= 一度静止状態に落ち着く) まで発火しないようにする。
    [applyPattern.cpp]
2026-05-02 [改善] orchestra_player のデフォルトモードを SERIAL に変更
    UNO を接続して起動しても 's' を押すまで NotePacket が無視される (LOOP モード中
    は受信した NoteOn を破棄する) ため、本番動作の SERIAL モードを既定にする。LOOP
    は 'l' で明示的に入るオフライン確認用に格下げ。起動メッセージとヘッダコメントも
    整合させた。
2026-05-02 [改善] node_02 楽譜進行を「1振り=1拍」に厳密化、8分音符の半拍後予約発火を追加
    問題: 旧実装は kScore[].beatAt が 0 始まりかつ applyPattern が
    while (beatAt <= effective) で消化していたため、最初の振り (beatNo=1) で
    kScore[0] と kScore[1] が同時発火し「ドレ」が一発で鳴ってしまっていた。
    また 4 分 BEAT に対して半拍後を発火する手段が無く、8 分音符を表現できなかった。
    修正:
    - score_data.cpp の beatAt を全行 +1 して 1 始まりに揃え、最初の振りで kScore[0]
    だけが発火するようにした (startBeatNo=0 を維持)
    - applyPattern の発火条件を while (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
    [SystemData.h, applyPattern.cpp, score_data.cpp, score_data.h]
2026-05-02 [修正] node_01 拍検出を 26b22b6 時点 (動加速度ノルム > 1.20g) に戻す
    直近 3 コミット (5b91fc0 ヒステリシス付きエッジ → ad5d09d 重力方向射影 →
    d8fefab Conducting 遷移直後の余分 BEAT 抑止) で導入したロジックは、実機での
    体感が悪化していた (検出が安定しない)。26b22b6 時点の純粋なノルム比較は
    良好に検出できていたとのユーザー報告に基づき、検出関連の 4 ファイル
    (applyPattern.cpp, ProjectConfig.h, SystemData.h, main.cpp) を 26b22b6 の
    内容に戻す。
    戻る挙動:
    - BEAT_DYN_THRESHOLD_G = 1.20g 単一閾値 (HI/LO のヒステリシスなし)
    - 動加速度ノル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
    [ProjectConfig.h, SystemData.h, applyPattern.cpp, main.cpp]
2026-05-02 [修正] node_01 拍検出を 1beb21a 時点 (動加速度ノルム > 1.20g) に戻す
    直近 3 コミット (9439144 ヒステリシス付きエッジ → 83e876c 重力方向射影 →
    d3b788a Conducting 遷移直後の余分 BEAT 抑止) で導入したロジックは、実機での
    体感が悪化していた (検出が安定しない)。1beb21a 時点の純粋なノルム比較は
    (applyPattern.cpp, ProjectConfig.h, SystemData.h, main.cpp) を 1beb21a の
    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
    [ProjectConfig.h, SystemData.h, applyPattern.cpp, main.cpp]
2026-05-02 [改善] node_02→Processing 通信を「高さ+長さ」単発パケットに変更、NoteOff 撤廃
    旧実装は NoteOn / NoteOff の 2 パケットを 1 音ごとに Serial に流していた。
    NoteOff の到着遅延や順序入れ替わりで Processing 側の発音が崩れていたとの体感
    報告を受け、Arduino 側は NoteOn (gate=1) を 1 パケット送るだけにし、その中の
    durationMs を見て Processing が自動消音するモデルに変更する。
    node_02:
    - NoteOutData.pendingOff、ScoreProgressData.noteIsSounding / noteOffAtMs を削除
    - NoteSenderModule から NoteOff 送信パスを削除 (NoteOn のみ)
    - applyPattern の NoteOff 判定セクション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
2026-05-02 [改善] node_02 楽譜進行を純粋 index 駆動化、楽譜を「ドレミファミレド」7音ループに縮小
    楽譜進行が体感的にズレている報告に対し、構造をシンプルにして「BEAT 1 個 =
    currentEventIndex を 1 個進める」純粋イベント駆動に整理する。
    applyPattern.cpp:
    - 旧: while (kScore[idx].beatAt == effective) で beatAt と effective を一致させる
    方式 → 拍欠けや暴発時に空振り / 飛び越しが起きやすい
    - 新: BEAT 受信時に kScore[currentEventIndex] を 1 個発火して index を 1 進める
    だけ。末尾まで来たら 0 に戻ってループ再生する。
    - ScoreEvent.beatAt は読みやす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
2026-05-02 [修正] node_02 BEAT を即発火・sync 依存撤廃 (鳴らない/音飛ぶ症状の対策)
    「36 以降鳴らない・音飛ぶ・1 振りで 2 回鳴る」の症状に対し、playAtMasterMs
    ベースの待機判定が破棄ロジックを誤発動して BEAT を無音で捨てている可能性が
    高いと判断し、receiver の純粋イベント駆動に切り替える。
    - 発音判定: pending.valid が true なら無条件で fired = true。
    旧実装の masterNow vs playAt 比較 + grace 100ms チェックを撤廃。
    sync.offsetMs のジッタや applyPattern ループ周期 5ms との相互作用で
    diff > grace となり破棄されていた BEAT が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
    [applyPattern.cpp]
2026-05-03 [修正] node_02 をマスタ時刻スケジュール発火に戻し、複数スレーブ間で発音同期するよう改修
    旧版は BEAT を即発火していたため、スレーブが増えると受信ジッタぶん発音タイミングが
    ズレていた。targetLocalMs = playAtMasterMs - sync.offsetMs を計算してその時刻に
    発火する本来の同期設計に戻す。期限切れは捨てずに即発火フォールバックすることで
    旧スケジュール版で出ていた「鳴らない」症状を防ぐ。
    README の Playing 遷移条件と進行則の説明も実装と整合させた。
    [applyPattern.cpp]
2026-05-03 [機能追加] 楽器ノード node_03 (金管 2) と node_04 (木管 1) を追加
    node_02 をテンプレに、partId と楽譜だけを差し替えた。
    - node_03: partId=0x03、ミファソラソファミ (E4 F4 G4 A4 G4 F4 E4)、node_02 の 3 度上
    - node_04: partId=0x04、ソラシドシラソ (G4 A4 B4 C5 B4 A4 G4)、node_02 の 5 度上
    3 台同期できていれば各拍で C major 圏内の和音 (C/Dm/Em/F/Em/Dm/C) が鳴り、
    ズレているとアルペジオ的に聞こえるので耳での同期確認に使える。
    firmware/test/README に 03/04 の起動順とビルドコマンドを追記、Playing 遷移条件も
    sync.converged 待ちを行わない現実装に合わせ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
2026-05-03 [改善] orchestra_player に partId 表示を追加、1 楽器=1 Mac 運用を README で明示
    複数の楽器ノード (node_02/03/04) を試したときに、Mac に繋いでいるのがどの楽器か
    画面で分かるよう lastPartId を追加して "Last partId: 0xXX" を draw に表示。
    NotePacket の構造変更はしておらず、partId 違いのノードはコード変更なしで動く。
    LOOP_PART_ID コメントと pc_app/test/README にも、1 楽器 = 1 Mac 構成と
    SERIAL_PORT_NAME 優先のポート選択運用を明記した。
2026-05-03 [修正] node_01 LED が active LOW で逆動作していた問題を修正
    XIAO ESP32-S3 の User LED (GPIO21) は LOW で点灯する仕様で、HIGH=点灯前提だった
    StatusLedModule では Conducting 時 (solidOn=true → digitalWrite HIGH) に LED が
    消灯する逆動作になっていた。「LED が点滅していない」という現象の原因。
    StatusLedConfig に activeLow フィールドを追加し、StatusLedModule で onLevel/offLevel
    を切り替えるようにする。node_01 (XIAO ESP32-S3) は activeLow=true、node_02-04
    (UNO R4 WiFi) は activeLow=false を ProjectConfig.h で明示する。
    [ProjectConfig.h]
2026-05-03 [改善] orchestra_player をポリフォニック化、Voice 数上限ガードも追加
    triggerNoteOn 冒頭の silenceAllOnPart 呼び出しを撤廃し、前の音を止めずに重ねて
    鳴らすよう変更。activeVoices を HashMap (partId+note キー) から ArrayList に
    切り替え、同一 partId+note の重複発音にも対応する。Minim の AudioOutput への
    patch 数が増えすぎると不安定になるリスクに備え、MAX_POLYPHONY=16 で上限を設け
    超えたら最古の active を強制 release する。Voice クラスは triggerNoteOff の
    検索のため partId / noteNumber を保持するように。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
2026-05-03 [修正] node_02/03/04 の SERIAL_DEBUG=1 ビルドが通らない問題を修正 (削除済 noteIsSounding 参照)
    f040573 で ScoreProgressData.noteIsSounding を削除したが、main.cpp の dumpPeriodic
    に snd=%d / d.score.noteIsSounding 参照が残っていた。SERIAL_DEBUG=0 ではマクロが
    空展開でビルドが通っていたため見逃されていた。SERIAL_DEBUG=1 ビルドで初めて顕在化。
    3 ノード分の dumpPeriodic から snd 関連を削除する。
    [main.cpp]
2026-05-03 [修正] node_02/03/04 の SERIAL_DEBUG=1 ビルドが通らない問題を修正 (削除済 noteIsSounding 参照)
    361880a で ScoreProgressData.noteIsSounding を削除したが、main.cpp の dumpPeriodic
    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
    [main.cpp]
2026-05-03 [修正] orchestra_player の serialEvent と draw のスレッド競合を解消
    旧版は serialEvent (Serial スレッド) から triggerNoteOn → activeVoices.add を
    直接呼び、同時に draw (Animation スレッド) で activeVoices.iterator() を
    回していたため、ConcurrentModificationException が握り潰されて serialEvent が
    止まる症状があった。Arduino 側では NotePacket を出し続けているのに Processing で
    途中から鳴らなくなる現象 (34 個目あたりで停止) の原因と推定。
    serialEvent では受信パケットを ConcurrentLinkedQueue に積むだけにし、draw() の
    冒頭で drainPackets() が消化する形にして Voi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
2026-05-03 [改善] node_01 拍検出に経路長 (10 cm) ゲートを追加
    dynNorm > 1.2g の単発判定だけだと細かい揺れで誤検出するため、
    動加速度を二重積分した経路長 sPathLen が 0.10 m 以上動いた場合
    のみ拍として採用する AND 条件を追加。静止 100 ms 継続で速度を
    ゼロリセットするドリフト対策 (ZUPT) も同梱。
2026-05-03 [修正] node_01 拍検出が早すぎ問題: ゲート式ステートマシンに作り直し
    旧ロジックは 2 つ破綻:
    (1) sPathLen は |v| の積分で常時単調増加。MPU6050 のノイズで起動から
    数秒で 10cm を超え、AND ゲートが事実上無効化されていた。
    (2) 判定が「dynNorm > 1.2g の瞬間」= 振り下ろし開始直後に出ていた。
    ユーザーの感じる拍 (= 振り下ろし切った瞬間) より早く鳴っていた。
    新ロジック (Idle / Armed の 2 ステート):
    - Idle: 積分しない (ノイズ蓄積ゼロ)
    - dynNorm > 1.2g で Armed に突入。Armed 中だけ dynAcc を積分し sPathLen 更新
    - dyn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
    [ProjectConfig.h, applyPattern.cpp]
2026-05-03 [修正] 連続スイングで拍が出ない問題: リリース判定をピーク相対 + timeout 採用に
    旧ロジックは絶対値リリース (dynNorm < 0.20g) のみで、振り下ろし→振り上げ
    を続けると dynNorm が 0.20g を一度も切らず、Armed のまま 800ms timeout
    で released=false 扱いとなり拍が出ない不具合があった。
    - リリースを (a) 絶対値 < 0.20g OR (b) Armed 中 peak の 40% 未満 で判定
    (b) を入れたことでピーク 1.5g なら 0.6g 切りでリリース成立し、連続
    スイングでも振り終わりが拾える。
    - timeout でも path/refractory を満たせば拍として採用 (取りこ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
    [ProjectConfig.h, SystemData.h, applyPattern.cpp, main.cpp]
2026-05-03 [改善] node_01 拍検出: ARM_END サマリログを追加し path 閾値を 5cm に下げ
    実機ログ分析:
    Armed 突入 (gate=A) は加速度 1.8〜3.3g で頻繁に成立しているのに、
    200ms 周期 dump では path=0.000 しか見えず採用ゼロ。
    Armed の継続時間が dump 周期より短いため積分量が不可視で、
    10cm 閾値に届いているか実測できない状態だった。
    - Armed -> Idle 遷移時に [N1 ARM_END dur=N peak=N path=N reason=X adopt=Y/N]
    を 1 振りごとに 1 行で出力。ピーク値・経路長・継続時間・リリース理由
    (abs/ratio/timeout)・採用可否を可視化してチューニング可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
    [ProjectConfig.h, applyPattern.cpp]
2026-05-03 [修正] node_01 拍検出: ログ切れと Armed 早期リリースの 2 件を修正
    実機ログから 2 つの根本原因が判明。
    (1) DBG_PRINTF のバッファ不足でログが切れていた
    node_01 の dump 行は ~175 文字あるが SerialDebug の buf[160] で
    打ち切られ、末尾の "]\n" が出ず次の行と連結。結果、ARM_END ログも
    視認できない状態だった。buf を 256 に拡張してすべての行が改行付で
    出るようにした (node_02/03/04 のビルドにも影響なし)。
    (2) Armed が早すぎるリリースで終わり経路長が積み上がらない
    リリース判定 (dynNorm < peak * 0.40) が振り下ろし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
    [applyPattern.cpp]
2026-05-03 [修正] node_01 拍検出: imu.ready=false で Armed が毎ループ潰されるバグを修正
    実機ログ分析で gate=A->I の遷移は dump で見えるのに ARM_END ログが
    1 行も出ない現象を発見。原因は Conducting 中のステートマシンの else
    ブランチで、imu.ready=false のループでも gateToIdle() を呼んでいたこと。
    ImuModule は 5ms 周期サンプルなので loop の大半は ready=false で通過
    する。そのたびに Armed が無音で Idle に戻され、積分が走り出す前に
    毎回リセットされていた。結果:
    - ARM_END が出ない (released/timeout 経由じゃないため)
    - path が積み上がらない (常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
    [applyPattern.cpp]
2026-05-03 [改善] node_01 拍検出: path 閾値を実機実態に合わせ 5cm -> 30cm
    実機ログ (4/4 拍子 × 4 セット = 16 拍想定) で 17 拍検出 (+1 誤差)
    の動作を確認。ARM_END/EVT BEAT は意図通りに発火している。
    ただし path 値は二重積分のドリフトと |v| 単調増加で物理的な距離
    ではなく、本振り 1 回で 2.4〜4.5 m 規模まで膨らむ実態が判明した。
    旧閾値 5 cm では本振り全部が余裕で超え、AND ゲートとして実質
    無効化されていた (refractory だけで二重発火を抑止していた)。
    実機データ:
    - 本振り: path = 2.4 m 〜 4.5 m
    - 振り戻し / ノイズ: path < 0.1 m
    両者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
2026-05-03 [改善] node_01 拍検出: 振り終わり発火 -> 振り始め早期発火に変更
    ユーザーから「振り終わりで発火だと体感的に遅い、振り始めで音が鳴る方が
    合う」とのフィードバック。発火タイミングを変更。
    旧設計: Armed -> リリースエッジで発火 (振り終わり = 振り始めから 500-800 ms)
    新設計: Armed 中、sPathLen が BEAT_FIRE_PATH_M (0.10 m) に達した瞬間に
    発火 (振り始めから ~100 ms)。Armed セッション中は再発火しない。
    リリース判定はそのまま残し、発火とは独立に Idle 復帰だけを担当。
    リリース条件にも pathOk を AND することで、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
2026-05-03 [改善] node_01 拍検出: 軽い振れの誤発火と 1 振り 2 拍の重複を抑制
    実機フィードバック「軽い振れで早期発火する」「1 振り = 1 拍が崩れる」
    の 2 件に対応。
    (1) 早期発火が緩すぎる
    BEAT_FIRE_PATH_M 0.10 -> 0.20。peak 1.3 g 程度の軽いピークでも
    100 ms 程度で 0.10 m に蓄積して発火していたのを、本振りでないと
    到達しない 0.20 m まで引き上げ。発火タイミングは Armed 突入から
    ~150 ms とまだ十分早い (振り下ろしの最中で発火 = 体感同期)。
    (2) 1 振りで 2 拍出る
    旧設計は「発火後も Armed 維持、リリースで Idle」だったため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
2026-05-03 [修正] node_01 拍検出: 連続スイング時の自動 2 倍検出を解消
    前回の「発火→即 Idle」変更が裏目に出て、連続スイング中に
    「発火→即 Idle→次サンプルで dyn>1.20g なので即 Arm→refractory 経過と
    ともに path 再到達→発火」のループで refractory 境界 (350ms) ごとに自動
    発火する状態になっていた (16 拍想定で 32 拍検出, dur=345 が並ぶ)。
    修正: 発火後も Armed を維持し、Armed 脱出はリリース or timeout のみに
    する。1 Armed セッション = 最大 1 発火。再 Arm は前のセッションが完全に
    終わってから (= 一度ピークアウト or 動作停止して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
    [ProjectConfig.h, applyPattern.cpp]
2026-05-04 PIO設定
2026-05-07 [修正] node_01 拍検出: リリース判定にデバウンスを追加し振り途中の連発を抑制
    振り中にピークが大きくなると dynNorm が一瞬 peak*RATIO を割るだけで
    Armed を抜け、再 Armed→再発火するチャタリングが起きていた。リリース
    条件 (releaseAbs || releaseRatio) が連続して BEAT_RELEASE_HOLD_MS=40ms
    成立した場合のみ Armed を解除するよう変更。350ms 時間 refractory と
    800ms 保険タイムアウトはそのまま維持。
    [ProjectConfig.h, applyPattern.cpp]
2026-05-07 [ドキュメント] 仕様書を 0.2 版に改訂 (テスト実装に基づく)
    work/shiozawa/work-0513/提出用計画書/ に修正版を作成。0.1 のたたき台仕様
    を実装で確かめた結果、以下を確定または変更したことを反映。
    - MOP-1 同期誤差を 30ms → 20ms に修正 (ADR-0006 と整合)
    - 拍検出を「動加速度ノルム + 経路長ゲート + デバウンスリリース」の
    ステートマシンに刷新 (path 0.20m 早期発火 + refractory 350ms)
    - 楽器側状態遷移を SelfRun 撤廃 + 純粋 index 駆動の 3 状態に簡素化
    - NoteOff を Processing 側で durationMs から自動消音する方式に変更
    - 部品をテスト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
2026-05-07 [ドキュメント] firmware README を実装と仕様書 0.2 版に整合
    - firmware/README.md の MOP-1 同期誤差を 30ms → 20ms に修正
    (ADR-0006 / 仕様書 0.2 と一致)
    - firmware/README.md の役割分担表で node_03 / node_04 を「未実装」から
    「Arduino UNO R4 WiFi」に更新し、テスト実装の startBeatNo 全 0 構成と
    「3 度・5 度の和音で同期検証」の意図を明記
    - firmware/test/node_01/README.md の拍検出説明を path-based 早期発火 +
    デバウンスリリースの実装に書き直し (旧 1.20g + refractory 250ms から)
2026-05-07 [リファクタ] テスト実装のデッドコード除去と score_data の集成体初期化を明示
    仕様書 0.2 で撤廃したフィールド・未使用変数を物理的に削除し、コンパイラ
    警告対象の暗黙ゼロ初期化も明示形に揃える。動作変更なし、4 ノード全部
    PIO ビルド成功を確認済み。
    - OrcReceiverConfig::expiredGraceMs (node_02-04) を削除
    (Version 0.2 で「過去 BEAT も即発火」方針に変えたため未使用)
    - ReceiverLogicData::firedThisCycle (node_02-04) を削除 (どこからも参照なし)
    - ScoreProgressData::lastFiredEffectiveBeat (node_02-04) を削除
    (currentEventIndex 駆動化で不要)
    - main.cp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
2026-05-10 [修正] node_01 キャリブレーション: 軸別重力ベクトル補正をやめ静止ノルム差方式へ
    水平で校正してから 90 度傾けて振ると残留重力で dynNorm が常に閾値を超え、
    拍が送信され続ける不具合の解消。Calibrating では生加速度ノルムを平均して
    姿勢非依存のスカラー「静止ノルム ≒ 1g」を保持し、dynNorm = accNorm − 静止
    ノルム (0 クランプ) で判定する。dynAcc は accLpf の向きを保ったまま大きさを
    dynNorm にスケールしたベクトルとし、経路長の二重積分入力に使う。
    注意: ノルム差なので重力直交方向の振りは過小評価される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
    [ProjectConfig.h, SystemData.h, applyPattern.cpp, main.cpp]
2026-05-10 [機能追加] sound_lab: 楽器音の解析→定義(JSON)→Processing 再合成 一式
    楽器の単音を Python(librosa) で解析し ADSR・倍音列・倍音ごとの時間変化・
    非調和性・残差ノイズ・単一周期波形を抽出 → インストゥルメント定義 JSON を出力する
    解析ツール(Flask バックエンド + HTML フロント、ブラウザ内試聴つき)と、その JSON を
    読み込み加算合成+整形ノイズ+時間ワープした振幅エンベロープで鳴らす Processing スケッチ
    (Minim、鍵盤 UI つき、起動確認用サンプル example_organ.json 同梱)を追加。
    フォーマット仕様は sound_lab/library_format.md。roo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
2026-05-10 [改善] sound_lab analyzer: ワンクリック起動スクリプトとサーバ未起動時の案内を追加
    ブラウザの HTML からは Python サーバを起動できないため、macOS でダブルクリックすれば
    venv 自動作成→依存インストール→サーバ起動→ブラウザを開く start.command を追加。
    app.py は起動時にブラウザを自動で開くようにし、HTML 側は fetch 失敗時(= サーバ未起動 /
    file:// で開いた場合)に原因と起動手順を表示するようにした。
    .gitignore は data/ 配下の解析結果 JSON(example_organ.json 以外)を除外するよう拡張。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
2026-05-10 [機能追加] instrument_player: data/ の *.json を一覧表示し起動後に切替可能に
    data/ フォルダ内の *.json をすべてスキャンし、画面下の一覧をクリック(または '[' / ']'
    キー)で音色を切り替えられるようにした。'r' で data/ 再スキャン＋現在のファイル再読込、
    'o' で data/ 外の JSON 選択。起動時の優先順位は instrument.json → example_organ.json →
    名前順先頭。ウィンドウを 960x620 に拡大して一覧パネルを追加。関連 README も更新。
2026-05-10 [改善] 解析: 先頭/末尾の無音を積極的に自動トリム + アタック検出を堅牢化
    librosa.effects.trim(top_db=45) では録音のルームトーンや準備音が無音扱いされず残り、
    末尾の有効区間がそこまで伸びて ADSR・ループ区間・リリースが大きくズレていた。RMS 閾値ベースの
    自前トリムに置換: 先頭はピーク RMS から -20dB 未満、末尾は -50dB 未満をカット(立ち上がり手前
    20ms・末尾 80ms は余白)。あわせて ADSR のアタックを「ピーク到達まで」→「ピークの 85% に最初に
    到達するまで」に変更し、本体に強弱の揺らぎがある音(最大瞬間が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
2026-05-10 [機能追加] instrument_player: ゲート方式(押している間 鳴る/離すとリリース)に変更 + きらきら星 再生ボタン
    固定発音長をやめ、鍵(または鍵盤クリック)を押している間ずっと鳴り続け、離すと release_sec
    かけてリリース((1-u)^2 減衰)するゲートモデルに作り替えた。持続音は押している間ループ区間で
    サステインを保持、減衰音は自然に鳴り切り途中で離せばその時点からリリース。複数同時押し対応。
    オクターブ変更時は押しっぱなしの鍵を自動で離す。発音長スライダーは廃止し、その場所に
    「▶ きらきら星(ドドソソ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
2026-05-11 [機能追加] 解析: ビブラート/トレモロ検出と f0 ピッチトラック (modulation)
    f0 トラックと振幅エンベロープの周期成分から ビブラート/トレモロ を推定し
    instrument 定義に modulation フィールドとして格納。描画用に f0(セント差)
    トラックも preview に追加。
2026-05-11 [機能追加] instrument_player: modulation(ビブラート/トレモロ)を反映
    JSON に modulation があれば、各倍音の周波数に
    2^((depth_cents/2)·gate(t)·sin(2π·rate·t)/1200)、最終振幅に
    1-depth/2 + (depth/2)·sin(2π·rate·t) を掛けて鳴らす。古い JSON や fx 欄は無視。
2026-05-11 [機能追加] sound_lab: 解析後に鳴らしながら音色を作り込む編集スタジオ
    ブラウザの試聴を本格的な編集スタジオに刷新。Web Audio のリアルタイム再合成
    エンジン(engine.js)+ UI(app.js)+ スタイル(studio.css)に分割し、index.html は
    ページ枠 + 重要スタイルのみに。
    主な機能:
    - 鍵盤/PCキーを押している間鳴る + 「鳴らしっぱなし」ドローンで両手フリー編集
    - ピッチ&ビブラート(速さ/全幅/開始遅れ/波形)・トレモロ — 検出値が初期値に入り
    0 で消す/上げて強める/フラットな音にも付与
    - 倍音/音色: 明るさ(傾き)・倍音の落ち・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
2026-05-11 [改善] orchestra_player: シリアルポートを起動後にクリックで選ばせる
    直打ちの SERIAL_PORT_NAME / SERIAL_PORT_INDEX を廃止し、
    起動直後に「ポート選択画面」を表示してクリックで接続する方式に変更。
    - refreshPorts() / openPort() / closePort() を分離
    - drawPortSelector() でポート一覧をボタン状に描画 (hover ハイライト付き)
    - mousePressed() でクリック判定 → 該当ポートを接続
    - キー 'r': 一覧を再列挙して選択画面に戻る (USB を後から挿したとき用)
    - キー 'd': 切断して選択画面に戻る (別ポートに繋ぎ直すとき用)
    - キー 'l' は LOOP モードへ移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
2026-05-11 [修正] orchestra_player: 日本語フォントを動的ロードして文字化けを解消
    Processing のデフォルト sans フォントは CJK を持たないため、選択画面の
    日本語表示や罫線文字が tofu (□) になっていた。
    - loadJapaneseFont() を追加: PFont.list() から Hiragino / Yu Gothic /
    Meiryo / Noto Sans CJK JP の順に存在するものを探して createFont() する
    (smooth=true で要求文字を Java Font から都度描画させる)
    - setup() でロードして textFont() に登録 → 以降の text() 全体に適用
    - 見出しの罫線 (U+2500) を ASCII の "==" に置き換え
2026-05-11 [リファクタ] firmware/test・pc_app/test を test_v1 にリネーム
    test_v2 (きらきら星の輪唱版) を別ディレクトリで追加するための前準備。
    中身は無変更で、ディレクトリ名の変更とそれに伴うパス参照 (ビルドコメント・
    README 内のパス) を test_v1 に揃えただけ。.vscode/c_cpp_properties.json /
    launch.json は従来どおり追跡を維持 (各ノードの .gitignore で無視対象だが
    既存追跡分はそのまま残す)。
2026-05-11 [機能追加] test_v2: きらきら星の輪唱・楽器番号付き NOTE・加算合成 PC アプリ
    firmware/test_v2/ と pc_app/test_v2/ を新規追加。指揮者 1 + 楽器 3 の構成は
    test_v1 を踏襲しつつ次の点を変更:
    - 楽譜「きらきら星」全曲を Arduino に内蔵 (node_02/03/04 で同一の score_data.cpp)。
    3 声部を 8 拍ずつずらして輪唱 (カノン)。各ノードの headRestBeats (ProjectConfig.h) で
    頭の休符ぶんずらして入る (node_02=0 / node_03=8 / node_04=16 拍)
    - NOTE パケットに instrumentId (楽器番号) を追加 (旧 reserved[0])。各ノードが固定で送り
    (node_02=0 / node_03=1 / node_04=2)、PC 側はこ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
2026-05-11 [ドキュメント] Git ワークフロー: 基本 main 直マージ・PR は作業完了時のみ
    - このリポジトリは原則 main に直接コミット/プッシュ。ブランチは大規模変更/衝突予想/
    レビュー希望のときだけ。ブランチを切っても基本は直マージで OK
    - PR は会話の途中で勝手に作らない。そのブランチの作業を全部やり切って次に移る段階で
    初めて PR 作成 or 直マージする
2026-05-11 [ドキュメント] work-0513 計画書: テスト実装(test_v1)との整合・参考文献修正・改訂履歴削除・体裁をモノクロ化
    - firmware/test → firmware/test_v1 のリネームに追従し、拍検出の重力補正を「静止ノルム差方式」(コミット ff9dbc9)に合わせて修正
    - ファイル構成図に common/lib の StatusLedModule・SerialDebug を反映、SERIAL_DEBUG ビルドフラグの記述を実装に整合
    - 壊れていた参考文献(遠隔同時音楽演奏の IPSJ 直リンク)を、誰でも閲覧可能な公開論文(教育情報研究 2011「研究開発用ネットワークを利活用した遠隔合唱実験」)に差し替え
    - MOP-1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
2026-05-11 [ドキュメント] work-0513 計画書: テスト実装(test_v1)との整合・参考文献修正・改訂履歴削除・体裁をモノクロ化
    - firmware/test → firmware/test_v1 のリネームに追従し、拍検出の重力補正を「静止ノルム差方式」(コミット 0ab9f9c)に合わせて修正
    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
2026-05-12 [ドキュメント] ADR-0006: 20ms の根拠を「2音分離閾値」から河瀬2014の「数10ms」に基づく説明へ修正
    work-0513 計画書 (MOP-1) と一貫させる。「20ms = 2音を分離して認識する閾値」は
    音響心理学的に不正確（その帯域はむしろ融合する）なため、合奏タイミング知覚研究の
    「数10ms程度なら知覚されない」を主根拠に据え、20ms はその安全側として置いた値と明示する。
2026-05-12 [ドキュメント] 提出用計画書: MOP/MOE/TPM・参考文献を本文から除去し退避メモへ
    提出課題テンプレート（work/shiozawa/計画書テンプレート/）の基本設計・詳細設計
    の章には MOP/MOE/TPM・参考文献の枠がないため、本文から外す。削除した内容
    （MOP 一覧表・各 MOP 目標値の根拠・参考文献）は work/shiozawa/work-0513/
    MOPと参考文献メモ.md に退避し、後で復元できる形で残す。テスト設計の節は
    テンプレートにある「テストの設計」なので維持し、MOP/TPM ラベルを外して
    目標値を素の数値で記載、要求→検証表からも「関連 MOP」列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
2026-05-12 [ドキュメント] 提出用計画書のレビューメモを追加（設計の不安要素・不整合・要検証点のチェックリスト）
    別セッションで項目ごとに対応していくための一覧。test_v1/test_v2 の取り違え、同期方式の限界、API 名・経路説明の事実誤認、スケジュール欠落などを整理。
2026-05-12 [ドキュメント] 提出用計画書: テスト実装への言及を除去・事実誤認を修正・設計の限界を明記（レビュー対応）
    REVIEW_plan_template.md の指摘に対応。
    - test_v1/test_v2 等テスト実装への言及・Version 0.1/0.2 表記・SelfRun 概念を全削除し、設計を現在形で記述。tested-values 節を削除、拍検出ステートマシン詳細・LOGIC_PARAMS 表・tbd 表を圧縮。
    - 不正確/未確認の技術記述を修正: WiFi.beginAP()→softAP()、UNO R4 WiFi 内部「SPIブリッジ」→UART、「WiFiS3 が AT bridge 経由」削除、視聴覚同時知覚閾「80ms」削除、「type でペイロード長判定」→「mag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
2026-05-12 [ドキュメント] 提出用計画書: ハードウェア設計の「物理配置」サブセクションを削除
    会場での扇形配置・治具などの記述を本書から除く（チーム全体側の担当範囲）。
2026-05-12 [ドキュメント] 提出用計画書の最終チェックレビューを追加（テンプレート未準拠・設計の残存課題）
    配布テンプレ・test_v2・第1回レビューと照合した第2回レビュー。
    最大の問題はテンプレートの「プロジェクトの計画書」章（目的/スコープ/WBS/
    ガント/MOE・MOP・TPM/資源調達/リスク）が欠落していること。設計面では
    楽譜進行が純カウント駆動で BEAT 1個落ちで永久ズレ・test_v2 と乖離など。
2026-05-12 [ドキュメント] 提出用計画書レビュー: 提出スコープ（基本設計・詳細設計のみ）に合わせて整理し直し
    計画書章の欠落・試作テスト記述の欠落・test_v2 との乖離は提出範囲外/方針通り
    なので取り下げ、設計の中身の論点（楽譜進行の純カウント駆動・同期方式の条件・
    内部不整合・WiFiS3 省電力 OFF 等）と「§2.5 をどう扱うか／要求・数値目標を
    基本設計の要件として書くべき」に絞った。
2026-05-12 提出用設計書とプログラム
2026-05-12 [ドキュメント] 提出用計画書: 本文を提出スコープに合わせて整理し目次が出るよう再コンパイル
    要求一覧表の追加・テスト章の再構成・スコープ説明への楽譜エディタ追記など本文を整理。
    補助ファイル欠落で目次が空のまま出力されていたため latexmk で再コンパイルし PDF を更新。
2026-05-13 [ドキュメント] プロジェクト題名の日本語候補リストを追加
    「エアタクト」を本命に、カタカナ造語/漢字熟語/和語フレーズ系の対案を整理。
2026-05-13 [ドキュメント] 新しいテストファイルを追加
2026-05-13 [設定] シリアルデバッグ出力を無効化
2026-05-13 [追加] rinkファイルを新規作成.パワポのリンクがこれなので，編集できなかったらいって
2026-05-14 [機能追加] AGENTS.md 中心構成へ移行、.agent/ に AI 向け詳細仕様を整備
    グローバル CLAUDE.md の更新（AGENTS.md を主、CLAUDE.md は @AGENTS.md リダイレクト、
    .agent/ に静的仕様と動的作業文脈を分離）に追従。AGENTS.md にプロジェクト概要・技術スタック・
    ディレクトリ規約・コマンド表・組み込み固有ルールを集約し、.agent/ には
    architecture / conventions / api（UDP プロトコル・SystemData・ProjectConfig）と、
    毎ターン更新する activeContext / progress を配置。
2026-05-14 [機能追加] docs/ を Astro Starlight 化、初学者向け解説サイトを整備
    プレゼン本番（2026-07-01 成果発表会）に向けて、チーム外＋初学者でも
    リポジトリ全体を単独で追えるドキュメントサイトを構築。Glass Pastel 彩度系の
    カスタムテーマを採用し、サイドバー 7 セクション 35 ページを整備：
    - はじめに（ようこそ・プロジェクト概要・クイックスタート・用語集）
    - コンセプト（なぜ作るか・シナリオと体験・ゴールとスコープ）
    - アーキテクチャ（全体図・EMA・通信プロトコル・楽譜・同期戦略・三段階開発）
    - 開発ガイ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
2026-05-14 [改善] ルート README / CONTRIBUTING / サブ README を新 docs サイトに整合
    旧 docs/{overview,roles,design,decisions} への直接リンクを廃止し、新 Astro Starlight
    サイトへの誘導とソース参照（docs/src/content/docs/...）に書き換え。
    ルート README には docs サイトの起動コマンドとセクション一覧、AGENTS.md / .agent/ の
    位置づけを追記。CONTRIBUTING.md は冒頭に開発ガイド・コード解説への誘導を追加し、
    本ガイドは Git 特化版として並存。firmware/README, firmware/production/README,
    meetings/README の ADR / decisions 参照も新パスへ。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
2026-05-14 [ドキュメント] .agent/ 作業文脈を最新化（コミットハッシュ反映と次の一手の整理）
2026-05-14 [機能追加] docs サーバー起動用 .command ファイル（macOS ダブルクリック起動）
    cd docs && npm run dev を毎回打つのが手間だったため、docs/start-docs.command を
    追加。Finder でダブルクリックすると初回 npm install を自動で済ませてからサーバーを
    起動し、3 秒後にブラウザで http://localhost:4321 を開く。ルート README にも導線を追記。
2026-05-14 [改善] start-docs.command で Chrome を優先起動するように
    Chrome がインストールされていれば `open -a "Google Chrome"` で確実に Chrome の新規タブで
    サイトを開き、Chrome 不在時はデフォルトブラウザにフォールバック。グローバルテンプレ
    (`~/.claude/templates/astro-starlight-docs/`) と campus-share の共有コピーにも同期済み。
2026-05-14 [スタイル] docs テーマを Glass Pastel から Docs Theme（GitHub Docs 風）に移植
    共有テンプレ astro-starlight-docs-clean を採用し、純白背景 + 濃インク + 青
    アクセント1色の読みやすさ優先スタイルに切替。長文・コード・テーブルが多い
    本サイトでは Glass Pastel の装飾が視覚ノイズになっていた。
    サイドバー定義と本文 md は保護。差し替えは customCss / glass-pastel.css
    → docs-theme.css / favicon のみ。dist と .astro は次回 npm run dev で再生成。
2026-05-14 [スタイル] docs テーマを paper theme（紙質感）に切替
    Docs Theme（GitHub Docs 風）から Paper Theme（紙クリーム背景＋温かい墨インク）へ。
    ドキュメントは「読ませる」のが主目的のため、グローバル方針の paper（既定）に揃える。
2026-05-14 [ドキュメント] サイト題目を「タクトーン」に統一し第 4 回議事録を反映
    第 4 回ミーティング（2026-05-13、`meetings/0513_4回/`）の計画書本文を docs/ に展開。
    - サイトタイトルを「タクトーン」に切替（astro.config.mjs / index.md）。
    サブタイトルで「IMU ジェスチャーで奏でる Arduino オーケストラ」を補足。
    - `intro/overview` `concept/why` `concept/goals` に議事録 9〜10 章の目的・
    課題リスト・対象範囲（10-2-1）・非対象範囲（10-2-2）・成果物（10-1）・
    既存技術との差分（9-3）を反映。
    - `team/schedule` を計画書 11〜13 章で全面書き直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
2026-05-14 [修正] 所属表記の誤記を千葉工業大学 情報変革科学部 情報工学科に統一
    AGENTS.md および docs/ 配下 3 ファイルに残っていた誤記「工学院大学
    情報通信工学科」を、正しい所属「千葉工業大学 情報変革科学部 情報工学科」へ
    一括置換。リポジトリ全体を grep して矛盾箇所をゼロにした。
2026-05-14 [ドキュメント] アルゴリズム詳説章を新規追加し既存ページの実装乖離を修正
    docs/ に新セクション「アルゴリズム詳説」(deep-dive/) を追加し、プログラム系の
    中核ロジックを実コード基準で深掘り解説する 8 ページを新規作成 (合計 1700 行超)。
    拍検出・時刻同期・UDP マルチキャスト・バイナリパケット・楽譜進行・加算合成・
    モジュール拡張をそれぞれ独立した章で展開し、概要→詳説→コード本体の 3 段学習導線を
    形成する。
    同時に既存ドキュメントの実装乖離を最小修正:
    - CTRL の bpmFixed × 256 → bpmQ8 × 8 (OrcProtoco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
2026-05-15 [ドキュメント] ファームウェア モジュール詳説章を新規追加
    アルゴリズム詳説 (deep-dive) とは別軸の「コードファイル 1 つにつき 1 ページ」の
    縦割り解説章を docs/src/content/docs/firmware/ に新設 (12 ページ)。共通 5 モジュール、
    指揮者 2 モジュール、楽器 2 モジュール、main.cpp 2 ノード分の処理フローを実コード
    基準で解説。code/firmware.md から導線、astro.config.mjs にサイドバー登録。
2026-05-15 [ドキュメント] PC アプリ・音声処理章を新規追加（塩澤の実装例として）
    orchestra_resynth.pde と sound_lab/analyzer の実装解剖を 11 ページで深掘り。
    他メンバーが自分の方針で書き直すための判断材料を残すトーンで統一。
2026-05-15 [ドキュメント] 要点ダイジェスト章を新規追加（4 ページの優しい入門）
    詳細群（deep-dive/ firmware/ pc-audio/）が増えすぎて、初学者が
    全体を掴む入り口が無くなった問題への回答。プロジェクト全体・
    ファームウェア・Processing・音声解析を 10〜15 分ずつで読み切れる
    優しい入門 4 本を essentials/ 配下に新設。
2026-05-15 [改善] essentials 4 ページに Mermaid 図解を追加（描画機能込み）
    Starlight は標準で Mermaid をレンダリングしないため、astro.config.mjs の
    head: に CDN から mermaid@11 を読み込み、expressive-code が生成する
    <pre data-language="mermaid"> を .ec-line ベースでテキスト復元しつつ
    <div class="mermaid"> に置換するクライアント側スクリプトを登録。
    essentials の 4 ページに sequenceDiagram / stateDiagram / flowchart を
    合計 24 個追加し、状態遷移・時刻同期・3 スレッド分業・解析パイプライン
    各段を視覚化。既存ページの Mermaid も同スクリプトで描画される。
    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
2026-05-15 仕様書解説
2026-05-17 ディレイ調整
2026-05-17 [ドキュメント] 夜間レビューレポート 2026-05-15
2026-05-17 [修正] essentials/firmware.md の時刻同期説明を実コードに同期
    夜間レビュー 2026-05-15 の指摘 1.8 対応。
    offset の符号と EMA 係数が実コードと食い違っていたのを修正。
    - 符号: doc は offset = local − master、実コードは
    master − local（OrcReceiverModule.cpp:15 の sample = timestampMs − millis()）。
    Mermaid 図と説明文を実コード側に揃え、発音目標時刻の式も
    playAtMasterMs − offsetMs（applyPattern.cpp:138）に修正。
    - EMA 係数: doc は α=0.30、実コードは clockSyncEmaAlpha = 0.10
    （ProjectConfig.h:33）。BPM EMA の 0.30 と取り違えていたのを 0.10 に。
    - deep-dive/time-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
2026-05-17 [ドキュメント] 夜間レビュー 1.1-1.7/1.9 のドキュメント実装乖離を一括修正
    夜間レビュー 2026-05-15 の指摘うち、コード変更を伴わないドキュメント整合
    を一括反映。
    - 1.1 楽器ノード台数: AGENTS.md / .agent/architecture.md / docs を
    「test_v2 は 3 台（node_02〜04）、production 想定は 4 台（node_02〜05）」
    の併記に統一
    - 1.2 音色 JSON 参照パス: sound_lab/data/<id>.json 表記 13 箇所を
    実体 pc_app/test_v2/orchestra_resynth/data/ に修正、sound_lab/ は
    試作・分析の実験場という位置づけを明示
    - 1.3 instrumentId の説明: ファイル名昇順ソートでの index 参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
2026-05-17 [ドキュメント] .agent/ 作業文脈を夜間レビュー対応で最新化
    activeContext は今回の指揮内容（PR #6 マージ + 1.1〜1.9 反映 + 2.x 保留）に
    上書き、progress は 2026-05-17 エントリで時系列追記。
2026-05-18 [ドキュメント] 夜間レビューレポート 2026-05-17
2026-05-18 [ドキュメント] 夜間レビュー 2026-05-17 残存指摘 1.2-1.8 を一括修正
    レビュー bot のスナップショット (1536189) が古く、昨日の修正効果を反映していない
    前提でレポートが書かれていたため、実 grep で残存していた 6 種類の指摘のみ追加対応。
    - 1.2 <id>.json 誤誘導 (note-sender/pc-audio/code/pc-app/essentials の 8 箇所)
    - 1.3 essentials/firmware.md:129 の架空 SystemData 構造体名を実体名に置換
    - 1.4 INSTRUMENT_ID 擬似定数の残存 (deep-dive/architecture の 4 箇所)
    - 1.6 docs 側 bpmQ8 の Q8 固定小数表記を ×8 整数に (3 ファイル 4 箇所)
    - 1.7 essentials/project.md と in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
2026-05-18 [ドキュメント] 夜間レビュー 2026-05-17 残存指摘 1.2-1.8 を一括修正
    レビュー bot のスナップショット (703d30b) が古く、昨日の修正効果を反映していない
    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
2026-05-18 [ドキュメント] .agent/ 作業文脈を夜間レビュー 2026-05-17 対応で最新化
    レビュー bot のスナップショット時点ズレや、昨日の progress.md 記述と実体の
    部分乖離 (1.7 が essentials/project.md と intro/overview.md で未反映だった件)
    を反省点として記録。
2026-05-18 中間発表追加
2026-05-19 [ドキュメント] 夜間レビューレポート 2026-05-18
2026-05-19 [ドキュメント] 夜間レビュー 2026-05-18 指摘 1.1-1.4/1.7/2.1 の残存乖離を一括修正
    - 1.1: .agent/architecture.md の ScoreEvent 構造体を 4 フィールド架空版 →
    実体 9 フィールド (beatAt/noteNumber/velocity/durationQ8/flags/subNote/
    subVelocity/subOffsetQ8/subDurationQ8) に置換、durationQ8 単位と flags
    ビット意味を補足
    - 1.2: .agent/architecture.md と docs/.../architecture/score.md の楽器名
    「金管/木管/弦」を data/*.json 実体 (オルガン/フルート/ベル) に置換、
    「JSON を増やせば対応関係も増える」旨を追記
    - 1.3: orchestra_resynth.pde:39 と pc_app/test_v2/README.md:56 の partId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
    [orchestra_resynth.pde, score_data.cpp]
2026-05-19 [ドキュメント] .agent/ 作業文脈を夜間レビュー 2026-05-18 対応で最新化
2026-05-20 計画書結合用ファイル追加
2026-05-20 [ドキュメント] 結合レポート全面リライトの実行計画を策定
    肥大・図表崩れした結合レポートを 50 ページ以内に再構築するため、
    複数セッション分割の工程表を _作業計画.md として作成。
2026-05-20 [ドキュメント] 個人版計画書 TeX 2 本を計画書結合フォルダへ移動
    中間発表フォルダは再構築する新レポート専用にするため、
    plan_25G1021.tex / plan_25G1053.tex を計画書結合フォルダへ移す。
2026-05-20 [ドキュメント] 結合レポートリライト Phase 0（環境構築・骨格作成）
    draw.io 書き出し環境（brew cask）を構築し、結合元 23_ TeX の
    ベースライン頁数（97 ページ）を計測。新本体 23_計画書・設計書.tex の
    空骨格を作成し latexmk ビルド成功を確認。
2026-05-20 [設定] 結合レポート本体の PDF を追跡対象に追加
    .gitignore の report/**/*.pdf に例外を設け、23_計画書・設計書.pdf を
    .tex と同一コミットで管理する運用に変更（ユーザー指示）。あわせて
    Phase 1〜3 は途中ビルドのページ超過を許容する方針を計画書へ追記。
2026-05-20 [ドキュメント] 結合レポートリライト Phase 1（Chapter 1「計画書」）
    Chapter 1 を全執筆し、FBS/PBS/アローダイアグラム/ガントチャートの
    draw.io 図 4 点を作成。WBS は 51 タスクのツリーが A4 で潰れるため表化。
    参考文献 6 件を追加。ビルド成功・21 ページ・Overfull hbox 0 件。
2026-05-20 [ドキュメント] 結合レポートリライト Phase 2（Chapter 2「システムの基本設計」）
    楽器台数を 4→5 に変更（ユーザー決定）。最終構成＝指揮者1（XIAO）＋楽器5
    （金管4＋ドラム、node_02〜06、partId 0x02-0x06）＋PC5（各楽器に1対1）。
    Ch1 の台数表記5箇所と作業計画§9 を 4→5 に更新。
    Ch2 を全執筆: 機能一覧（要求一覧＋FBS）・システム構成図・操作インター
    フェース・状態遷移図。Block A/B の2版収録を Block B 土台に統合。
    システム構成図を draw.io 新規作成（fig/system-overview）。
    latexmk -lualatex 成功・29ページ・Overfull/Underfull 0件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
2026-05-20 [ドキュメント] 本番想定の楽器台数を 4→5 台に更新（AGENTS.md・architecture.md）
    中間発表計画書（Phase 2）で楽器を5台に確定したため追従。
    production は指揮者1＋楽器5（node_02〜06）の6台構成。
    test_v2 の 3 台記述は実装実態のため不変。
2026-05-20 [ドキュメント] api.md の本番想定 partId 範囲を楽器 5 台（0x02–0x06）へ追従
    本番想定の楽器台数 4→5 確定に伴い、NOTE パケットの partId 範囲を
    production 想定「0x02–0x05（4 台）」→「0x02–0x06（5 台＝金管 4＋ドラム）」へ更新。
    AGENTS.md・architecture.md は更新済みで、api.md が未追従だった。
2026-05-20 [ドキュメント] 結合レポートリライト Phase 3（Chapter 3「システムの詳細設計」）
    Block A/B の 2 版収録を Block B 土台へ統合し、部品一覧／HW 設計／SW 設計／
    処理フロー／テスト設計の 5 節を執筆。apibox 約 15 個・verbatim・lstlisting を
    要点の散文＋小表へ大幅圧縮し、モジュール責務は 1 表に集約。クラス継承図と
    楽器処理フロー図を TikZ で新規作成、HW 接続図は Ch2 と重複のため参照に。
    楽器 5 台・partId 0x02–0x06・node_02〜06 で統一、ScoreEvent は実体準拠 9 フィールド。
    latexmk -lualatex 成功・45 ページ（Ch3≈16）・Overfull/Underful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
2026-05-20 [ドキュメント] ゲームモード追加で結合レポート計画を Phase 4A〜4D へ再分割
    自由演奏に加えゲームモード（モード選択・目標テンポ提示・維持精度の採点）を
    設計へ織り込む新要件に対応。_作業計画.md の §4-2 に設計骨子を記録し，Phase 4 を
    4A〜4D に再分割。あわせて全図 draw.io 化＝TikZ 廃止，ページ上限の 60 未満への
    緩和，前回レビュー指摘 6 件の §9 追記を反映。本体 .tex は未編集。
2026-05-20 [ドキュメント] 結合レポートリライト Phase 4A（ゲーム機能を Ch2・Ch3 へ織り込み）
    自由演奏／ゲームの 2 モード構成を基本設計・詳細設計へ反映。Ch2 に 2 モード宣言・
    要求 R-5/R-6・機能 F7・操作 IF のモード選択／メトロノームガイド・指揮者状態の
    ModeSelect を追加。Ch3 で CTRL 予約 4B を mode/targetBpmQ8/score へ割り当て、
    採点ロジックとメトロノームのフェード制御を新節で記述。状態遷移 2 図を draw.io 化
    （TikZ 2 ブロックを置換）。ビルド成功・45 ページ・警告ゼロ。
2026-05-20 [ドキュメント] 結合レポートリライト Phase 4B（Processing 記述拡充・ゲーム UI 節新設）
    Ch3 §3.3.6 を「PC 側ソフトウェア（Processing）」へ改題・増量し，フレーム同期・
    Serial スレッド分離と受信キュー・Voice 管理・音色合成・JSON 外部化を小節化。
    §3.3.7「画面とゲーム UI の設計」を新設し，Ch2 の PC 状態定義表を 6 状態へ更新。
2026-05-20 [ドキュメント] 結合レポートリライト Phase 4C（Ch1 へのゲーム反映・図の作り直し）
    Ch1（計画書）の目的・成果物・対象範囲・FBS/PBS 説明・FBS↔PBS 対応表・
    リスク管理にゲームモードを反映。WBS に「260 ゲーム機能」行を追加。
    fbs/pbs/arrow/gantt の 4 図を作り直し（ゲーム進行機能群・ゲーム進行モジュール・
    ゲーム画面 UI・260 並行アーク・260 行）。latexmk -lualatex 成功・47 ページ。
2026-05-20 [ドキュメント] 結合レポートリライト Phase 4D（生成 AI 章・TikZ 全廃・整合）
    Ch4「生成 AI の利用」を執筆。残る TikZ 2 図（クラス継承図・楽器処理フロー）を
    draw.io 化し preamble から tikz を除去（全 9 図 draw.io 化完了）。§9 整合
    チェックリストを全消化（同期誤差根拠統一・ref:beat 引用・gate 注記・CPU 時間・
    magic エンディアン・相互参照/用語/数値・ゲーム整合）。47 ページ。
    Phase 0〜4D 完了で結合レポート全面リライトの全工程が完結。
2026-05-21 計画書資料追加
2026-05-21 [ドキュメント] 結合レポート最終チェック着手で activeContext を更新
    元結合版（計画書結合/）を対比材料として LuaLaTeX でコンパイル（99 ページ）
    した状況を記録。最終チェックの対象は新版 47 ページ。
2026-05-21 [ドキュメント] 結合レポート Phase 5 起票（本物画像の差分調査を作業計画へ反映）
    先輩がコミット db16ec0 で本物画像12点を計画書結合/ に追加したのを受け，現行
    draw.io・両版 .tex・参考文献の差分を徹底調査。FBS/PBS が技術版/素朴版の2系統で
    食い違うこと等を確認し，ユーザーが4論点（台数ゲーム・FBS/PBS・参考文献は現行維持，
    状態遷移図のみシーケンス図化）を決定。_作業計画.md に Phase 5 を追記。
2026-05-21 [ドキュメント] 結合レポート Phase 5 起票（本物画像の差分調査を作業計画へ反映）
    先輩がコミット 1c82ffc で本物画像12点を計画書結合/ に追加したのを受け，現行
    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
2026-05-21 [ドキュメント] 結合レポート Phase 5 完了（状態遷移図のシーケンス図化・整合性修正）
    状態遷移図の状態機械図2枚を廃し，システム動作シーケンス図（指揮者・楽器×5・PCの
    4ライフライン，起動からモード選択・演奏・採点・曲終了まで）をdraw.ioで新規作成。
    状態定義表3つは存置。あわせて整合性の中程度3件を修正（Ch1「音量」→「強弱」，
    WBS 240の粒度，クラス図キャプション）。ビルド成功・49ページ・Overfull 0。
2026-05-21 [修正] ガントチャートのバーをアロー図・WBS・授業日程に整合
    ガント図のバー長がアロー図の週数と全タスクで食い違い，クリティカルパスの
    逐次依存も崩れていた（210と220が同時開始など）。アロー図週数・WBS工数・
    授業スケジュールに合わせて13バーを引き直し，クリティカルパスを階段配置にした。
2026-05-21 [ドキュメント] 結合レポート提出前の最終チェックを実施し指摘15件を起票
    本体49ページ・全10図・ファーム実コード・議事録・参考文献を突き合わせ，
    15件の指摘（高3・中6・低6）を抽出。修正対応の工程を _作業計画.md の
    Phase 6 に起票した。
2026-05-21 [修正] 計画書・設計書の本文不整合4件を修正
    提出前の最終チェックで抽出した即修正可の項目を反映。
    - NOTEパケット表に instrumentId 行を追加（本文の音色定義の記述と整合）
    - 強弱制御を「最終ゴール」から「発展目標」へ（要求一覧 R-4 のストレッチ扱いと整合）
    - 対象範囲「振り速度に応じた音量変化」を「振りの大きさに応じた強弱変化」に統一
    - F1 拍検出の「ピーク検出」を「振り下ろしの検出」へ（詳細設計のゲート式記述と整合）
2026-05-21 [修正] 参考文献 ref:douki を河瀬2014に差し替え（同期20msの出典訂正）
    本文「数十ms程度のずれは気づかれない」の出典は，ADR-0006 と
    work/shiozawa/work-0513/MOPと参考文献メモ.md によれば河瀬2014
    （合奏における演奏者間コミュニケーション，心理学評論57(4)）。
    元結合版由来の Barbosa を本来の根拠文献へ差し替え，ADR-0006 が
    定める同期誤差20msの根拠と整合させた。本文・引用キーは不変。
2026-05-21 [ドキュメント] 最終チェック即修正5件の完了を作業履歴に反映
2026-05-21 。を．に変更
2026-05-22 個人ログテンプレート追加
2026-05-22 [修正] 結合レポート最終チェック残件の本体5件を修正
    中④CTRL state を現行ファーム整合で再採番・低⑫楽譜index式を実コード準拠
    beatNo-1-headRestBeats へ・低⑬同期通信／USB Serial／全ノードの表記ゆれ統一
    （fbs・system-overview・class-diagram の3図を再書き出し）・低⑭アロー図に
    410/520を足さず散文で省略注記・低⑮CTRL予約4Bに注記。ビルド53ページ
    （_作業計画.md §7「53〜54頁は許容範囲」内）・Overfull/Underfull 0・未定義参照0。
2026-05-22 [ドキュメント] ADR-0004を楽器5台構成（金管4＋ドラム）に改訂
    Phase2のユーザー決定で楽器5台（金管4＋ドラム・全体6台）に確定したため、
    ADR-0004を現状へ追従。初版（2026-04-15・楽器4台）の決定日・理由は残し、
    タイトル・決定事項・改訂履歴を更新。結合レポートの中⑧指摘に対応。
2026-05-22 [修正] 句点統一(82edb17)の取り込みに伴い計画書PDFを再生成
    rebaseで本体.texがorigin側の句点「。→．」統一とマージされたため、
    PDFを再ビルドして整合。53ページ・Overfull/Underfull 0。
2026-05-22 [修正] 句点統一(19edb91)の取り込みに伴い計画書PDFを再生成
    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
2026-05-22 [ドキュメント] 残2件(高③・中⑨)の齋藤への確認事項を作業計画に具体化
    5.52centの出所(論文値/予備実験値/別資料)とMOE音階指標の測定対象を
    齋藤へ確認するための質問を_作業計画.md §6-6に明文化。回答待ち。
2026-05-22 [修正] 結合レポート最終チェックの残2件（高③・中⑨）を対応し全15件決着
    高③: 出所不明の「平均5.52cent」を、引用論文ref:onkaiの要旨の精度
    「3.6cent未満」に修正（MOE表・単体テストMOP）。
    中⑨: MOE「音階の誤差」の測定方法を明記。合成出力音を録音・周波数分析し、
    楽譜のノート番号が指定する平均律の理論音高との差を測る方式とした。
    ビルド53ページ・Overfull/Underfull 0・未定義参照0。
2026-05-22 [修正] 結合レポート最終チェック第2弾 — 矛盾・自己完結性・細部を是正
    教授がGitHubを見られない前提で本体PDF単体の徹底チェックを実施し，
    重大度別の指摘を修正した．
    矛盾の解消:
    - 独自性をref:chienと一貫させ，分散同期は先行研究にあると認めた上で
    「分散演奏・直感的指揮制御・環境非依存・未経験者参加の一体統合」を
    新規性とする記述へ書き換え
    - 資源計画の「専用ルーター」を削除しSoftAP完結・外部ルーター不要へ
    - 「EMA」の二重定義(アーキ名／指数移動平均)を解消し指数移動平均の
    略称を廃止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
2026-05-25 [ドキュメント] 作業ログ LaTeX テンプレートを追加
    教員配布の「作業ログ.pdf」と同じ章構成・要素・3階層箇条書きを再現する
    LaTeX テンプレート（jsarticle + uplatex + dvipdfmx）を作成。配布原本は
    作業ログ_配布.pdf として併置し、.gitignore に両 PDF の例外を追加。
2026-05-25 [ドキュメント] progress.md に作業ログテンプレ追加を記録
2026-05-25 デバック
2026-05-27 作業ログ
2026-05-27 リネーム
2026-05-27 ちょい修正
2026-05-27 微々微々調整
2026-05-27 微々々々々調整
2026-05-28 [ドキュメント] 夜間レビューレポート 2026-05-19 (#9)
2026-05-28 [ドキュメント] 夜間レビューレポート 2026-05-20 (#10)
    https://claude.ai/code/session_01DZXursJJLowWtSRvBSfy27
2026-05-28 [ドキュメント] 夜間レビューレポート 2026-05-21 (#11)
    https://claude.ai/code/session_01Jyg3bnTivi25T1Moq2EgRd
2026-05-28 [ドキュメント] 夜間レビューレポート 2026-05-22 (#12)
    https://claude.ai/code/session_013YDgZJhz5xaiye1BsnzTjx
2026-05-28 [ドキュメント] 夜間レビューレポート 2026-05-23 (#13)
2026-05-28 [ドキュメント] 夜間レビューレポート 2026-05-24 (#14)
2026-05-28 [ドキュメント] 夜間レビューレポート 2026-05-25 (#15)
2026-05-28 [ドキュメント] 夜間レビューレポート 2026-05-26 (#16)
2026-05-28 [ドキュメント] 夜間レビューレポート 2026-05-27 (#17)
2026-05-28 [修正] 夜間レビュー累積指摘の追従 (2026-05-28) (#18)
    * [ドキュメント] ADR-0004 改訂 (楽器 5 台) を docs/firmware/pc_app コメントへ横展開 (夜間レビュー追従)
    夜間レビュー 2026-05-23〜27 で連続指摘されていた「ADR-0004 が楽器 5 台 (金管 4
    ＋ ドラム 1) に改訂済みなのに docs/firmware の表記が旧 4 台のまま」を一括追従。
    - docs/intro/overview.md: 「現行 4 台 / production 5 台」を「現行楽器 3＋指揮 1
    = 4 台 / production 楽器 5＋指揮 1 = 6 台」表記に統一。3/4 台混在も解消
    - docs/intro/glossary.md: production 想定 partId を 0x02-0x06、4 声 → 5 声
    - docs/architect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
    [orchestra_resynth.pde]
2026-05-29 [ドキュメント] 夜間レビュー 2026-05-28 の docs 整合追従と作業メモ更新 (#20)
    * [ドキュメント] 夜間レビュー 2026-05-28 の用語追従(5.2/1.3/1.4/1.5/2.9)
    ADR-0004 改訂(楽器5台・partId 0x02-0x06)と beatRedundancy=4(暫定)に
    docs を追従。「4声」を「5声(ADR-0004)」へ、BEAT「2連送」を beatRedundancy
    参照の汎用表現(N連送・暫定4)へ、pc-audio の「3〜4声」を「3〜5声(test_v2
    は3声・production は5声目標)」へ修正。orc-sender.md の連送確率計算に、実測
    ロスは時間相関するため4連送と beatGapMs で対処する旨の注釈を追加(1.4)。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
2026-05-29 [ドキュメント] 夜間レビューレポート 2026-05-28 (#19)
2026-05-30 [修正] start-docs.command を空きポート自動検出方式に変更
    4321 決め打ちで別 docs サイト起動中に開けない不具合を修正。
    lsof で空きポートを探し、ブラウザ URL・起動メッセージ・npm run dev に反映。
2026-05-31 UIと作業ログ中途
2026-06-01 [改善] test_v2 低遅延化・パケロス分散・WiFi再join堅牢化 (#21)
    * [ドキュメント] 計画書 0.3: テスト実装との不整合を修正
    work/shiozawa/work-0513 の本番計画書 (plan_template.tex) を firmware/test/・
    pc_app/test/ の実装と突き合わせ、0.2 で残っていた記述の不整合を修正。
    - NoteOutData は pendingOff を持たず pendingOn のみ (0.2 の NoteOff 不送出と整合)
    - 起動時キャリブレーションは軸別重力ベクトル gravityOffset[3] ではなく
    スカラー静止ノルム gravityMag であることを各所に反映し、
    dynNorm = max(0, accNorm - gravityMag) の算出を明記
    - SyncLogicData.converged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
    [ProjectConfig.h, SystemData.h, applyPattern.cpp, main.cpp, orchestra_resynth.pde, score_data.cpp]
2026-06-02 [機能追加] test_v3 ゲームモード（IMUナビ・採点・Processing画面遷移） (#22)
    * [機能追加] test_v3 雛形を test_v2 から複製（ゲームモード実装のベース）
    * [ドキュメント] test_v3 ゲームモード設計メモを作成（Phase 1 残り）
    CTRL予約4B割当(a)・node_01 IMUナビ＋拍検出排他(b)・node_02 UI状態シリアル中継
    新type=4(c)・Processing役割自動判定と画面遷移(d) を設計。計画書Phase 4Aの
    targetBpmQ8(2B)はカーソルの空きが無いためtargetBpm(1B)へ簡素化しmaster確認事項に明記。
    同期経路(BEAT/NOTE/CTRL 20B)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
2026-06-02 [追加] 塩澤の作業ログ第2回（test_v3 ゲームモード・進捗ガントチャート） (#23)
    先週（test_v1 パケロス対応中）からの 1 週間ぶんを，先週と同じ作業ログ
    テンプレートで作成（work/shiozawa/work-0601/作業ログ0601/）。今週の主作業は
    test_v2 の低遅延化・堅牢化（PR #21）と test_v3 ゲームモード firmware の
    新規実装（PR #22）。
    新たに「進捗ガントチャート（計画と現在地）」節を追加。チームの
    meetings/ガントチャーver1ト.xlsx のフェーズ区分（110/120/200/300/400）に
    現在の進み具合を重ね，今週（5/27 週）を「今」として強調。完了／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
2026-06-02 [改善] 作業ログ0601 を「コード実装済・実機テストはこれから」方針に書き直し (#24)
    今週はコードの実装まで（コンパイル確認まで）で実機テストは未実施、という
    実態に合わせて文言を調整。
    - 進捗サマリー: 「達成」→「コード実装完了（実機テストはこれから）」、全体状況の注記追加
    - 進捗ガントチャート: 200 実装の各バーは「コードの実装」まで、実機テストは 300 で実施する旨を注記
    - 作業ログ表: 状態を「完了」→「実装完了（コンパイルまで）」、最終行を「実機テスト・これから」に
    - 課題管理: パケ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
2026-06-07 [機能追加] test_v3 Processing UI刷新・マスターリセット検知・8分音符対応
    Processing: 梅澤UIスタイル適用（淡い青背景+装飾円+グリッド、白パネル+影+
    青枠、モードボタン、ポート行のグリーン/ブルー配色、下部ヘルプパネル）、
    ウィンドウ 1000×560。マスターESP32リセット検知（UIパケット5秒タイムアウトで
    ST_IDLEに戻し待機画面に遷移、復帰時は自動追従）。
    score_data: フレーズ3/6を8分音符対応（subNote/subOffsetQ8=128でドドレレミミ
    ファファ+ドードー）。3ノードとも pio run SUCCESS。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
2026-06-07 [改善] test_v3 楽譜修正・メニュー横配置・指揮棒軌跡アニメーション
    - 楽譜フレーズ3/6: 上昇パターン(ドレミファ)→全C4に修正（正しいかえるのうたの旋律）
    - メニュー画面: 縦並び→横並びに変更（IMU左右振りと直感的に対応）
    - 指揮棒軌跡: BPMベースの振り子アニメーションを全画面に重ねて描画（NOTE受信時パルス）
    [orchestra_resynth.pde, score_data.cpp]
2026-06-08 [改善] test_v3 マスターリセット復帰高速化・2D IMUグラフ・8分音符修正
    - UI_TIMEOUT_MS 5000→2000ms + onScreenChange にゲーム状態リセット追加
    - OrcSenderModule: Conducting時に navCursor/score を IMU加速度 int8 で上書き
    - Processing: drawBatonTrail を 2D XY プロット (80フレームリングバッファ) に全面書き直し
    - score_data.cpp: 8分音符 durationQ8/subDurationQ8 120→128 (0.03拍ギャップ解消)
    - 全5ノード pio run SUCCESS、node_01_devkitc にもコピー同期
    [orchestra_resynth.pde, score_data.cpp]
2026-06-08 [修正] test_v3 かえるのうた旋律修正(24拍→32拍4フレーズ)・モーション表示をジャイロに変更
    問題A: dynAcc(重力混入)→gyro(角速度÷8)に変更、UI中継30Hz化、バッファ120点
    問題B: フレーズ3/4が全C4で間違い→グワッ×4(休符付き)+ドドレレミミファファミレドーに修正
    GAME_LENGTH_BEATS 24→32、NOTEデバッグprintln追加
    [ProjectConfig.h, applyPattern.cpp, orchestra_resynth.pde, score_data.cpp]
2026-06-09 [追加] 作業ログ0609（test_v3 Processing UI刷新・旋律修正・ジャイロ化の2週間分）
2026-06-10 [改善] test_v3 品質向上 — 状態遷移/同期/Processing UI の徹底デバッグと改善 (#25)
    [processing_log_20260607_211402.csv, processing_log_20260607_211425.csv, processing_log_20260607_223530.csv]
2026-06-10 [追加] test_v3に楽譜と音色データを追加
2026-06-10 [整理] test_v3の音色データ配置を修正
2026-06-10 [修正] test_v3 ジャイロ2D表示を削除（値が不正のため機能ごと除去）
    Processing の角速度プロット（蓄積バッファ・描画・画面遷移クリア）と
    OrcSender の Conducting 時ジャイロ透過を削除し、navCursor/score を常に
    本来のメニュー値/得点に戻す。プロトコル・README・api.md も追従。
    [ProjectConfig.h, orchestra_resynth.pde]
2026-06-10 [改善] test_v3 メニューナビを重力基準の縦/横判定に改善
    センサ軸直読み (NAV_LR_AXIS/UD_AXIS) は取り付け角度で破綻するため、
    遅い LPF で重力ベクトルを推定 (振り中は凍結) し、振り加速度を重力軸/
    水平面成分に分解して判定窓内で積算する方式へ変更。閾値・判定窓・
    優勢比・LR 符号は ProjectConfig で実機調整可能。devkitc 同期済み。
2026-06-10 [機能追加] test_v3 状態遷移直後のジェスチャ/拍検出デッドタイム
    メニュー決定の縦振りが演奏 1 拍目に、最後の音符の振りが Result の
    縦振り操作に誤検出される実害への対策。遷移検知で拍/ナビ両ゲートを
    破棄し、STATE_TRANSITION_DEADTIME_MS (1000ms・ProjectConfig で調整可)
    の間は拍検出とナビを無視する。devkitc 同期済み。
2026-06-10 [機能追加] test_v3 4台輪唱（node_05 新設・輪唱サイクル終端処理）
    新楽器音 4 種に合わせ node_05 (partId=0x05/headRest=24/チューバ) を
    node_04 から複製新設。楽譜進行を CANON_CYCLE_BEATS=56 拍 (曲長 32+
    最終声部遅延 24) のサイクル窓方式に変更し、最終声部が 1 周を終える
    まで先頭声部が次周回を始めない終端を保証 (旧 %kScoreLength は各声部
    が勝手に周回)。Processing は 4 声部表示に拡張。ドラム系音色 (4-7) は
    未使用。README/api.md の台数・曲名・パスの古い記述も実態へ同期。
2026-06-10 [ドキュメント] 作業メモ更新（test_v3 修正5タスク完了）
2026-06-10 第7回議事録追加
2026-06-10 [追加] test_v3 輪唱ロジックの机上検証スクリプト（tools/canon_sim）
    実機テストで node_03/04 が輪唱に聞こえなかった件の机上検証。applyPattern の
    サイクル窓方式を Python で再現し拍 1〜120 の発音表 + 20 アサーションで全 PASS
    （ファームのロジックは正しい）。旧方式・test_v2 残留の比較表も生成する。
2026-06-10 [ドキュメント] 作業メモ更新（輪唱机上検証の結果と実機切り分け手順）
2026-06-16 作業ログとMOP検証の検討
2026-06-16 [追加] 作業ログ0616（test_v3 品質向上・4台輪唱・机上検証・KiCad回路図）
2026-06-16 [修正] 作業ログ0616 詳細トラッキングに進捗列を追加
2026-06-17 音色最新版
2026-06-17 [改善] NAV_VERT_DOMINANCE を 1.00→0.55 に変更（縦/横判定の閾値実験）
2026-06-17 [改善] メニューナビのデバッグログに重力/横ベクトル/dom/dir/カーソル遷移を追加
2026-06-17 [追加] 指揮棒バトンの KiCad 回路図（hardware/baton/）
    [baton.kicad_pcb, baton.kicad_sch]
2026-06-17 [修正] 横振り2回目以降が検出されないバグを修正
    発火済みArmedセッション中に新しい振り（dynNorm > 閾値）を検出した場合、
    セッションをリセットして再検出可能にする。LPFの尾引きでrelease判定が
    遅れ、2回目以降の振りが旧セッションに吸い込まれる問題を解消。
    [applyPattern.cpp]
2026-06-17 第8回議事録追加
2026-06-17 [追加] カエル楽譜デバッグ素材を追加
2026-06-22 [追加] week9の4声輪唱Processingスケッチを追加
2026-06-22 [記録] week9のmain統合を作業履歴へ反映
2026-06-23 [設定] .gitignore から削除済み講義資料の例外を除去、再混入防止ルールを追加
2026-06-23 [追加] 作業ログ0623（回路実作成・マイコン破損・リポジトリ公開化）
    回路写真2枚（表面・裏面）を fig/ に添付
2026-06-23 [修正] 作業ログ0623 課題管理表を最新状態に更新
    マイコン破損・輪唱不聴・パケロスの3件を解決済みに変更し、
    身に覚えのないSW進捗停滞の項目を削除。
2026-06-23 [修正] week9のドラム再解析音色を適用
2026-06-23 変更前のやつ
2026-06-24 [ドキュメント] Git同期の復旧履歴を記録
2026-06-24 [ドキュメント] Git統合の完了を記録
2026-06-24 [機能追加] 本番プログラム production フォルダ新設 (#26)
    * [改善] 楽譜のベロシティをフレーズ別ダイナミクスに更新（齋藤版 week9 準拠）
    フレーズ1=96, フレーズ2=92, フレーズ3=90, フレーズ4=96, 終止音=100 に変更。
    durationQ8 は既存の 240/480/128 を維持（スタッカート感の設計意図を尊重）。
    node_02〜05 の score_data.cpp を統一。
    * [改善] ドラム音色 JSON を齋藤版 week9 に更新（snare 微修正・crash に drum_sample 追加）
    snare: 2バイトの差分を反映。
    crash: 齋藤版の drum_sample 付きデータ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
    [ProjectConfig.h, SystemData.h, applyPattern.cpp, main.cpp, orchestra_resynth.pde, score_data.cpp, score_data.h]
2026-06-24 [修正] production Processing: オクターブ移調と音揺れを齋藤版に準拠して修正 (#27)
    齋藤版 kaeru_score_debug.pde との差異を解消:
    - instrumentId に応じたオクターブ移調を追加 (+12/0/-12/-24)
    - useSimpleADSR=true に変更し per-harmonic エンベロープ・ノイズ・ビブラート・トレモロをスキップ
    - パート別振幅を齋藤版と同値 (0.20/0.17/0.18/0.15) に設定
    - releaseMatching もシフト後の MIDI ノートで照合
    [orchestra_resynth.pde]
2026-06-24 [改善] 本番版チューバの音量と音域を調整
2026-06-24 [修正] production Processing: ドラム合成周波数修正・Pキー削除・チューバ音域/音量調整 (#28)
    - ドラム合成でMIDIノート番号(GM識別子)から周波数計算していたのをJSONのfundamentalHzに修正
    - Pキー音色切替機能と関連変数(forceSingleInstrument等)を削除
    - チューバのオクターブ移調を-24(C2)→-12(C3)、振幅を0.15→0.25に変更
    [orchestra_resynth.pde]
2026-06-24 [追加] 齋藤の発表用個人担当まとめPDFを作成
2026-06-24 [修正] production Processing: ドラム再生を齋藤版と同一方式に移植 (#29)
    齋藤版 kaeru_score_debug.pde のドラム再生方式を production にそのまま移植。
    - ドラム JSON を齋藤版に差し替え（kick/snare/hi-hat に drum_sample 原音データを追加）
    - DrumTimbreData: ドラム JSON 読み込みクラス（齋藤版 TimbreData と同一）
    - RecordedDrumNote: drum_sample 原音を AudioSample.trigger() で再生（優先パス）
    - DrumNote: Oscil 倍音 + Noise + ADSR による合成ドラム（フォールバック）
    - triggerDrumNote(): instrumentId >= 4 のとき ResynthVoice を使わず上記で発音
    - 金管楽器（instrumentId 0-3）の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
    [orchestra_resynth.pde]
2026-06-24 Revert "[追加] 齋藤の発表用個人担当まとめPDFを作成"
    This reverts commit c8d82c7bfc57c73c1e2be2dee21e7d13524e254f.
2026-06-24 振り検出緩和・ドラムバッファ修正・ゲームモード修正を統合 (#30)
    * [改善] production ゲームモードの縦振り・横振り判定パラメータを緩和
    NAV_SWING_THRESHOLD_G 1.00→0.60, NAV_RELEASE_G 0.30→0.20,
    NAV_REFRACTORY_MS 400→250, NAV_DECISION_WINDOW_MS 250→150,
    NAV_GRAV_FREEZE_G 0.30→0.20, STATE_TRANSITION_DEADTIME_MS 1000→600。
    node_01/node_01_devkitc 両方に適用。
    * [修正] production ドラム AudioSample のバッファを 1024→512 に統一
    低遅延化で AudioOutput を 512 に下げた際に AudioSample 側を
    据え置いたため、金管(12ms)とドラム(23ms)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
    [ProjectConfig.h, applyPattern.cpp, orchestra_resynth.pde]
2026-06-24 実機テスト後の4点修正: ナビ・ドラム・Fallback・感度 (#31)
    * [修正] ナビゲート発火後の強制 Idle 復帰で横振り2回目以降の検知を修正
    発火済み Armed セッションで不応期を越えた場合、release 条件
    (dynNorm < NAV_RELEASE_G) を待たず強制的に Idle へ戻す。
    dynNorm が NAV_RELEASE_G と NAV_SWING_THRESHOLD_G の間に留まって
    Armed から抜けられなくなる問題を解消。node_01/node_01_devkitc 両方。
    * [修正] ドラム楽譜を頭打ちキック＋節目クラッシュのシンプルパターンに簡素化
    裏拍ハイハットや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
    [ProjectConfig.h, applyPattern.cpp, score_data.cpp]
2026-06-24 [ドキュメント] 作業履歴を更新（実機テスト後4点修正の記録）
2026-06-24 [改善] 本番版のドラム拍子と全楽器音量を調整
2026-06-25 [修正・改善] production バグ修正19件＋リファクタ＋通信改善 (#32)
    * [修正] 楽器ノードのNOTEドロップ2件を修正（ビートバッファリング＋細分音符スロット分離）
    1. pollReceive: 異なるbeatNoが同一サイクルに到着時deferredBeatに退避→次サイクルで昇格
    2. firePendingSub: 細分音符出力先をnoteOutSub専用スロットに分離し衝突を解消
    3. NoteSenderModule: noteOutSubスロットも送信し1反復で最大2パケット対応
    全7ノード pio run SUCCESS
    * [リファクタ] production コードのコメント・ログプレフィッ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
    [ProjectConfig.h, SystemData.h, applyPattern.cpp, main.cpp, orchestra_resynth.pde, score_data.cpp, score_data.h]
2026-06-25 [機能追加] マルチArduinoテストダッシュボード＋Processing共通ライブラリ (#33)
    * [機能追加] Processing 共通ライブラリ pc_app/common/ を新設
    production 版から共通部分を8つの .pde タブファイルに分離:
    OrcProtocol/InstrModel/SynthVoice/DrumEngine/AudioManager/
    SerialCore/SharedUI/OrcLogger。各スケッチから symlink で参照し
    片方の修正が両方に反映される設計。
    * [リファクタ] production 版を共通ライブラリ参照に移行
    pc_app/common/ の8タブを symlink で参照し、orchestra_resynth.pde を
    1494行→614行に削減（-880行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
    [AudioManager.pde, DrumEngine.pde, InstrModel.pde, OrcLogger.pde, OrcProtocol.pde, SerialCore.pde, SharedUI.pde, SynthVoice.pde]
2026-06-25 [機能追加] MOE/MOP 全9項目の検証プログラムを新規作成
    tools/verification/ 配下に検証ツール一式を追加:
    - serial_logger.py: 複数シリアルポート同時ログ収集
    - analyze.py: 全9項目の PASS/FAIL 判定（拍検出・楽譜突合・同期誤差・通信遅延・テンポ追従・起動時間・CPU負荷・パケットロス）
    - MOP8 用検証ファーム: 3フェーズ micros() 計測の main.cpp ドロップイン版
    - MOP2（音階誤差）は手動テスト手順として README に記載
    [analyze.py, main_conductor_perf.cpp, main_instrument_perf.cpp, serial_logger.py]
2026-06-26 [修正] production説明の音量とドラム譜記述を整理
2026-06-27 [追加] mainに齋藤week10修正版スケッチを反映
2026-06-28 [改善] test_multi 指揮者パネルを production 版ゲーム UI に変更
    テキスト表示だった指揮者パネルをフル幅に拡大し、production 版と同じ
    グラフィカルな画面描画（メニュー選択・自由演奏・ゲーム演奏・結果）に
    置き換え。メトロノームクリック・ガイド強度フェードも同期。
    楽器ノードパネルは 5 台横一列に再配置（描画ロジックは不変）。
2026-06-30 [ドキュメント] 塩澤 作業ログ第5回（0630）を追加
2026-06-30 [ドキュメント] 作業ログ0630: 筐体画像添付＋ガントチャート修正
2026-06-30 [改善] production ドラム楽譜を齋藤版 week10 の4/4パターンに更新
    齋藤版 createDrumScore() を忠実に反映。キック/スネア交互の4/4拍子、
    声部入り(0/8/16/24)と最終拍にクラッシュ+キック同時打ち。
2026-06-30 [ドキュメント] 発表日を 7/1 → 7/8 に延期（台風による休講）
    AGENTS.md、docs/、作業ログ全5回、WBS 関連を一括更新。
    振り返り週も 7/8 → 7/15 にシフト。
2026-06-30 [ドキュメント] 作業ログ全5回＋WBS の PDF を再コンパイル（発表日 7/8 反映）
2026-07-01 [ドキュメント] docsサイトを本番構成に再編
2026-07-01 [ドキュメント] docs更新の作業履歴を記録
2026-07-01 [ドキュメント] main反映後の作業文脈を更新
2026-07-01 [修正] SoftAP max_connection を 6 に設定
    ESP32 のデフォルト上限 4 では楽器 5 台目が接続拒否されていた。
    第5引数 max_connection=6（楽器5台+予備1）で解消。
2026-07-01 [機能追加] MOP検証結果ディレクトリ構造と evaluation.md テンプレを作成
    tools/verification/results/mop{1,3-9}/ に evaluation.md テンプレと
    .gitkeep を配置。CSV/summary は .gitignore で除外し evaluation.md のみ追跡。
2026-07-01 [機能追加] MOP検証 common.py と mop1_beat_detect.py を追加
    common.py: シリアルポート自動検出、[N1 等のプレフィックスからノード名を
    自動判定する NodeMapper、CSV/summary 書き出しヘルパーを提供。
    mop1_beat_detect.py: MOP_TEST=1 フォーマットと従来 SERIAL_DEBUG ログの
    両方に対応した拍検出率計測スクリプト。
2026-07-01 [機能追加] MOP3-9 の個別検証 Python スクリプトを追加
    mop3_score_verify.py: 楽譜一致検証
    mop4_sync_error.py: 楽器間同期誤差 (ahead 値ベース)
    mop5_comm_delay.py: 通信遅延 (ahead 値から推定)
    mop6_tempo_track.py: テンポ追従遅延
    mop7_startup.py: 起動時間
    mop8_cpu_load.py: CPU 負荷
    mop9_packet_loss.py: パケットロス耐性
    全スクリプトが MOP_TEST フォーマットと従来 SERIAL_DEBUG ログの両方に対応。
    共通の NodeMapper でポート→ノード名を自動判定して表示。
2026-07-01 [機能追加] MOP_TEST コンパイルフラグでMOP別シリアル出力を追加
    MopTest.h: MOP_TEST=N でコンパクトな計測データを出力する共通ヘッダ。
    MOP_TEST=0 (既定) では従来の SERIAL_DEBUG 挙動を維持。
    共通ライブラリ:
    - OrcReceiverModule: MOP4(同期誤差)/MOP5(通信遅延)/MOP6(テンポ追従)/MOP9(パケロス)
    - NoteSenderModule: MOP3(楽譜一致)
    各ノード main.cpp:
    - node_01/01_devkitc: MOP1(拍検出)/MOP5C(送信時刻)/MOP7(起動)/MOP8(CPU負荷)
    - node_02〜06: MOP7(起動マイルストーン BOOT/INIT/WIFI/READY)
    全7ノード pio run SUCCESS 確認済み。
2026-07-01 [改善] MOP1 検証スクリプトの品質改善
    - 検出率を実測区間ベースに変更（振り始めラグの過小評価を排除）
    - 検出率 > 110% で偽検出警告、短間隔カウントで定量的検出
    - 0〜1 拍でも FAIL summary を記録、BPM 未指定時は「判定なし」
    - evaluation.md に検証方法の妥当性評価と推奨テスト手順を記載
    [common.py, mop1_beat_detect.py]
2026-07-01 [改善] MOP8 検証スクリプトの品質改善
    Python 側:
    - p99 パーセンタイル統計を全フェーズに追加
    - ウォームアップ期間（先頭 20 サンプル）のスキップ処理を追加
    - 3 フェーズ合計 ≤ 5ms の副次チェック（WARNING 表示）を追加
    evaluation.md:
    - 検証方法の妥当性評価を記載（計測精度・observer effect・帯域・ラップアラウンド）
    - 既知の制約と根拠を文書化
2026-07-01 [改善] MOP5 検証スクリプトの品質改善
    - 閾値を MOP 定義に合わせ 30ms → 10ms に修正
    - ノードごと・全体の p95 統計を追加
    - evaluation.md に ahead ベース計測原理と方法論の限界を記述
    [mop5_comm_delay.py]
2026-07-01 [改善] MOP4 検証スクリプトの品質改善
    - docstring に計測原理を明記（localMasterMs の意味と計算根拠）
    - 変数名を localMs → localMasterMs、CSV列を playAtMs → playAtMasterMs に統一
    - パーセンタイル統計（p50/p95/p99）とノード別偏差分析を追加
    - エッジケースメッセージ改善（headRestBeats固定値削除、検出ノード数表示）
    - evaluation.md に検証方法の妥当性評価（計測原理・既知の制約・結論）を記載
2026-07-01 [改善] MOP3 検証スクリプトの品質改善
    サブノート未捕捉・バイナリ混在・NOTE_SUB未対応の3件を修正:
    - NoteSenderModule のサブスロットに M3 出力を追加 (4音/周の検証漏れ解消)
    - MOP_TEST>0 時に SERIAL_DEBUG/buildAndSend を抑制するガード追加
    - Python RE_NOTE_DBG を NOTE_(?:ON|SUB) に拡張、期待楽譜を25→29音に修正
    [mop3_score_verify.py]
2026-07-01 [改善] MOP9 検証スクリプトの品質改善
    - beatNoリセット（指揮者再起動）時の区間分割対応
    - 最大連続欠落数の算出を追加
    - 変数名seq→beat_nosの修正（実態はbeatNoリスト）
    - PASS/FAIL判定をMOP定義（5%テスト条件）と整合
    - evaluation.mdに検証方法の妥当性評価を記載
    [mop9_packet_loss.py]
2026-07-01 [改善] MOP7 検証スクリプトの品質改善
    ファーム:
    - 指揮者の READY 条件を beatNo>0（ユーザー操作要）から
    Calibrating完了→Conducting/Menu遷移（純粋な起動時間）に修正
    - 楽器ノード node_02〜06 に SYNC マイルストーン（時刻同期完了）を追加
    - node_03〜06 の先行セッションで入っていた MOP6 改善も含む
    Python:
    - device_ms（デバイス内 millis()）を優先して起動時間を算出するよう改善
    - docstring をファーム出力仕様と整合
    - 検証方法の妥当性評価を記載（精度・制約・READY 定義の根拠）
    全7ノード pio run SUCCESS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
    [main.cpp, mop7_startup.py]
2026-07-01 [改善] MOP6 検証スクリプトの品質改善
    - OrcReceiverModule.cpp の M6 出力を除去（main.cpp 側と二重出力だった）
    - Python: M6 フォーマットのパースを追加（RE_MOP6 が未使用だった）
    - Python: 楽器が追従しなかったケースを FAIL として報告
    - Python: テスト手順の具体的表示を追加
    - evaluation.md に検証方法の妥当性を記載
    [mop6_tempo_track.py]
2026-07-02 [改善] MOP7 計測スクリプトを pio upload 方式に改修
    - 全6ノードを1台ずつ pio upload → シリアル読み取りの順で処理
    - 指揮者を最初に書き込み、楽器は順番に処理
    - CSV/summary/raw log を自動生成
    - 楽器は SYNC まで計測（READY は --with-beat で有効化）
    - 指揮者の MOP_TEST を 1→7 に変更（M7 マーカー出力用）
2026-07-02 [ドキュメント] MOP検証結果記録（2026-07-02 全8項目実機テスト）
2026-07-07 [改善] チューバ・トロンボーンの音源をフルート・オルガンに差し替え
    トロンボーン(index 2)→フルート、チューバ(index 3)→オルガンに置換。
    音源は saitou-work ブランチの齋藤版 tweaked JSON を使用。
    フルートのオクターブシフトを -12→0(C4)に変更。
2026-07-07 [修正] 本番用Processingの画面が描画されない問題を修正
    macOS で Serial.list() が StringIndexOutOfBoundsException を投げ
    setup() が中断、draw() が実行されずグレー画面になっていた。
    try-catch で保護し空配列にフォールバックする。
    [SerialCore.pde]
2026-07-07 [修正] Processing のシリアルポート検出が動作しない問題を修正
    macOS で Serial.list() が JSSC 内部で StringIndexOutOfBoundsException を
    投げると空配列にフォールバックし、ポートが一切表示されなかった。
    例外時は /dev/cu.* を直接列挙するフォールバックを追加。
    [SerialCore.pde]
2026-07-07 [修正] 横振りによるゲームモード選択が2回目以降動作しない問題を修正
    2項目メニューでの横振りカーソル移動を方向依存→トグルに変更し、
    再アームによる不応期延長を sNavNeedsRelease フラグで防止。
    [applyPattern.cpp]
2026-07-07 [改善] フルートを1オクターブ上げてC5に変更
    brassOctaveShift の case 2 を 0 → +12 に変更。
    フルートらしい音域にするための移調。
2026-07-07 [改善] 音色のADSR・倍音エンベロープ・エフェクトを改善
    評価基準（楽器らしい音色・倍音構造・ADSR制御・エフェクト付与）に対応:
    - トランペット: attack 0.33→0.02s（鋭い金管アタック）、release 1.0→0.15s、
    ビブラート追加（5cent, onset 0.5s）
    - ホルン: attack 0.405→0.08s、release 1.0→0.3s
    - フルート: ビブラート depth 9→20cent（豊かな揺れ）、onset 0.2→0.35s、
    ブレスノイズ 0.0028→0.022（息の音を聞こえるレベルに）
    - オルガン: トレモロ追加（rate=6Hz, depth=0.06 トレムラント効果）
    - useSimpleADSR を false に変更し、ビブラート・ト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
2026-07-08 [改善] 齋藤week10スケッチにフルート・オルガン音色を反映
2026-07-08 [改善] PCアプリ production のマスター音量を 0.55→0.85 に引き上げ、調整上限を 2.0 に拡張
2026-07-08 [改善] PCアプリ production のデフォルト音量を 2.0 に引き上げ、最大音量を 4.0 に拡張
2026-07-08 [改善] オルガンの楽器別振幅を 0.25→0.50 に倍増
2026-07-08 成果発表会リンク
2026-07-09 [改善] MOP4/MOP5 計測を NOTE_ON ベースに改修、グラフ生成スクリプト追加
    - MOP4/MOP5: EVT BEAT + ahead ベースから NOTE_ON PC タイムスタンプベースに変更
    - mop_graphs.py: 全 MOP の計測結果を PNG グラフ化（目標値ライン・PASS/FAIL 表示）
    - requirements.txt: matplotlib, numpy を追加
    - .gitignore: .venv/ を除外
    - README.md: グラフ生成手順を追記
    [mop4_sync_error.py, mop5_comm_delay.py, mop_graphs.py]
2026-07-09 [ドキュメント] MOP検証レポート 7/9（MOP3/9再検証、MOP4/5考察）
2026-07-10 [ドキュメント] MOP4/MOP5 通信遅延の調査レポートを追加
    - Codex 指摘 5 件を全件検算（CSV 再集計 2586.3ms、M5I 二重記録、発火差推定 p50=8ms を再現確認）
    - 7/9 レポート公表値の出所を EVT BEAT ahead レンジ/ペア差と完全特定（記載の NOTE_ON 方式・出典 CSV は誤り）
    - beatLookahead=45ms が 53% の拍で不足（lateMs 最大116ms、共通モードジッタで同期は維持）を新たに確認
    - 今後の対応を記述修正/再計測/ハード計測に分類し推奨を提示。コード変更なし
    - .agent/activeContext.md・progress.md を調査結果で更新（Codex の判明事項は統合して維持）
    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
2026-07-10 [改善] MOP4/MOP5 計測を発火時マスター時刻ベース (M45R/M45F) に一本化
    旧 M4/M5I は受信時記録が 2 箇所 (OrcReceiverModule と main.cpp) にあり
    同一拍が二重記録されていた。BEAT 受理時の M45R (OrcReceiverModule) と
    発火時の M45F (applyPattern) の各 1 行に統一し、USB 受信時刻に依存しない
    デバイス側計測にする。MOP_TEST=4/5 は同一出力で 1 回の計測から両方集計可能。
    通常ビルド (MOP_TEST 未定義) はバイナリ一致を md5 で確認済み。
2026-07-10 [改善] MOP4/MOP5 集計を M45 ログ対応に書き直し、再計測手順を README に整備
    MOP4 は M45F の localMasterMs を (beatNo, playAt) キーで突合したノード間
    レンジ、MOP5 は受信/発火の lateMs (lookahead 45ms に対する遅刻) に再定義。
    破綻していたライブ計測 (逐次ブロッキングポーリング) と直前 EVT BEAT 紐付けを
    廃止し serial_logger.py のログ解析専用にする。ダミーログ (欠落・順序入替・
    重複・指揮者リセット) のセルフテストで期待値一致を確認。グラフも新形式対応。
2026-07-10 [ドキュメント] 作業文脈を MOP4/MOP5 再計測待ちの状態に更新
2026-07-10 [ドキュメント] MOP5 系統シフト -42.8ms の原因分析レポートを追加
    根本原因 = SoftAP マルチキャストの 204.8ms 周期バースト配送 (省電力バッファ)。
    シフト自体は EMA の CTRL/BEAT サンプル鮮度非対称の産物で、lateMs は真の遅刻を
    約 45ms 過小評価 (真 p95≈145ms)。コード変更なし・スクリプトにバグなし。
2026-07-10 [改善] BEAT 発音予約 lookahead を 45→220ms へ拡大 (MOP5 対処案1)
    SoftAP マルチキャストの DTIM バーストで BEAT が最大 ~205ms 遅れて届く実測
    (MOP5_systematic_shift_analysis_20260710.md §3) に基づく暫定値。ビーコン間隔
    短縮の効果を実測確認後に 70ms 程度まで短縮可。node_01_devkitc へも同期。
2026-07-10 [改善] 指揮者 SoftAP のビーコン間隔を 50TU へ短縮試行 (MOP5 対処案2)
    esp_wifi_get_config/esp_wifi_set_config で beacon_interval 100→50TU を設定し、
    マルチキャストのバースト配送周期 204.8ms を ~51ms へ縮める狙い。IDF 4.4
    (arduino-esp32 2.0.17) の wifi_ap_config_t に dtim_period が無いため DTIM=1 の
    明示は不可。設定拒否時は既定 100TU のまま従来動作を続ける (AP 起動は成功扱い)。
2026-07-10 [改善] 楽器の時計同期を EMA から min フィルタへ変更 (MOP5 対処案4)
    バースト配送下で EMA が平均遅延を吸い込み推定マスタ時計が真値より 40〜55ms
    遅れる問題 (MOP5_systematic_shift_analysis_20260710.md §4) への対処。窓
    2000ms 内の最大 offset サンプル (= 最小配送遅延) を追従する NTP 系の定石に
    置換。指揮者リセットのスナップ 1 パケット追従は従来どおり維持。
2026-07-10 [ドキュメント] 作業文脈を MOP5 対処実装完了・実機再計測待ちへ更新
2026-07-11 [ドキュメント] MOP5 対策後再計測の評価レポートを追加 (ループストール特定)
    対策 3 件 (35f70f0/6642646/86c39f4) 後の実機ログ 183 拍 × 5 ノードを対策前と
    独自再集計で比較。受信改善 (遅刻率 45.4→1.9%) は lookahead 220ms のみの効果で、
    ビーコン 50TU はバースト周期 204.8ms を縮めず無効と実証。発火 lateMs p95 47ms と
    MOP4 尾 p95 46ms は、バースト到着から位相 ~120〜165ms で楽器ループが回らない
    「周期ストール」(実挙動・全ノード共通) が共通原因。推奨 = 50TU 設定撤去 → 再計測。
2026-07-11 [修正] SoftAP ビーコン 50TU 設定を撤去 (MOP5 対処案2 の取り下げ)
    7/10 の実機再計測で、50TU 設定は ESP_OK 応答にもかかわらずバースト配送周期
    204.8ms を全く縮めず (効果ゼロ)、むしろ楽器ループの周期ストール (発火 lateMs
    p95 47ms・MOP4 尾悪化の共通原因) を誘発した疑いがあるため撤去
    (tools/verification/results/MOP5_countermeasure_eval_20260710.md §2/§3/§5)。
    lookahead 220ms (35f70f0) と時計同期 min フィルタ (86c39f4) は維持。
    通常 + MOP_TEST=4 の両ビルドで production 全 7 ノード pio run SUCCESS。
2026-07-11 [改善] MOP_TEST 4/5 にループストール検出ログ M45S を追加
    50TU 撤去後の再計測 (test_20260711_153711.log) でも発火位相 ~120〜165ms の
    空白帯が同一に残り、周期ストールは 50TU 起因でなく既存問題と確定。粒度
    (単一の長ブロックか短いブロックの連なりか) と正確な窓位置を実測するため、
    OrcReceiverModule::updateInput 冒頭にハートビートを追加: loop 1 周が 10ms を
    超えたら M45S,<partId>,<deviceMs>,<gapMs> を 1 行出力 (MOP_TEST=4/5 限定、
    通常ビルドは #if 隔離でバイナリ一致を md5 確認)。集計は新設の
    mop5_loop_stall.py (gap 分布・バースト位相・発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
2026-07-11 [ドキュメント] 最終 MOP 検証レポートを作成 (MOP4/5 を 3 回実測で総括)
    MOP4/MOP5 を 7/10-11 の 3 回実測 (対策前/対策後/ビーコン設定撤去後、延べ 560 拍
    × 5 ノード) で更新し、他 MOP は 7/9 レポートの値を引き継いだ。MOP4 は実質達成・
    受け入れ (p50 7ms=目標の 1/3、尾 p95 48.6ms は周期ストール由来 9.2% の単発、
    最大値判定という統計量設計の反省を記載)。MOP5 は初期の指標設定ミス (スコープ
    ミス) と総括: 予約発音アーキに対し「生の片道遅延 ≤30ms」はバースト配送 (実測
    204.8ms 周期・802.11 仕様由来) で達成不能かつ計測不能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
2026-07-11 [機能追加] 発声タイミング遅延 (MOP5) のノード別検証グラフを追加
    第三者向けに 1 枚で読める体裁 (合格範囲の緑帯・判定・p95/中央値/最大の
    データラベル・計測条件と出典の注記) を mop_graphs.py に実装。
    数値は results/mop5/20260711_154006 の summary と一致確認済み。
    mop5_comm_delay.png は 7/11 最終 CSV での再生成による更新。
2026-07-11 [機能追加] MOP5 発声遅延グラフのスライド用シンプル版を追加
    発表スライドは口頭解説がある前提のため、説明文・判定ボックス・注記を
    すべて省き、データ・軸・短い凡例のみの 16:9 大フォント版を別 PNG で追加。
    詳細版 (mop5_fire_delay_by_node.png) はそのまま併存。
2026-07-11 [スタイル] MOP5 スライド用グラフを平均値青棒＋最大値赤マーク体裁に変更
    発表スライドの見せ方に合わせ、タイトルを「通信遅延（ノード別）」へ変更し
    p95 棒と中央値◇を廃止。平均値 (青棒) と最大値 (赤マーク) のみを表示する。
    詳細版グラフは無変更 (再生成でバイト一致を確認)。
2026-07-11 [ドキュメント] 作業履歴メモに MOP5 スライドグラフ体裁変更を反映
2026-07-11 [スタイル] MOP5 スライド用グラフにノード別中央値マークを追加
    中央値 5〜8ms は平均の青棒の内側に来るため、白抜き◇＋濃い縁取りで
    埋もれを防ぎ、数値ラベルは棒の右外側に配置。凡例に「中央値」を追加。
2026-07-11 [ドキュメント] 作業履歴メモに MOP5 スライドグラフ中央値マーク追加を反映
2026-07-11 [機能追加] MOP4 同期誤差グラフのスライド用シンプル版を追加
    MOP5 スライド版と同体裁（平均値の青棒・中央値の白抜き◇・最大値の赤マーク・
    合格範囲 20ms の緑帯、16:9・大フォント・説明文なし）。同期誤差は拍ごとの
    ノード間レンジでノード別に分解できないため、x 軸は 3 回の実測（対策前→
    対策後→最終構成）の計測回別とした。
2026-07-11 [ドキュメント] 作業履歴メモに MOP4 スライドグラフ追加を反映
2026-07-11 [スタイル] MOP5 スライド用グラフを「ジッタ吸収なし vs あり」比較に変更
    予約発音による補正効果を見せるため、ノード別表示から
    「受信即発音なら平均 101.2ms / 実測の発火遅れ平均 12.1ms」の 2 グループ比較へ。
    吸収なしは R 行の |localMasterMs − playAtMasterMs|（marginMs 分析と符号反転で同値）。
2026-07-11 [スタイル] MOP4 スライド用グラフを「各拍の最速 vs 最遅の発音時刻差」時系列に変更
    計測回別 3 本棒から、最終構成 (7/11) 全 173 拍の拍ごとレンジ (青棒) へ。
    平均 10.8ms は青破線、中央値 7ms は右外の白抜き◇、最大 65ms は該当拍の赤マークで表示。
2026-07-11 [ドキュメント] 作業履歴メモにスライド用 MOP グラフ 2 枚の再構成を反映
2026-07-11 現行仕様に解説ページを更新
2026-07-11 [機能追加] MOP2 音階誤差の検証プログラムを追加
    Processing の加算合成 (SynthVoice/InstrModel/AudioManager.pde) を Python へ忠実移植し、
    現在の楽器 JSON と発音方法で鳴るはずの波形を合成 → 基音を推定 → 平均律と比較する。
    実音を録音すると A/D や部屋鳴りの癖が混ざり「JSON 由来の音階誤差」を切り出せないため、
    録音経路を挟まない方式にした (実機・Processing とも不要で決定論的に再現できる)。
    結果は全 24 音 (4 楽器 × 6 音) の平均 |誤差| 0.737 cent・最大 1.907 cent で
    基準 3.6 cent に対し PASS。誤差の正体は harmonics[n=1].ratio が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
2026-07-12 [スタイル] MOP2 スライド用グラフを楽器ごと棒 1 本のシンプル構成に変更
    中央値◇・最大値の赤マークは平均とほぼ同値で情報が増えないため削除し、
    「音階誤差」の青棒 + 数値ラベル + 合格範囲の緑帯のみとした。解析ロジックは不変。
2026-07-12 [ドキュメント] 作業履歴メモに MOP2 スライド用グラフの簡素化を反映
2026-07-12 [スタイル] MOP4 スライド用グラフの数値ラベル配置を整理して視認性を改善
    平均・中央値は「統計量名+数値」を線の右端外へ、最大は矢印付きで棒の真上へ移し
    棒群との被りを解消。中央値は右外の◇をやめ濃色点線の水平線に、凡例は 2 項目に整理。
    数値 (平均 10.8 / 中央値 7 / 最大 65 / 173 拍) とデータ集計は不変。
2026-07-12 [ドキュメント] 作業履歴メモに MOP4 スライド用グラフの視認性改善を反映
2026-07-12 [追加] 最終報告書（塩澤）を作成
    教員配布テンプレート (jlreq+uplatex+dvipdfmx) 準拠の個人最終報告書 43 ページ。
    MOP 全 9 項目の実測値、計画時想定との相違点と変更理由、生成 AI の利用と検証過程、
    付録に担当分中核ソース 4 本全文を収録。Docker latexmk でエラー 0・未定義参照 0・
    Overfull 0 を確認し、checklist.pdf 全項目の確認結果を チェックリスト確認.md に記録。
    配布 pckgs.sty / hira-stix.sty はヒラギノ・stix2 依存のためローカルコピーのみ
    原ノ味構成へ差し替え（report/template/ の原本は不変）。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
2026-07-12 [ドキュメント] 最終報告書のルーブリック評価を追加
    採点者視点で全11項目を判定（総合90/100、A×9・B×1）。事実正確性の
    スポットチェック14件（MOP正本・実コード照合）で数値の虚偽0件を確認し、
    唯一の明確な失点（文献[6]の本文未引用）と修正提案8件を優先度順に記録。
    報告書本体（main.tex/main.pdf）は無変更。
2026-07-12 [修正] 最終報告書の文献[6]引用漏れと「金管4声部」用語を修正
    ルーブリック評価の指摘 2 件を反映。§4.4 末尾に許容値 3.6 cent の出典
    \cite{ref:onkai} と由来 1 文を追加、§2.1 と図 1 の「金管」を「声部」へ修正。
    チェックリスト確認.md 2-7 の誤記録も実確認結果へ訂正。
2026-07-12 [ドキュメント] 作業履歴メモに最終報告書のルーブリック指摘修正を反映
2026-07-14 [ドキュメント] 成果発表会 質疑応答チートシートを追加
    presentation/qa-cheatsheet/ に LaTeX 製チートシート（7ページ・34問）を新設。
    WiFi/UDP通信・IMU拍検出・Processing UI・音色合成・ログ取得の5領域を
    実コードの数値・閾値に基づいて「実装要点＋想定Q&A」形式でカバー。
2026-07-14 [ドキュメント] チートシートにJSON楽器定義・音が出るまでの仕組み・音関連Q&A 8問を追記
    - 第6章「JSON楽器定義の仕組み」: ファイル読み込みルール、全体構造表、
    harmonics/envelope/modulation各フィールドの解説、JSON抜粋
    - 第7章「音が出るまでの仕組み（ゼロから解説）」: デジタル音声の基礎、
    加算合成の原理と数式、NOTE→発音→スピーカーの全経路9段階、
    エンベロープ（ADSR）、ボイス管理、C4ウォークスルー
    - 第8章「音の仕組みに関するQ&A」: 加算合成vsサンプリング、レイテンシ、
    音割れ対策、JSON書き換え効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
2026-07-14 [ドキュメント] 最終報告書用の図一式を生成（実測グラフ12枚・説明図5枚・スクリプト・アンケートCSV）
    全面改稿（サンプル報告書準拠の構成・図密度）に向けた図素材。実測グラフは
    tools/verification/results/ の正本CSV・生ログから make_report_graphs.py で再集計して
    生成し、summary・MOP_REPORT_20260711 との一致を確認済み。
    [entertainment_survey_team23.csv]
2026-07-14 [ドキュメント] 個人最終報告書をサンプル報告書準拠の構成・図密度へ全面改稿
    章構成をサンプル（はじめに→システム概要→実装→評価方法と結果→考察→おわりに→
    付録A/B）に組み替え。図22枚（構成図・原理図・フローチャート4枚・計画時ガント・
    回路図・実測グラフ12枚）・表11・数式(1)-(6)。主な変更:
    - MOP5 は「指標再定義」の枠組みを廃し、当初定義（通信遅延≤30ms）で未達と報告、
    原因（DTIMバースト配送）・対策（先読み220ms・minフィルタ）は考察5.1-5.2で論述
    - 評価会エンタメアンケート（43件）の集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
2026-07-14 [ドキュメント] 作業履歴メモに最終報告書の全面改稿を反映
2026-07-15 [ドキュメント] 最終報告書の drawio 図 8 枚を白黒清書・回路図を KiCad 差替・DevKitC 主構成へ整合
    - drawio 図 8 枚（フローチャート 4・状態機械・タイムライン・EMA 構成・システム構成）を
    パステル色塗りから白背景・黒線・標準記法へ全面清書
    - 回路図を draw.io 手書きから KiCad 製 PDF（300 DPI PNG 化）へ差替（旧 hardware.drawio/png 削除）
    - 指揮者ボードを DevKitC-1 主構成へ統一（XIAO は初期使用→アンテナ問題で切替の経緯として記載）
    - 全図表の配置を [tb] から [H] へ変更し言及箇所の直後に配置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
2026-07-15 [ドキュメント] 作業履歴メモに図清書・回路図差替・DevKitC整合を反映
2026-07-15 [修正] 最終報告書の斜め配線2箇所を直交化・回路図trimを調整
    - flow-instrument-fire: 演奏区間? NO→休符 の斜め線を orthogonalEdgeStyle で直交化
    - ema-module: 書く/読む矢印（rw1/rw3）を orthogonalEdgeStyle で直交化
    - KiCad回路図の trim を 10,390,190,10 → 35,245,200,35 へ調整し図を最大化
    - 全8図（reservation-timeline除く）の斜め線ゼロを目視確認済み
2026-07-15 [修正] flow-instrument-fire の NO ラベル衝突を解消
    「NO（次周期で再評価）」を予約時刻ひし形の右出口直近へ，
    「NO」を演奏区間→休符水平線の中央へ移動し2ラベルを分離
2026-07-15 [修正] 最終報告書にユーザー指摘7点を適用
    1. 図1（システム全体構成）WiFi UDPラベル位置を矢印下へ移動し被り解消
    2. 図A.21（指揮者applyPattern）静止計測からの矢印をx=790で迂回させ被り解消
    3. ガントチャートをエクセル原本準拠で全53子タスク・担当者付きに再作成
    4. EMAを参考文献[9]から削除し文中\url化，文献番号[1]-[11]に再連番
    5. §3.4にユニバーサル基板の経緯を追記，部品表を実態に更新，IMU表記を統一
    6. 実機写真2枚をトリミングして図7に掲載（部品面・はんだ面）
    7. §1・§2.3にスコープ明示（テンポ練習目的・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
2026-07-15 [修正] ガントチャートを2分割し判読性を確保
    1枚53行では PDF 上でタスク名・担当者が判読困難だったため，
    設計フェーズ（図6，WBS 110-120）と製造・テストフェーズ（図7，WBS 210-400）の
    2枚に分割し，行高・フォントを約2倍に拡大．
    旧 fig:schedule → fig:schedule-design / fig:schedule-impl に分離．
    65ページ・Overfull 0・undefined 0．
2026-07-15 [リファクタ] 参照が切れた旧ガント図を削除
2026-07-15 [ドキュメント] 最終報告書の3モデル第三者レビューを追加（Opus 4.6 / GPT-5.6 Sol / Gemini 3.1 Pro）
2026-07-15 [修正] 最終報告書に3モデルレビュー指摘を反映し図表配置をチェックリスト追従
    - [H]配置を全figure/tableから除去し[tbp]へ変更（チェックリスト「図表はページ上部/下部に配置」適合）
    - \usepackage{float}を除去
    - ガントチャートを2枚PNG→1枚pgfganttに統合（サンプル報告書の図6踏襲・11行・フェーズ色分け）
    - §1にNMP（Network Music Performance）との差異を1段落追加（Opus H2）
    - SoftAP・IIR・DTIMの初出フルスペル定義を追加（Gemini）
    - 表8 MOP4/MOP5「未達」に考察節への橋渡し注記を追加（Opus H1）
    - MOP4測定範囲をArduino発火イベントに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
2026-07-15 [修正] 参考文献に全件URL追加・EMA用語整理・引用適切性検査
    参考文献URL:
    - 全11件にURLを追加（閲覧日2026-07-15）
    - [1]川合: JSSA直リンクPDF, [3]久松: SFC WIDEリポジトリPDF
    - [4]河瀬: J-STAGE, [7]RFC5905: rfc-editor.org, [8]中村: IPSJオープンアクセス
    - [10]竹内: J-STAGEジャーナルフリー, [11]IEEE 802.11: IEEE Xplore（Get 802で無料公開）
    - 全URLをWebFetchで実際にアクセスし内容一致を確認
    EMA用語整理:
    - Embedded-Module-Architectureの略称「EMA」を廃止し「モジュールアーキテクチャ」に統一
    （指数移動平均EMAとの混同を回避）
    - fig/ema-module → fig/module-arc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
2026-07-15 [修正] リポジトリ内パス記載を全廃
    - MOP1〜9・エンタメ評価の「データは results/... である」文を全件削除（10箇所）
    - 検証環境説明のパス（tools/verification/scripts/・results/）をパスなし表現に書換
    - PlatformIO説明のfirmware/・common/lib/パスを一般表現に書換
    - 付録リストキャプションのフルパスをファイル名のみへ短縮（4箇所）
    - 測定方法・条件・サンプル数・日付の記述は維持
    - grep で results/ tools/ logs/ .csv .py の残存ゼロを確認
    - Docker latexmk EXIT=0・未定義参照0・Overfull 0・62ページ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
2026-07-15 [修正] ガント最終行のWBS番号を計画書体系に修正（400→510-520）
    - ガントバー「発表準備（400）/全員」→「発表準備・報告書（510-520）/全員」
    - キャプション「WBS 110〜400」→「WBS 110〜520」
    - 本文§3.1「発表準備の4フェーズ」→「発表準備（510〜520）の4フェーズ」
    - ストレッチ（410）は載せない判断（期間中に実施せず）
    - Docker latexmk EXIT=0・未定義参照0・Overfull 0・62ページ
2026-07-15 [ドキュメント] 最終チェックレビュー3モデル分を追加（Opus/Sol/Gemini）
2026-07-15 [修正] 最終報告書の評価データ正直性修正（MOP1〜9全項目を正本と突合）
    - MOP3: 7/9空データ(ヘッダのみ)の引用を廃止し7/2実データ(340ノート)で書き直し
    node_03・04完全一致、node_02の24件はWiFiパケロス起因と切り分け
    - MOP4: 測定対象を「楽器ノード内部の予約発火イベント時刻」と明記
    実音同期(USB/PC/D/A)は未測定と1文追加、「鳴るのは同時」表現を除去
    - MOP5: 「通信遅延」→「配送遅延」「相対値」と表現を一貫化
    - MOP9: 計画の5%損失注入試験が未実施であることを本文・表8に明記
    ただし発表会構成での欠落0は達成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
2026-07-15 [修正] ガントチャートをエクセル原本準拠に修正（8週・11タスク・矢印削除）
    - 期間を10週(5/1〜7/8)→8週(5/1〜6/24)に修正、W9・W10を削除
    - エクセル原本に存在しない「ゲーム機能(260)」「発表準備・報告書(510-520)」の2行を削除
    - 意味不明な依存矢印(\ganttlink)を全4本削除
    - エクセル準拠のバー定義: 全体設計/アーキ通信/楽譜基本/音色基本={1}{5}、
    詳細設計={6}{8}、共通層・楽譜・PC={9}{17}、テスト・性能検証={17}{24}、
    ストレッチ=末尾に点線バー
    - 本文§3.1のフェーズ説明を「設計・製造・テスト＋ストレッチ」の3+1構成に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
2026-07-15 [ドキュメント] 付録Aにloop()関数のソースコードを追加
    楽器・指揮者両版のloop()を計測ブロック除去の本番動作抜粋として
    src/main_loop.cppに掲載（リスト3）。§3.1に付録参照を追加。
2026-07-15 [ドキュメント] 最終報告書の表紙日付を提出日(2026-07-16)に更新し提出用PDF(25G1065.pdf)を作成
